DavidWenzler/reAM250/AMCF/Plugins/Resources/login_background.jpg

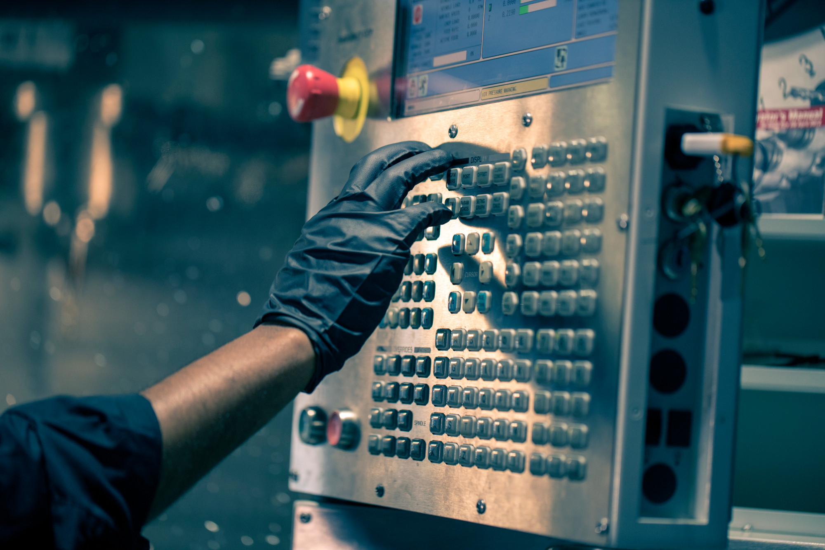
AMCF/Plugins/Resources/login_background.jpg
