DavidWenzler/reAM250/README.md

# reAM250
an open-source research platform for process monitoring and control in powder bed fusion of metals using a laser beam

View and download the CAD files here: [v1.1.0] (https://a360.co/3FBa549).
