DavidWenzler/reAM250/docs/reAm250_IO_overview_de_v1_0_0.pdf

Modul | Klemme | Bez. | Adresse | Funktion | Modul | Klemme | Bez. | Adresse | Funktion | Modul | Klemme | Bez. | Adresse | Funktion
11 | TC1+ | Temperatur 1 | 11 | DI 1 | Z-Achse Endlage (-) unten | 11 | DO 1 | Türzuhaltung Entriegeln
12 | TC1- | " | 21 | DI 2 | Z-Achse Endlage (+) oben | 21 | DO 2 | Ampel ROT
21 | TC2+ | Temperatur 2 | 12 | DI 3 | Beschichter Endlage (-) | 12 | DO 3 | Ampel GELB
22 | TC2- | " | 22 | DI 4 | Beschichter Endlage (+) | 22 | DO 4 | Ampel GRÜN
13 | TC3+ | Temperatur 3 | 13 | DI 5 | Beschichter Ref. (Home) | 13 | DO 5 | Siganl an SP-ICE3 (nicht verwendet)
14 | TC3- | " | 23 | DI 6 | Beschichter Ref. (max.) | 23 | DO 6 | O2 -Messbereich
23 | TC4+ | Temperatur 4 | 14 | +24V DC | | 14 | GND
24 | TC4- | " | 24 | +24V DC | | 24 | GND
15 | TC5+ | Temperatur 5 | 15 | +24V DC | | 15 | GND
16 | TC5- | " | 25 | +24V DC | | 25 | GND
25 | TC6+ | Temperatur 6 | 16 | +24V DC | | 16 | GND
26 | TC6- | " | 26 | +24V DC | | 26 | GND
11 | AO1 I+ | | 11 | DI 1 | Meldung Ventil Schutzgas Kammer AUF | 11 | DO 1 | Ventil Schutzgas Kammer
12 | AO1 U+ | Umwälzpumpe Gasführung SOLL 0-100% (0-10V) | 21 | DI 2 | Meldung Ventil Schutzgas Kammer ZU | 21 | DO 2 | Ventil Schutzgas Wärmetauscher
13 | AO1 I-/U- | " | 12 | DI 3 | Meldung Ventil Schutzgas Wärmetauscher AUF | 12 | DO 3 | Ventil Schutzgas Hauptventil
21 | AO2 I+ | Analogausgang 2 (0(4)-20mA) | 22 | DI 4 | Meldung Ventil Schutzgas Wärmetauscher ZU | 22 | DO 4 | Ventil Vakuum Kammer
22 | AO2 U+ | Analogausgang 2 (0-10V) | 13 | DI 5 | Reserve | 13 | DO 5 | Ventil Vakuumk Z-Achse
23 | AO2 I-/U- | " | 23 | DI 6 | " | 23 | DO 6 | Reserve Gasführung Ventil 6
14 | AO3 I+ | | 14 | +24V DC | | 14 | GND
15 | AO3 U+ | | 24 | +24V DC | | 24 | GND
16 | AO3 I-/U- | | 15 | +24V DC | | 15 | GND
24 | AO4 I+ | | 25 | +24V DC | | 25 | GND
25 | AO4 U+ | | 16 | +24V DC | | 16 | GND
26 | AO4 I-/U- | | 26 | +24V DC | | 26 | GND
11 | AO1 I+ | Analogausgang 1 (0(4)-20mA) | 11 | DI 1 | Signal von SP-ICE3 (nicht verwendet) | 11 | DO 1 | Reserve Gasführung Ventil 7
12 | AO1 U+ | Analogausgang 1 (0-10V) | 21 | DI 2 | Umwälzpumpe Gasführung FU Betrieb | 21 | DO 2 | Reserve Gasführung Ventil 8
13 | AO1 I-/U- | " | 12 | DI 3 | Umwälzpumpe Gasführung FU Fehler | 12 | DO 3 | Reserve Gasführung Ventil 9
21 | AO2 I+ | Analogausgang 2 (0(4)-20mA) | 22 | DI 4 | Vakuumpumpe Betrieb | 22 | DO 4 | Reserve Gasführung Ventil 10
22 | AO2 U+ | Analogausgang 1 (0-10V) | 13 | DI 5 | Vakuumpumpe Störung | 13 | DO 5 | Reserve Gasführung Ventil 11
23 | AO2 I-/U- | " | 23 | DI 6 | Bauplattformheizung Störung | 23 | DO 6 | Reserve Gasführung Ventil 12
14 | AO3 I+ | | 14 | +24V DC | | 14 | GND
15 | AO3 U+ | | 24 | +24V DC | | 24 | GND
16 | AO3 I-/U- | | 15 | +24V DC | | 15 | GND
24 | AO4 I+ | | 25 | +24V DC | | 25 | GND
25 | AO4 U+ | | 16 | +24V DC | | 16 | GND
26 | AO4 I-/U- | | 26 | +24V DC | | 26 | GND
11 | AI1 I+ | O² Messung Filter (4-20mA) | 11 | DI 1 | Vakuummessung Grenzwert | 11 | DO 1 | Reserve Gasführung Ventil 13
12 | AI1 U+ | | 21 | DI 2 | Vakuummessung Störung | 21 | DO 2 | Reserve Gasführung Ventil 14
13 | AI1 I-/U- | " | 12 | DI 3 | Fremdlüfter Umwelzpumpe Störung | 12 | DO 3 | Reserve Gasführung Ventil 15
21 | AI2 I+ | O² Messung Bauraum (4-20mA) | 22 | DI 4 | Reserve | 22 | DO 4 | Reserve Gasführung Ventil 16
22 | AI2 U+ | | 13 | DI 5 | " | 13 | DO 5 | Reserve Gasführung Ventil 17
23 | AI2 I-/U- | " | 23 | DI 6 | " | 23 | DO 6 | Reserve Gasführung Ventil 18
14 | AI3 I+ | Druck Druckluft (4-20mA) | 14 | +24V DC | | 14 | GND
15 | AI3 U+ | | 24 | +24V DC | | 24 | GND
16 | AI3 I-/U- | " | 15 | +24V DC | | 15 | GND
24 | AI4 I+ | Druck Schutzgas (4-20mA) | 25 | +24V DC | | 25 | GND
25 | AI4 U+ | | 16 | +24V DC | | 16 | GND
26 | AI4 I-/U- | " | 26 | +24V DC | | 26 | GND
11 | AI1 I+ | | 11 | DI 1 | Taster Tür Kammer Entriegeln | 11 | DO 1 | Umwälzpumpe Gasführung
12 | AI1 U+ | Vakuum Istwert 0-10V | 21 | DI 2 | Reserve | 21 | DO 2 | Vakuumpumpe
13 | AI1 I-/U- | " | 12 | DI 3 | " | 12 | DO 3 | Bauplattform Heizung
21 | AI2 I+ | | 22 | DI 4 | " | 22 | DO 4 | Laser Extern (nicht verwendet)
22 | AI2 U+ | Temperatur Bauplattform (Heizung) (0-200°C / 0 … 10V) | 13 | DI 5 | " | 13 | DO 5 | Laser System ON (nicht verwendet)
23 | AI2 I-/U- | " | 23 | DI 6 | " | 23 | DO 6 | Reserve
14 | AI3 I+ | | 14 | +24V DC | | 14 | GND
15 | AI3 U+ | | 24 | +24V DC | | 24 | GND
16 | AI3 I-/U- | | 15 | +24V DC | | 15 | GND
24 | AI4 I+ | | 25 | +24V DC | | 25 | GND
25 | AI4 U+ | | 16 | +24V DC | | 16 | GND
26 | AI4 I-/U- | | 26 | +24V DC | | 26 | GND
11 | Pulse 1 | | 11 | DI 1 | Meldung Vakuumventil Kammer AUF | 11 | DO 1 | Reserve
12 | SI 1 | Not-Halt Kanal 1 | 21 | DI 2 | Meldung Vakuumventil Kammer ZU | 21 | DO 2 | "
21 | Pulse 2 | | 12 | DI 3 | Meldung Vakuumventil Z-Achse AUF | 12 | DO 3 | "
22 | SI 2 | Not - Halt Kanal 2 | 22 | DI 4 | Meldung Vakuumventil Z-Achse ZU | 22 | DO 4 | "
13 | Pulse 3 | | 13 | DI 5 | Reserve | 13 | DO 5 | "
14 | SI 3 | Schutztüre Prozesskammer Kanal 1 | 23 | DI 6 | " | 23 | DO 6 | "
23 | Pulse 4 | | 14 | +24V DC | | 14 | GND
24 | SI 4 | Schutztüre Prozesskammer Kanal 2 | 24 | +24V DC | | 24 | GND
15 | SI 5 | Rückführung Not-Halt Schütze | 15 | +24V DC | | 15 | GND
25 | SI 6 | Rückführung Bedienerschutz Schütze | 25 | +24V DC | | 25 | GND
16 | SI 7 | Not-Halt von Laser Ch1 | 16 | +24V DC | | 16 | GND
26 | SI 8 | Not-Halt von Laser Ch2 | 26 | +24V DC | | 26 | GND
11 | SO 1 | Not-Halt Schütze | 11 | DI 1 | Reserve | 11 | DO 1 | Reserve
21 | SO 2 | Bedienerschutz Schütze | 21 | DI 2 | " | 21 | DO 2 | "
12 | SO 3 | Enable Achse 1&2 | 12 | DI 3 | " | 12 | DO 3 | "
22 | SO 4 | Enable Achse 3&4 | 22 | DI 4 | " | 22 | DO 4 | "
13 | SO 5 | Reserve | 13 | DI 5 | " | 13 | DO 5 | "
23 | SO 6 | Reserve | 23 | DI 6 | " | 23 | DO 6 | "
14 | GND | | 14 | +24V DC | | 14 | GND
24 | GND | | 24 | +24V DC | | 24 | GND
15 | GND | | 15 | +24V DC | | 15 | GND
25 | GND | | 25 | +24V DC | | 25 | GND
16 | GND | | 16 | +24V DC | | 16 | GND
26 | GND | | 26 | +24V DC | | 26 | GND
11 | Pulse 1 | | 11 | DI 1 | Reserve | 11 | DO 1 | Reserve
12 | SI 1 | Sauerstoffsensor Bauraum Alarm | 21 | DI 2 | " | 21 | DO 2 | "
21 | Pulse 2 | | 12 | DI 3 | " | 12 | DO 3 | "
22 | SI 2 | Taster Quittieren | 22 | DI 4 | " | 22 | DO 4 | "
13 | Pulse 3 | | 13 | DI 5 | " | 13 | DO 5 | "
14 | SI 3 | Schutztür Abdeckung Kanal 1 | 23 | DI 6 | " | 23 | DO 6 | "
23 | Pulse 4 | | 14 | +24V DC | | 14 | GND
24 | SI 4 | Schutztür Abdeckung Kanal 2 | 24 | +24V DC | | 24 | GND
15 | SI 5 | Not-Halt von Zelle Kanal 1 | 15 | +24V DC | | 15 | GND
25 | SI 6 | Not-Halt von Zelle Kanal 2 | 25 | +24V DC | | 25 | GND
16 | SI 7 | SIK von Zelle Kanal 1 | 16 | +24V DC | | 16 | GND
26 | SI 8 | SIK von Zelle Kanal 2 | 26 | +24V DC | | 26 | GND
11 | SO 1+ | Reserve

### 12 SO 1-

21 | SO 2+ | Reserve

### 22 SO 2-

13 | SO 3+ | Reserve

### 14 SO 3-

23 | SO 4+ | Reserve

### 24 SO 4-

15 | SO 5 | Reserve

### 16 GND

25 | SO 6 | Reserve

### 26 GND

11 | CA-01 | Encoder Spur A
12 | CB-01 | Encoder Spur B
13 | CR-01 | Encoder Richtung
14 | DI-01 | Reserve
15 | +24V | Reserve
16 | GND | Reserve
21 | n.c. | n.c.
22 | n.c. | n.c.
23 | n.c. | n.c.
24 | DI-02 | Reserve
25 | +5V | Encoder +5V Versorgung
26 | GND | Encoder GND Versorgung
- 112KF 11 | - 113KF 16 | - 114KF 24

X20AT6402 (6x Thermoelement) X20DI6371 (6x Digital IN)

X20DO6322 (6x Digital OUT)

- 112KF 12 | - 113KF 17 | - 114KF 25

X20AO4622 (4x Analog OUT)
X20DI6371 (6x Digital IN)

X20DO6322 (6x Digital OUT)

- 112KF 13 | - 113KF 18 | - 114KF 26

X20AO4622 (4x Analog OUT)
X20DI6371 (6x Digital IN)

X20DO6322 (6x Digital OUT)

- 112KF 14 | - 113KF 19 | - 114KF 27

X20AI4622 (4x Analog IN)
X20DI6371 (6x Digital IN)

X20DO6322 (6x Digital OUT)

- 112KF 15 | - 113KF 20 | - 114KF 28

X20AI4622 (4x Analog IN)
X20DI6371 (6x Digital IN)

X20DO6322 (6x Digital OUT)

- 115KF 51 | - 113KF 21 | - 114KF 29

X20SI8110 (8x Safety IN)

X20DI6371 (6x Digital IN)

X20DO6322 (6x Digital OUT)

- 115KF 52 | - 113KF 22 | - 114KF 30

X20SO6300 (6x Safety OUT)
X20DI6371 (6x Digital IN)

X20DO6322 (6x Digital OUT)

- 113KF 23 | - 114KF 31

X20SC0842 (8x Safety IN)
X20DI6371 (6x Digital IN)

X20DO6322 (6x Digital OUT)

- 115KF 53b (Kombimodul)

X20SC0842 (6x Safety OUT)

- 116KF 61

X20DC1976 (Encodermodul)

- 115KF 53a (Kombimodul)
