DavidWenzler/reAM250/docs/circuit_diagram_reAM250_de_v1_0_0.pdf

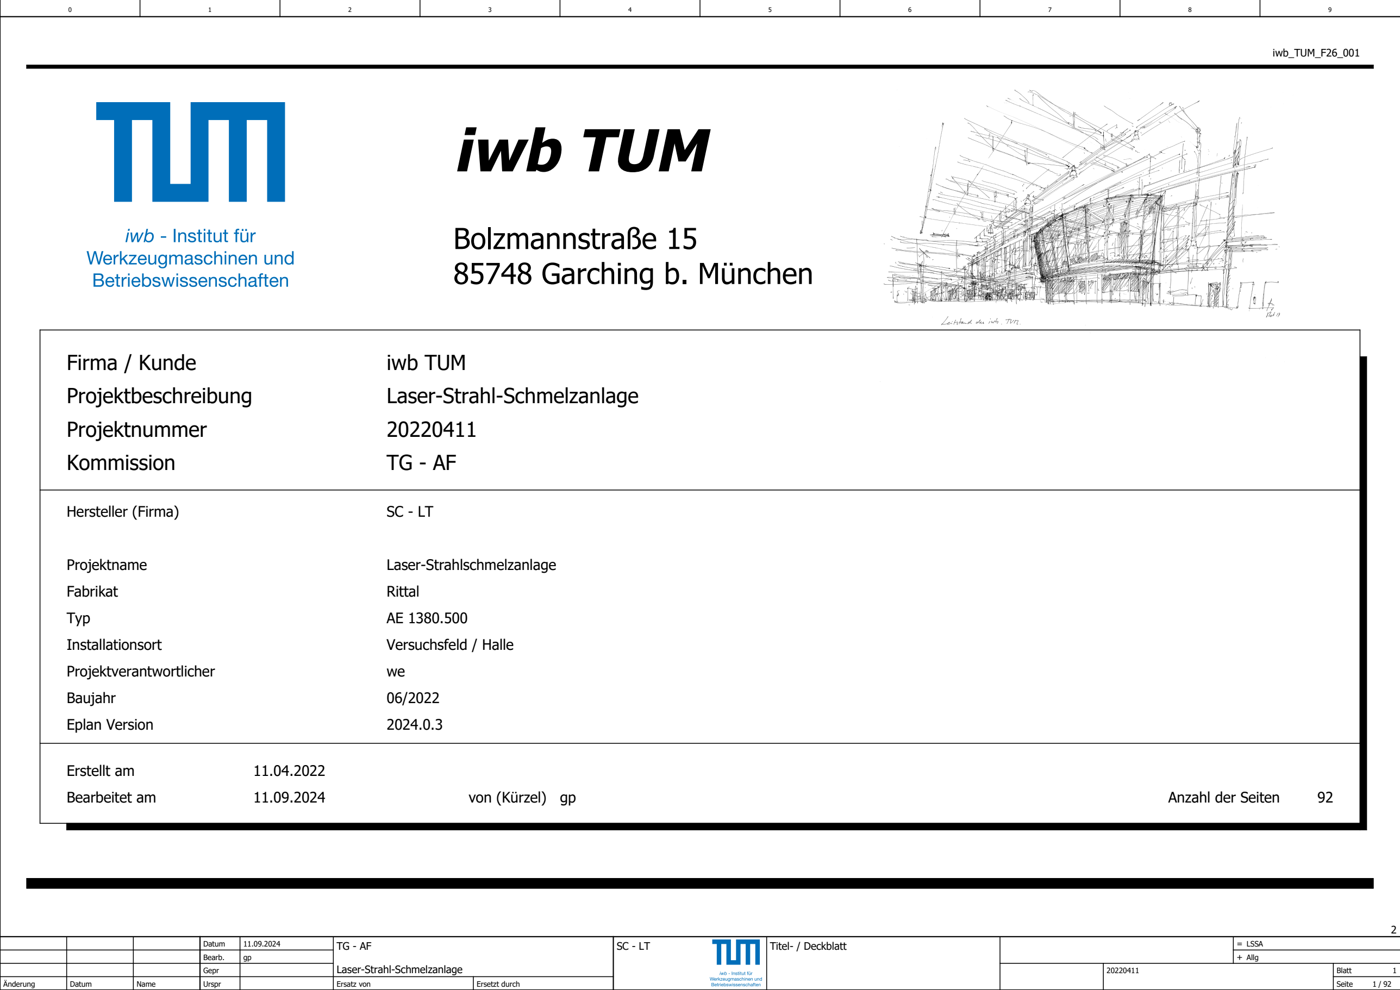
[picture p2: figure]
Blatt; Seite; Laser-Strahl-Schmelzanlage; Bearb.; Urspr; Datum; Ersetzt durch; LSSA; Allg; Titel- / Deckblatt; Änderung; Gepr; Ersatz von; Name; Anzahl der Seiten; Kommission; Bearbeitet am; Erstellt am; iwb TUM; Rittal; Projektnummer; Versuchsfeld / Halle; Fabrikat; iwb_TUM_F26_001; Baujahr; Eplan Version; Hersteller (Firma); Projektname; Laser-Strahlschmelzanlage; Projektverantwortlicher; Typ; Firma / Kunde; Installationsort; von (Kürzel); Bolzmannstraße 15 85748 Garching b. München

Projektbeschreibung | Laser-Strahl-Schmelzanlage

Allg

## Inhaltsverzeichnis : =LSSA+Allg/1 -=LSSA+ANL/301a

2.a

Seite | Seitenbeschreibung | Seitenzusatzfeld | Datum | Bearbeiter | X
=LSSA+Allg/1 | Titel- / Deckblatt | | 11.09.2024 | gp
=LSSA+Allg/2 | Inhaltsverzeichnis : =LSSA+Allg/1 - =LSSA+ANL/301a | | 11.09.2024 | gp
=LSSA+Allg/2.a | Inhaltsverzeichnis : =LSSA+ANL/302 - =LSSA+KL/5107.a | | 11.09.2024 | gp
=LSSA+Allg/2.b | Inhaltsverzeichnis : =LSSA+KL/5108 - =LSSA+STK/5500.e | | 11.09.2024 | gp
=LSSA+Allg/3 | Kennzeichnungsstruktur | | 11.04.2022 | gp
=LSSA+Allg/4 | Betriebsmittelkennzeichnung | | 11.04.2022 | gp
=LSSA+Allg/5 | Verdrahtungsfarben | | 11.04.2022 | gp
=LSSA+Allg/6 | Anlagenübersicht | | 11.04.2022 | gp
=LSSA+Allg/10 | Busübersicht | | 27.04.2022 | gp
=LSSA+Allg/15 | Kabelübersicht | | 11.04.2022 | gp
=LSSA+ST1/100 | Abschnitt Steuerschrank | | 14.04.2022 | gp
=LSSA+ST1/102 | Aufbau Steuerschrank Montageplatte | | 08.05.2023 | gp
=LSSA+ST1/103 | Aufbau Sammelkasten | | 05.06.2024 | gp
=LSSA+ST1/105 | Einspeisung | | 14.12.2023 | gp
=LSSA+ST1/106 | Servicesteckdose Beleuchtung | | 11.09.2024 | gp
=LSSA+ST1/107 | Netzteil 24VDC | | 15.05.2023 | gp
=LSSA+ST1/108 | Steuerspannung 24VDC | | 05.06.2024 | gp
=LSSA+ST1/110 | Steuerspannung 48V DC | | 13.12.2023 | gp
=LSSA+ST1/111 | PC / SPS Versorgung | | 25.09.2023 | gp
=LSSA+ST1/112 | SPS / IO Übersicht Bus-Controller / Analogbaugruppen | | 25.09.2023 | gp
=LSSA+ST1/113 | SPS / IO Übersicht Digitale Eingänge | | 25.09.2023 | gp
=LSSA+ST1/114 | SPS / IO Übersicht Digitale Ausgänge | | 25.09.2023 | gp
=LSSA+ST1/115 | SPS / IO Übersicht Safety Ein- und Ausgänge | | 25.09.2023 | gp
=LSSA+ST1/116 | SPS / IO Übersicht Encoder & Sondermodule | | 25.09.2023 | gp
=LSSA+ST1/119 | SPS / IO Modulversorgung | | 25.04.2023 | gp
=LSSA+ST1/120 | Safety Not-Halt Schütze Bedienerschutz Schütze | | 25.04.2023 | gp
=LSSA+ST1/131 | Not- Halt Taster Taster Quittieren | | 30.05.2023 | gp
=LSSA+ST1/132 | Schutztürschalter | | 05.06.2024 | gp
=LSSA+ST1/133 | Meldeleuchten | | 30.05.2023 | gp
=LSSA+ST1/134 | Not-Halt Option von Extern z.B. Laserzelle | | 05.06.2024 | gp
=LSSA+ANL/300 | Abschnitt Antriebs- und Leistungskomponenten | | 02.05.2022 | gp
=LSSA+ANL/301 | Z - Achse | | 04.10.2023 | gp
=LSSA+ANL/301a | Glasmaßstab Z - Achse | | 11.09.2024 | gp

## Spalte X: eine automatisch erzeugte Seite wurde manuell nachbearbeitet

# Inhaltsverzeichnis

F06_001

Allg

## Inhaltsverzeichnis : =LSSA+ANL/302 -=LSSA+KL/5107.a

2.b

2.a

Seite | Seitenbeschreibung | Seitenzusatzfeld | Datum | Bearbeiter | X
=LSSA+ANL/302 | Achse Pulverzuführung | | 30.05.2023 | gp
=LSSA+ANL/303 | Achse Beschichter | | 04.10.2023 | gp
=LSSA+ANL/304 | Beschichter Förderband | | 05.04.2023 | gp
=LSSA+ANL/310 | Umwälzpumpe Gasführung | | 15.12.2023 | gp
=LSSA+ANL/311 | Vakuumpumpe | | 03.06.2024 | gp
=LSSA+ANL/315 | Bauplattform Heizung | | 05.06.2024 | gp
=LSSA+SENS/400 | Abschnitt Sensoren | | 02.05.2022 | gp
=LSSA+SENS/401 | End- & Referenzschalter Achsen | | 27.04.2023 | gp
=LSSA+SENS/402 | Digitale Sensoren Rückmeldungen Ventile | | 05.06.2024 | gp
=LSSA+SENS/403 | Digitale Sensoren Rückmeldungen Ventile | | 05.06.2024 | gp
=LSSA+SENS/410 | Analoge Sensoren Temperaturmessung Typ J Elemente | | 11.09.2024 | gp
=LSSA+SENS/411 | Analoge Sensoren Temperaturmessung PT100 | | 05.06.2024 | gp
=LSSA+SENS/415 | Analoge Sensoren Sauerstoffmessung | | 11.09.2024 | gp
=LSSA+SENS/420 | Analoge Sensoren Druckmessung | | 19.09.2023 | gp
=LSSA+SENS/425 | Analoge Sensoren Vakuum | | 11.05.2023 | gp
=LSSA+AKT/500 | Abschnitt Aktoren | | 02.05.2022 | gp
=LSSA+AKT/501 | Gasführung Ventile 1-6 | | 05.06.2024 | gp
=LSSA+AKT/502 | Gasführung Ventile 7-12 | | 27.04.2023 | gp
=LSSA+AKT/503 | Gasführung Ventile 13-18 | | 27.04.2023 | gp
=LSSA+LAS/600 | Abschnitt Laser | | 02.05.2022 | gp
=LSSA+LAS/601 | Laser | | 01.08.2024 | gp
=LSSA+LAS/602 | Raylase SP-ICE 3 | | 05.06.2024 | gp
=LSSA+LAS/603 | Datenaustausch Raylase SP-ICE 3 / nLight Laser Adapter | | 05.06.2024 | gp
=LSSA+KL/5100 | Klemmenplan +ST1-XD0 | | 11.09.2024 | gp
=LSSA+KL/5101 | Klemmenplan +ST1-XD1 | | 11.09.2024 | gp
=LSSA+KL/5102 | Klemmenplan +ST1-XD01 | | 11.09.2024 | gp
=LSSA+KL/5103 | Klemmenplan +ST1-XD6 | | 11.09.2024 | gp
=LSSA+KL/5103.a | Klemmenplan +ST1-XD6 | | 11.09.2024 | gp
=LSSA+KL/5104 | Klemmenplan +ST1-XD10 | | 11.09.2024 | gp
=LSSA+KL/5105 | Klemmenplan +ST1-XD11 | | 11.09.2024 | gp
=LSSA+KL/5106 | Klemmenplan +ST1-XD12 | | 11.09.2024 | gp
=LSSA+KL/5107 | Klemmenplan +ST1-XD20 | | 11.09.2024 | gp
=LSSA+KL/5107.a | Klemmenplan +ST1-XD20 | | 11.09.2024 | gp

## Spalte X: eine automatisch erzeugte Seite wurde manuell nachbearbeitet

# Inhaltsverzeichnis

F06_001

2.a

Allg

## Inhaltsverzeichnis : =LSSA+KL/5108 -=LSSA+STK/5500.e

2.b

Seite | Seitenbeschreibung | Seitenzusatzfeld | Datum | Bearbeiter | X
=LSSA+KL/5108 | Klemmenplan +ST1-XD30 | | 11.09.2024 | gp
=LSSA+KL/5109 | Klemmenplan +ST1-XDM24 | | 11.09.2024 | gp
=LSSA+KL/5110 | Klemmenplan +ST1-XDM48 | | 11.09.2024 | gp
=LSSA+KL/5111 | Klemmenplan +ST1-XDN | | 11.09.2024 | gp
=LSSA+KL/5112 | Klemmenplan +ST1-XDP24 | | 11.09.2024 | gp
=LSSA+KL/5113 | Klemmenplan +ST1-XDP48 | | 11.09.2024 | gp
=LSSA+KL/5114 | Klemmenplan +ST1-XPE | | 11.09.2024 | gp
=LSSA+KL/5115 | Klemmenplan +ST1-107XTR24 | | 11.09.2024 | gp
=LSSA+KL/5116 | Klemmenplan +ST1-110XTR48 | | 11.09.2024 | gp
=LSSA+KL/5117 | Klemmenplan +ST2-XD10.1 | | 11.09.2024 | gp
=LSSA+KL/5117.a | Klemmenplan +ST2-XD10.1 | | 11.09.2024 | gp
=LSSA+KL/5118 | Klemmenplan +ST2-XD11.1 | | 11.09.2024 | gp
=LSSA+KL/5119 | Klemmenplan +ST2-XD12.1 | | 11.09.2024 | gp
=LSSA+KL/5119.a | Klemmenplan +ST2-XD12.1 | | 11.09.2024 | gp
=LSSA+STK/5400 | Artikelstückliste : BuR.80SD100XD.C044-01 - BuR.X20AO4622 | | 11.09.2024 | gp
=LSSA+STK/5400.a | Artikelstückliste : BuR.X20BM11 - BuR.X20TB52 | | 11.09.2024 | gp
=LSSA+STK/5400.b | Artikelstückliste : BuR.X20SC0842 - WAGO.2002-1201 | | 11.09.2024 | gp
=LSSA+STK/5400.c | Artikelstückliste : WAGO.2002-1207 - WAGO.2006-1681 | | 11.09.2024 | gp
=LSSA+STK/5400.d | Artikelstückliste : WAGO.2006-1692 - WAGO.2002-3292 | | 11.09.2024 | gp
=LSSA+STK/5400.e | Artikelstückliste : WAGO.249-117 - | | 11.09.2024 | gp
=LSSA+STK/5500 | Artikelsummenstückliste : BuR.80SD100XD.C044-01 - ETN.M22-PV/K01 | | 11.09.2024 | gp
=LSSA+STK/5500.a | Artikelsummenstückliste : ETN.M22-K01 - BuR.X20SO6300 | | 11.09.2024 | gp
=LSSA+STK/5500.b | Artikelsummenstückliste : BuR.X20BM36 - ETN.216374 | | 11.09.2024 | gp
=LSSA+STK/5500.c | Artikelsummenstückliste : ETN.M22-K10 - WAGO.2004-1201 | | 11.09.2024 | gp
=LSSA+STK/5500.d | Artikelsummenstückliste : WAGO.2002-1404 - K+C Glasmaßstab Typ-S5 | | 11.09.2024 | gp
=LSSA+STK/5500.e | Artikelsummenstückliste : BAL.BES01H6 - WAGO.2002-407 | | 11.09.2024 | gp

## Spalte X: eine automatisch erzeugte Seite wurde manuell nachbearbeitet

# Inhaltsverzeichnis

F06_001

2.b

Allg

## Kennzeichnungsstruktur

11.04.2022 | SC - LT

# Projekt

# = Anlage

# + Ort

# Laserzelle 2

# = Zelle2

# + Allg

+ ST1

# Allgemeine Dokumentation (Inhalt, ... )

# Steuerschrank 1

Steuerschrank 3 ...

Roboter 1 | Roboter 2

# Laser 1

+ ST3

+ ROB1 | + ROB2
+ LAS1 | + LAS2
+ SWS1 | Schweißstromquelle 1 | + DVS1 | Drahtvorschub 1
+ ABS1 | Absaugung 1
+ KL | Klemmenpläne
+ KAB | Kabelübersichten
+ ... | ...

# Beispiel:

+ Ort ...

= ...

# - BMK

- ... | - 100FN1

# (Seite & BMK)

+ STK | Stücklisten
+ SPS | I/O Übersichten

## Seite 1-99

## Seite 100-199

## Seite 200-299

## Seite 400 - 499

## Seite 800-899

## Seite 900-999

## Seite 5100-5199

## Seite 5200-5299

## Seite 5300-5399

## Seite 5400-5499

## Seite 5500-xxxx

## Seite 500 - 599

## Seite 600 - 699

# + ST2 Steuerschrank 2 in Zelle

## Seite 300-399

## Seite 1000-xxxx

//

// | Laser 2

# + SCA1 Scanner 1 // + SCA2 Scanner 2

## // Seite 700-799

// + KHL1 | Kuehler 1
+ ... | ...
+ CSJ1 | CrossJet 1 | // + VENT1 Ventile tech. Gase ...

# Kennzeichnung nach EN 81346

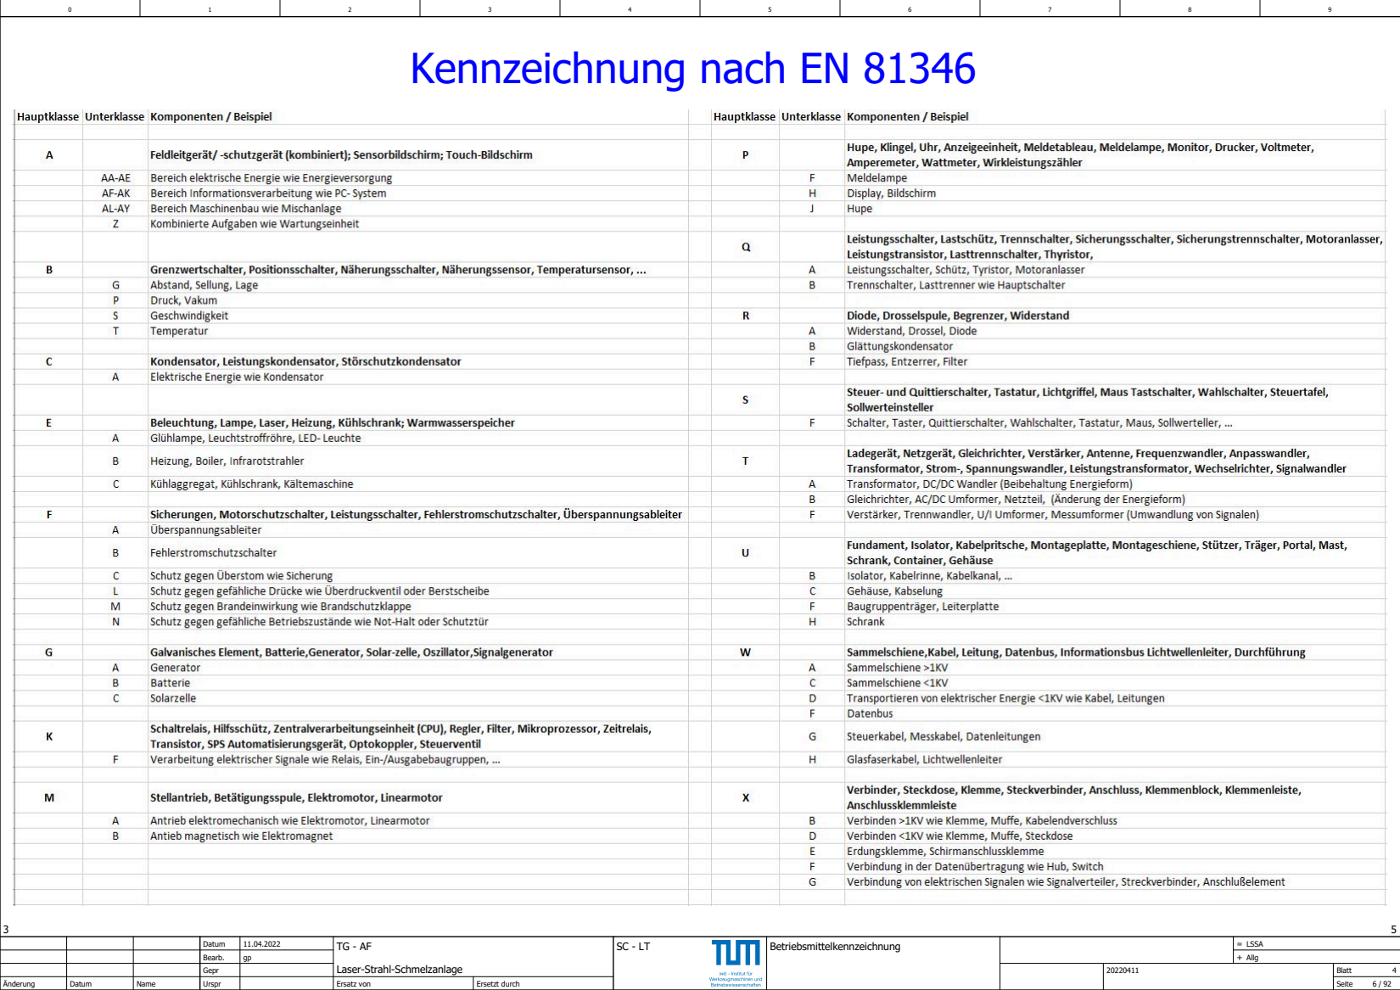
[picture p3: page 6]

Allg

## Betriebsmittelkennzeichnung

11.04.2022 | SC - LT

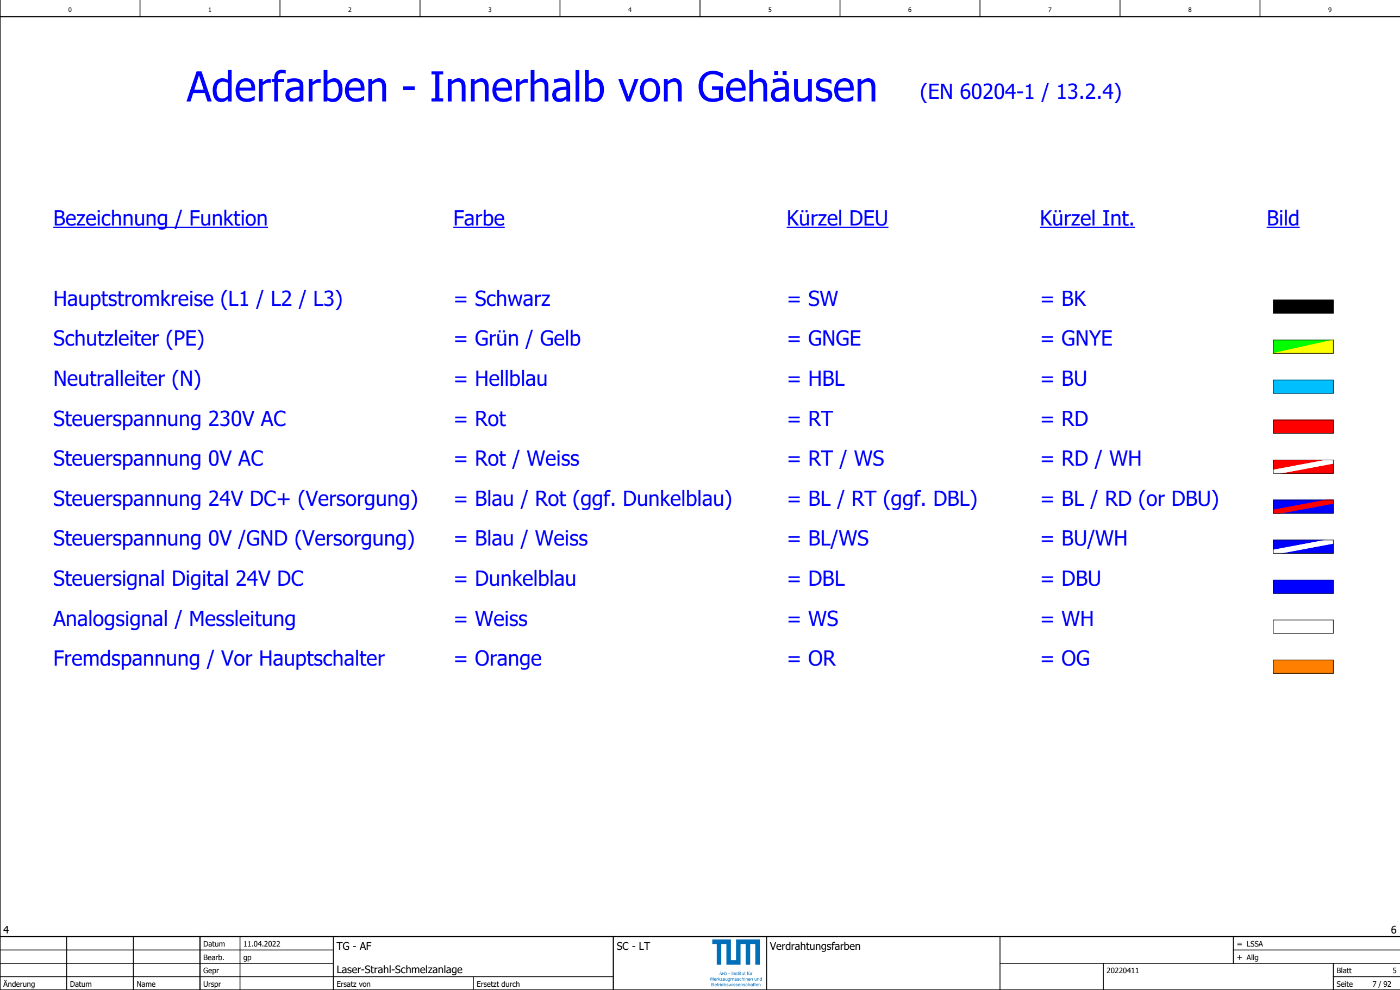
[picture p4: figure]
Allg; Verdrahtungsfarben; Hauptstromkreise (L1 / L2 / L3); Schutzleiter (PE); Neutralleiter (N); Steuerspannung 230V AC; Steuerspannung 0V AC; Steuerspannung 24V DC+ (Versorgung); Steuerspannung 0V /GND (Versorgung); Steuersignal Digital 24V DC; Analogsignal / Messleitung; Fremdspannung / Vor Hauptschalter; = Schwarz; = Grün / Gelb; = Hellblau; = Rot; = Rot / Weiss; = Blau / Rot (ggf. Dunkelblau); = Blau / Weiss; = Dunkelblau; = Weiss; = Orange; = GNGE; = HBL; = BL / RT (ggf. DBL); = DBL; = GNYE; = BL / RD (or DBU); = DBU; Bild

# Aderfarben - Innerhalb von Gehäusen (EN 60204-1 / 13.2.4)

Bezeichnung / Funktion | Farbe | Kürzel DEU | Kürzel Int.

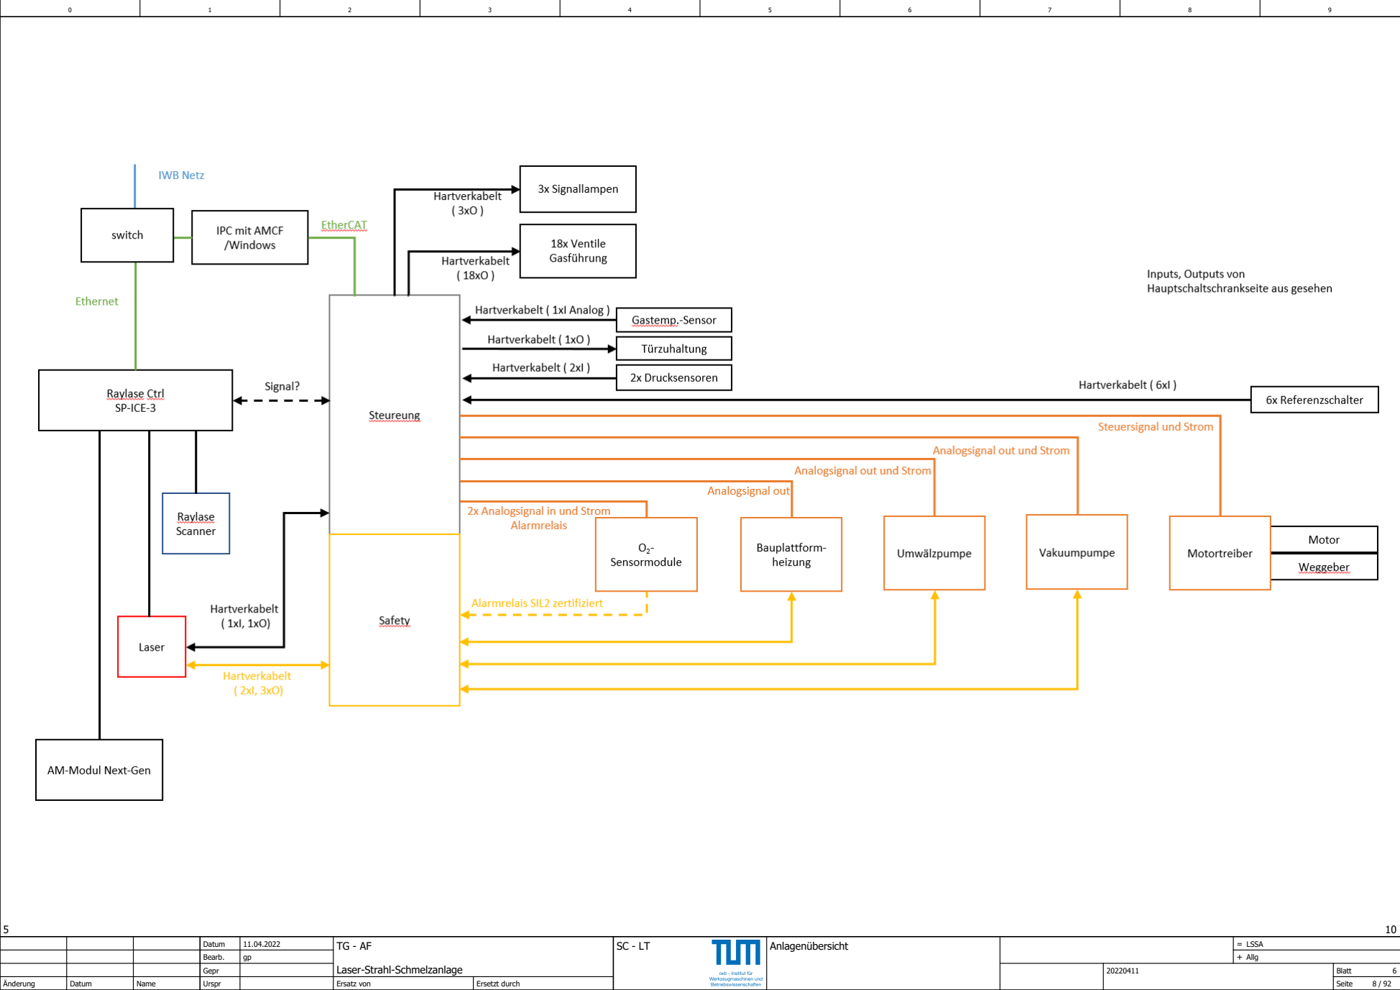
[picture p5: page 8]

Allg

## Anlagenübersicht

11.04.2022 | SC - LT

Allg

## Busübersicht

27.04.2022 | SC - LT

Allg

## Kabelübersicht

+ST1/100

11.04.2022 | SC - LT

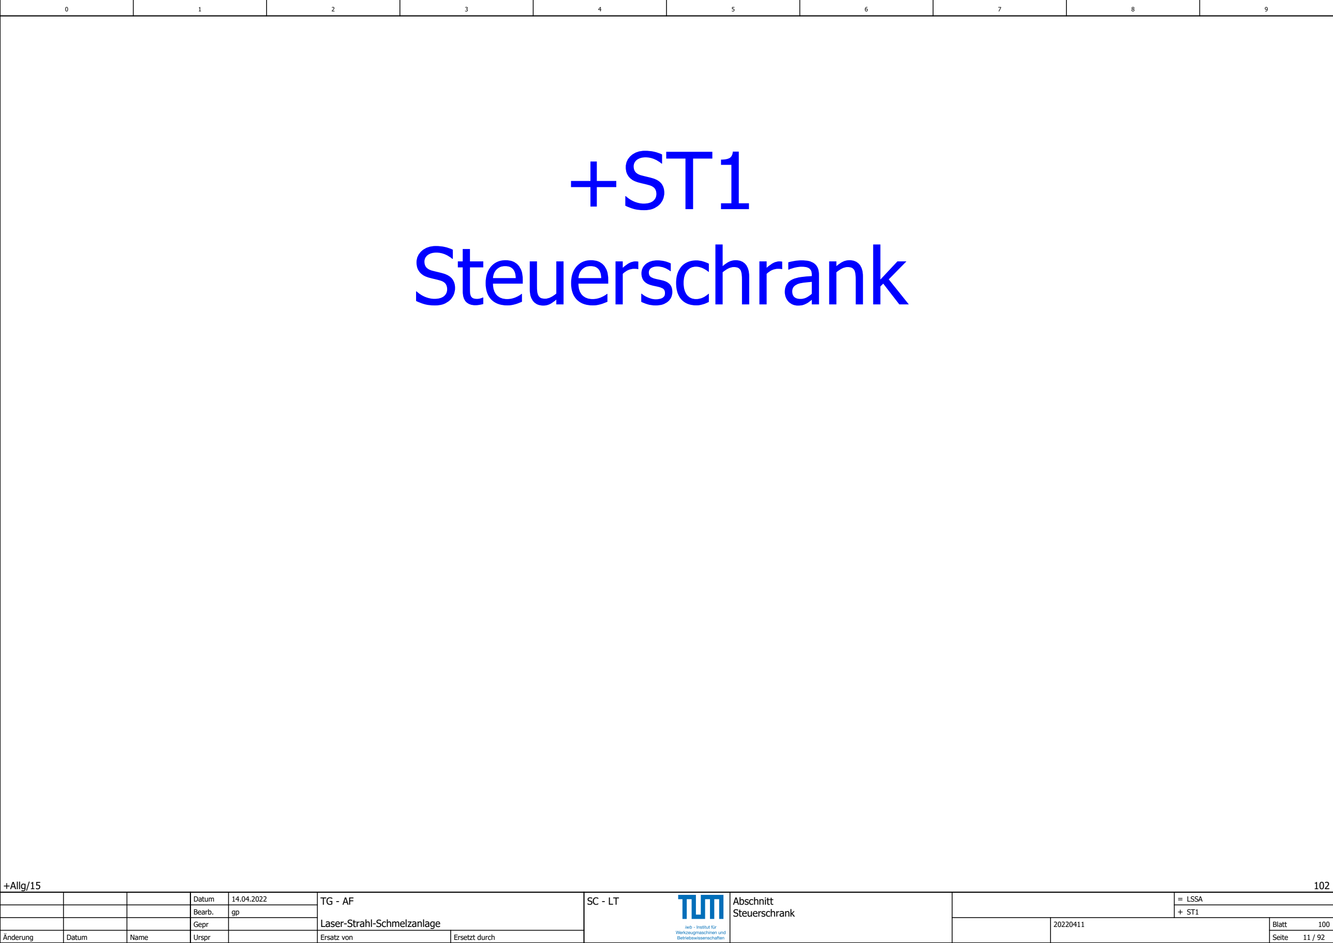
[picture p6: figure]
+Allg/15; Abschnitt Steuerschrank; +ST1 Steuerschrank

500 mm

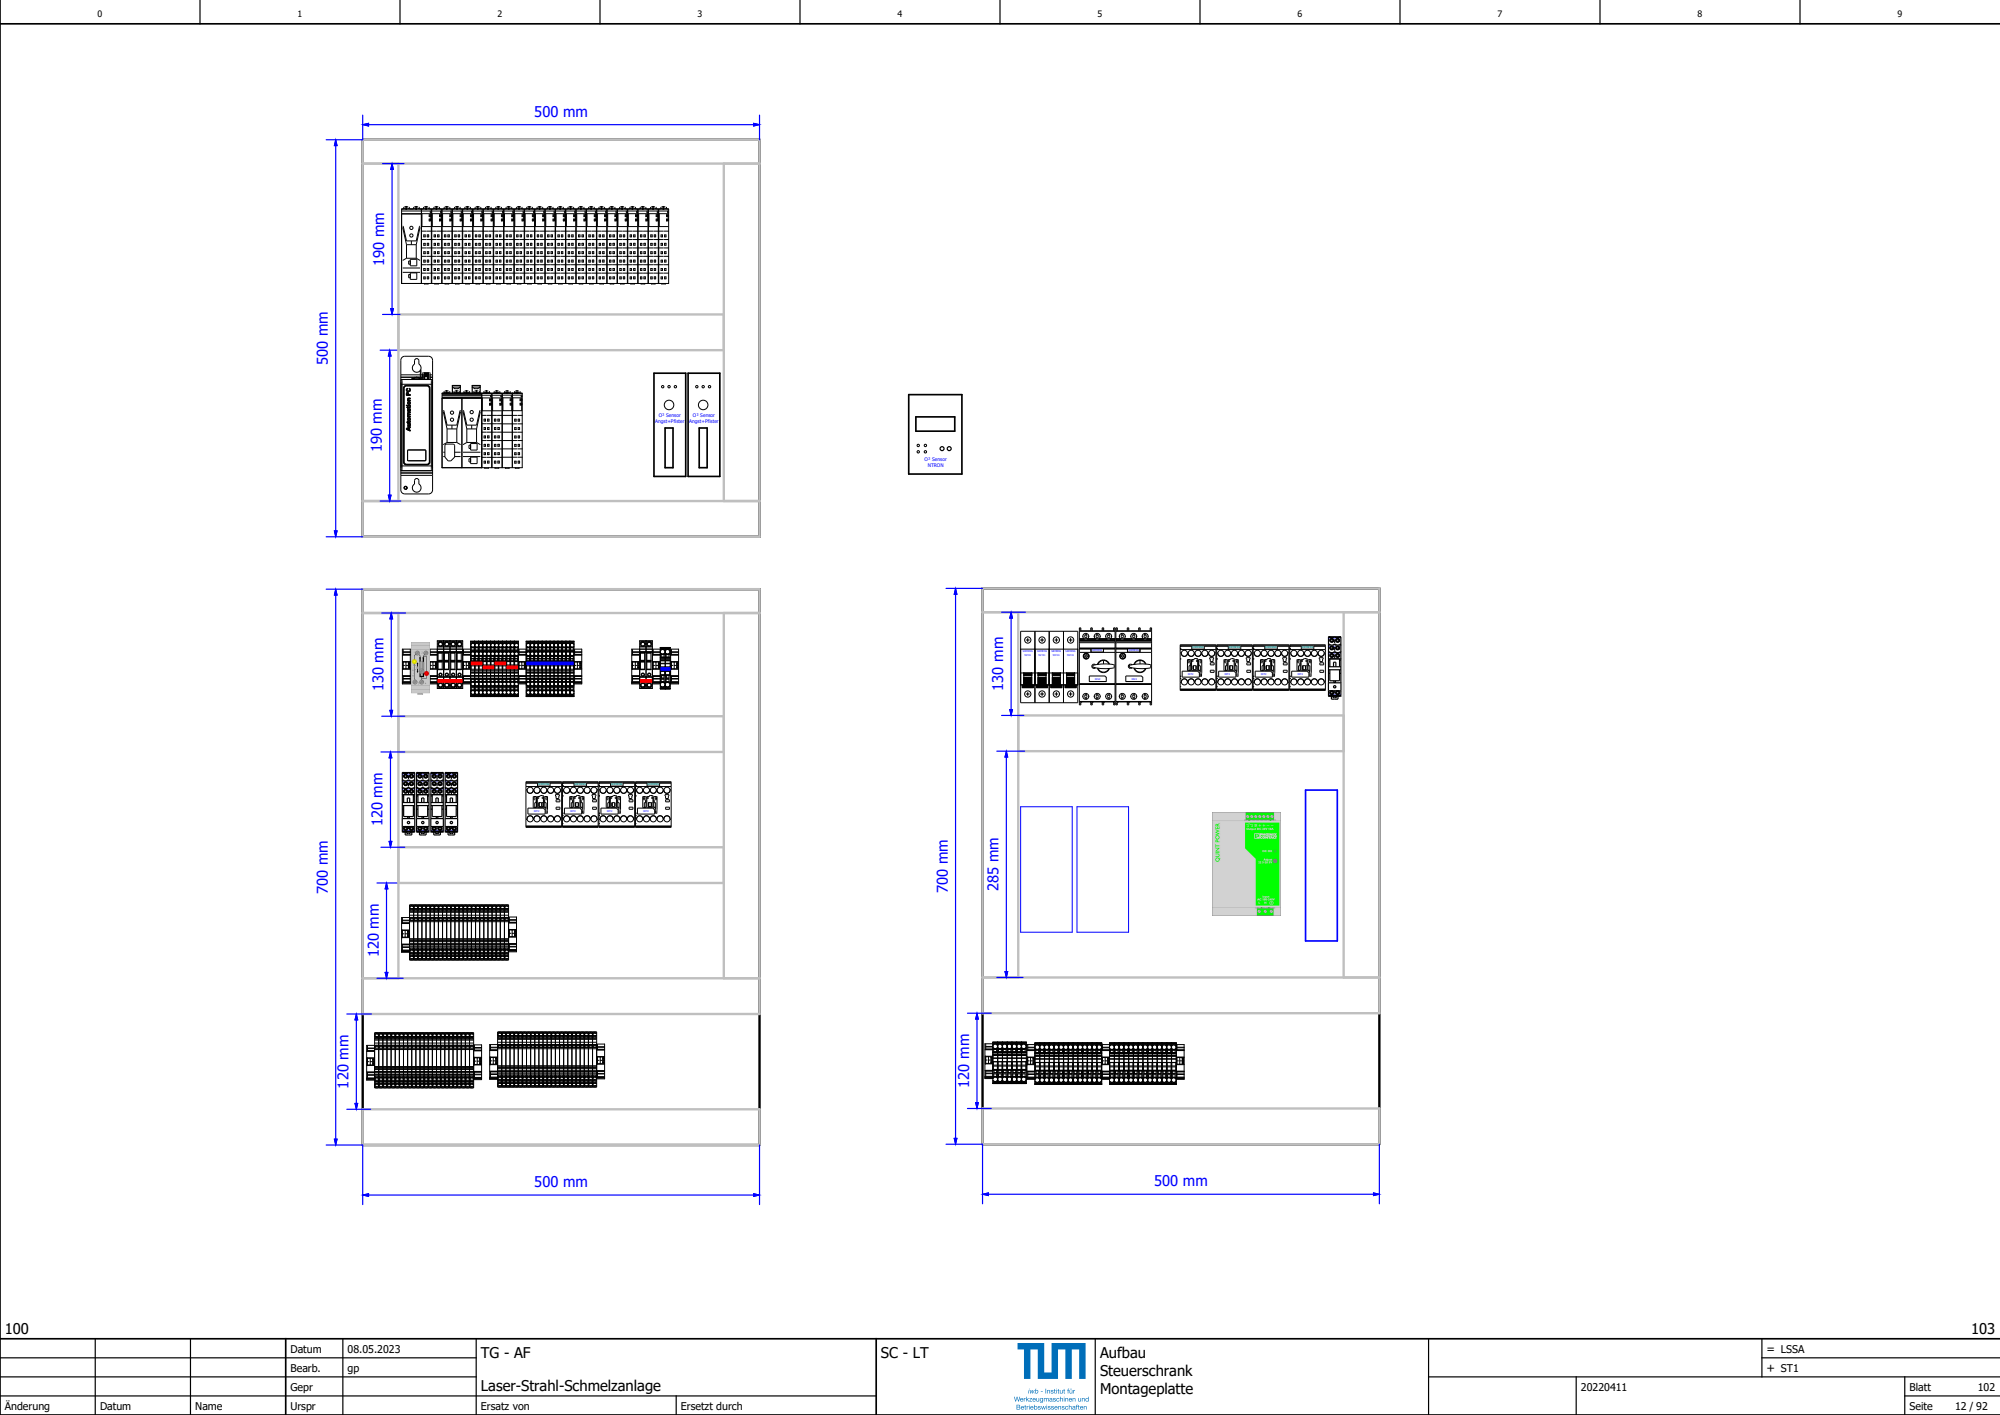
[picture p7: page 12]
Aufbau Steuerschrank Montageplatte; SIEMENS; COIL; COM; O² Sensor NTRON; O² Sensor Angst+Pfister

500 mm

120 mm

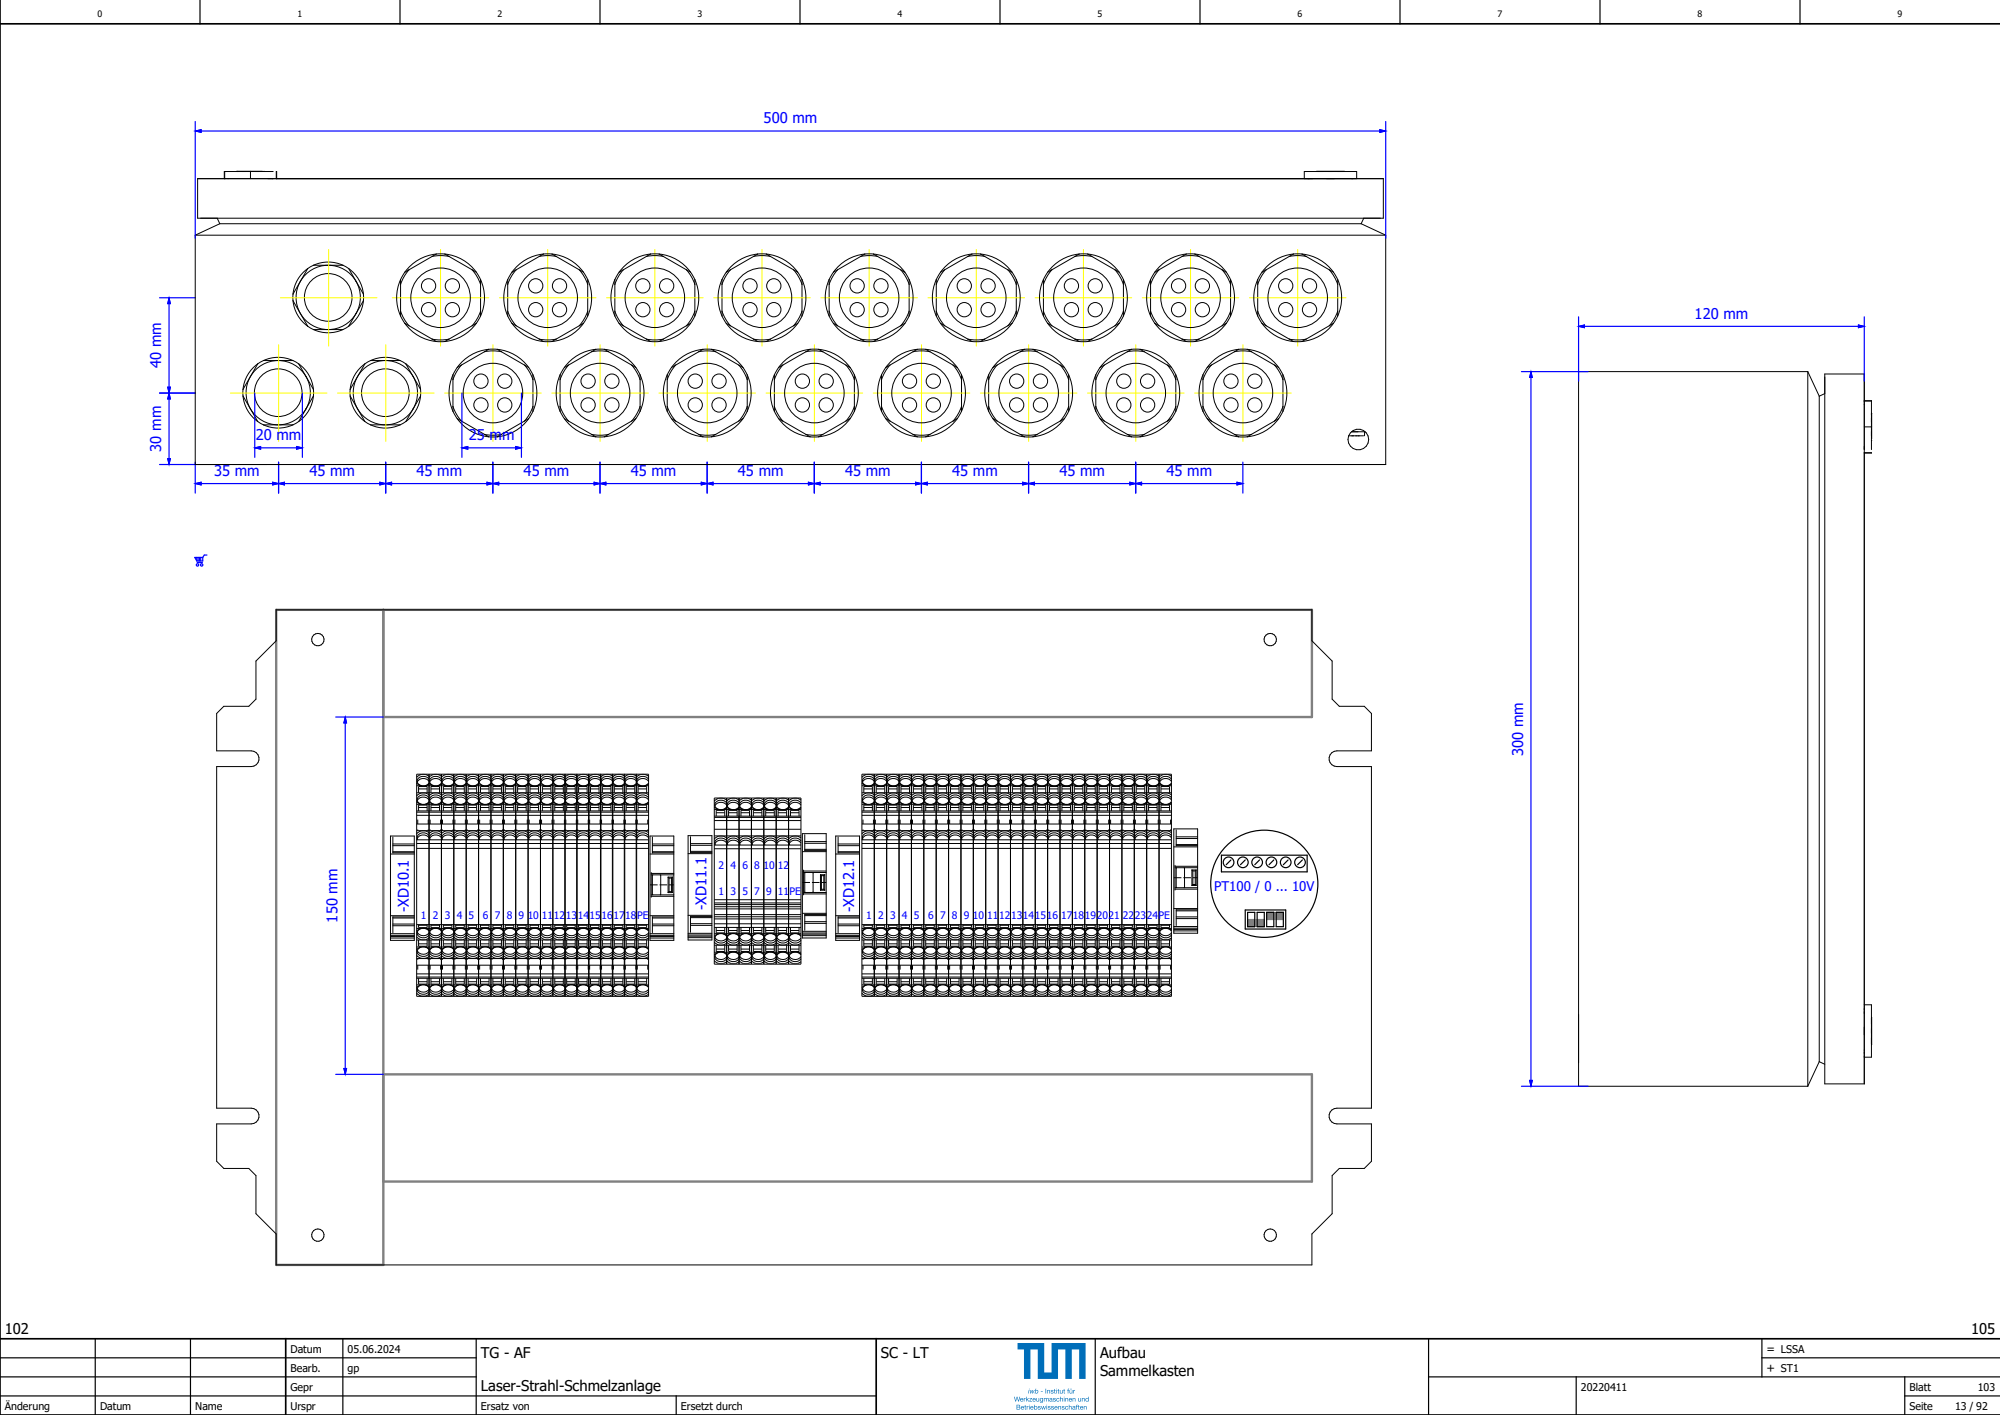
[picture p8: page 13]
Aufbau Sammelkasten

## 0L3 = Orange, vor Hauptschalter!

0L3 /

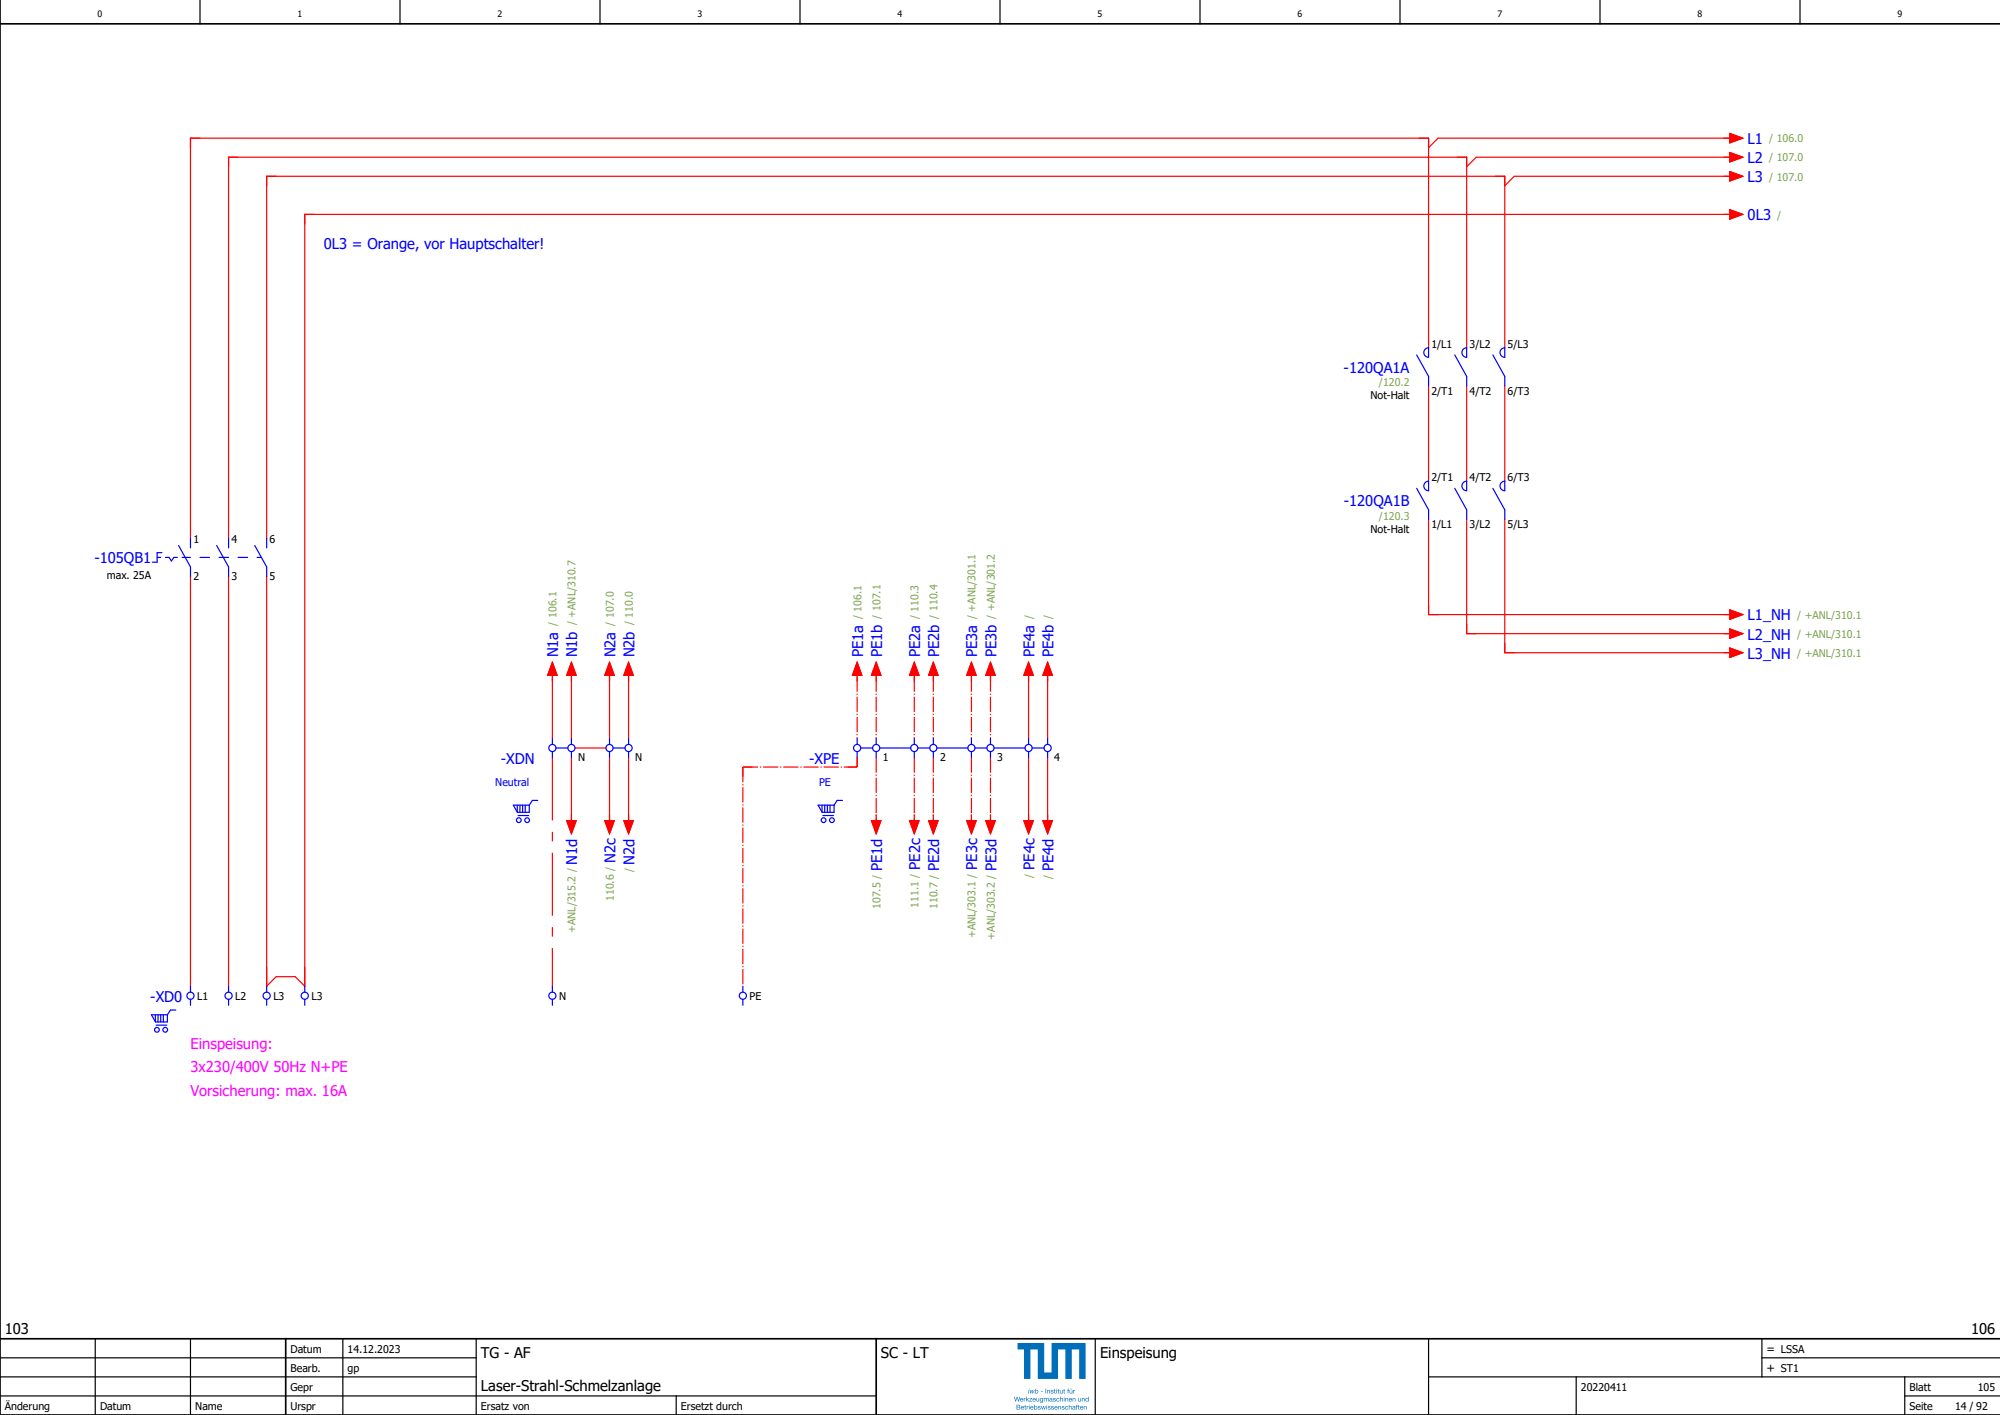
[picture p9: page 14]
Einspeisung; Neutral; Einspeisung:; Vorsicherung: max. 16A; max. 25A; -XDN; -XPE; /120.2 Not-Halt; /120.3 Not-Halt; N1b / +ANL/310.7; N1d / +ANL/315.2; PE3a / +ANL/301.1; PE3b / +ANL/301.2; PE3c / +ANL/303.1; PE3d / +ANL/303.2; L1_NH / +ANL/310.1; L2_NH / +ANL/310.1; L3_NH / +ANL/310.1

-106FC1

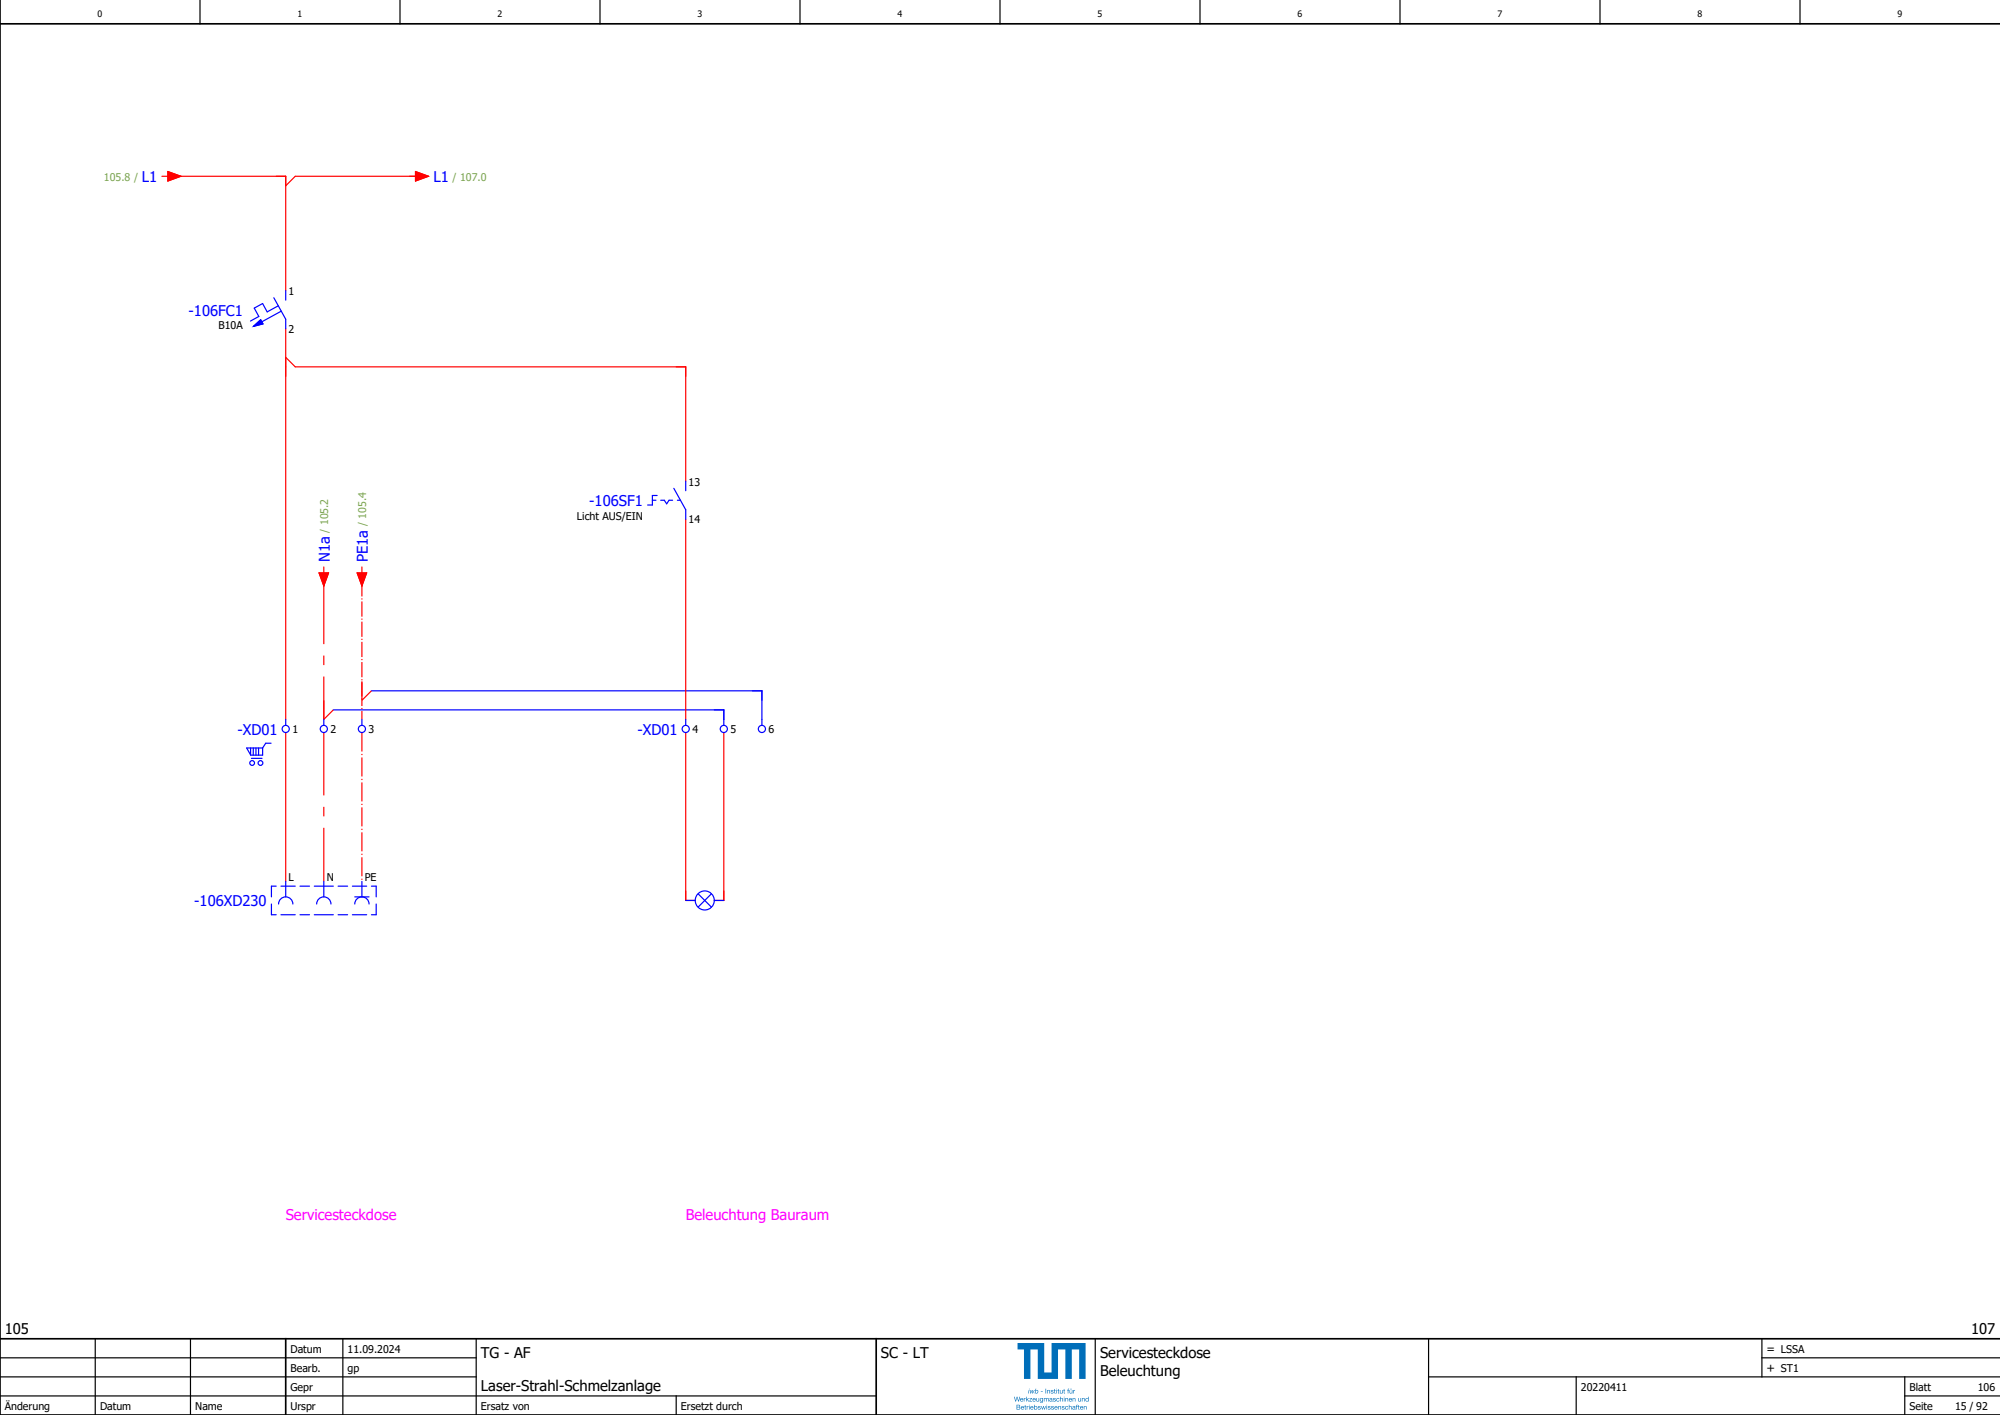
[picture p10: page 15]
Servicesteckdose Beleuchtung; Servicesteckdose; Beleuchtung Bauraum

Licht AUS/EIN

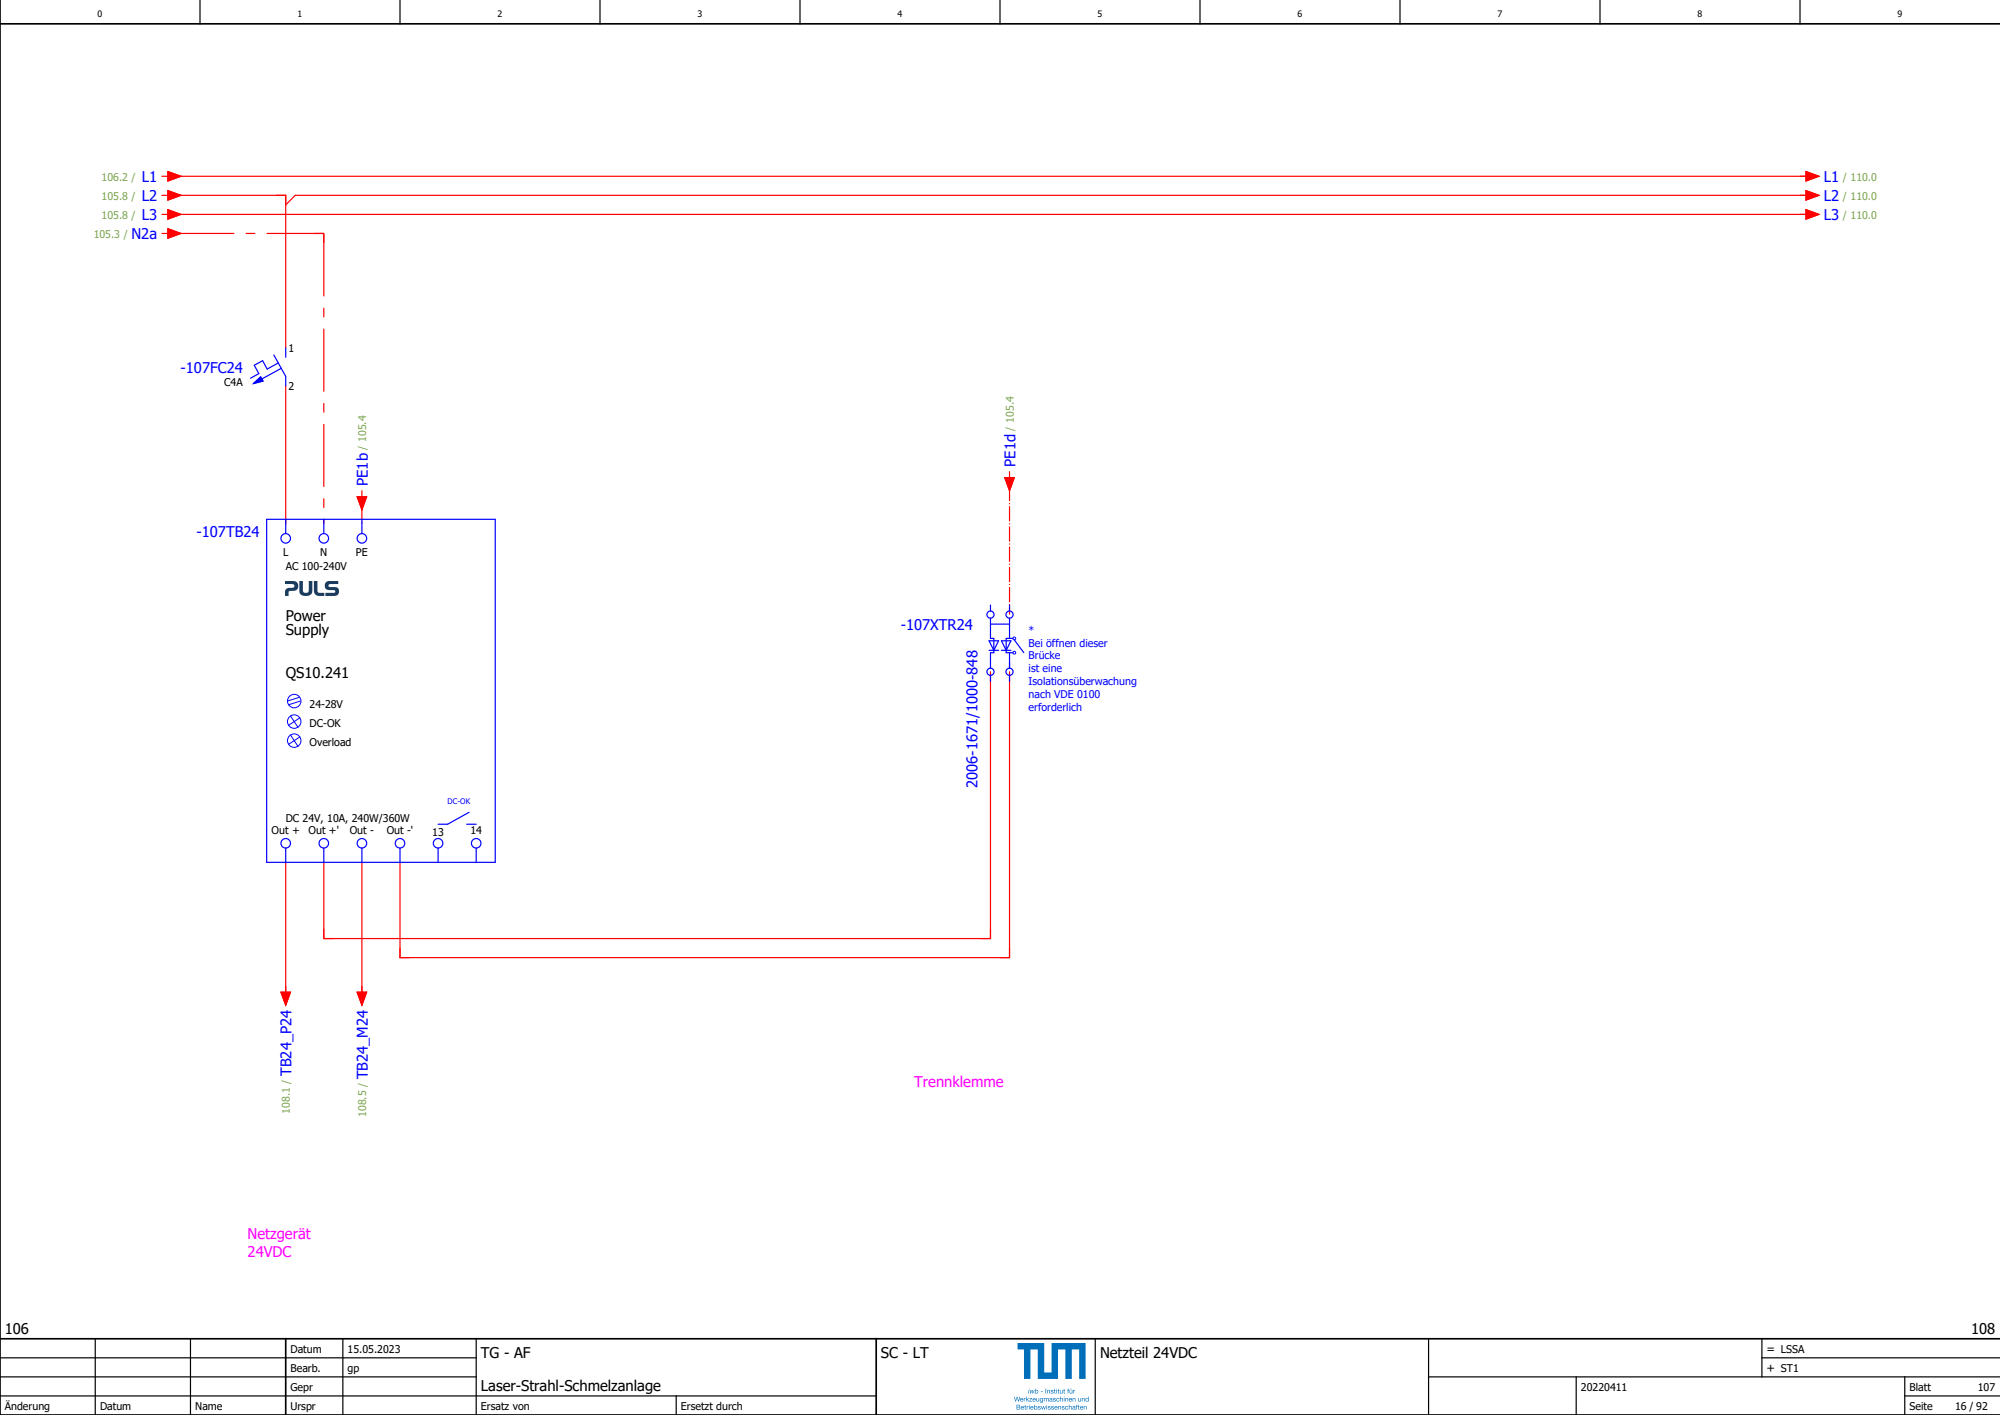
[picture p11: page 16]
Netzteil 24VDC; Netzgerät 24VDC; Trennklemme; * Bei öffnen dieser Brücke ist eine Isolationsüberwachung nach VDE 0100 erforderlich; -107XTR24 2006⁻1671/1000⁻848; Power Supply; Overload; Out + Out +' Out -; Out -'

## 107.1 / TB24_P24

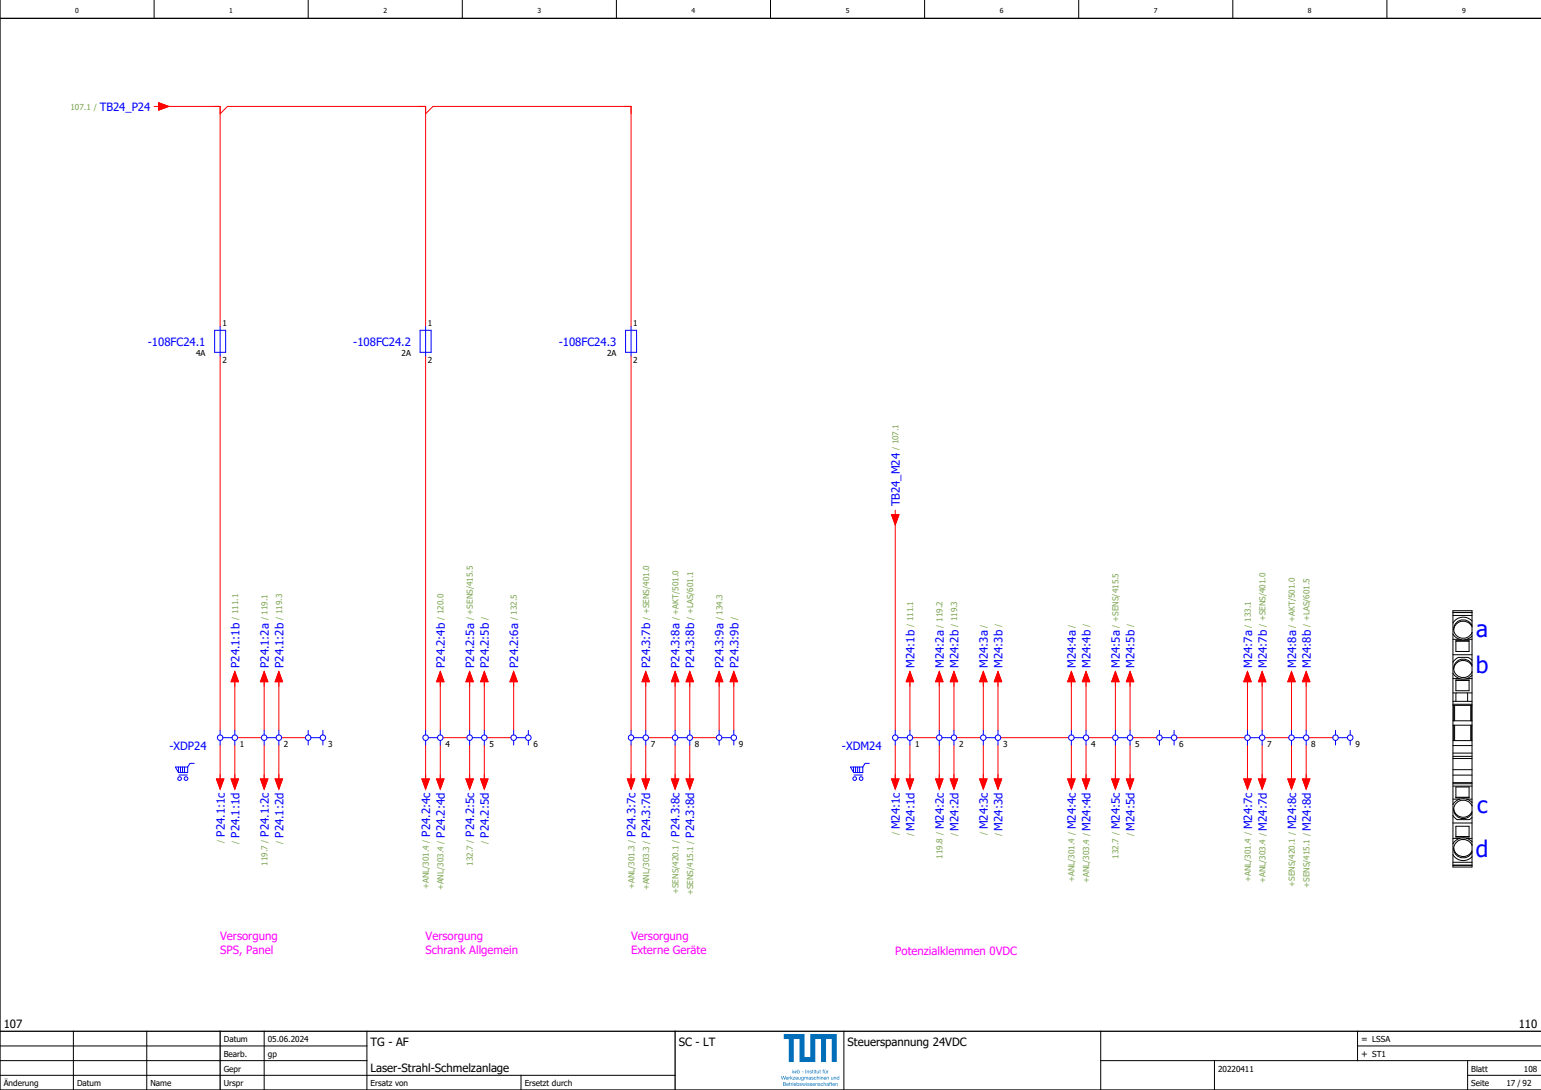
[picture p12: page 17]
Steuerspannung 24VDC; Versorgung SPS, Panel; Versorgung Externe Geräte; Versorgung Schrank Allgemein; Potenzialklemmen 0VDC; -XDP24; -XDM24; P24.2:4d / +ANL/303.4; P24.3:7b / +SENS/401.0; P24.2:4c / +ANL/301.4; P24.2:5a / +SENS/415.5; P24.3:8a / +AKT/501.0; P24.3:8b / +LAS/601.1; P24.3:7d / +ANL/303.3; P24.3:7c / +ANL/301.3; P24.3:8d / +SENS/415.1; P24.3:8c / +SENS/420.1; M24:5a / +SENS/415.5; M24:4d / +ANL/303.4; M24:4c / +ANL/301.4 M24:4a /; M24:8a / +AKT/501.0; M24:8b / +LAS/601.5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

# -110XTR48 2006⁻1671/1000⁻849

-110TB48.1

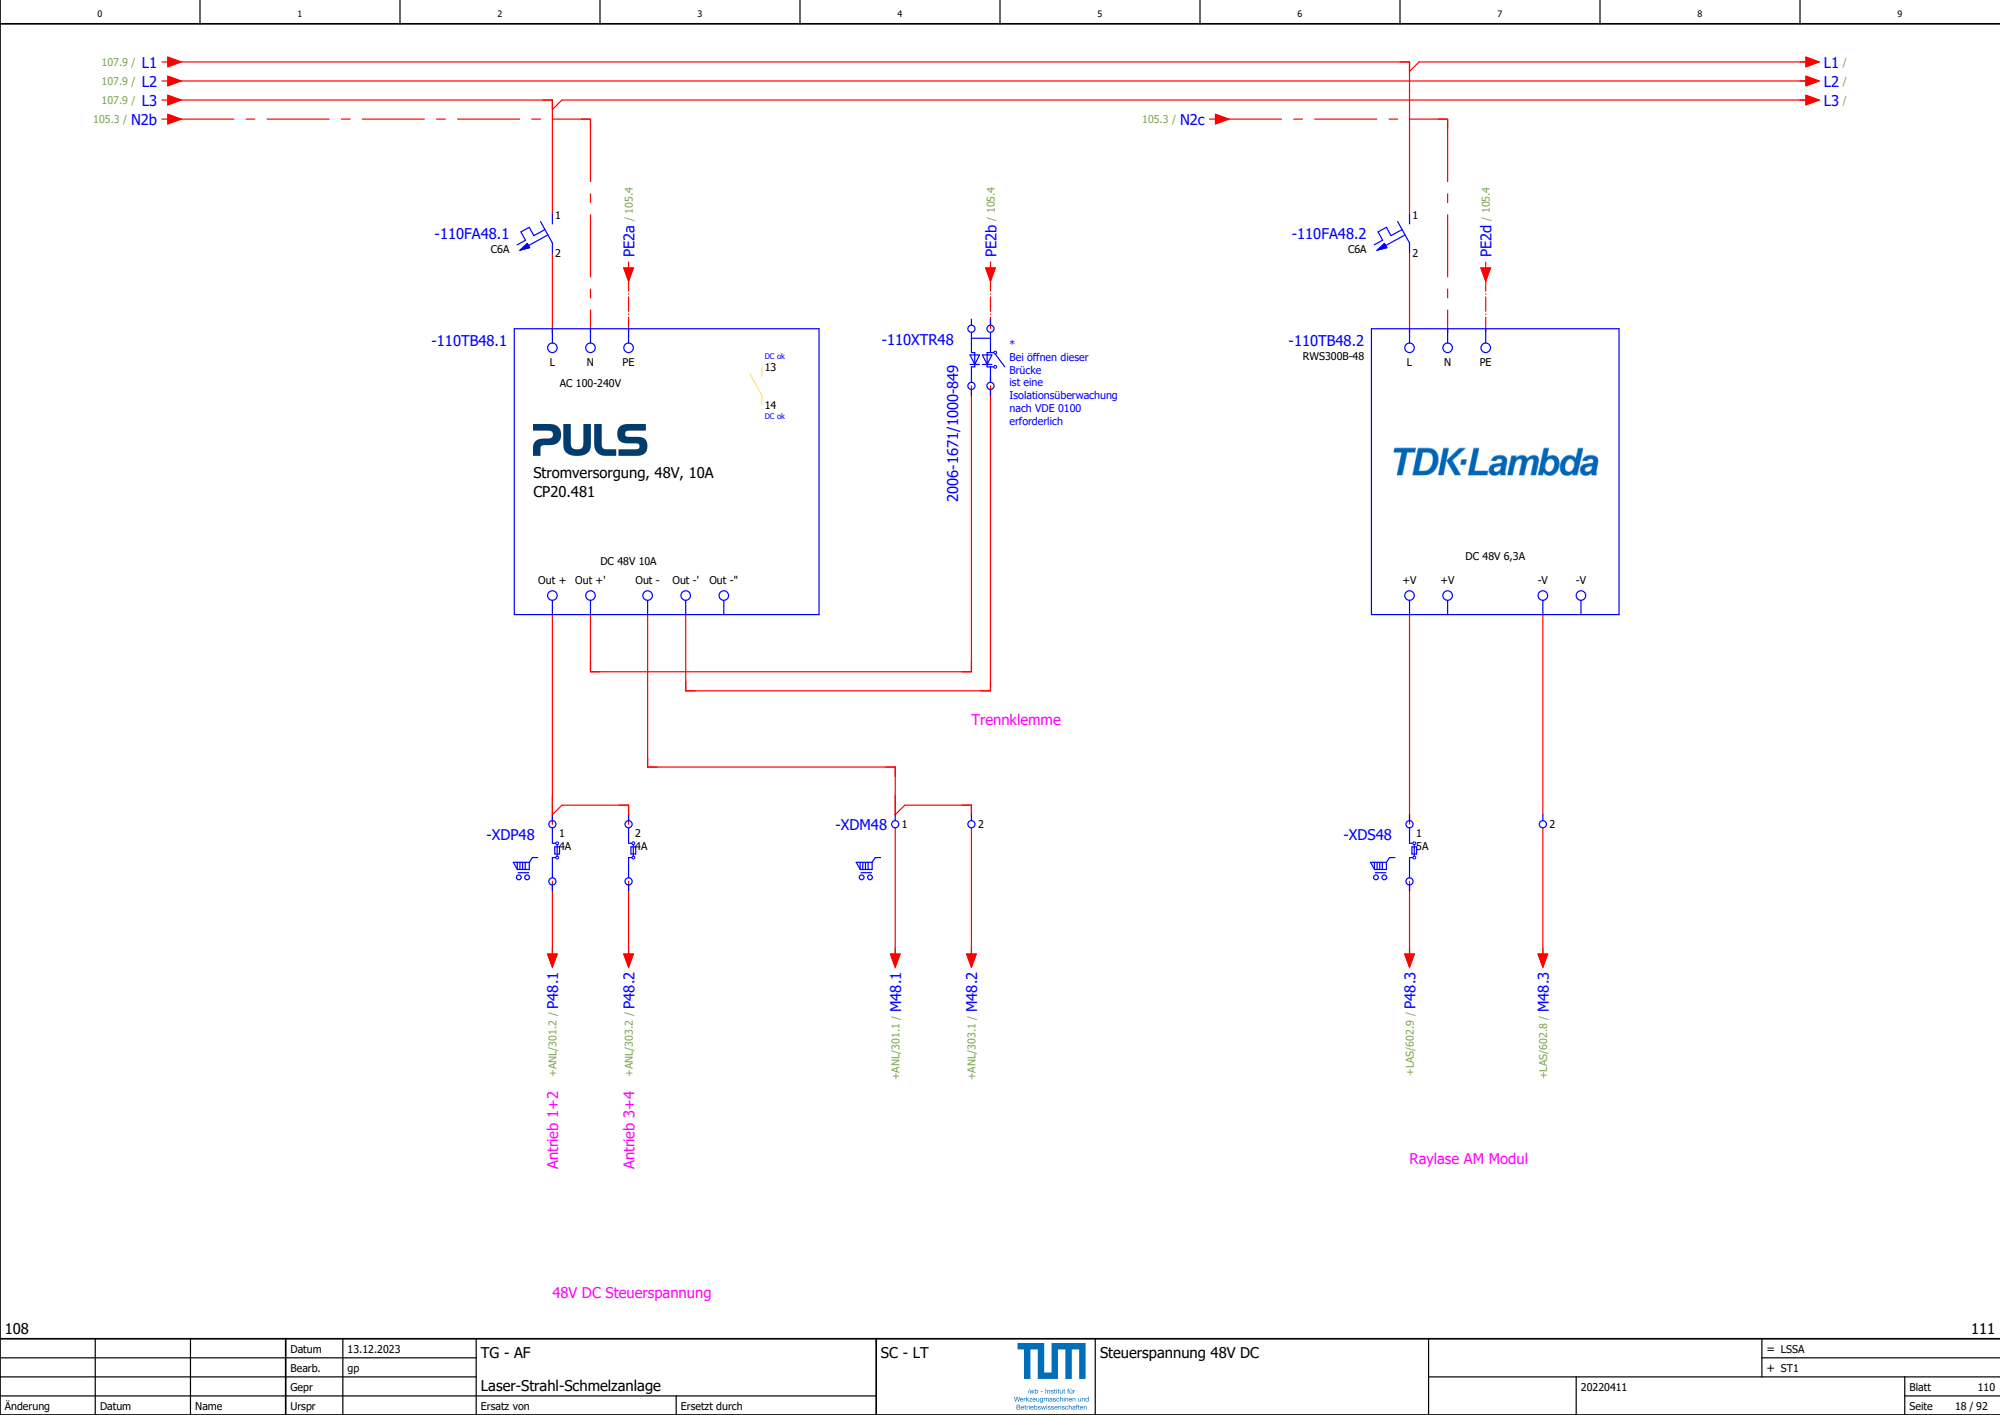
[picture p13: page 18]
Steuerspannung 48V DC; Trennklemme; * Bei öffnen dieser Brücke ist eine Isolationsüberwachung nach VDE 0100 erforderlich; -XDP48; 48V DC Steuerspannung Antrieb 1+²; Antrieb 3+⁴; Stromversorgung, 48V, 10A CP20.481; Out + Out +'; Out -; Out -' Out -''; -XDS48 -XDM48 1; RWS300B-48; P48.1 / +ANL/301.2; P48.2 / +ANL/303.2; P48.3 / +LAS/602.9; M48.1 / +ANL/301.1; M48.2 / +ANL/303.1; M48.3 / +LAS/602.8

Raylase AM Modul

## PEPE2c / 105.4

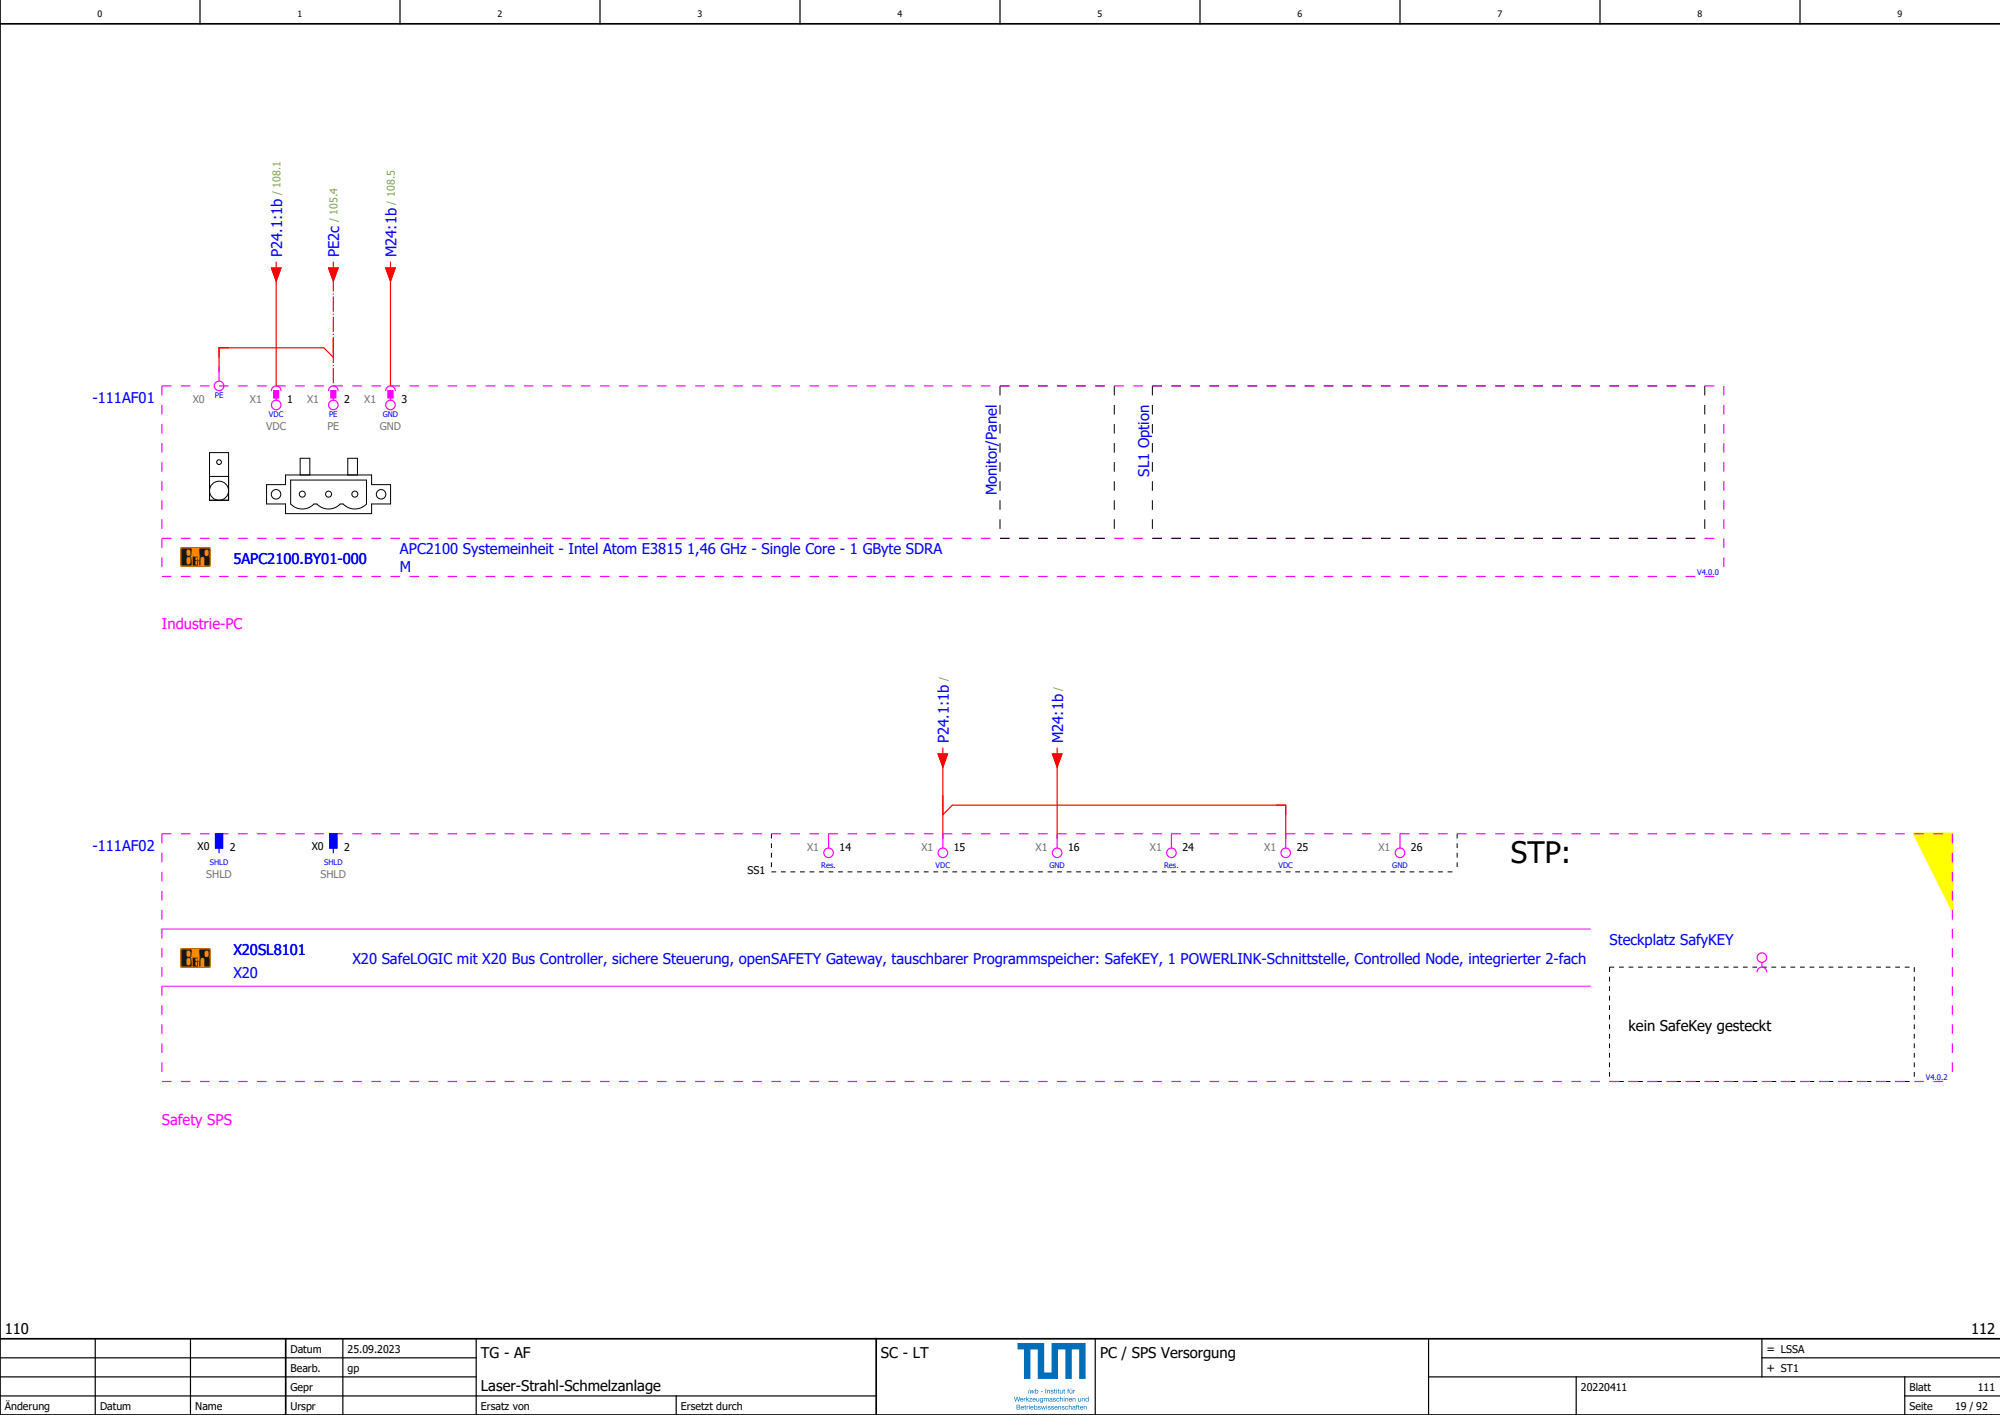
[picture p14: page 19]
Industrie-PC; Safety SPS; Steckplatz SafyKEY; GND; VDC; X20 SafeLOGIC mit X20 Bus Controller, sichere Steuerung, openSAFETY Gateway, tauschbarer Programmspeicher: SafeKEY, 1 POWERLINK-Schnittstelle, Controlled Node, integrierter 2-fach; STP:; SHLD SHLD; Res.; SL1 Option; Monitor/Panel; VDC VDC; GND GND; 5APC2100.BY01-000; APC2100 Systemeinheit - Intel Atom E3815 1,46 GHz - Single Core - 1 GByte SDRA

kein SafeKey gesteckt

PC / SPS Versorgung

-112KF01 | Bus-Controller
-112KF02 | Einspeisemodul

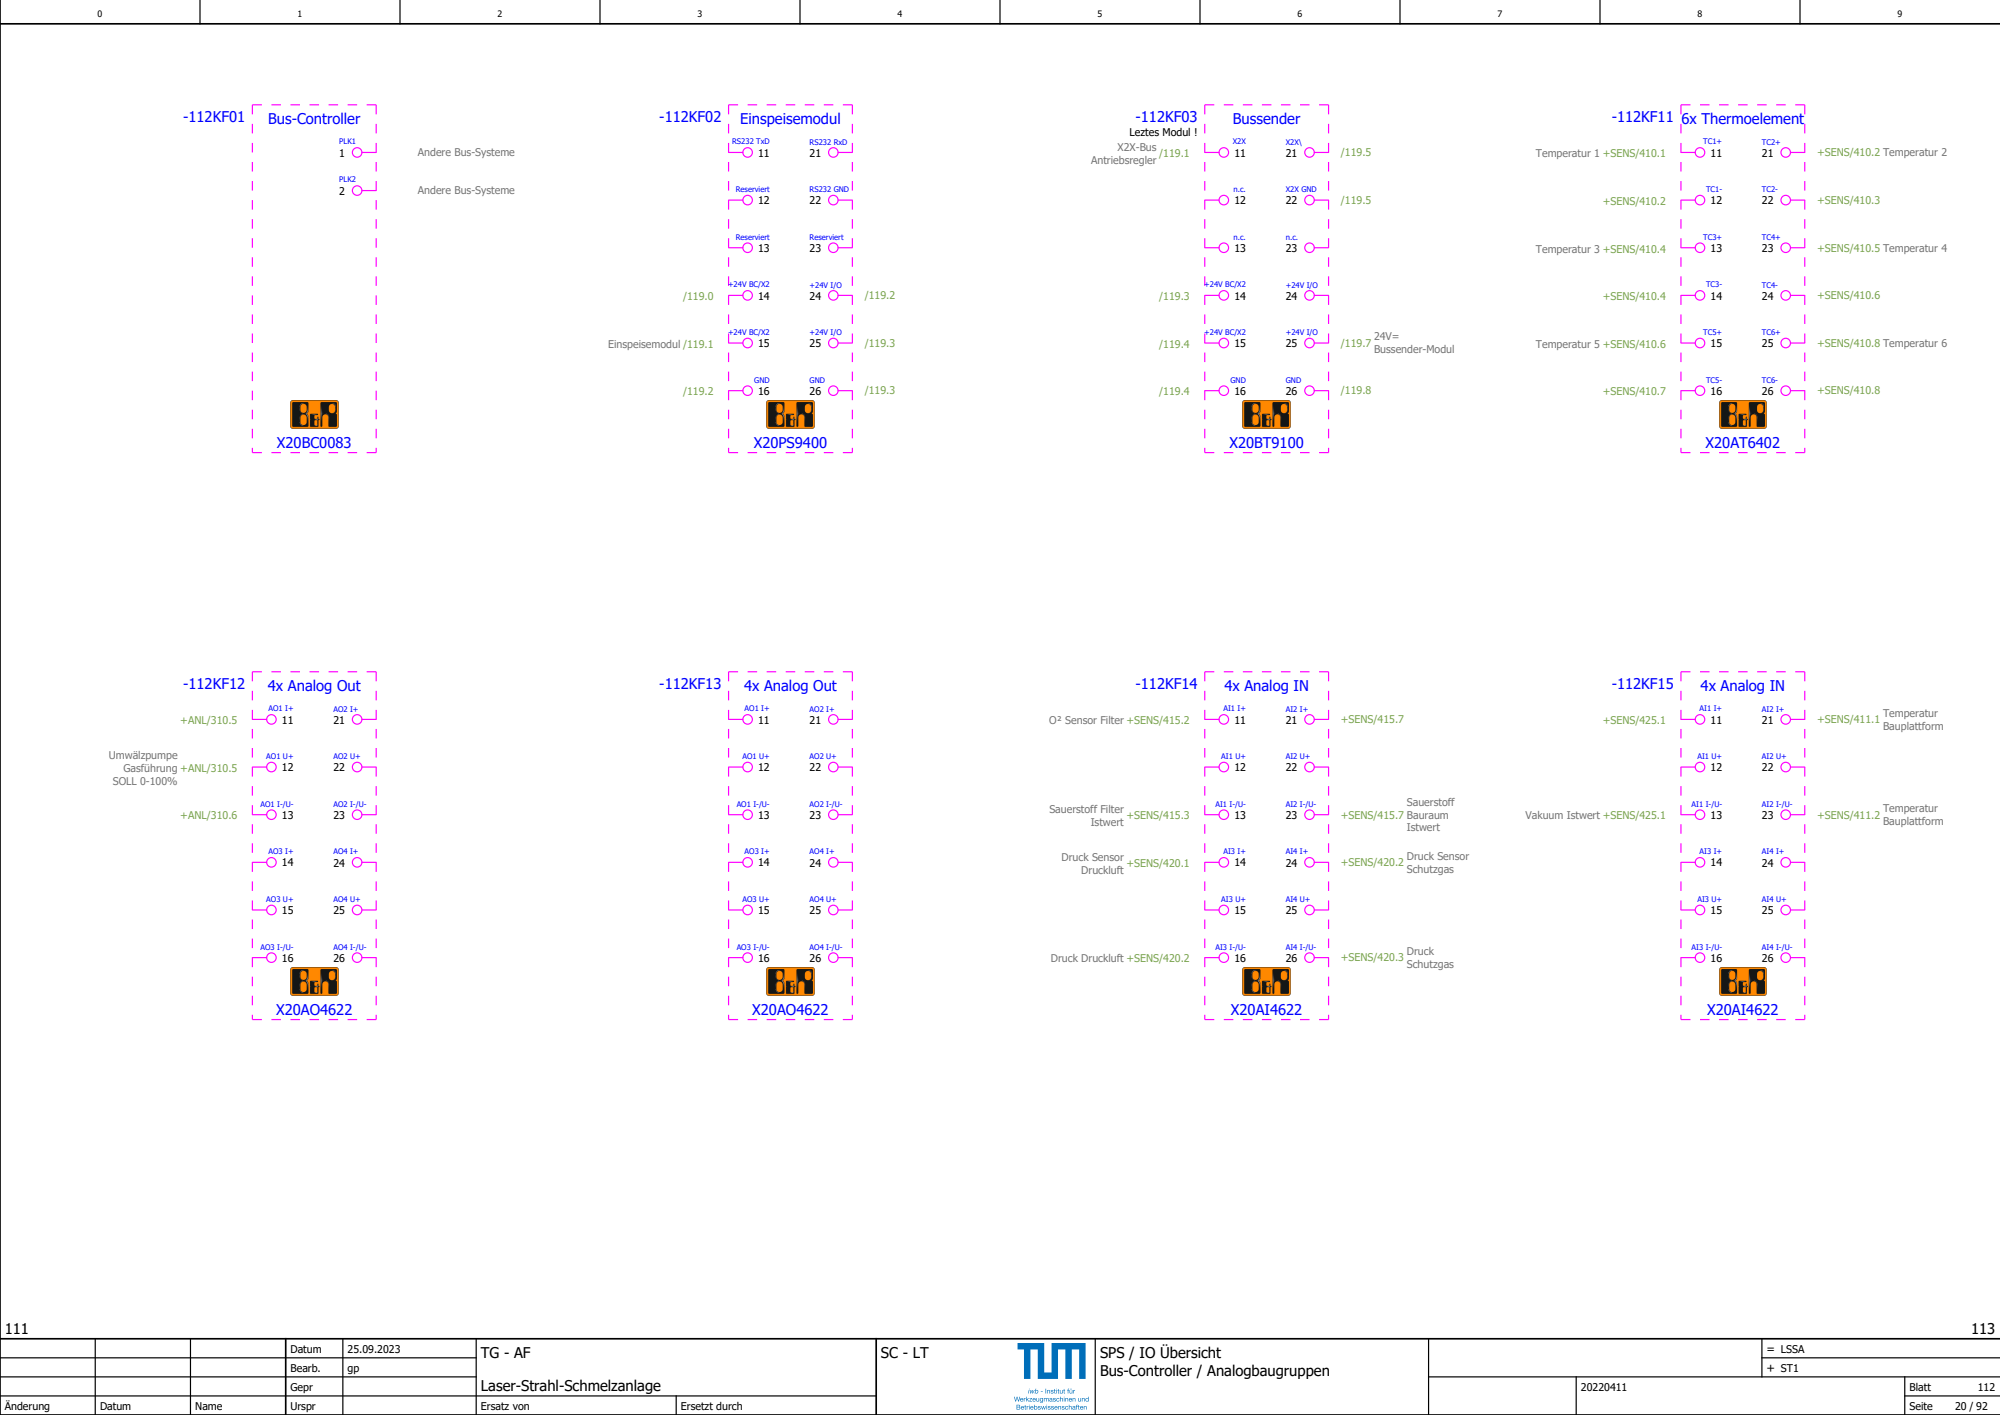
[picture p15: page 20]
PLK1; PLK2; RS232 TxD; Reserviert; RS232 RxD; RS232 GND; Einspeisemodul /119.1; GND; 4x Analog Out; +ANL/310.5; Umwälzpumpe Gasführung SOLL 0-100%; +ANL/310.6; 6x Thermoelement; Temperatur 1 +SENS/410.1; +SENS/410.2; +SENS/410.2 Temperatur 2; +SENS/410.3; Temperatur 3 +SENS/410.4; +SENS/410.4; +SENS/410.5 Temperatur 4; +SENS/410.6; Temperatur 5 +SENS/410.6; +SENS/410.7; +SENS/410.8 Temperatur 6; +SENS/410.8; 4x Analog IN; +SENS/415.7; Istwert; Sauerstoff Bauraum Istwert; Schutzgas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

Andere Bus-Systeme

O² Sensor Filter +SENS/415.2

+SENS/415.3 Sauerstoff Filter

Vakuum Istwert +SENS/425.1

+SENS/420.1 Druck Sensor
Druckluft

+SENS/420.2 Druck Sensor

Druck Druckluft +SENS/420.2

SPS / IO Übersicht
Bus-Controller / Analogbaugruppen

-113KF16 | 6x Digital IN
-113KF17 | 6x Digital IN

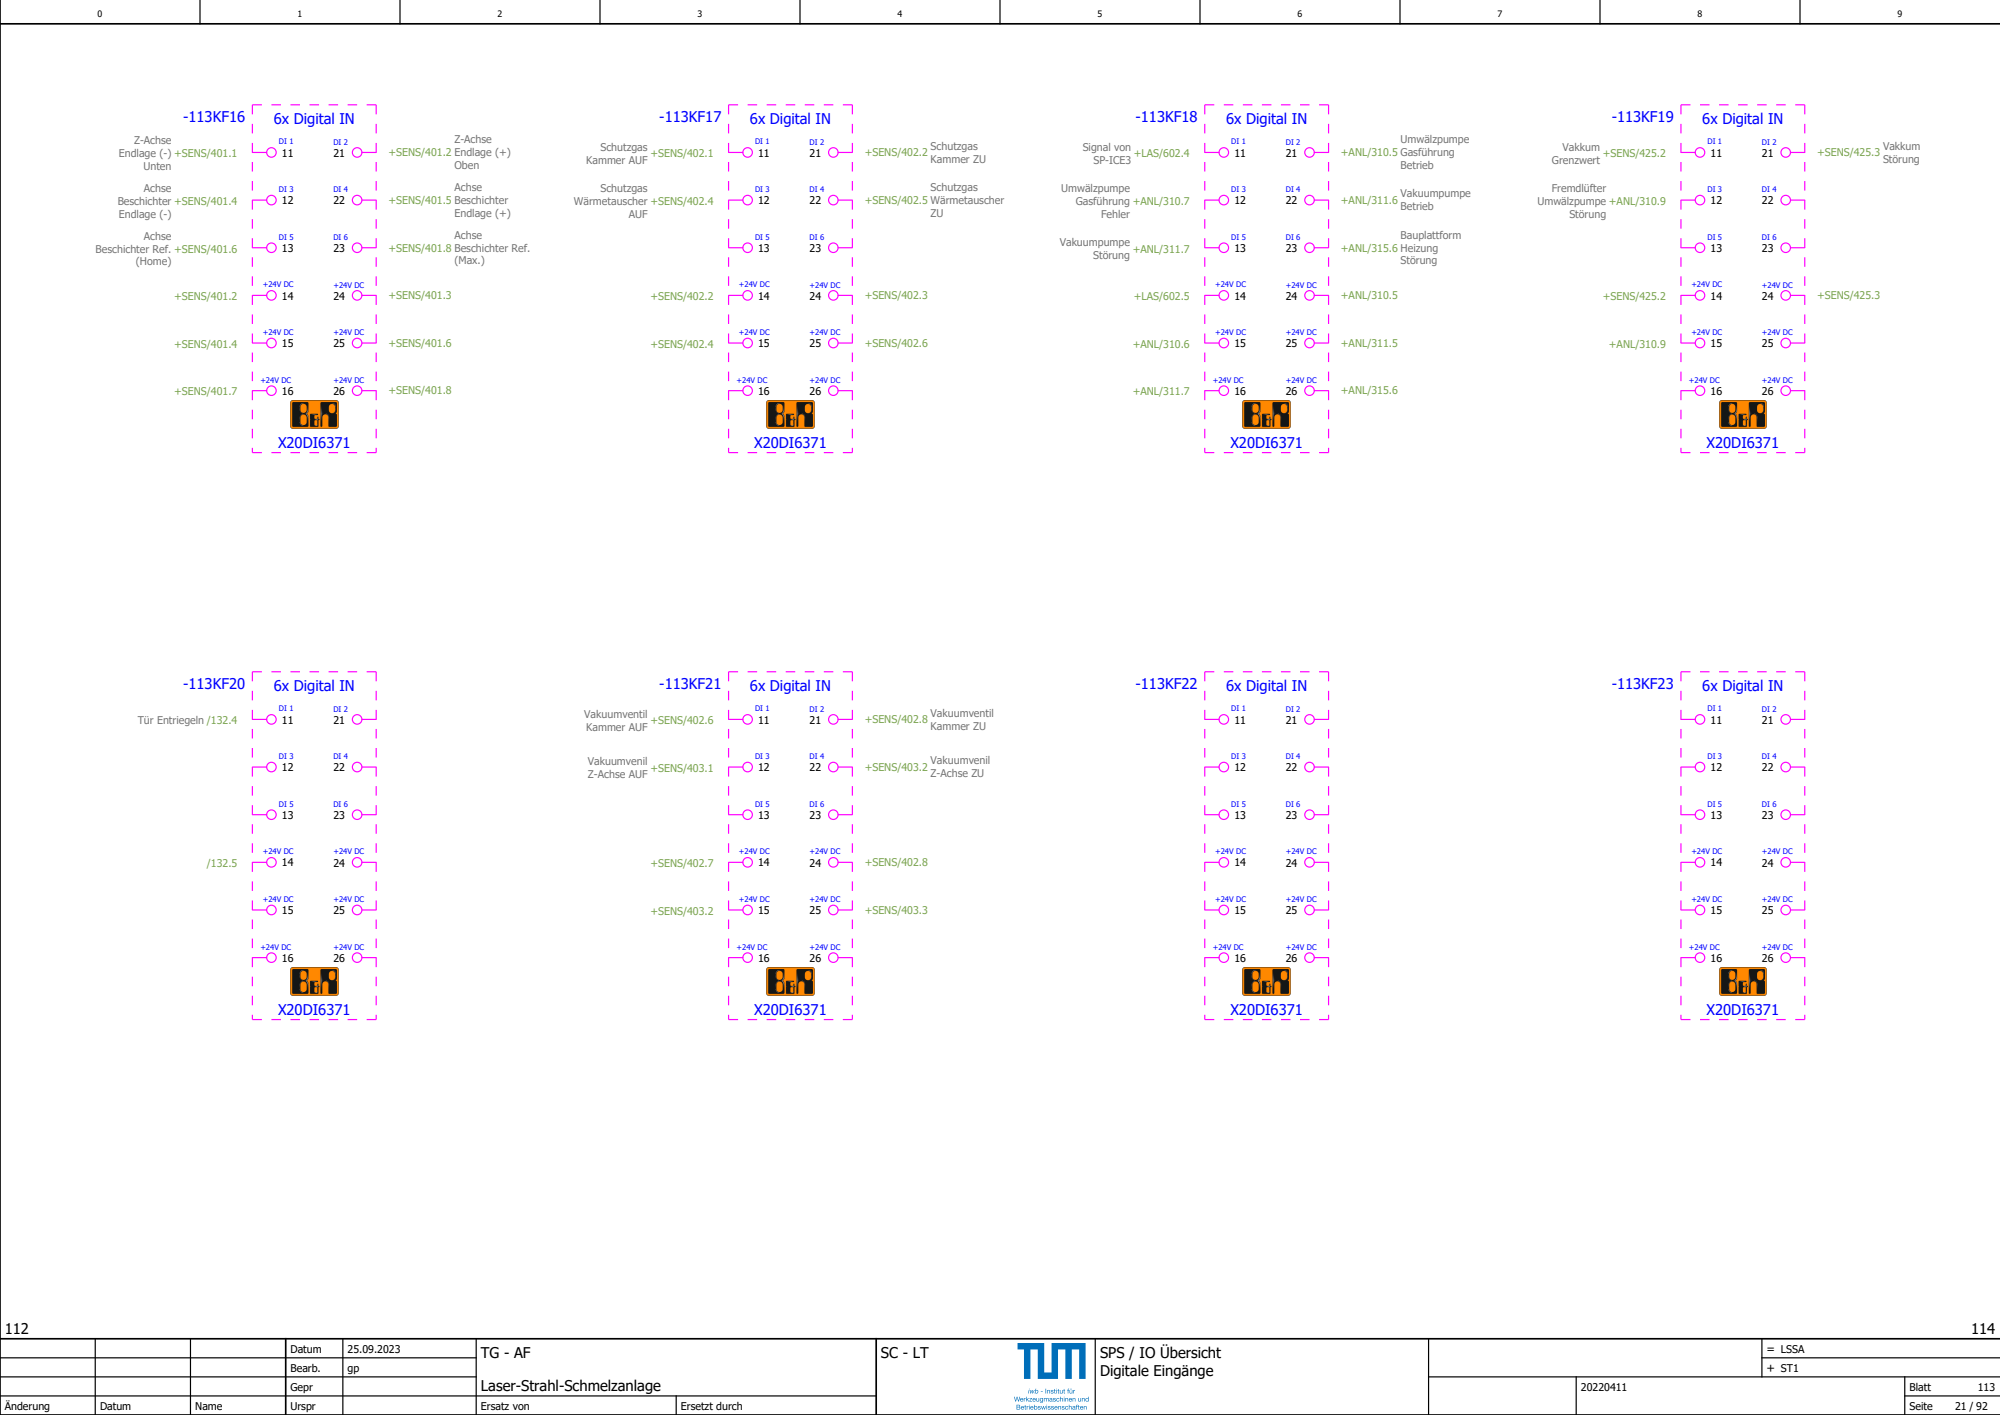
[picture p16: page 21]
+SENS/401.1; Z-Achse Endlage (-) Unten; +SENS/401.4; Achse Beschichter Endlage (-); +SENS/401.2; Z-Achse Endlage (+) Oben; +SENS/401.5; Achse Beschichter Endlage (+); +SENS/401.6; Achse Beschichter Ref. (Home); +SENS/401.8; Achse Beschichter Ref. (Max.); +SENS/401.3; +SENS/401.7; +SENS/402.1 Schutzgas Kammer AUF; +SENS/402.4; Schutzgas Wärmetauscher AUF; +SENS/402.2 Schutzgas Kammer ZU; +SENS/402.5; Schutzgas Wärmetauscher ZU; +SENS/402.2; +SENS/402.3; +SENS/402.6; 6x Digital IN; +ANL/310.7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

+LAS/602.4 Signal von
SP-ICE3

SPS / IO Übersicht
Digitale Eingänge

-114KF24 | 6x Digital OUT
-114KF25 | 6x Digital OUT

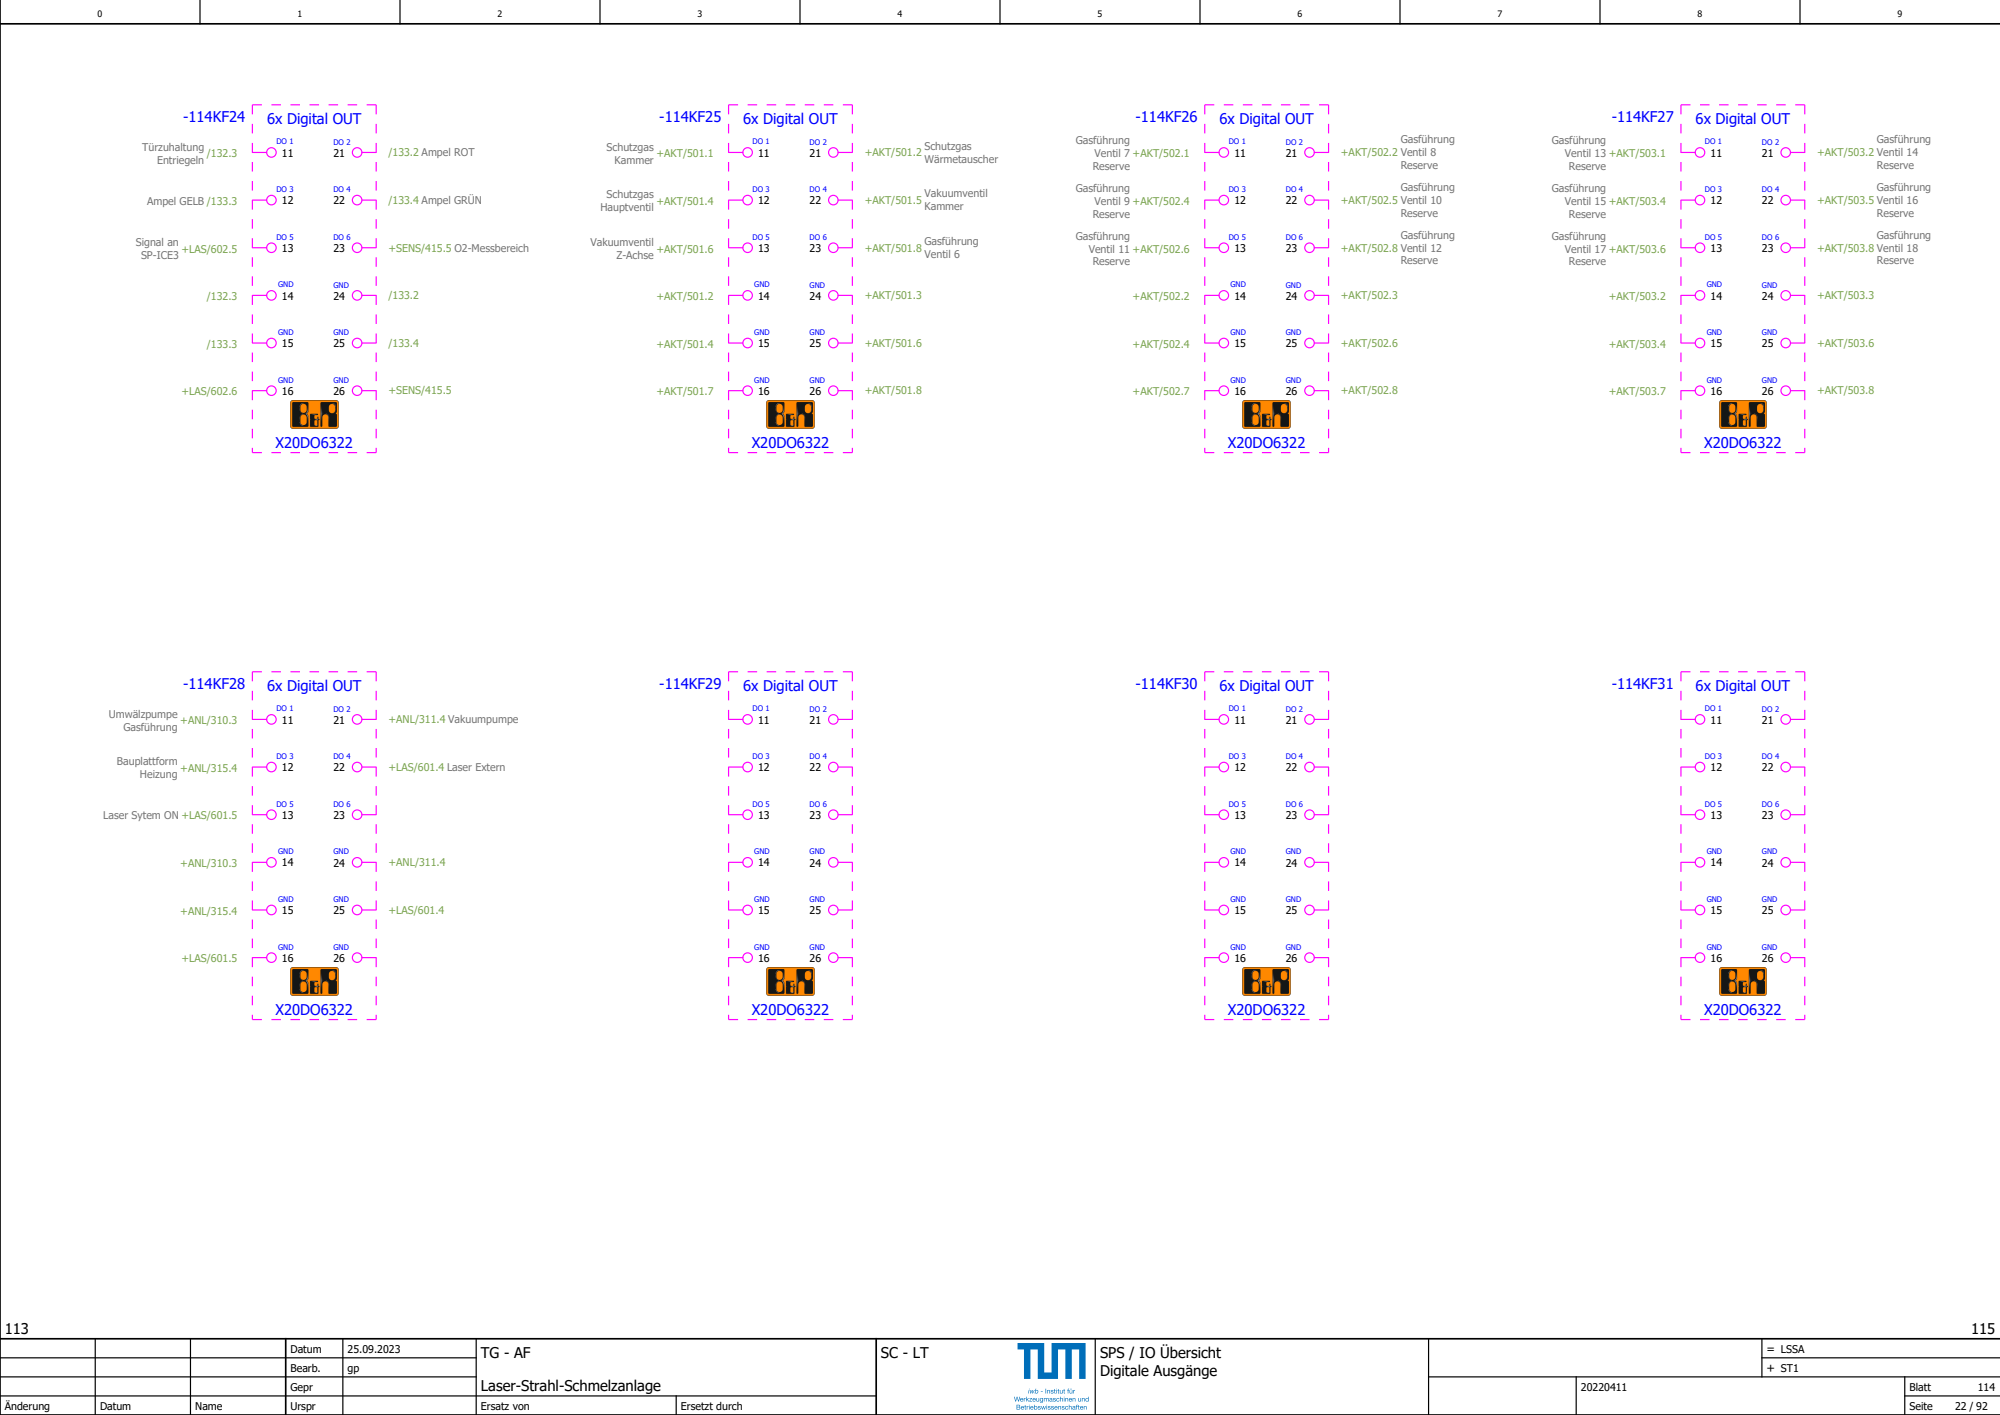
[picture p17: page 22]
/132.3 Türzuhaltung Entriegeln; Ampel GELB /133.3; /133.2 Ampel ROT; /133.4 Ampel GRÜN; GND; +SENS/415.5 O2-Messbereich; +LAS/602.6; +SENS/415.5; 6x Digital OUT; +ANL/310.3 Umwälzpumpe Gasführung; +ANL/315.4 Bauplattform Heizung; +ANL/311.4 Vakuumpumpe; +ANL/310.3; +ANL/311.4; +ANL/315.4; +LAS/601.5; +LAS/601.4; +AKT/501.1 Schutzgas Kammer; +AKT/501.4 Schutzgas Hauptventil; +AKT/501.2 Schutzgas Wärmetauscher; +AKT/501.5 Vakuumventil Kammer; +AKT/501.6 Vakuumventil Z-Achse; +AKT/501.2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

+LAS/602.5 Signal an
SP-ICE3

+LAS/601.4 Laser Extern

Laser Sytem ON +LAS/601.5

SPS / IO Übersicht
Digitale Ausgänge

-115KF51 | 8x Safety IN
-115KF52 | 6x Safety OUT

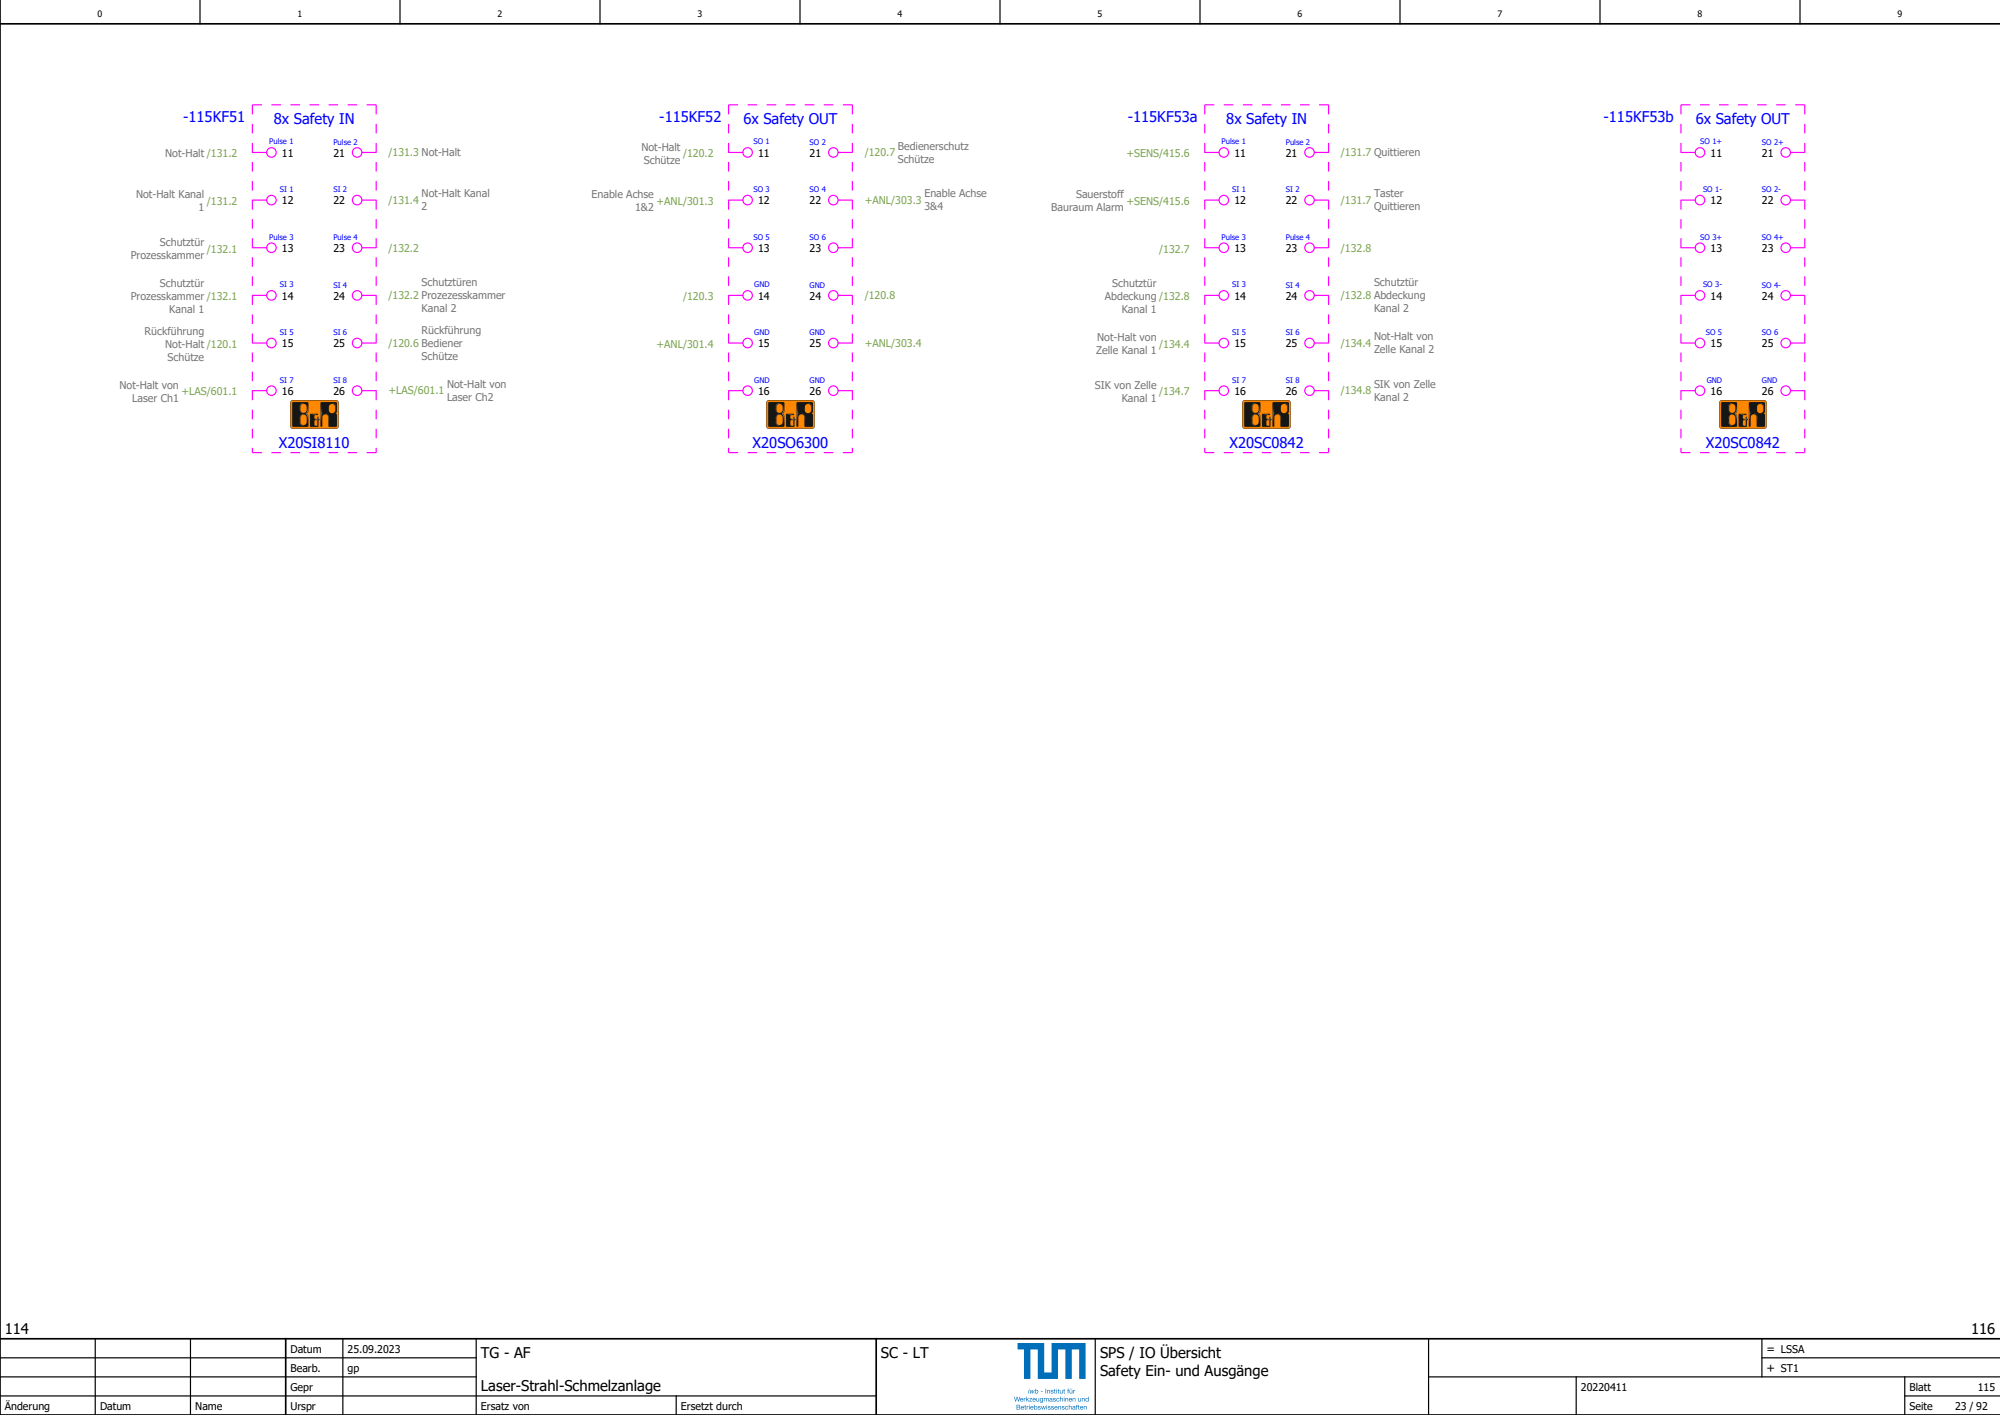
[picture p18: page 23]
Pulse 1; Not-Halt /131.2; Pulse 2; /131.3 Not-Halt; Pulse 3; /132.1 Schutztür Prozesskammer; Schutztür Prozesskammer Kanal 1; Pulse 4; Schutztüren Prozezesskammer Kanal 2; Rückführung Not-Halt Schütze; Rückführung Bediener Schütze; Laser Ch2; /120.2 Not-Halt Schütze; /120.7 Bedienerschutz Schütze; GND; +ANL/301.4; +ANL/303.4; 8x Safety IN; +SENS/415.6; +SENS/415.6 Sauerstoff Bauraum Alarm; /131.7 Quittieren; /131.7 Taster Quittieren; Schutztür Abdeckung Kanal 1; Schutztür Abdeckung Kanal 2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

/131.2 Not-Halt Kanal

/131.4 Not-Halt Kanal

+ANL/301.3 Enable Achse

+ANL/303.3 Enable Achse

/134.4 Not-Halt von
Zelle Kanal 1

+LAS/601.1 Not-Halt von
Laser Ch1

/134.7 SIK von Zelle
Kanal 1

/134.8 SIK von Zelle

SPS / IO Übersicht
Safety Ein- und Ausgänge

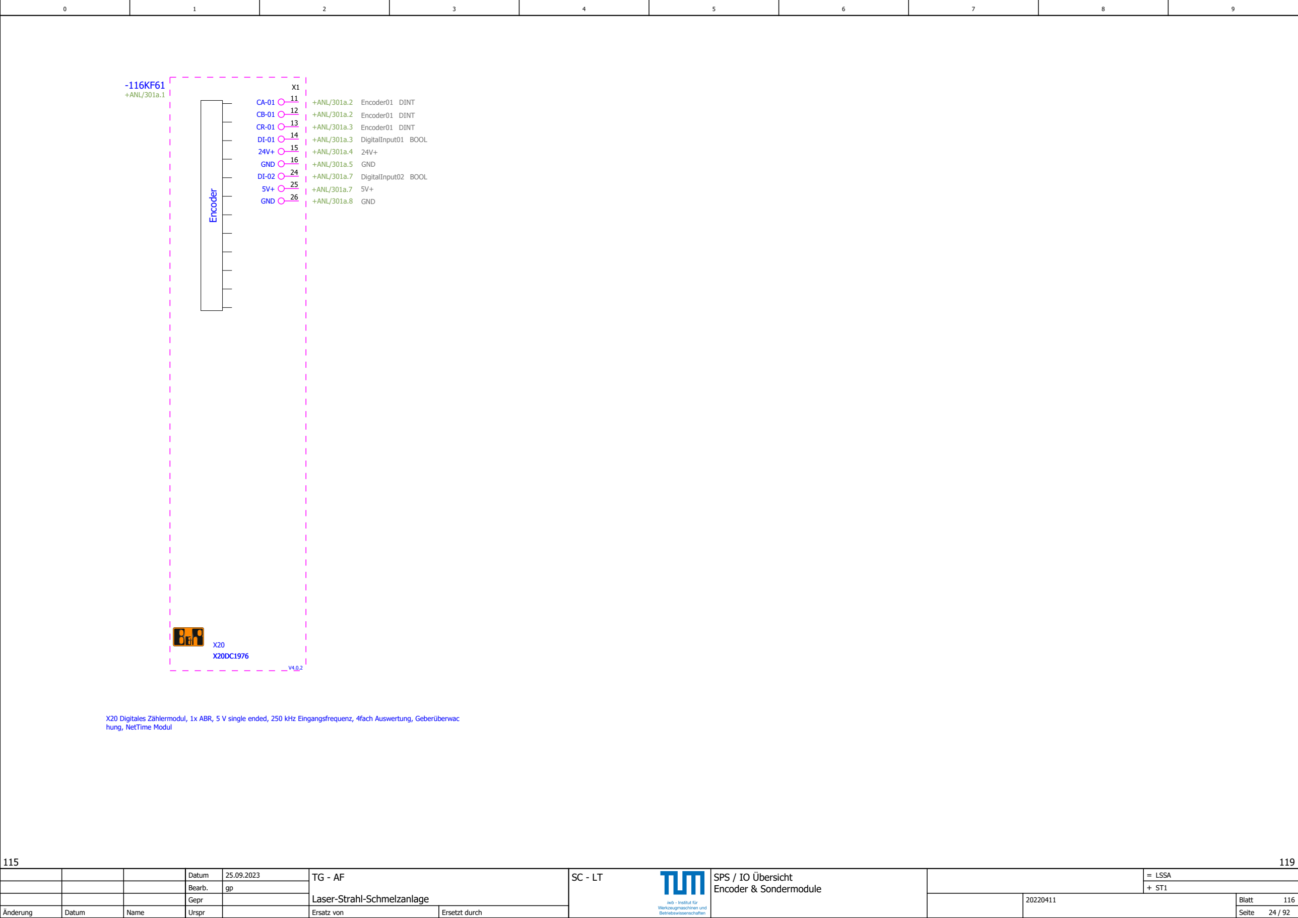
[picture p19: figure]
SPS / IO Übersicht Encoder & Sondermodule; Encoder; +ANL/301a.1; hung, NetTime Modul; +ANL/301a.2; Encoder01 DINT 11 CA-01; Encoder01 DINT 12 CB-01; +ANL/301a.3; DigitalInput01 BOOL 14 DI-01; Encoder01 DINT 13 CR-01; +ANL/301a.4; +ANL/301a.5; GND 16 GND; +ANL/301a.7; DigitalInput02 BOOL 24 DI-02; +ANL/301a.8; GND 26 GND

X20 Digitales Zählermodul, 1x ABR, 5 V single ended, 250 kHz Eingangsfrequenz, 4fach Auswertung, Geberüberwac

-112KF02
/112.3 | X20PS9400

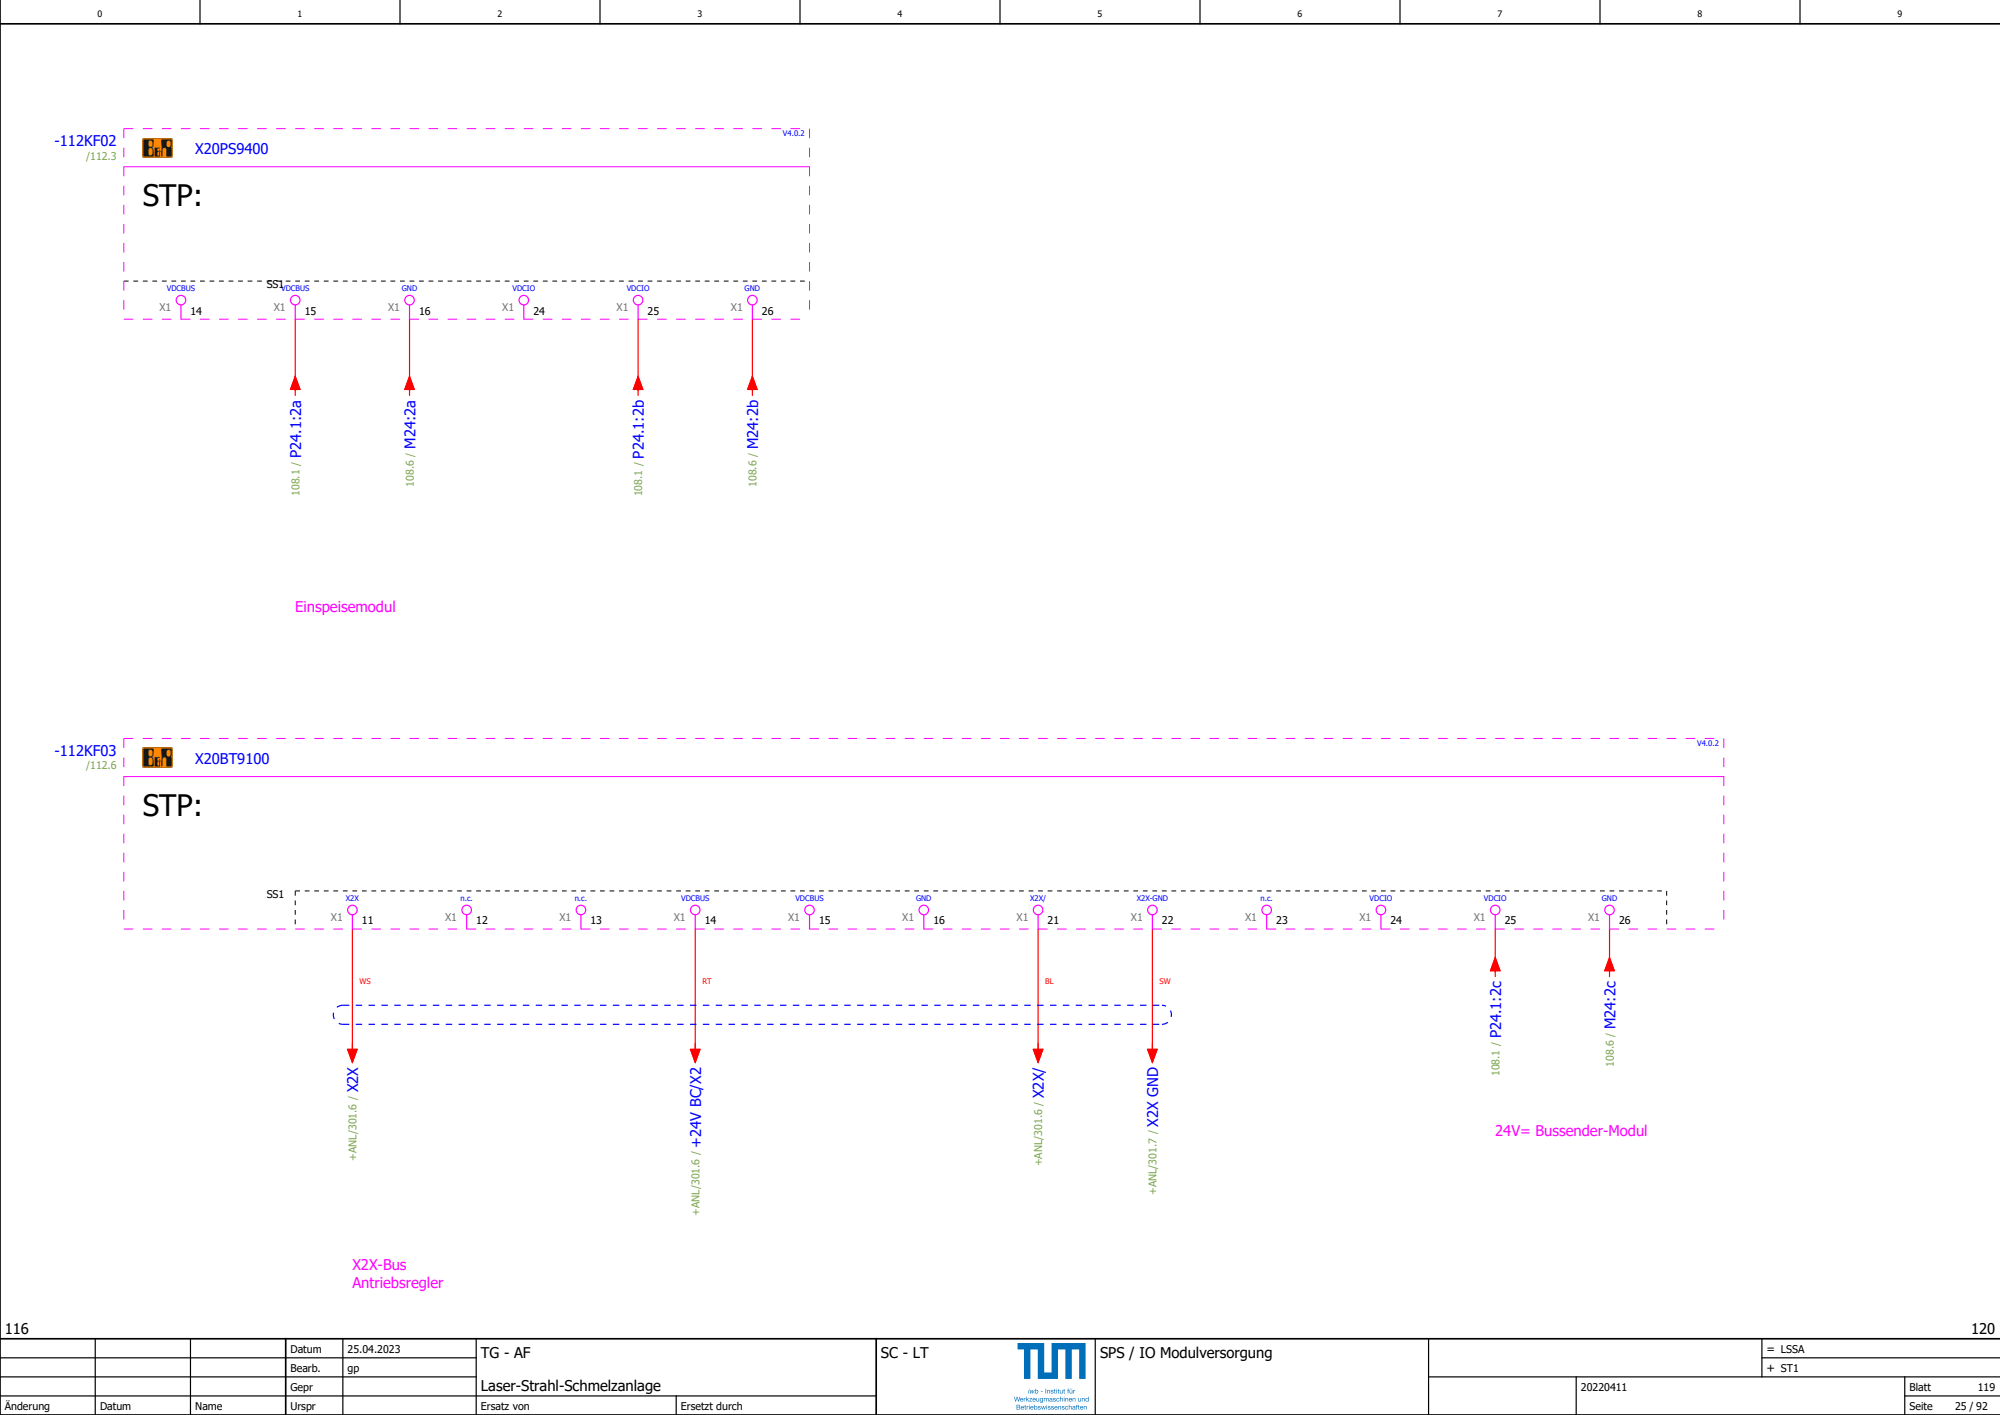
[picture p20: page 25]
VDCBUS; VDCIO; GND; STP:; Einspeisemodul; 24V= Bussender-Modul; X2X-GND; X2X-Bus Antriebsregler; X2X / +ANL/301.6; +24V BC/X2 / +ANL/301.6; X2X/ / +ANL/301.6; X2X GND / +ANL/301.7

SPS / IO Modulversorgung

## Bedienerschutz Schütze

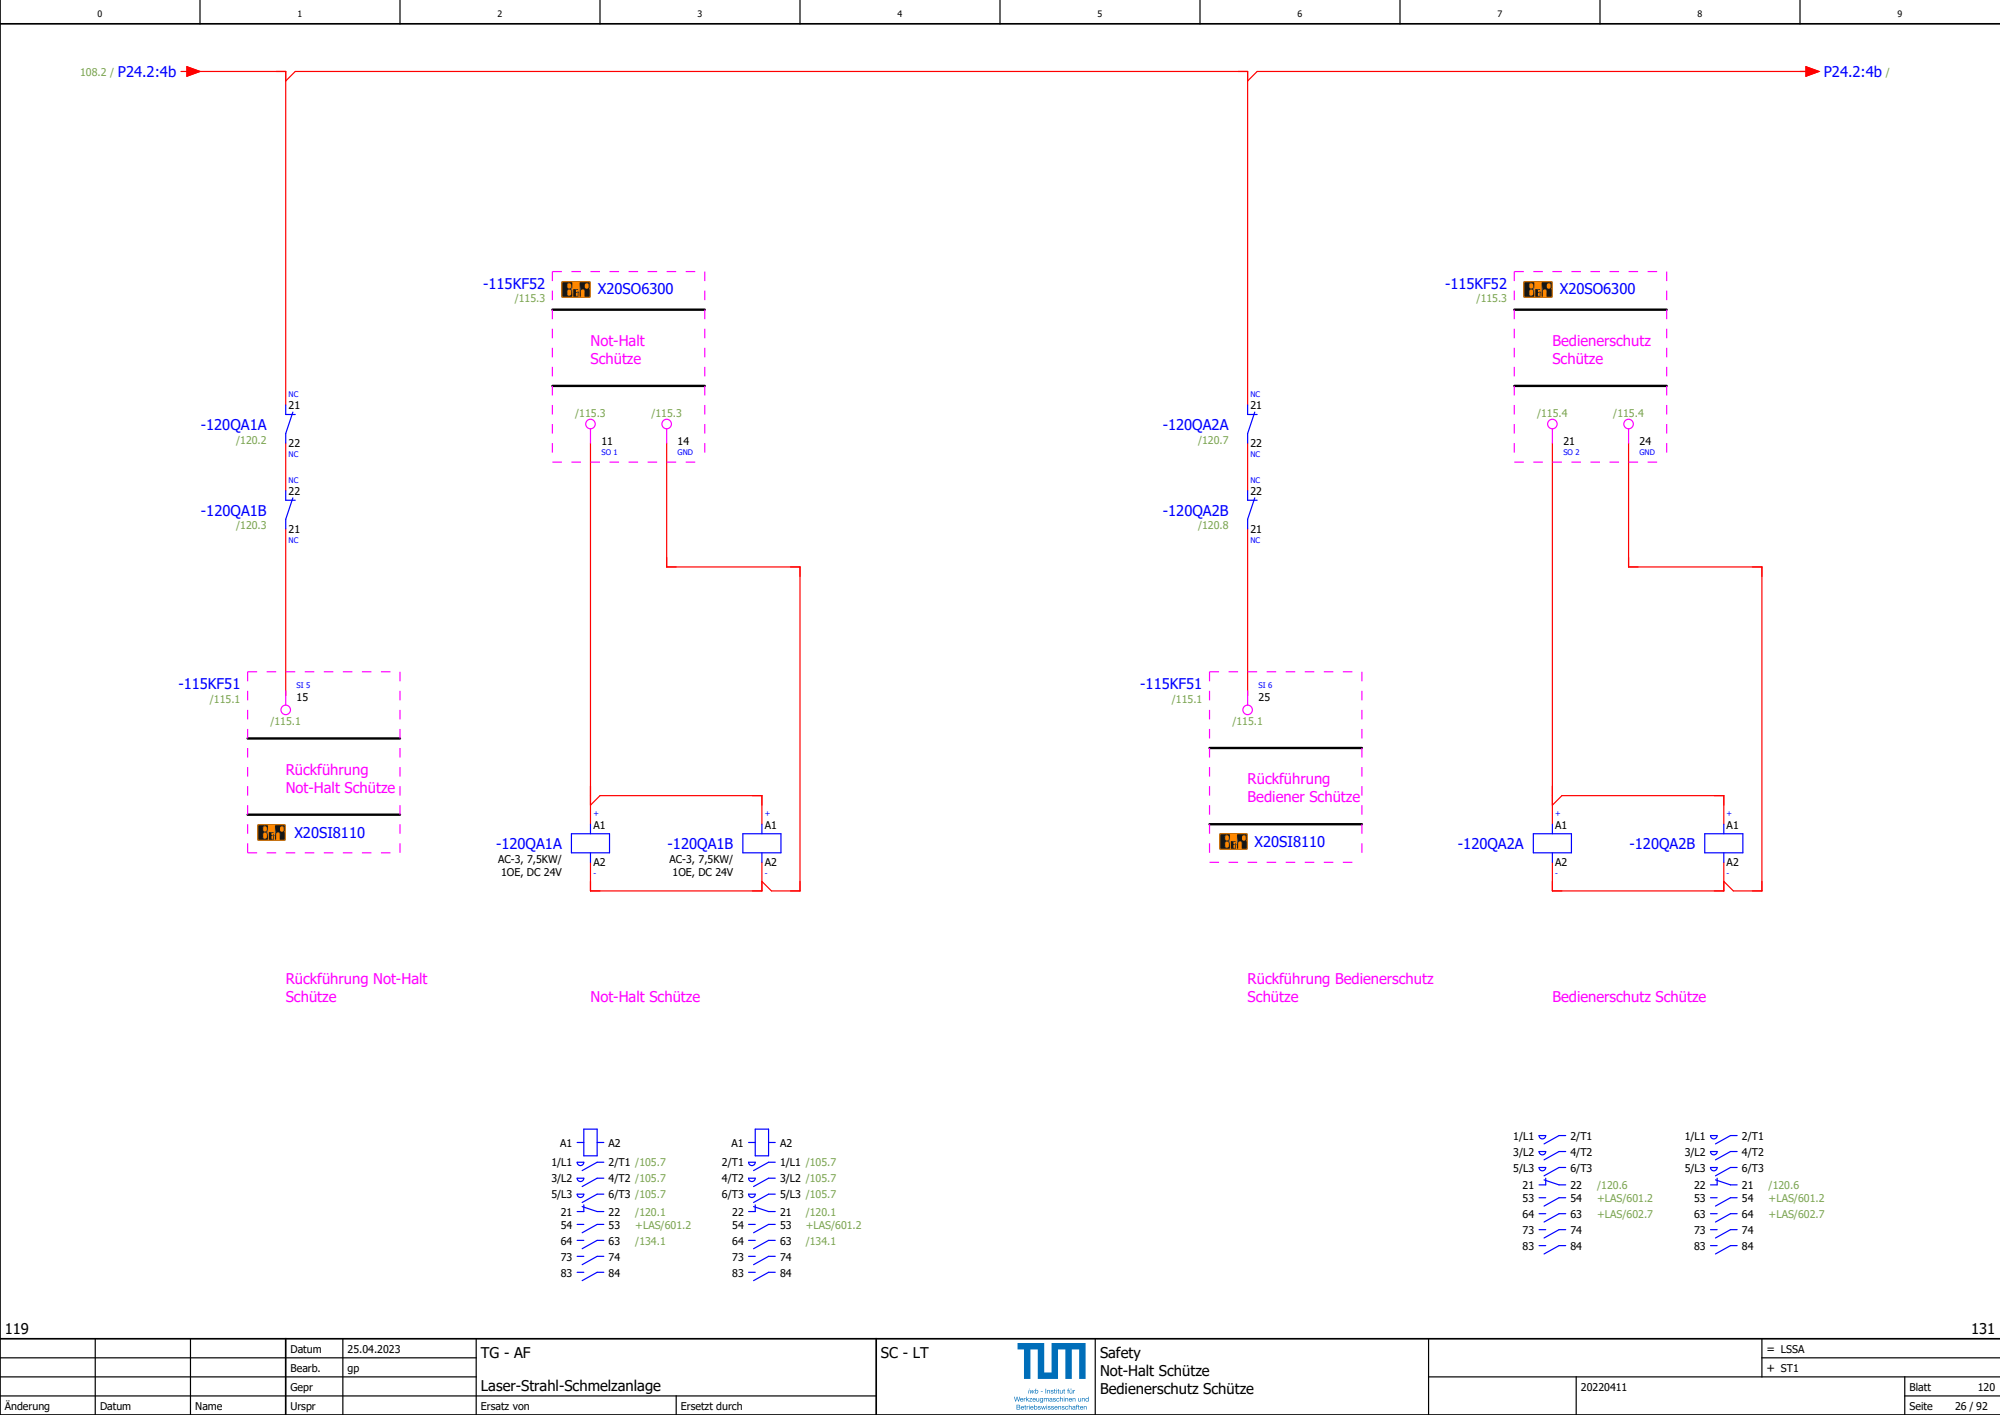
[picture p21: page 26]
Schütze; Not-Halt Schütze; Bedienerschutz Schütze; Rückführung Bedienerschutz Schütze; Rückführung Bediener Schütze; GND; +LAS/601.2; +LAS/602.7

Rückführung
Not-Halt Schütze

Rückführung Not-Halt

Safety
Bedienerschutz Schütze

## Not-Halt Kanal 2

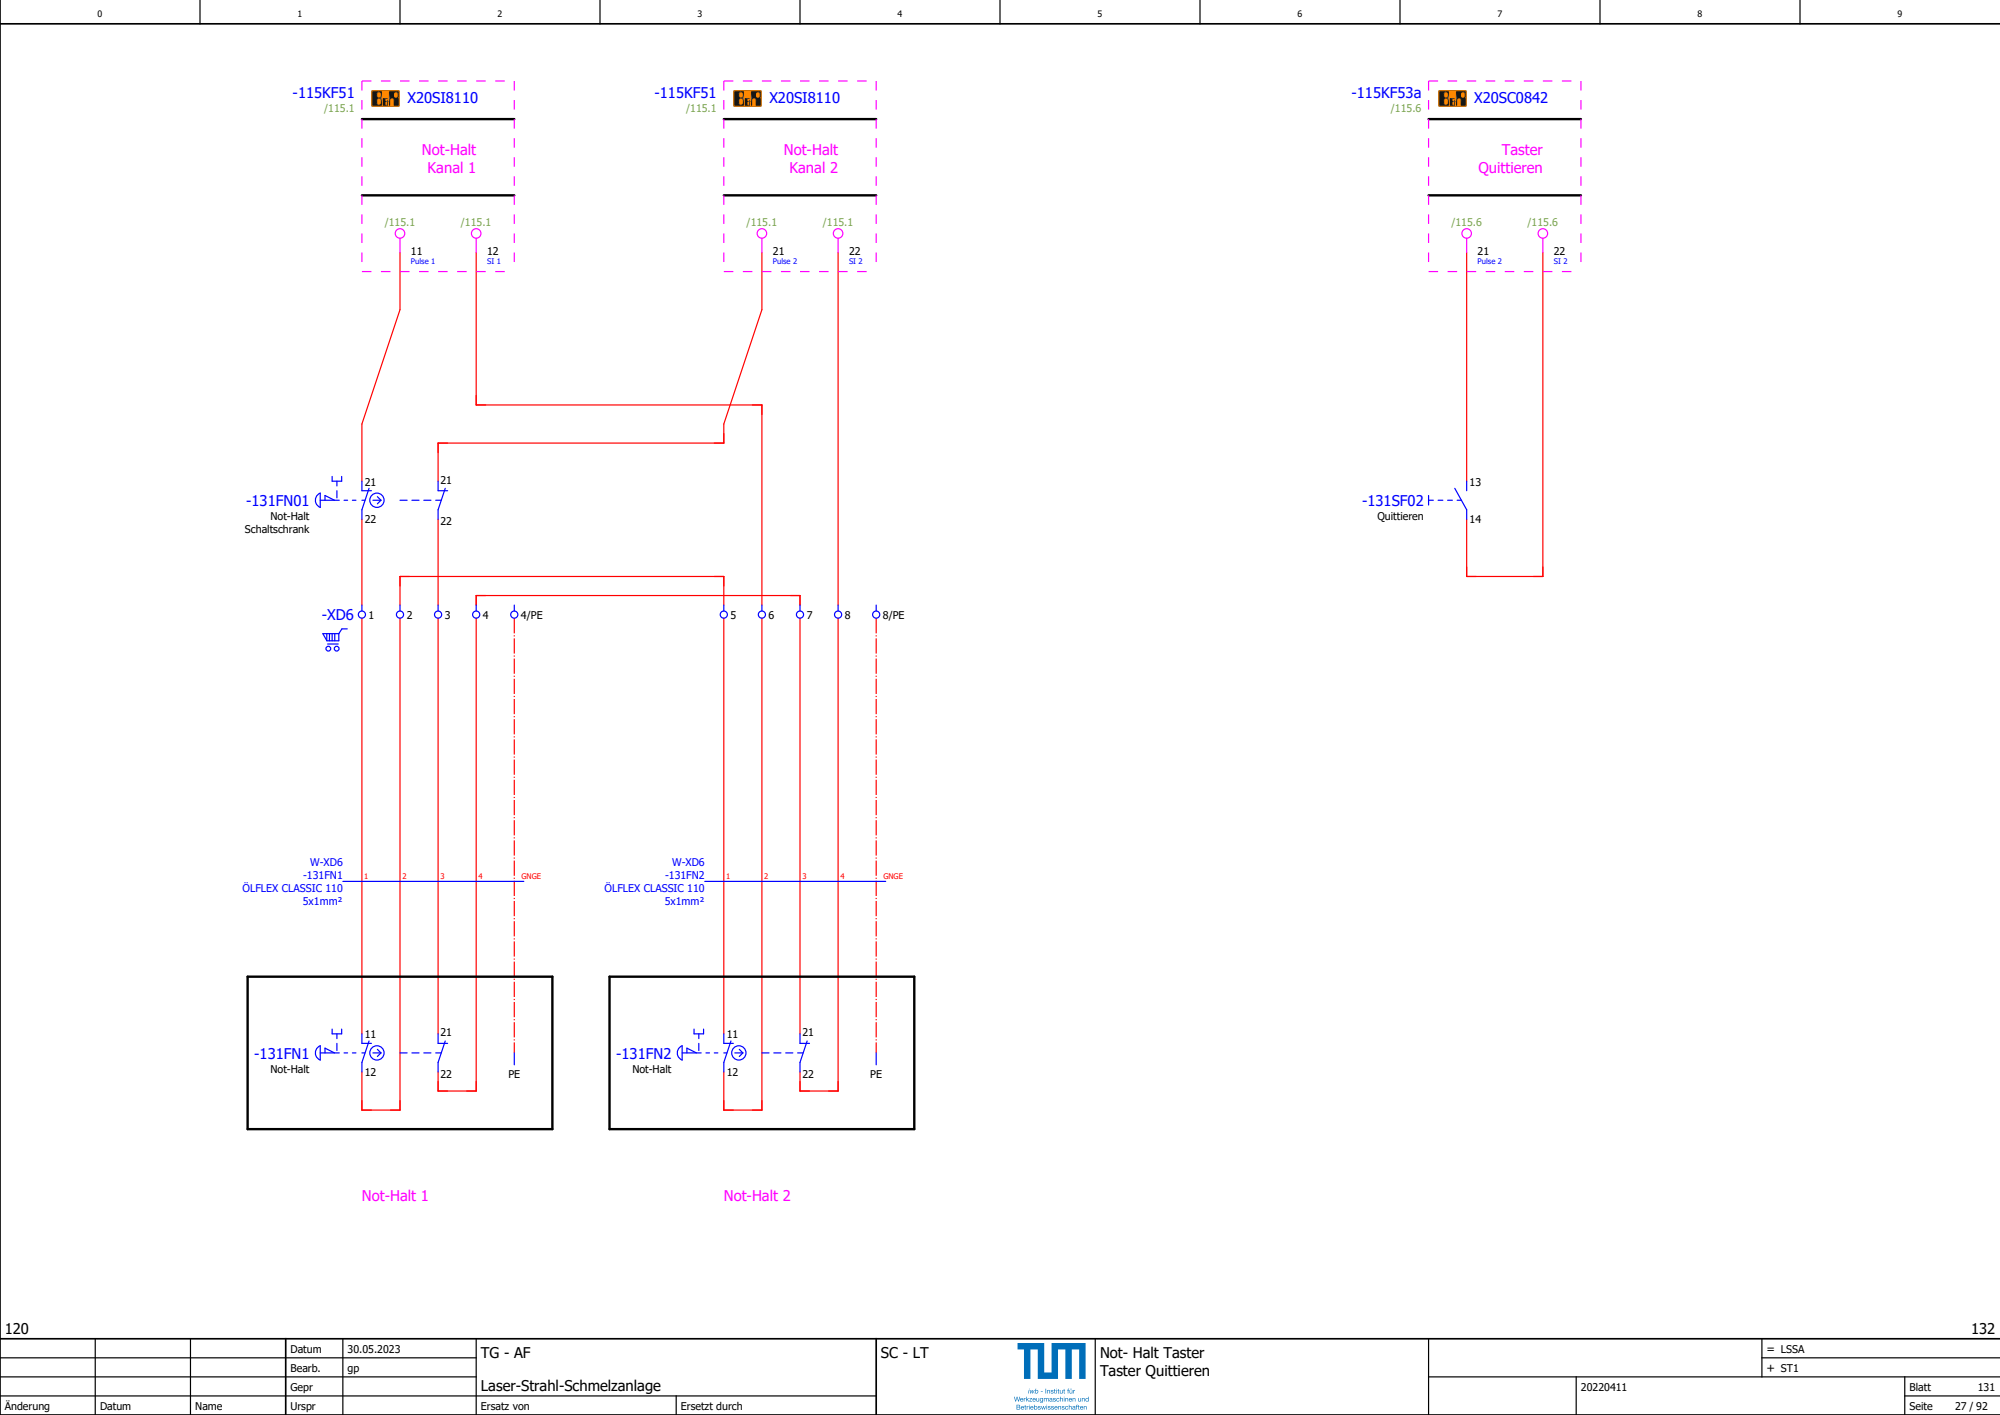
[picture p22: page 27]
Not-Halt 2; Pulse 2; Not-Halt 1; Not-Halt Kanal 1; Pulse 1; Taster Quittieren; Not-Halt; W-XD6 -131FN1 ÖLFLEX CLASSIC 110 5x1mm²; GNGE; Not-Halt Schaltschrank; W-XD6 -131FN2 ÖLFLEX CLASSIC 110 5x1mm²; Quittieren

Not- Halt Taster
Taster Quittieren

## Schutztüren Prozezesskammer

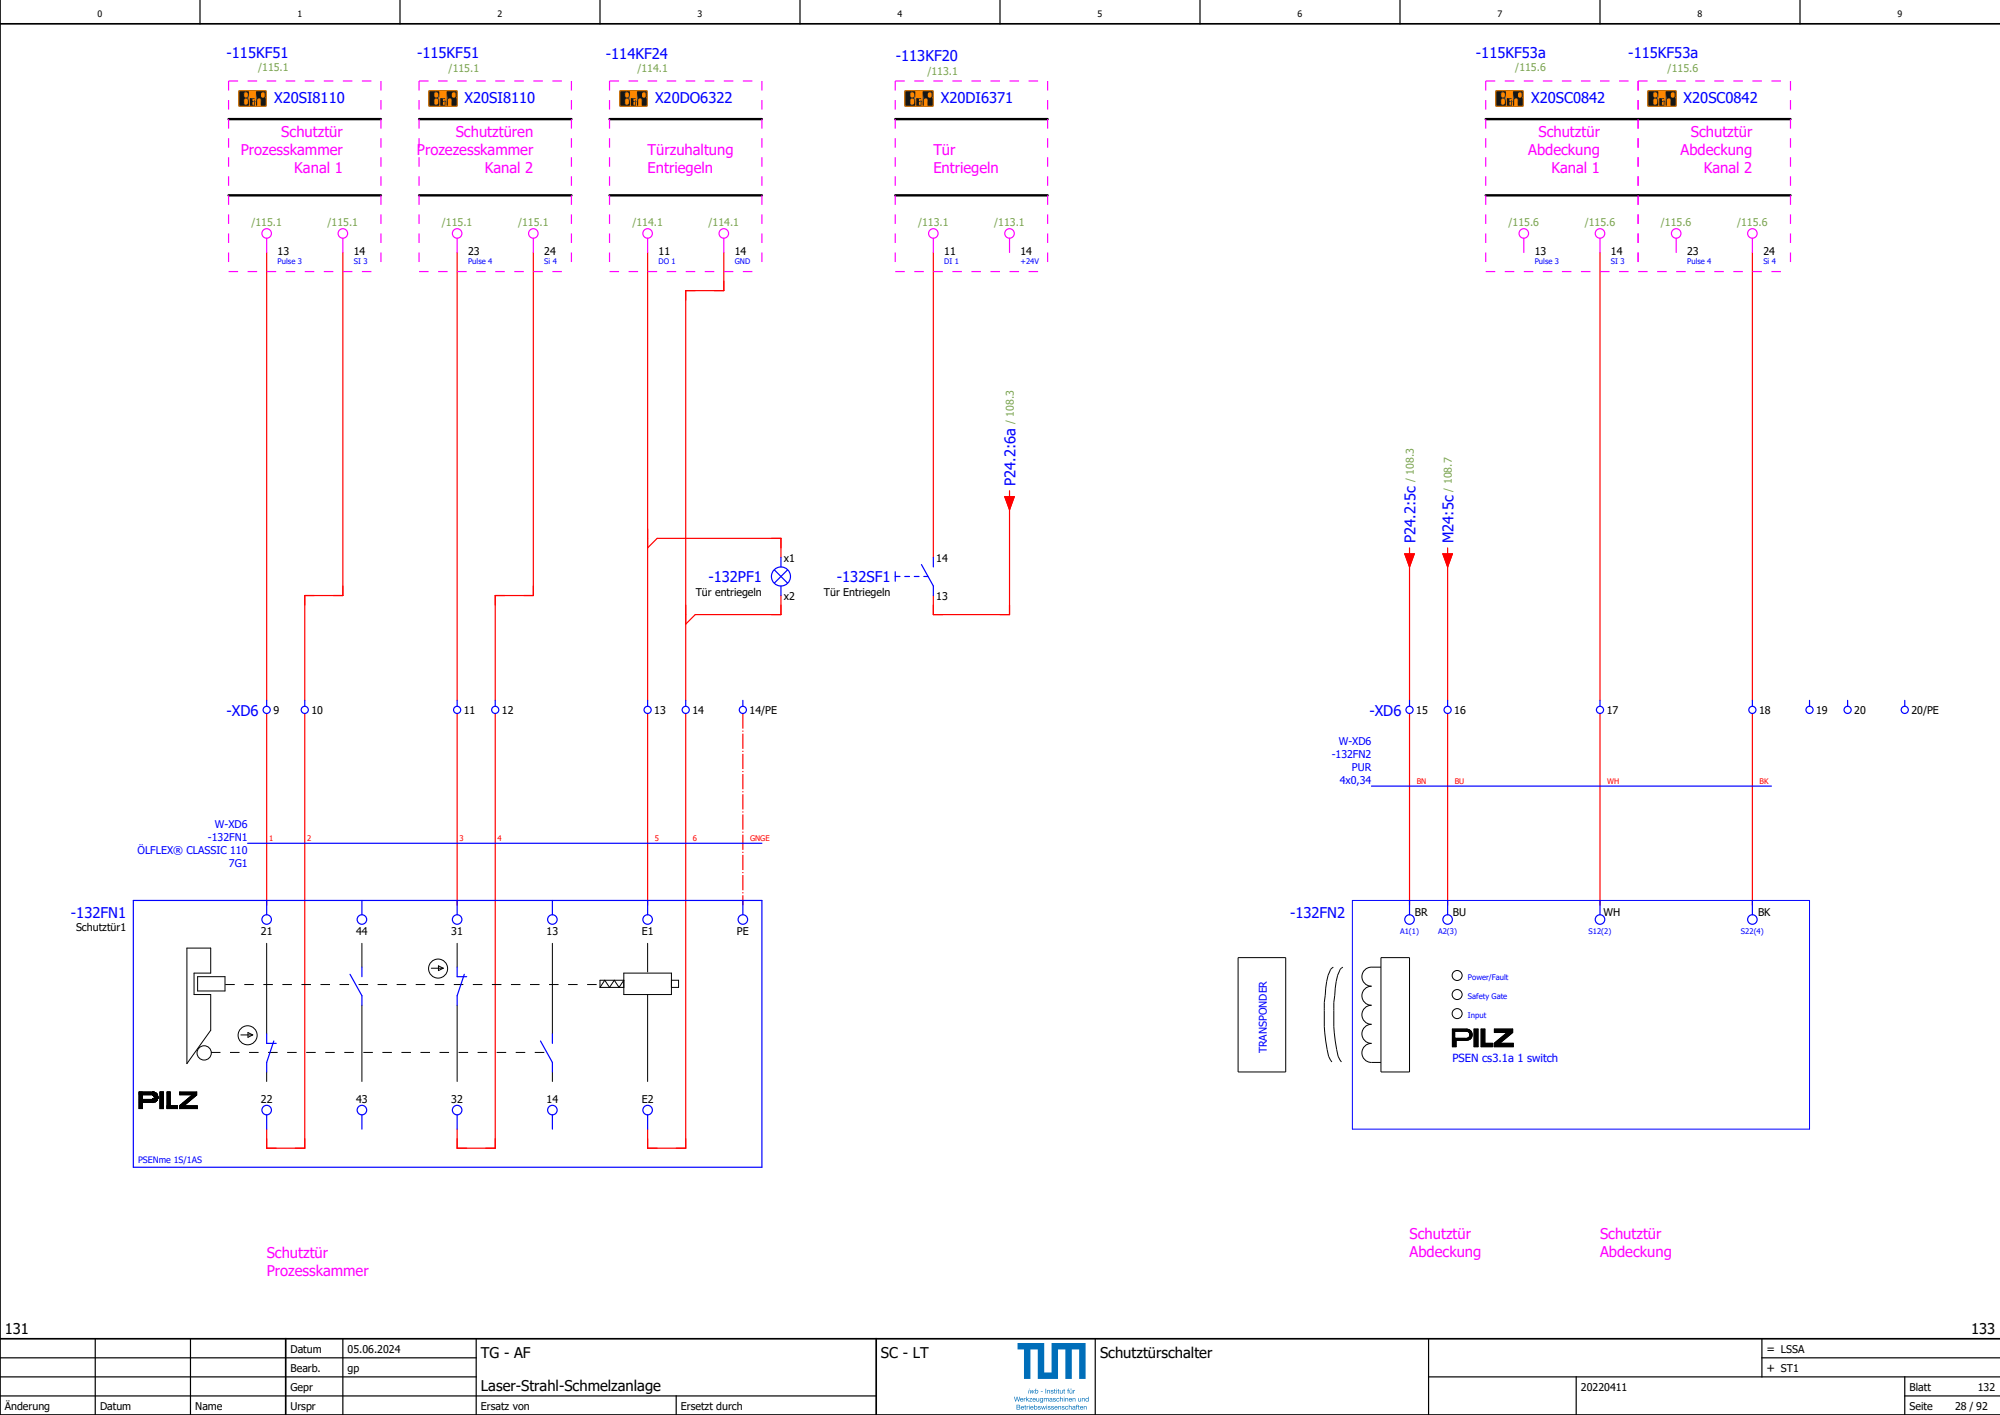
[picture p23: page 28]
Schutztürschalter; Schutztür Prozesskammer; Schutztür1; PSENme 1S/1AS; Schutztür Abdeckung; Kanal 2; Pulse 4; Schutztür Prozesskammer Kanal 1; Pulse 3; Türzuhaltung Entriegeln; GND; Schutztür Abdeckung Kanal 2; Schutztür Abdeckung Kanal 1; TRANSPONDER; Power/Fault; Input; Safety Gate; Tür Entriegeln; W-XD6 -132FN1 ÖLFLEX® CLASSIC 110 7G1; GNGE; PUR; PSEN cs3.1a 1 switch; Tür entriegeln

## Ampel ROT

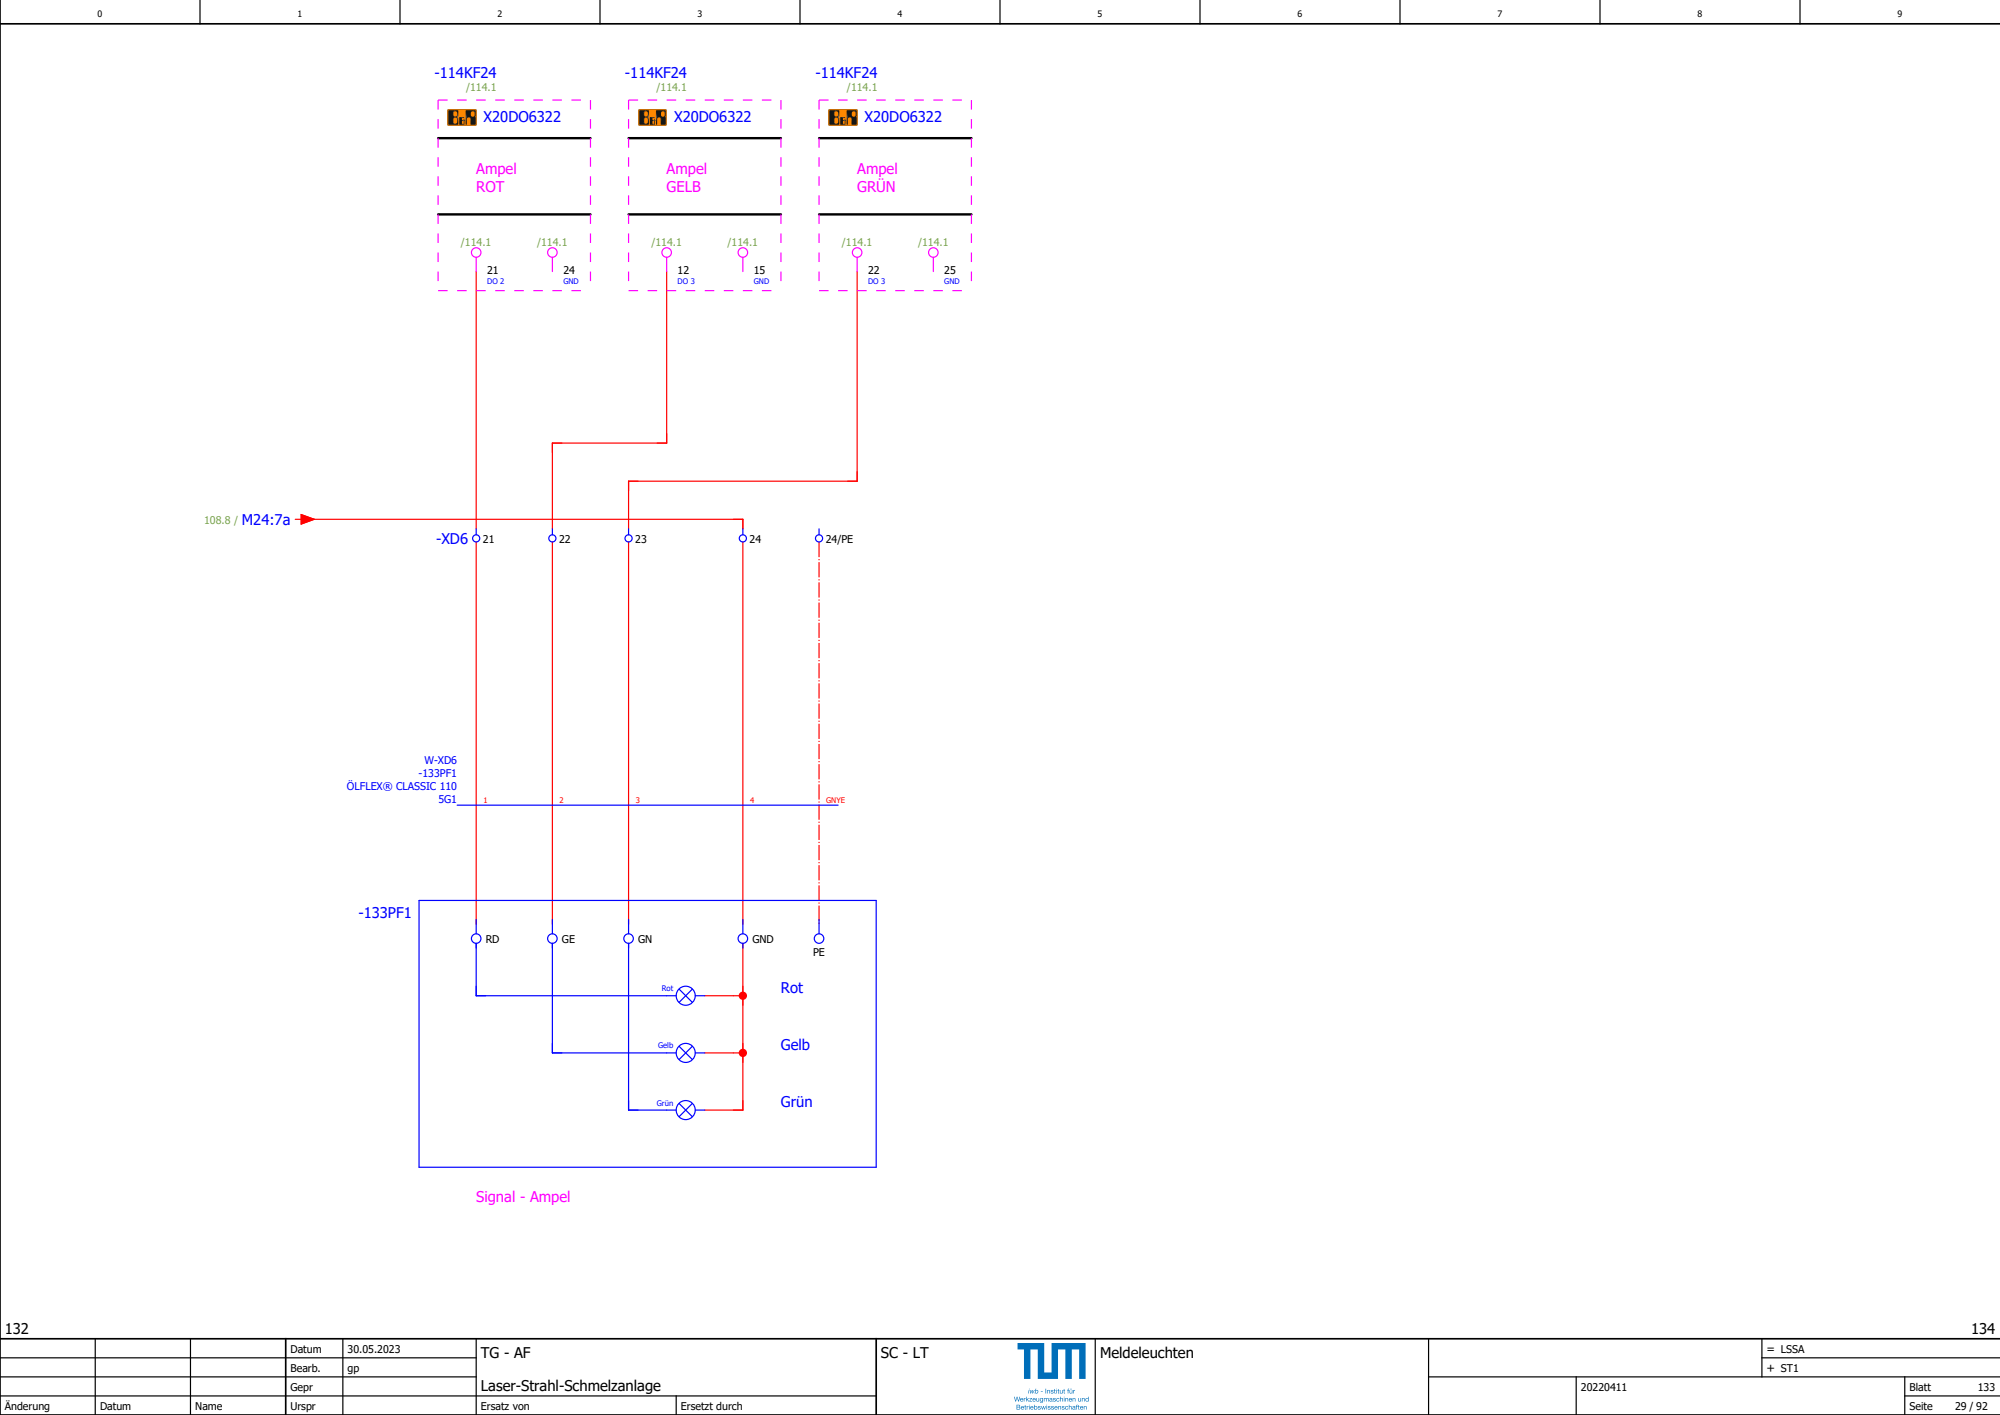
[picture p24: page 29]
Meldeleuchten; Signal - Ampel; Rot; Gelb; Grün; GND; Ampel GELB; Ampel GRÜN; ÖLFLEX® CLASSIC 110; GNYE

## Not-Halt von Zelle

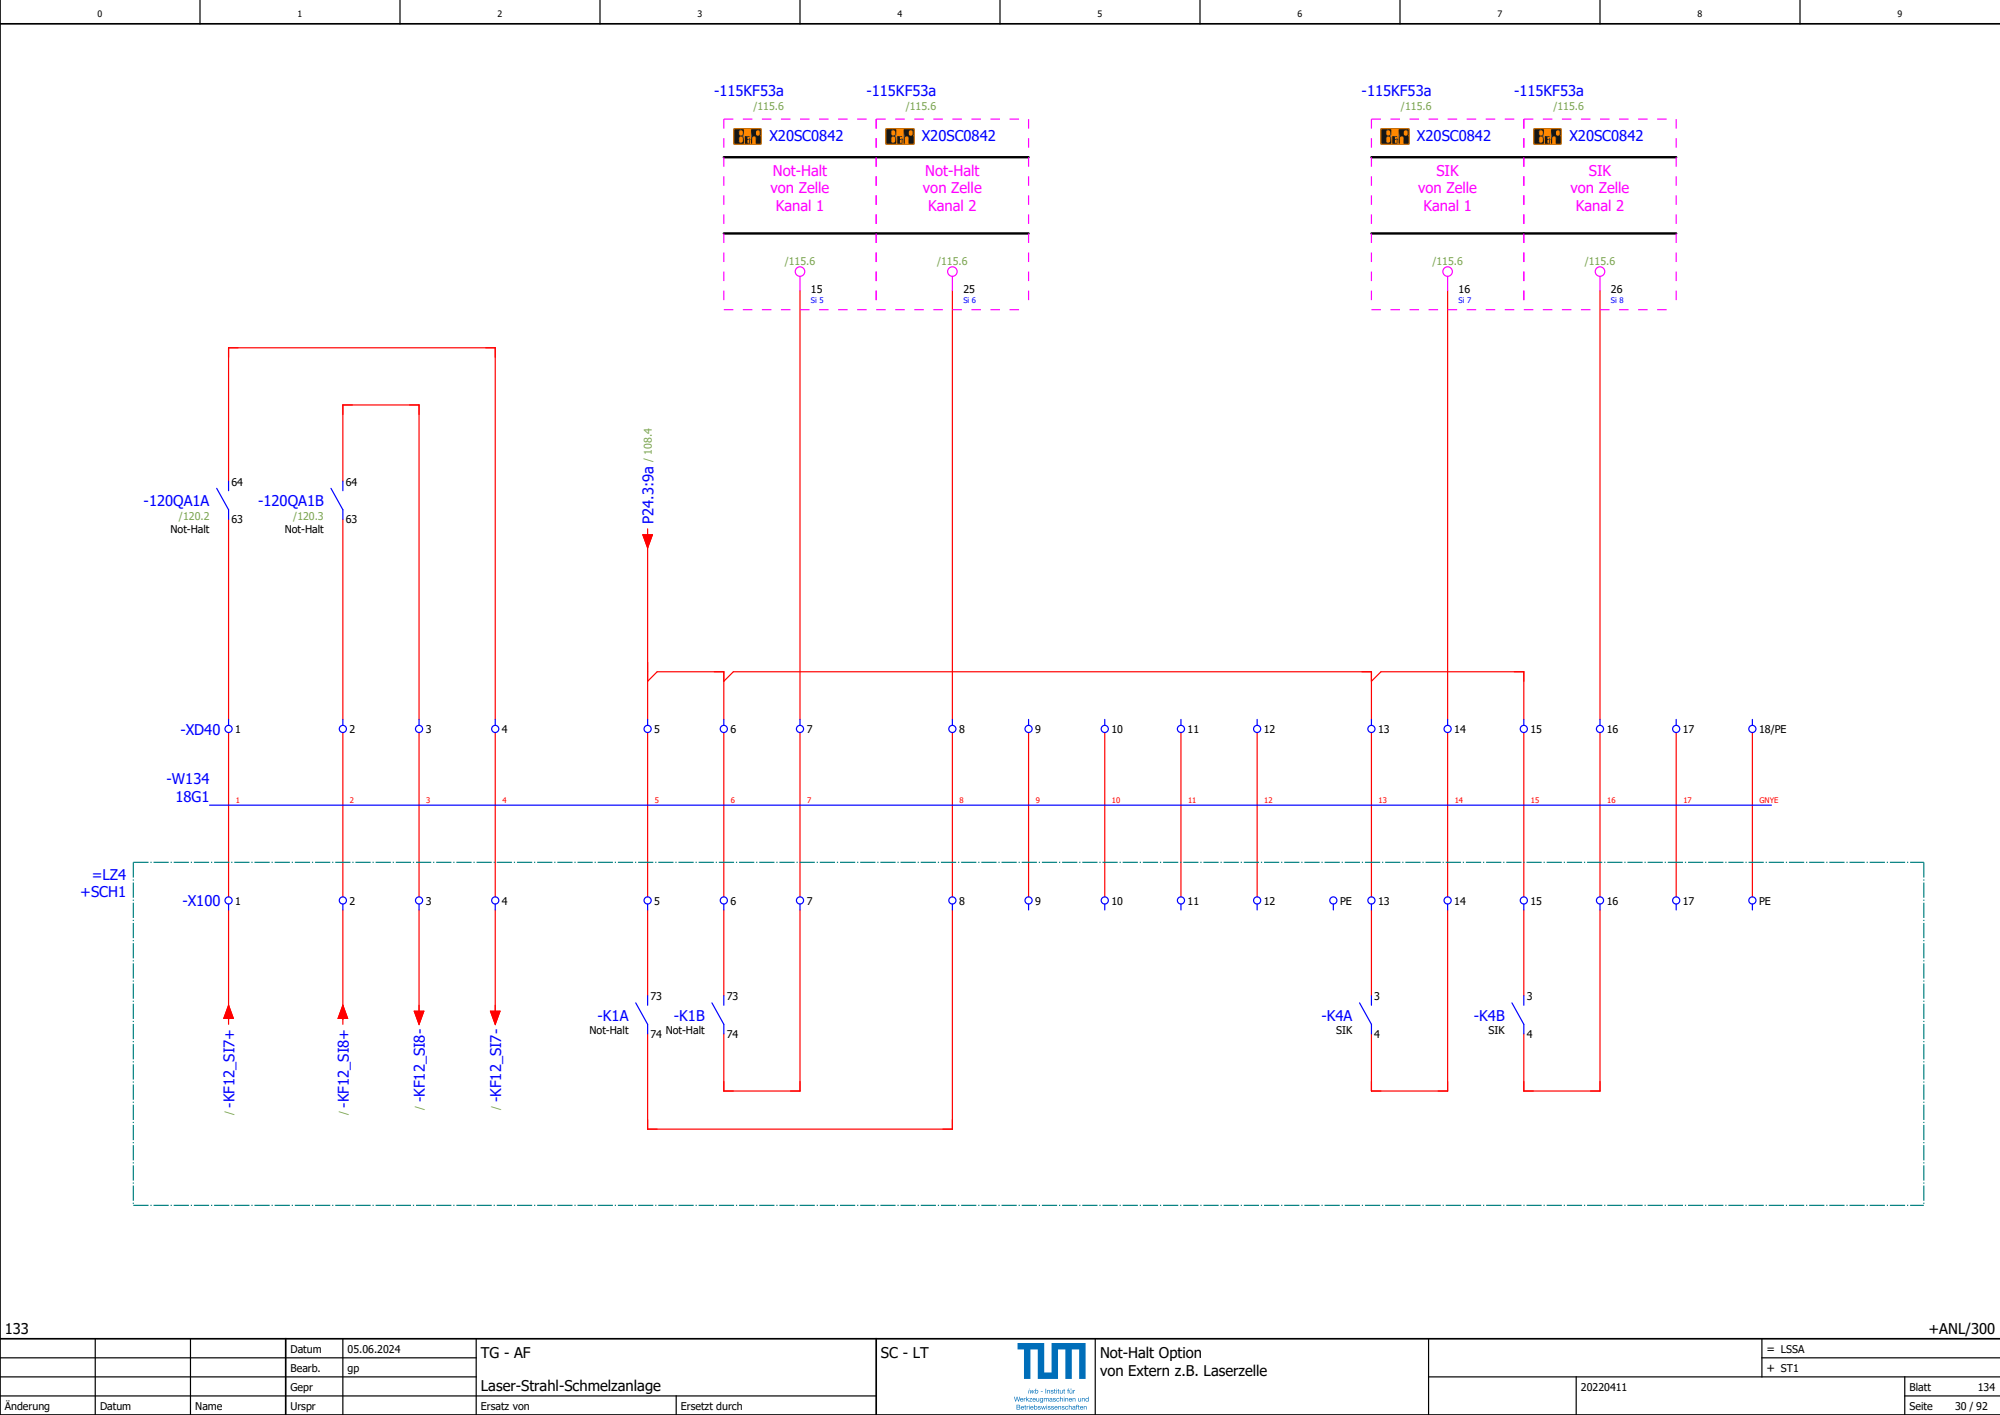
[picture p25: page 30]
+ANL/300; Kanal 1; Not-Halt von Zelle Kanal 2; SIK von Zelle Kanal 1; SIK von Zelle Kanal 2; +SCH1; /120.2 Not-Halt; /120.3 Not-Halt; Not-Halt; SIK; GNYE -KF12_SI7+ /

Not-Halt Option
von Extern z.B. Laserzelle

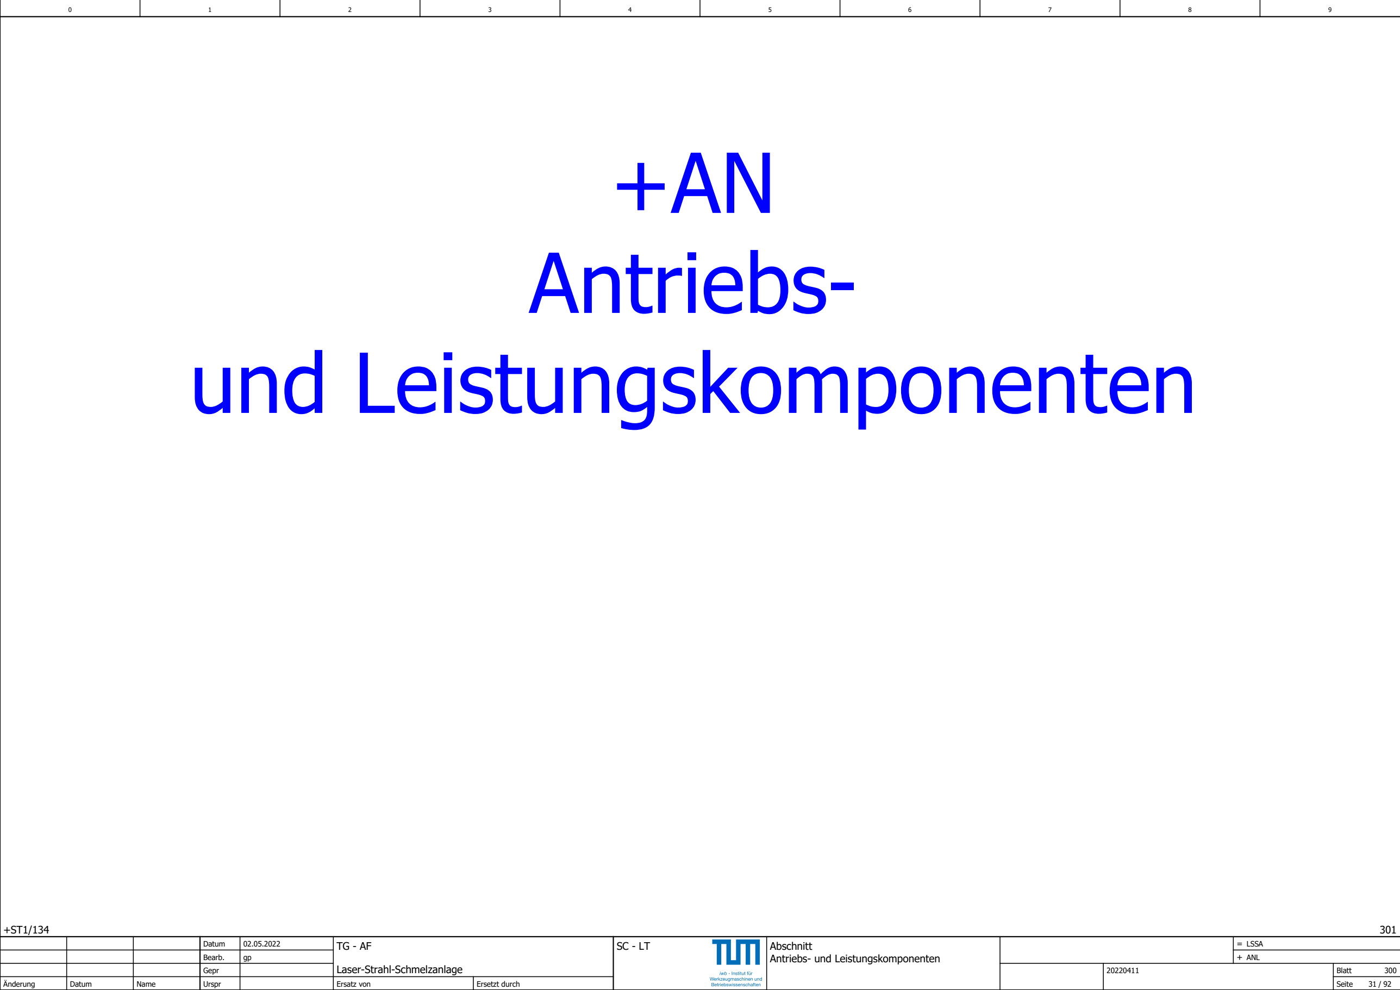
[picture p26: figure]
ANL; Abschnitt Antriebs- und Leistungskomponenten; +AN Antriebs- und Leistungskomponenten

## Enable Achse 1&2

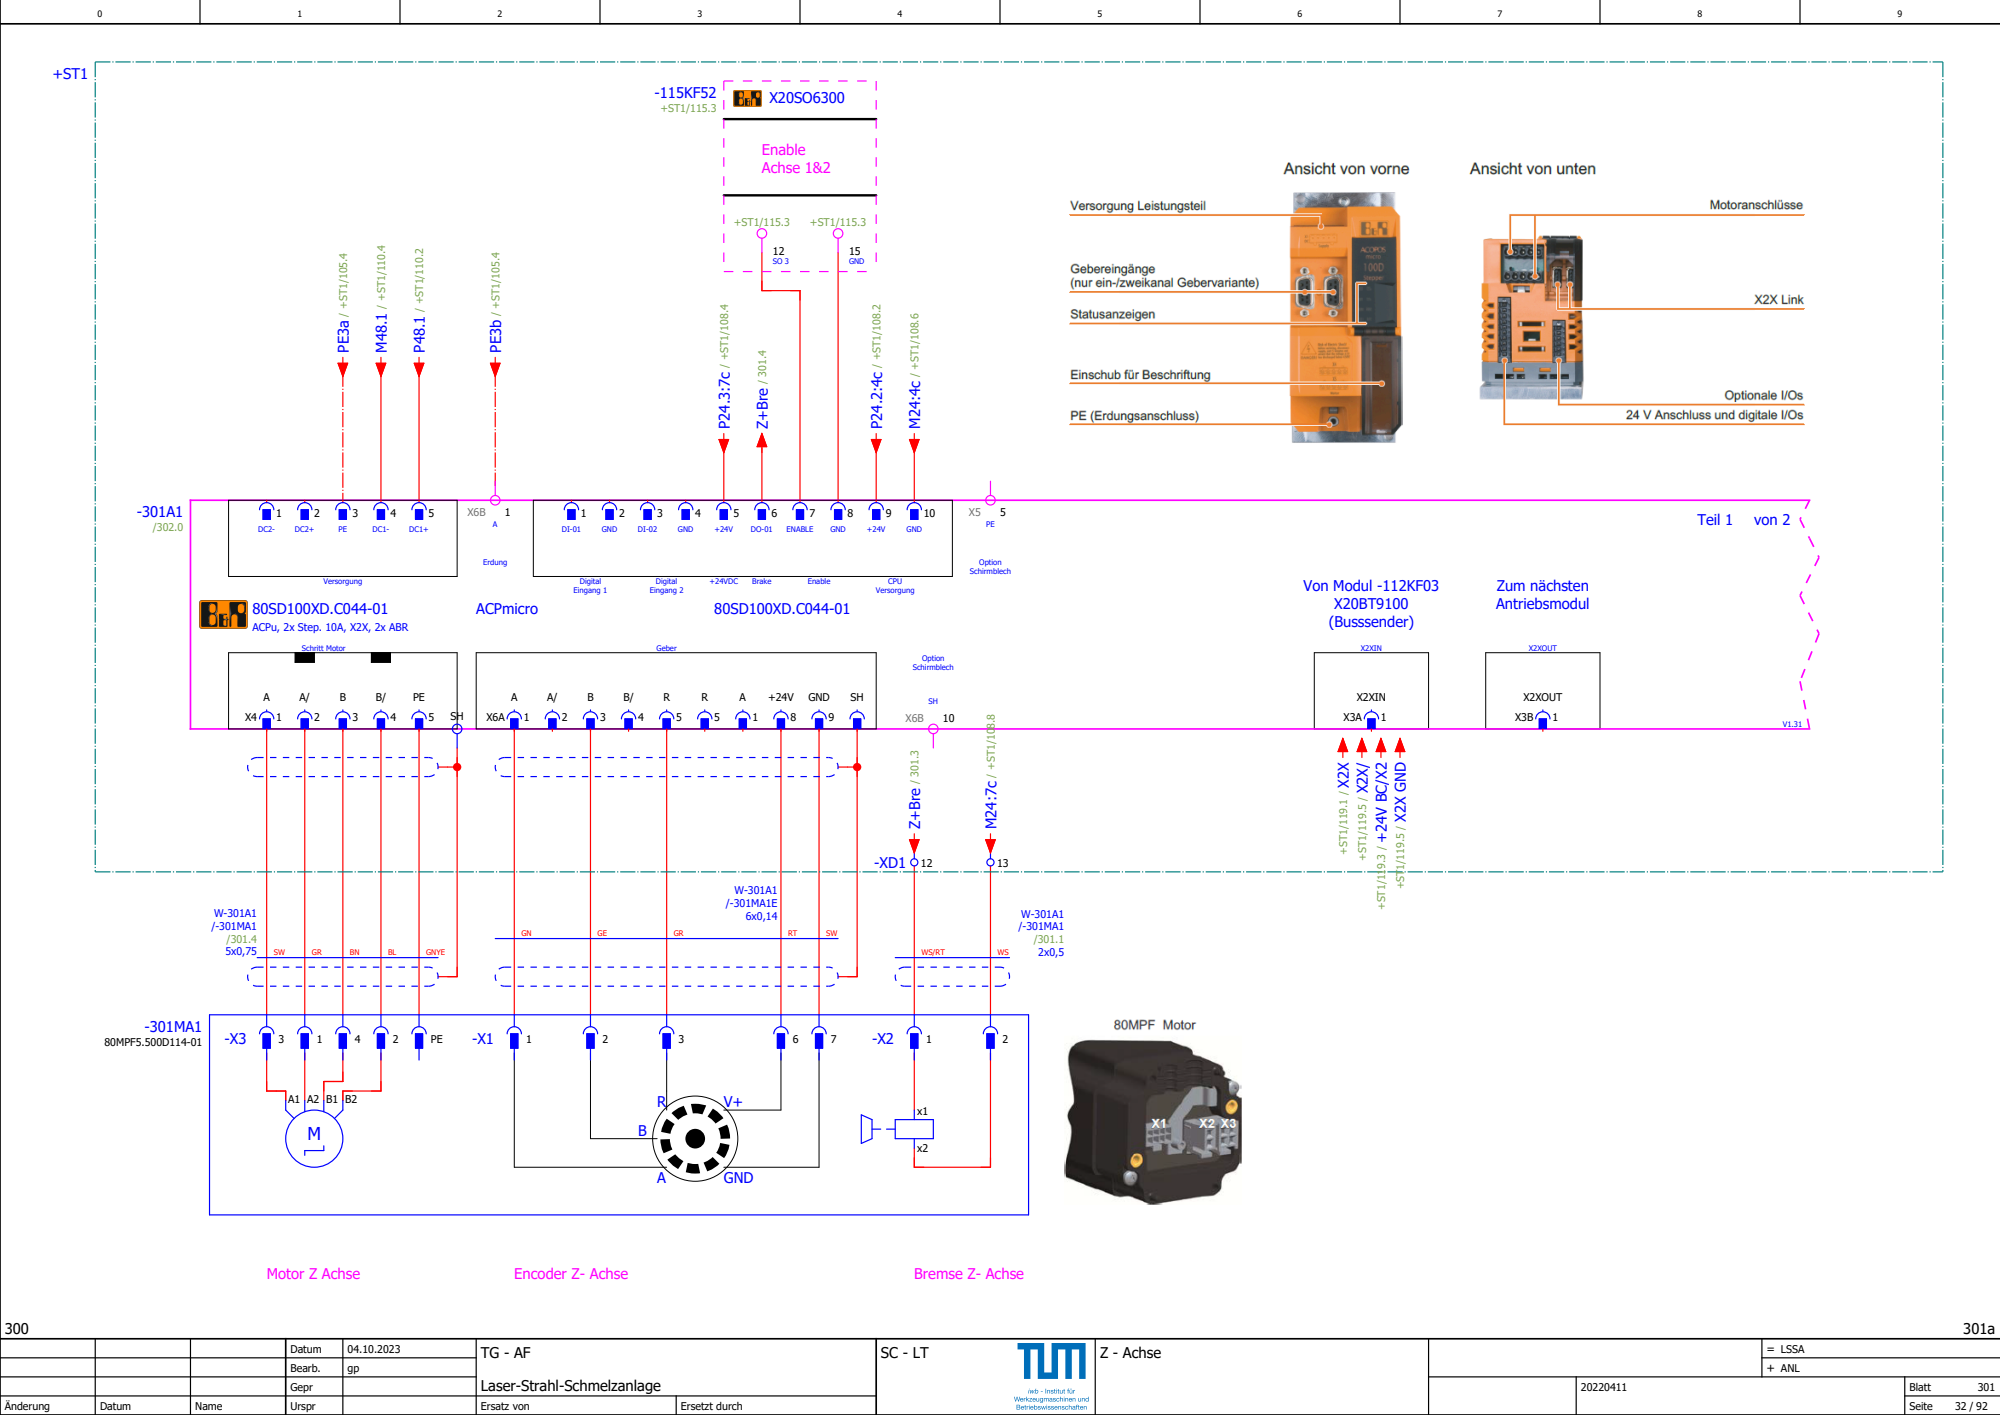
[picture p27: page 32]
ANL; Z - Achse; GND; Von Modul -112KF03 X20BT9100 (Busssender); Zum nächsten Antriebsmodul; Motor Z Achse; Encoder Z- Achse; Bremse Z- Achse; Teil 1; von 2; Versorgung; Digital; Eingang 1; +24VDC; Eingang 2; Brake; Enable; CPU; Option Schirmblech; Erdung; Schritt Motor; Geber; X2XIN; X2XOUT; ACPmicro; ENABLE; 80MPF5.500D114-01; GNYE; Z+Bre / 301.4; Z+Bre / 301.3; X2X GND / +ST1/119.5

ACPu, 2x Step. 10A, X2X, 2x ABR

-116KF61

+ST1

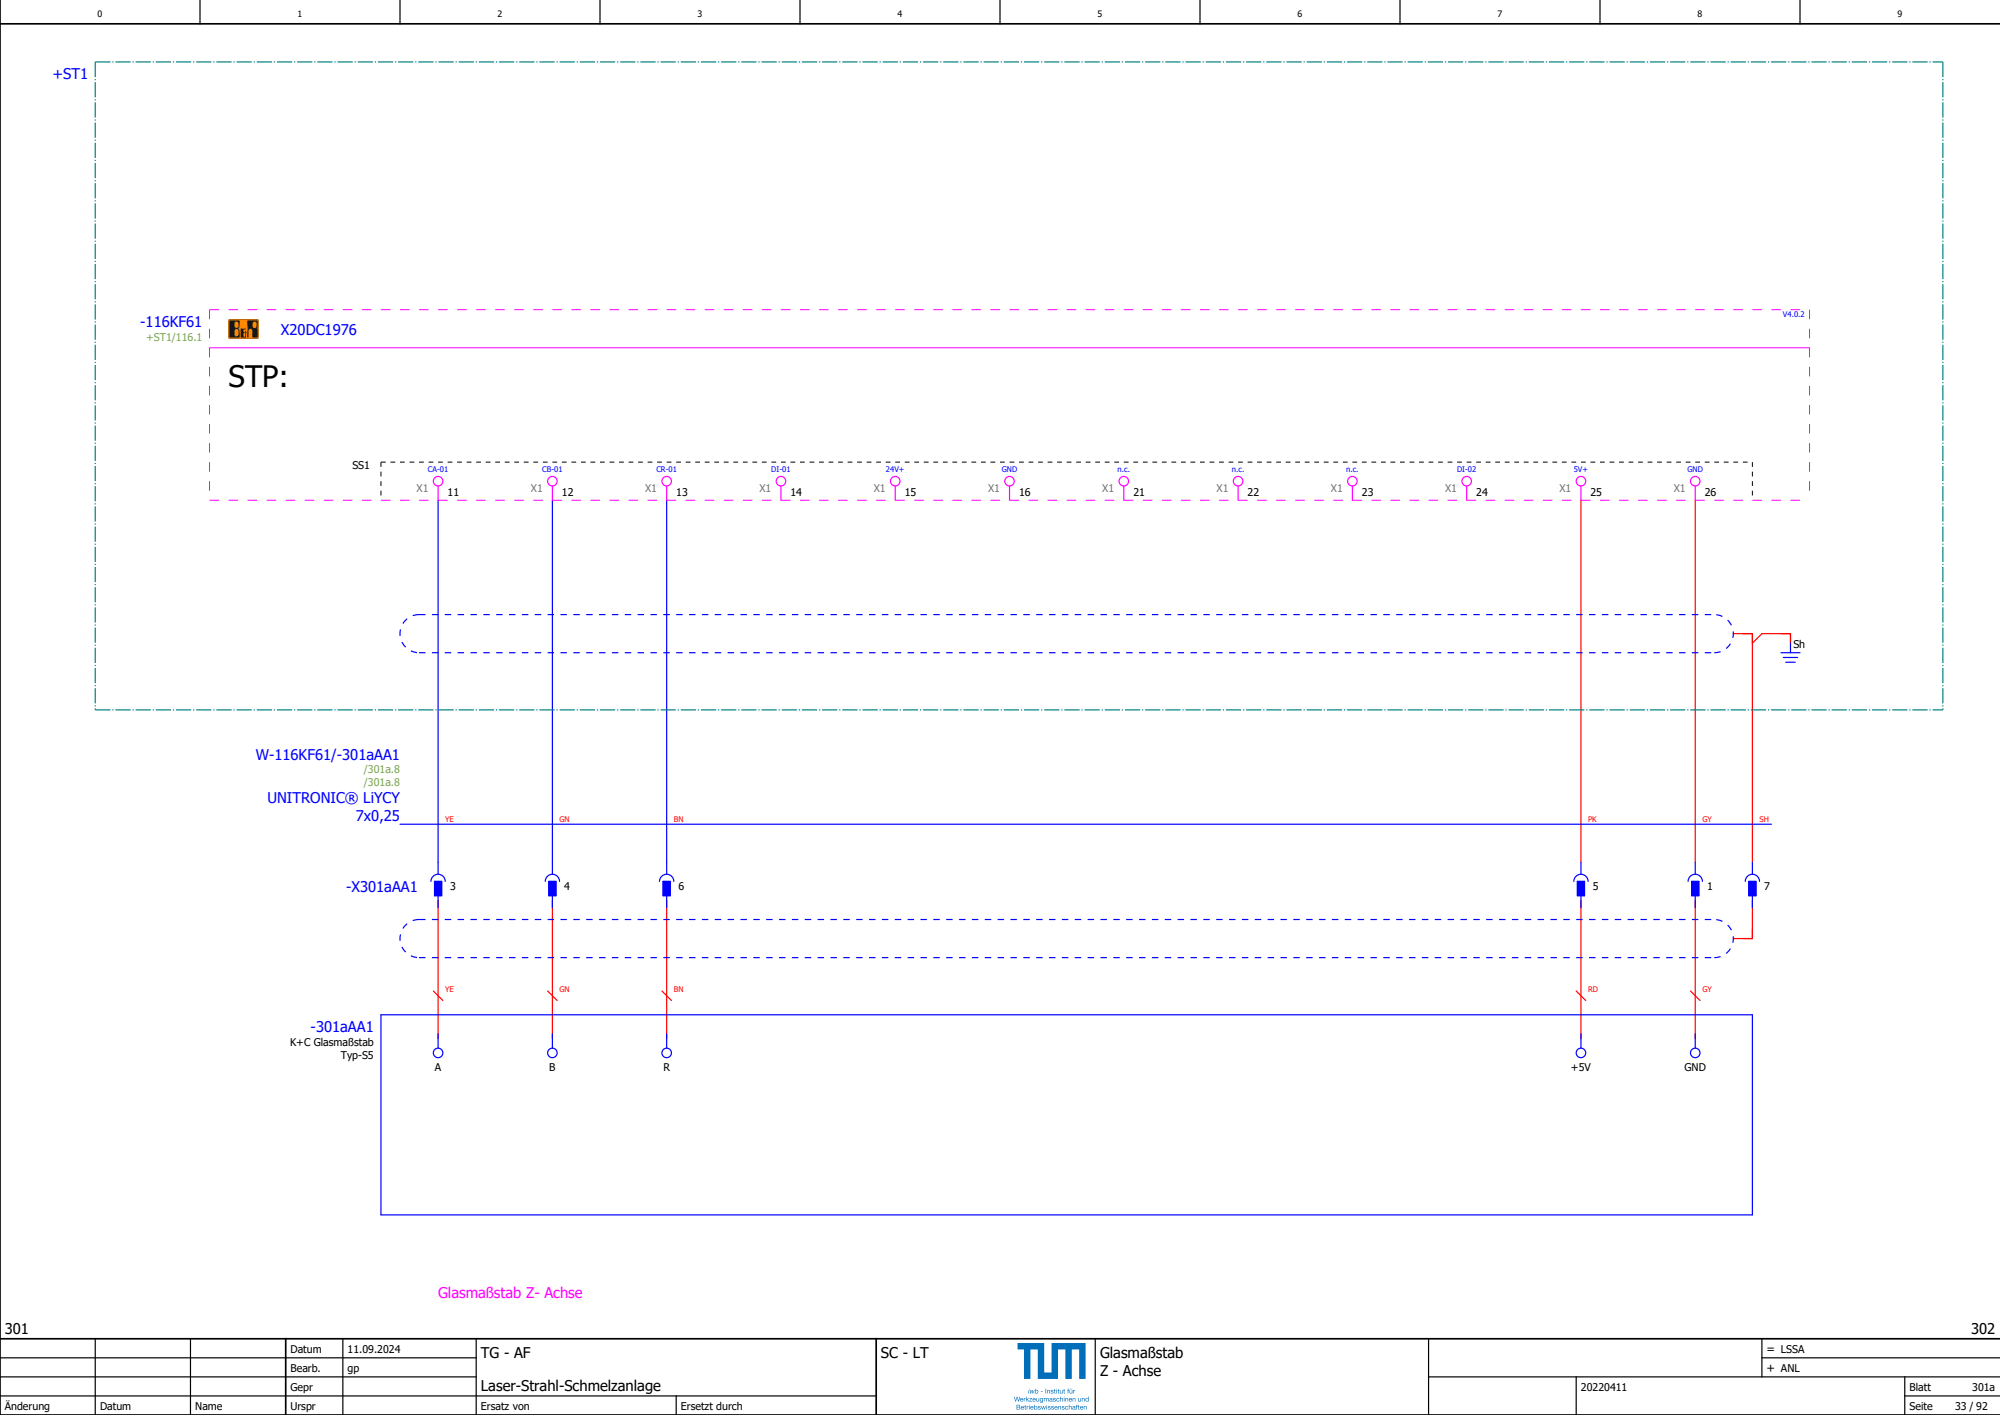
[picture p28: page 33]
ANL; Glasmaßstab Z - Achse; GND; STP:; Glasmaßstab Z- Achse; -301aAA1; K+C Glasmaßstab Typ-S5; UNITRONIC® LiYCY; W-116KF61/-301aAA1; -X301aAA1

+ST1

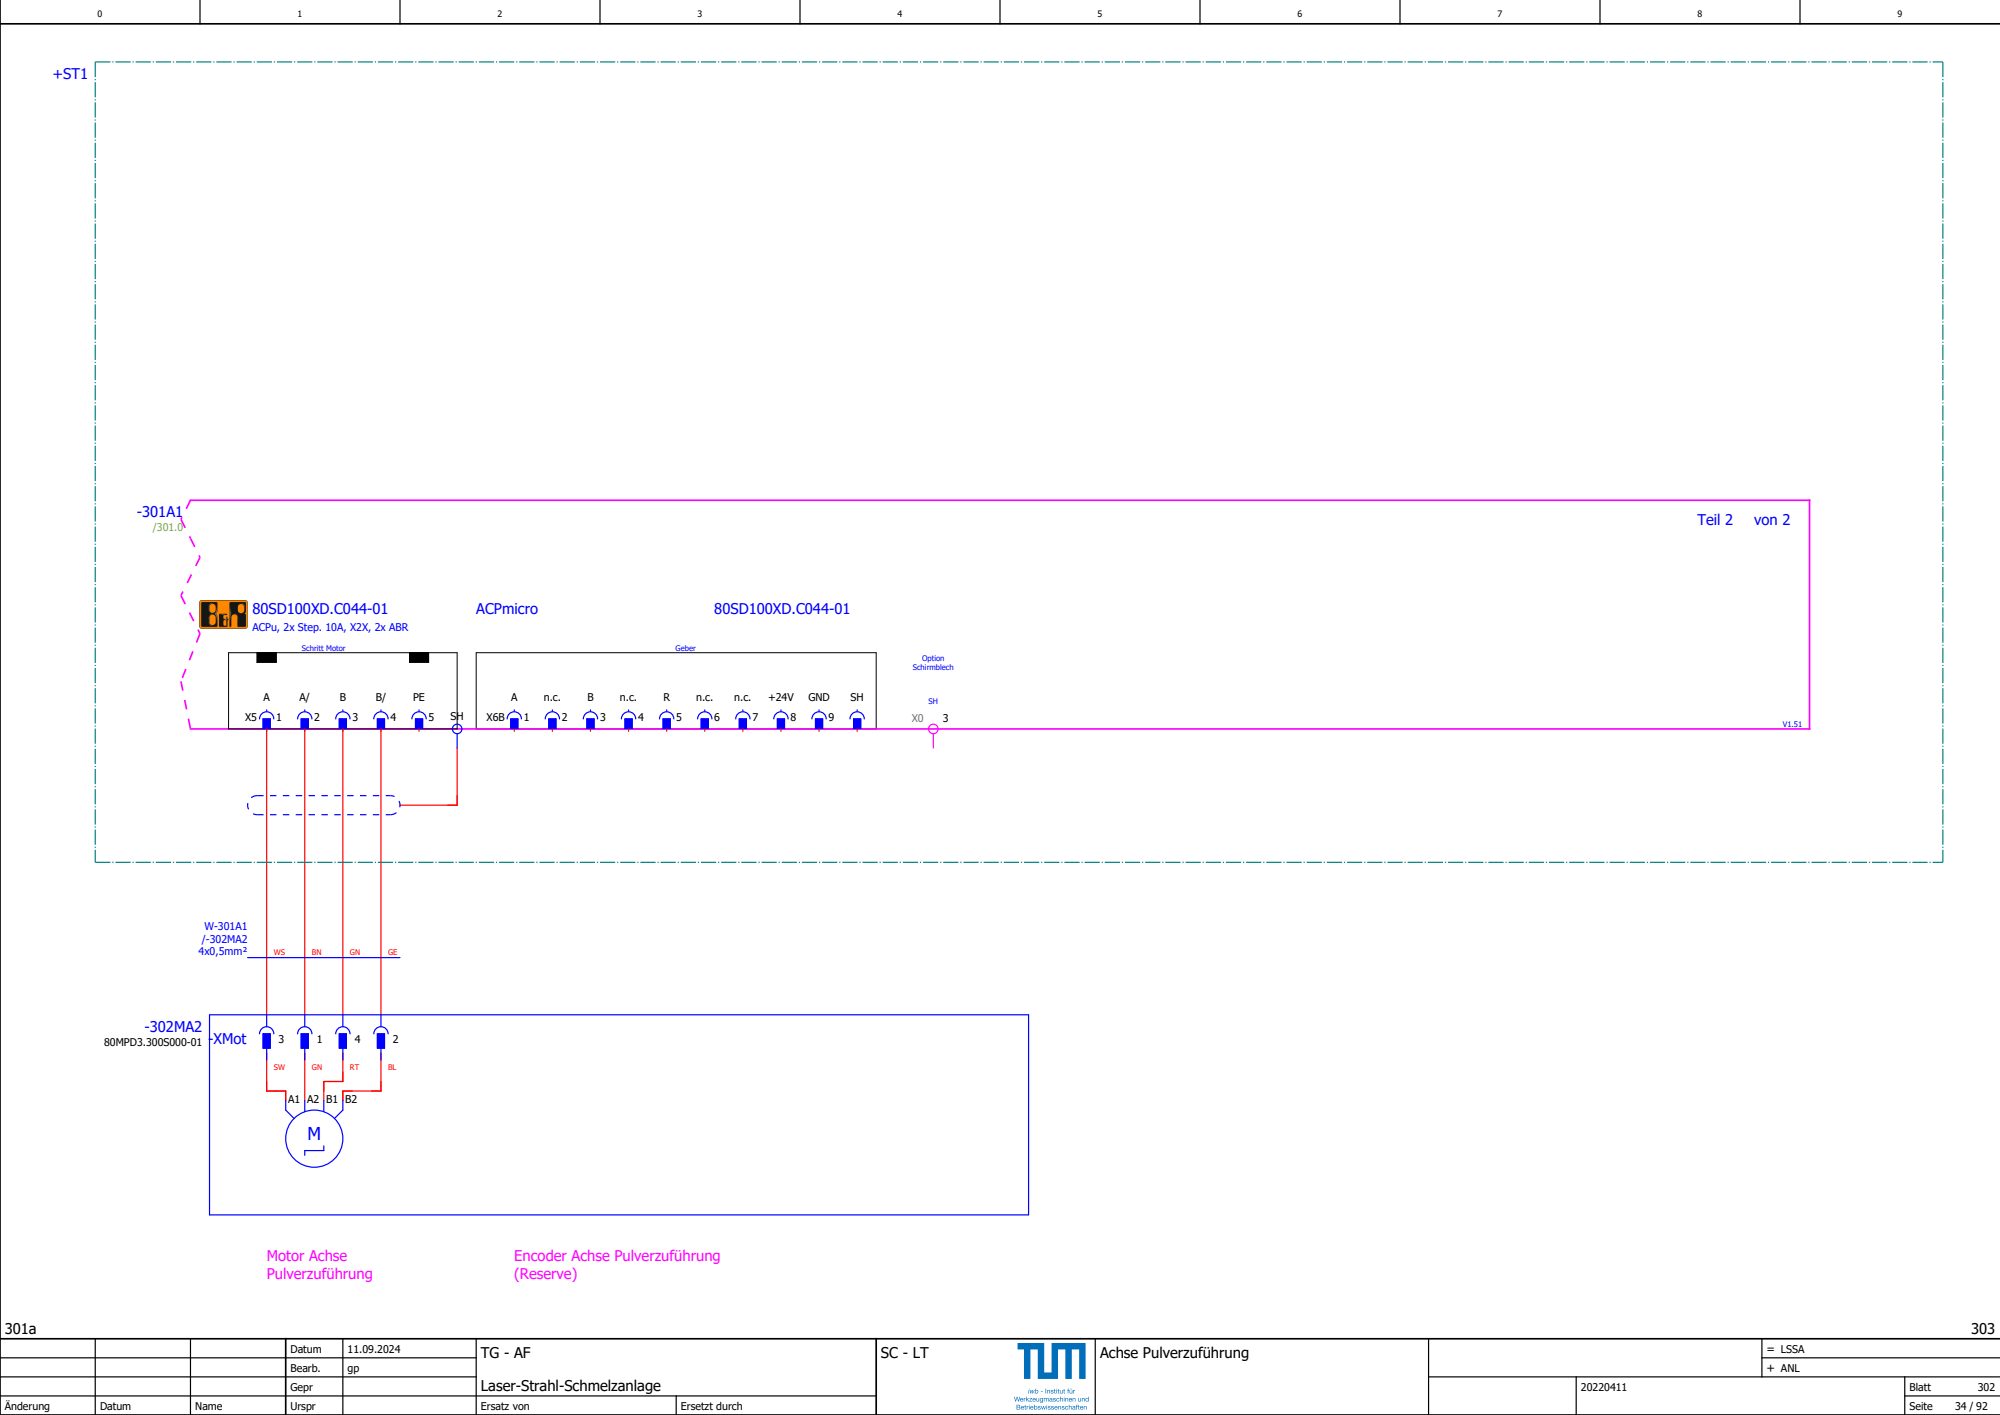
[picture p29: page 34]
ANL; Achse Pulverzuführung; Teil 2; von 2; Schritt Motor; Geber; Option Schirmblech; ACPmicro; GND; Motor Achse Pulverzuführung; 80MPD3.300S000-01 -XMot; 4x0,5mm²

ACPu, 2x Step. 10A, X2X, 2x ABR

Encoder Achse Pulverzuführung
(Reserve)

## Enable Achse 3&4

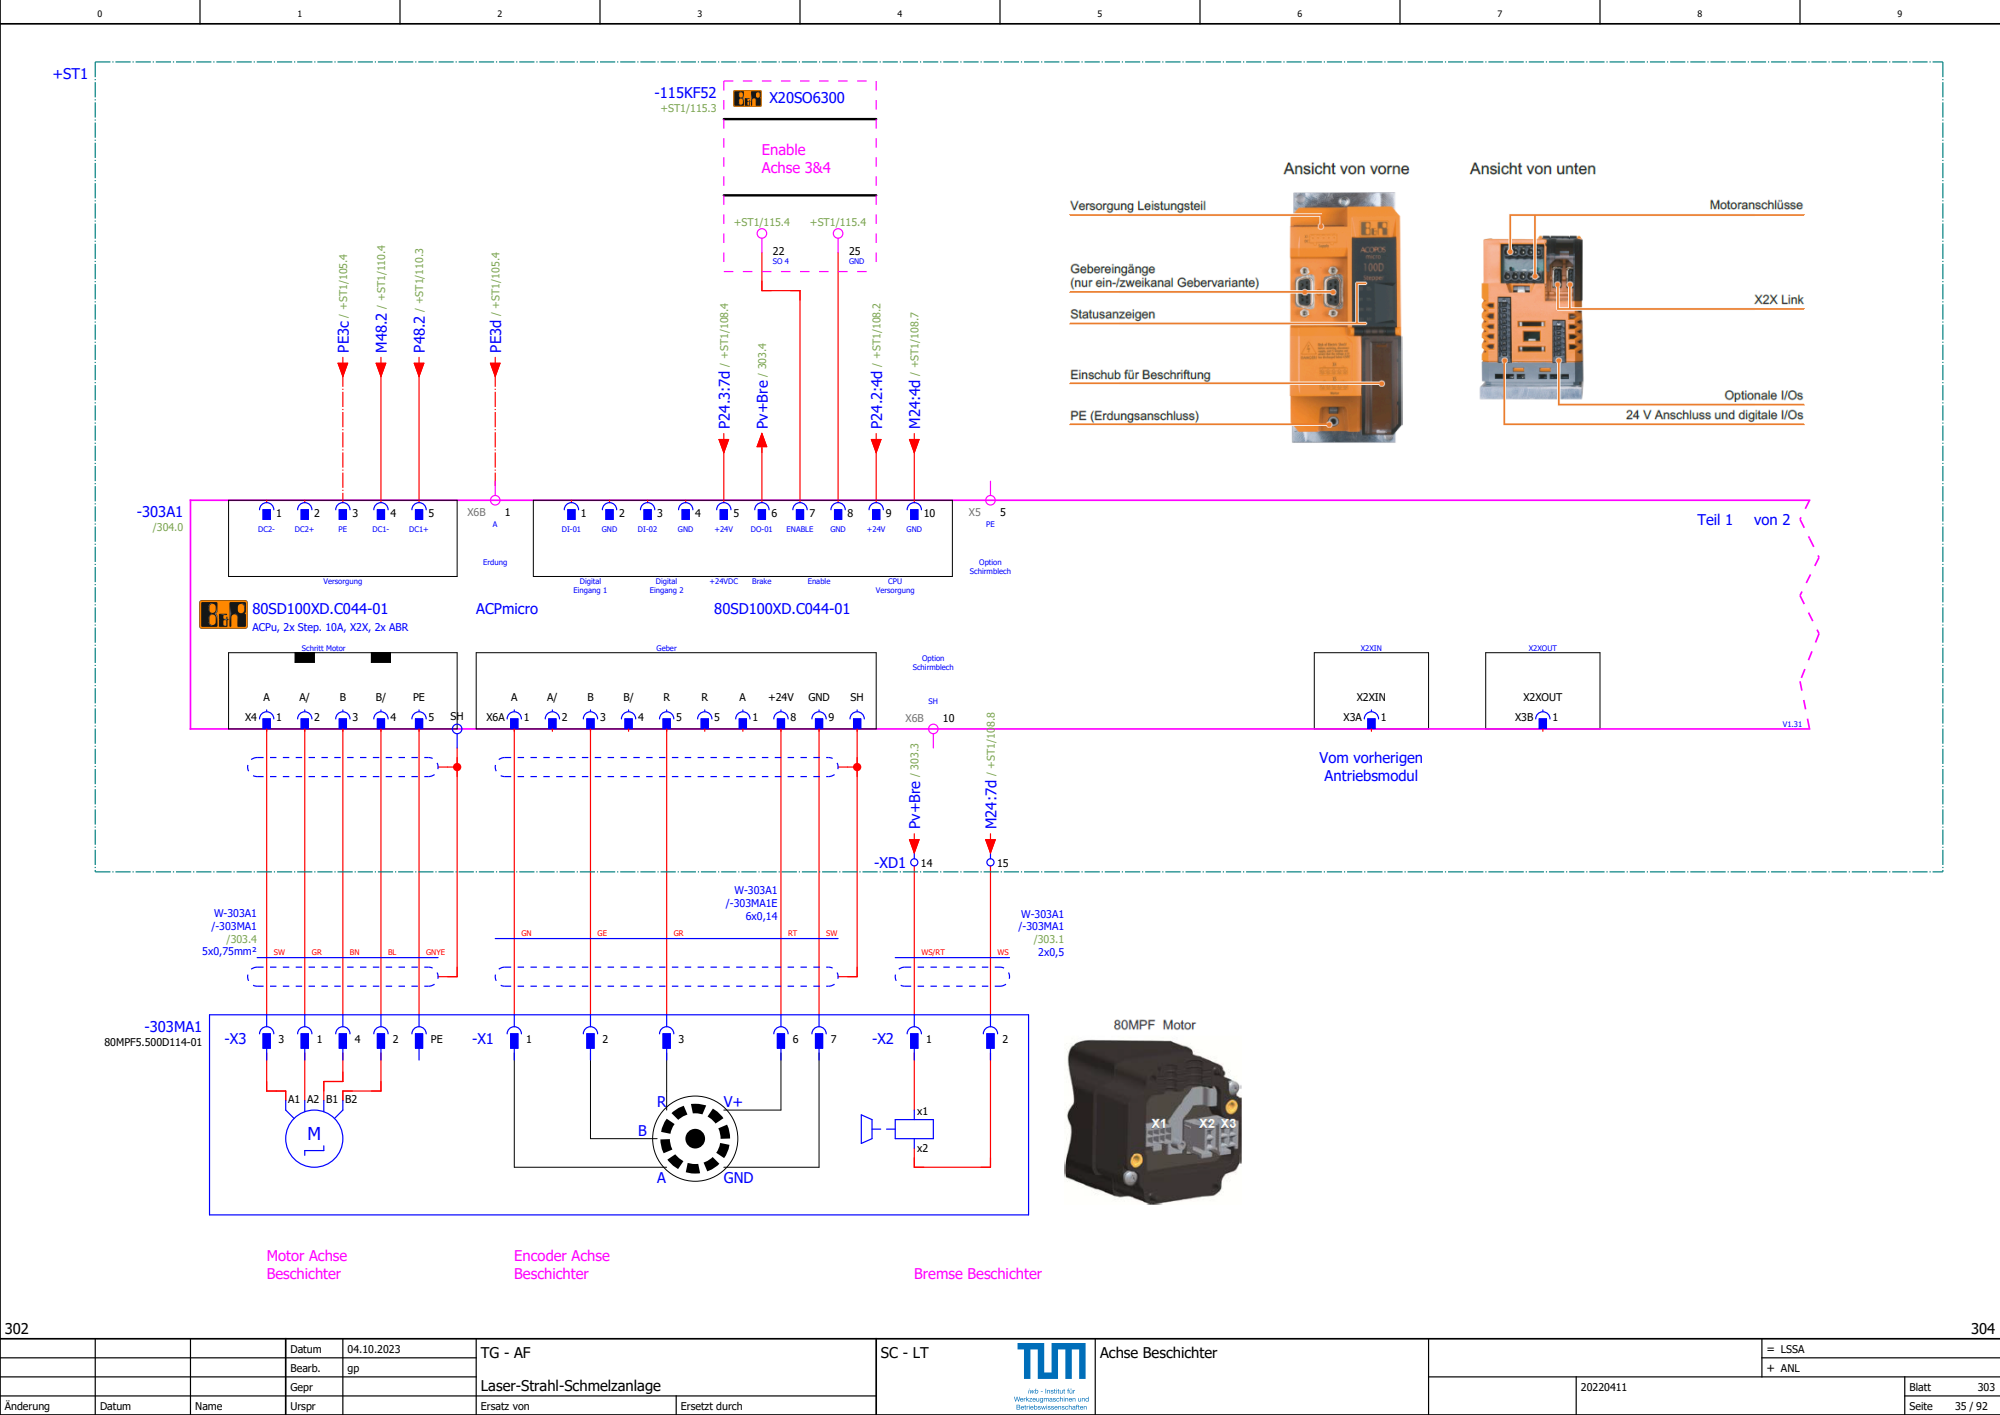
[picture p30: page 35]
ANL; Achse Beschichter; GND; Vom vorherigen Antriebsmodul; Motor Achse Beschichter; Encoder Achse Beschichter; Teil 1; von 2; Versorgung; Digital; Eingang 1; +24VDC; Eingang 2; Brake; Enable; CPU; Option Schirmblech; Erdung; Schritt Motor; Geber; X2XIN; X2XOUT; ACPmicro; ENABLE; Bremse Beschichter; 80MPF5.500D114-01; 5x0,75mm²; GNYE; Pv+Bre / 303.3; Pv+Bre / 303.4

ACPu, 2x Step. 10A, X2X, 2x ABR

+ST1

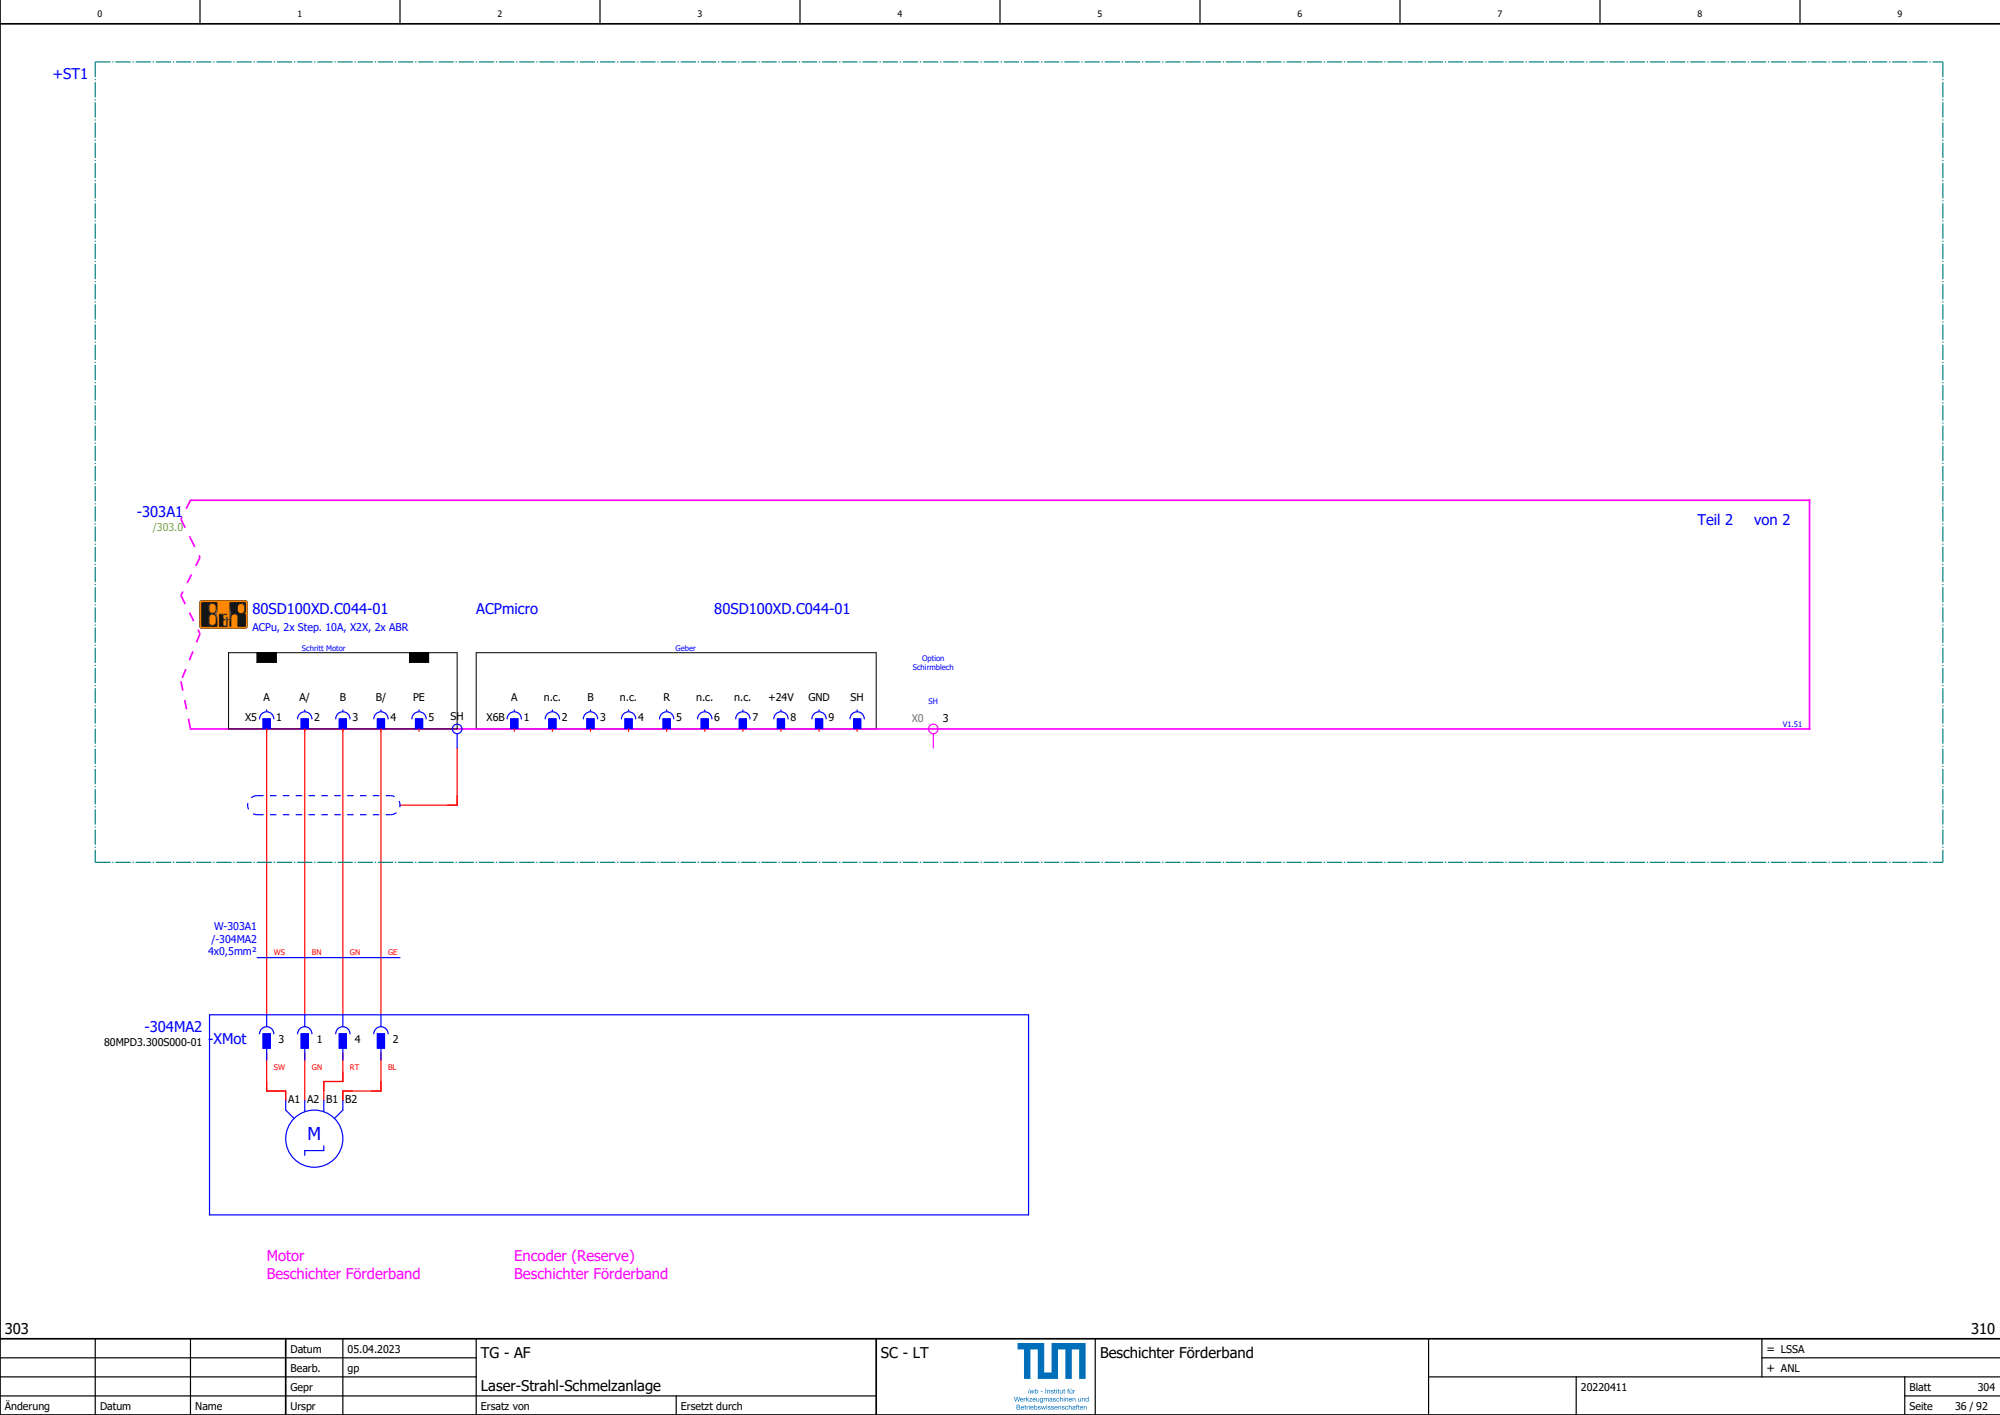
[picture p31: page 36]
ANL; Beschichter Förderband; Teil 2; von 2; Schritt Motor; Geber; Option Schirmblech; ACPmicro; GND; Motor Beschichter Förderband; Encoder (Reserve) Beschichter Förderband; 80MPD3.300S000-01 -XMot; 4x0,5mm²

ACPu, 2x Step. 10A, X2X, 2x ABR

## Umwälzpumpe Gasführung

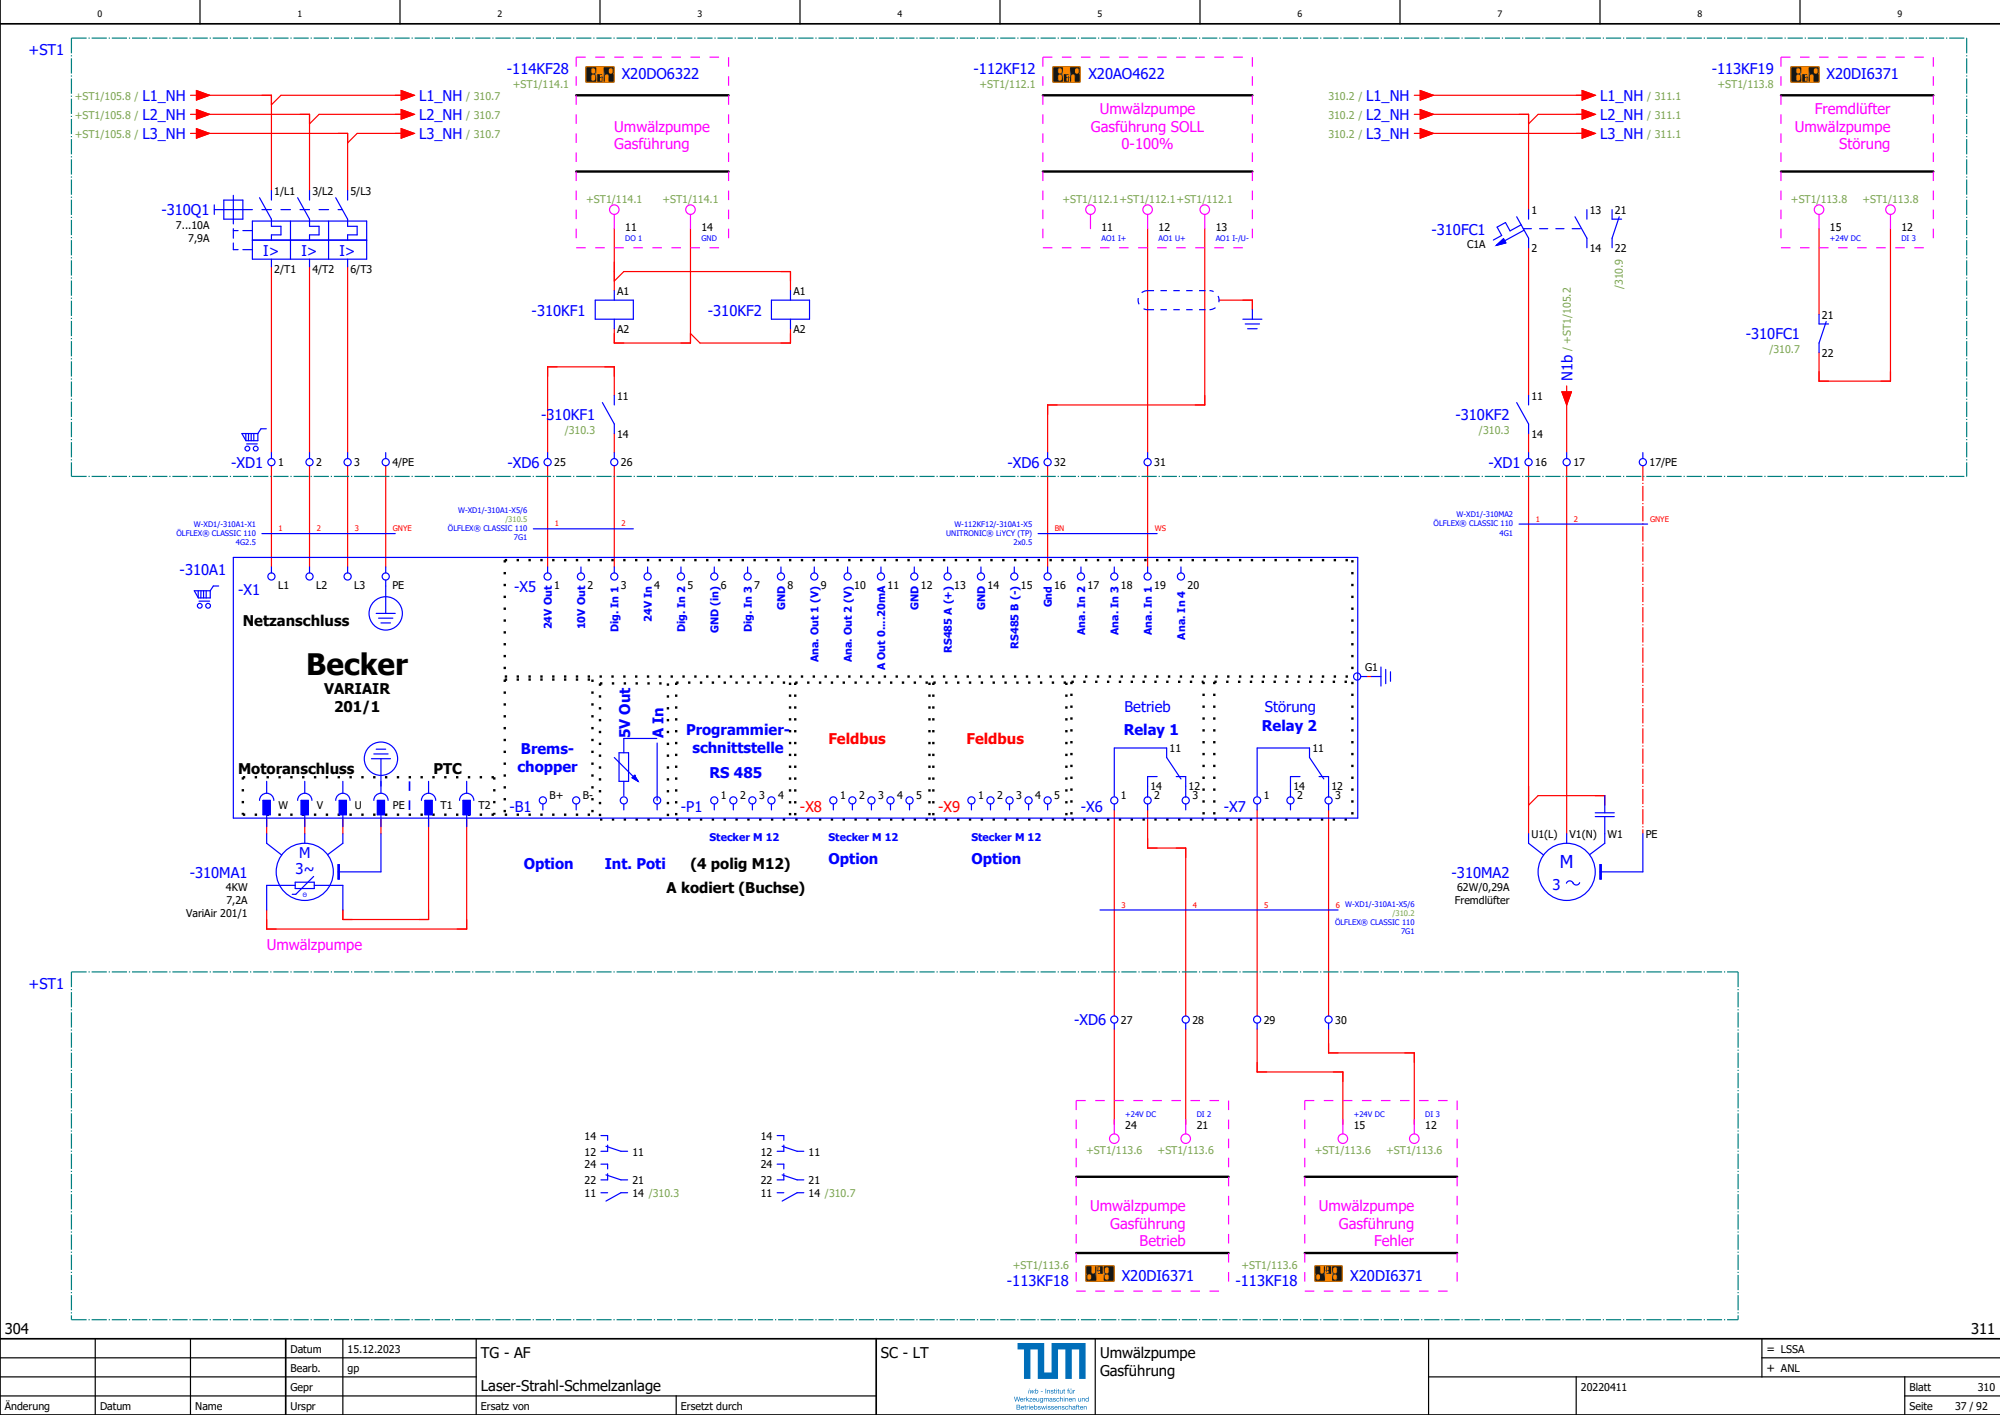
[picture p32: page 37]
ANL; Umwälzpumpe Gasführung; Motoranschluss; PTC; 5V Out; 10V Out; 24V Out; Dig. In 1; GND (in); Dig. In 3; GND; Ana. Out 1 (V); Dig. In 2; A Out 0....20mA; Gnd; Ana. In 2; Option; Int. Poti; Stecker M 12; Option (4 polig M12); A kodiert (Buchse); Ana. Out 2 (V); Ana. In 3; Ana. In 1; Ana. In 4; Umwälzpumpe; Umwälzpumpe Gasführung SOLL 0-100%; Umwälzpumpe Gasführung Betrieb; Umwälzpumpe Gasführung Fehler; Fremdlüfter Umwälzpumpe Störung; 4KW 7,2A VariAir 201/1; ÖLFLEX® CLASSIC 110; GNYE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

UNITRONIC® LiYCY (TP)

Netzanschluss Becker VARIAIR 201/1 | -X5 1 2 3 4 5 6 7 8 9 10 11 12 13 14 15 16 17 18 19 20

Brems-chopper B+ B- | | Programmier-schnittstelle RS 485 1 2 3 4 -P1 | Feldbus 1 2 3 4 5 -X8 | Feldbus 1 2 3 4 5 -X9 | Betrieb Relay 1 -X6 | Störung Relay 2 -X7

## Vakuumpumpe

-114KF28

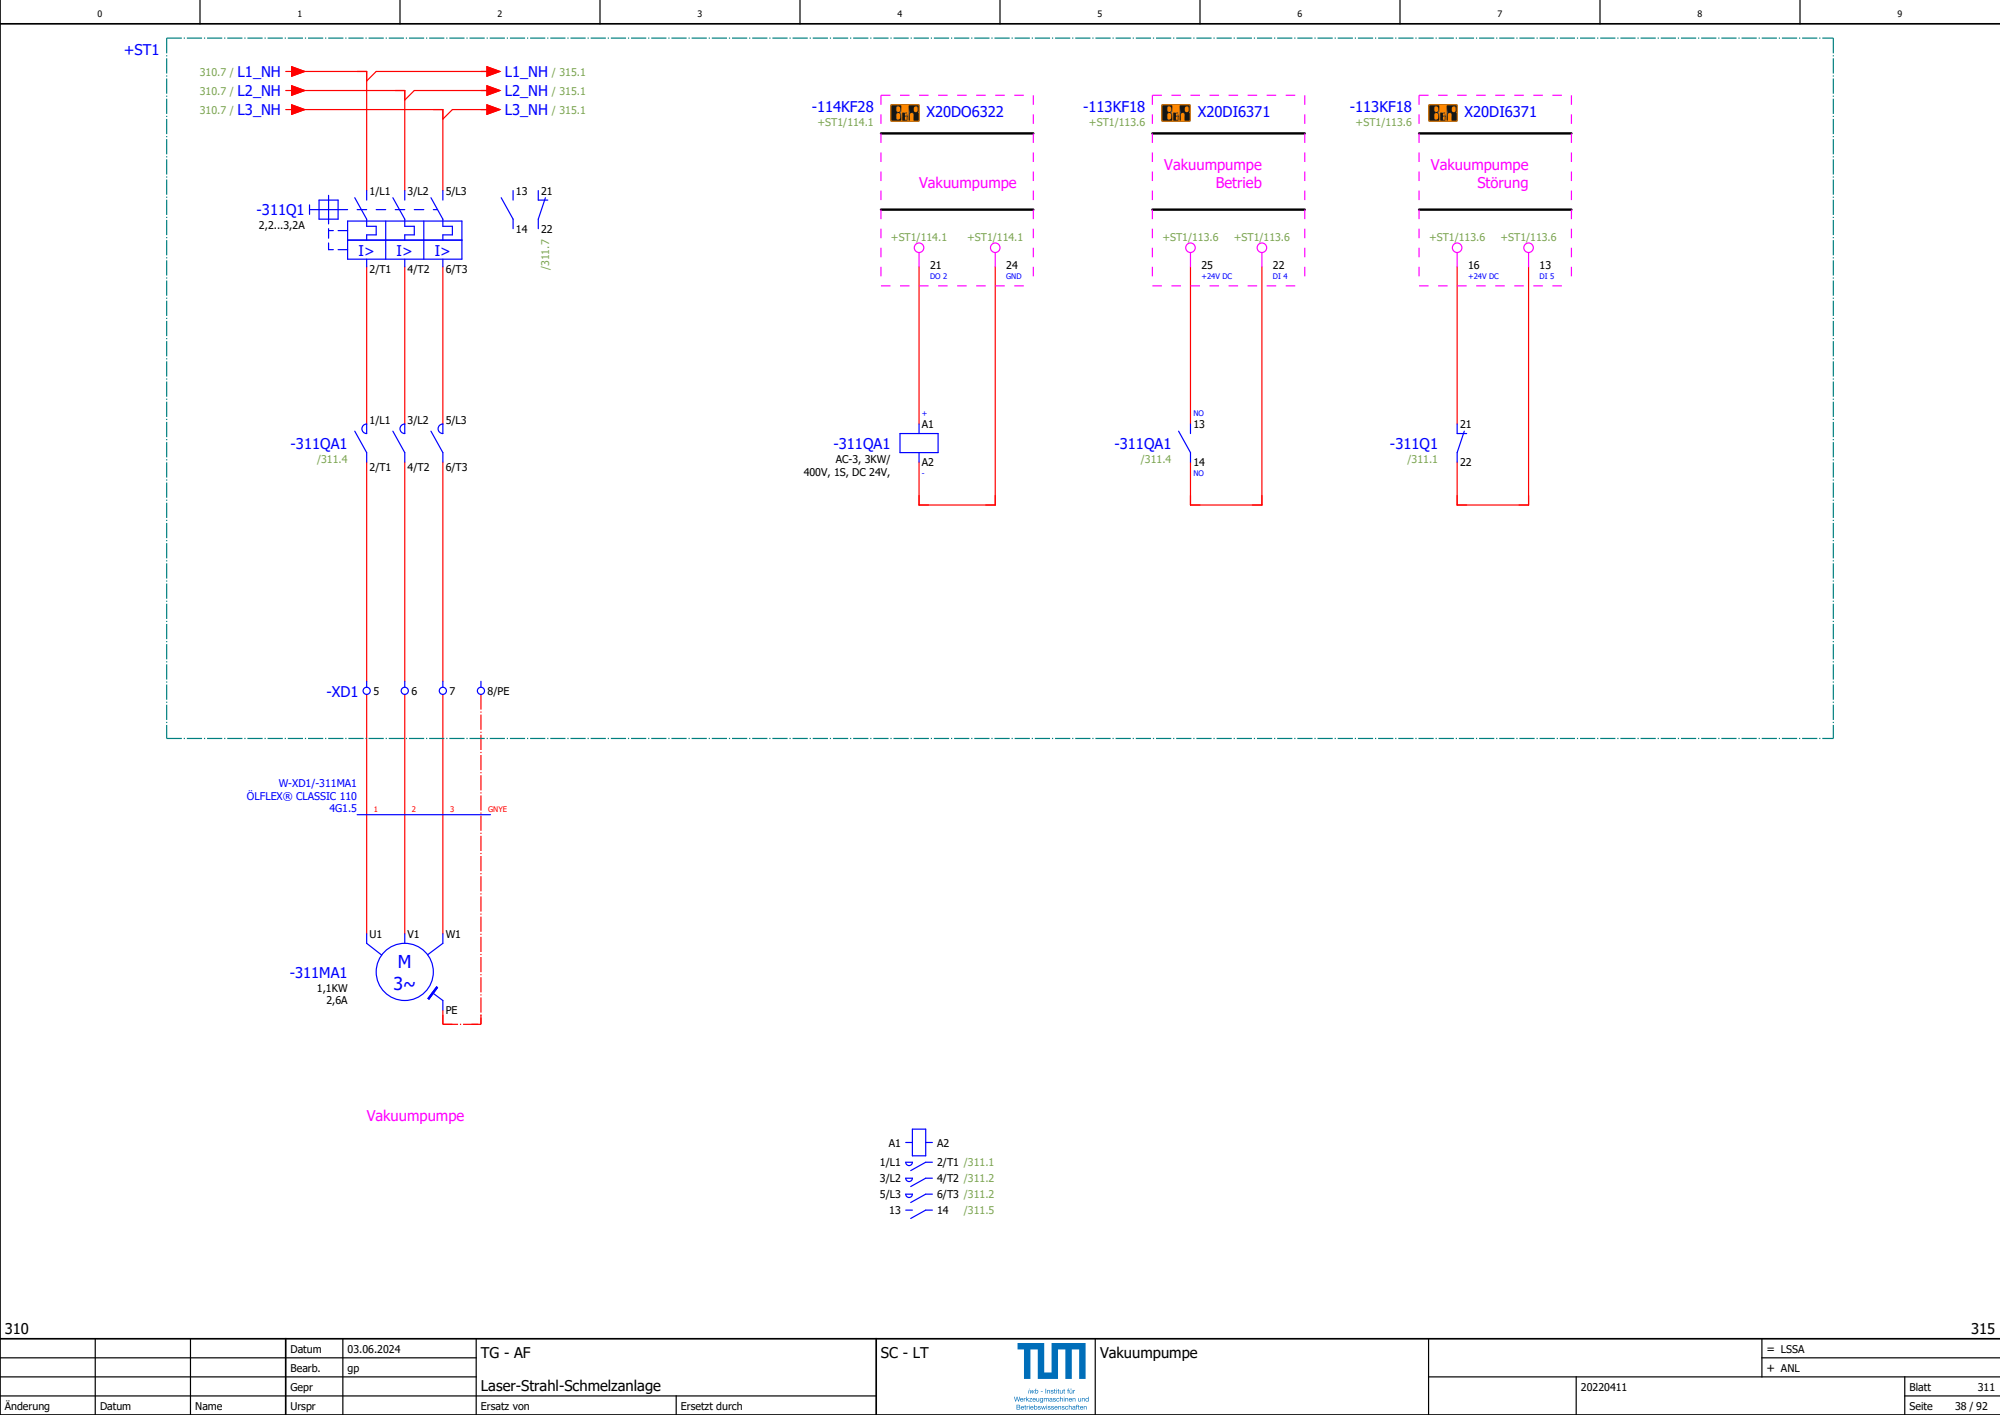
[picture p33: page 38]
ANL; Vakuumpumpe; GND; Vakuumpumpe Betrieb; Vakuumpumpe Störung; ÖLFLEX® CLASSIC 110; GNYE

## Bauplattform Heizung

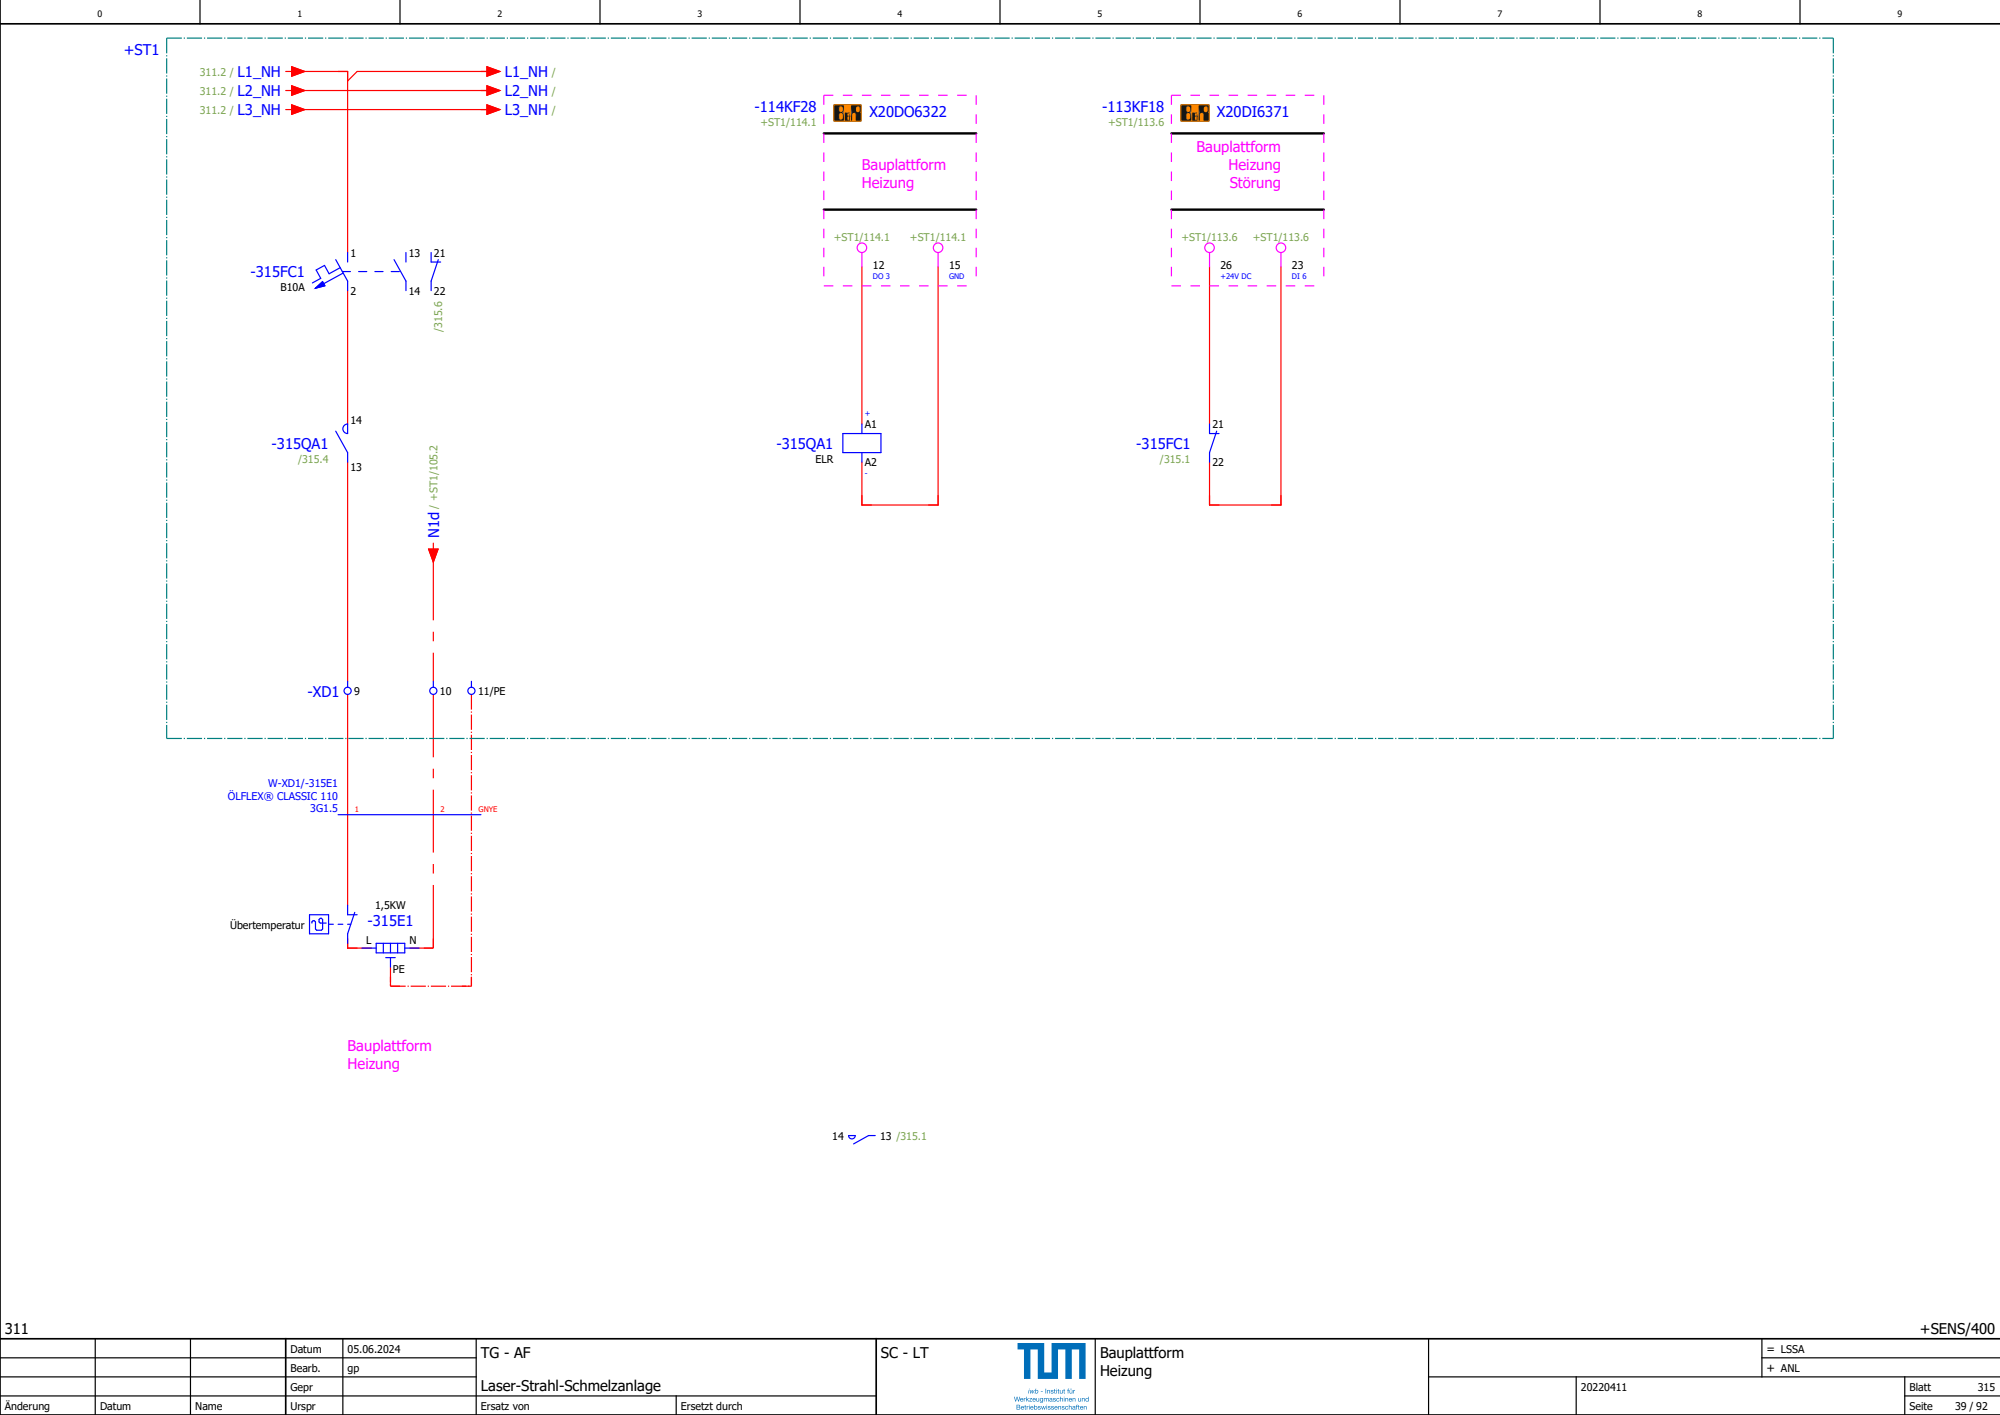
[picture p34: page 39]
ANL; Bauplattform Heizung; +SENS/400; Störung; GND; ELR; ÖLFLEX® CLASSIC 110; GNYE; Übertemperatur

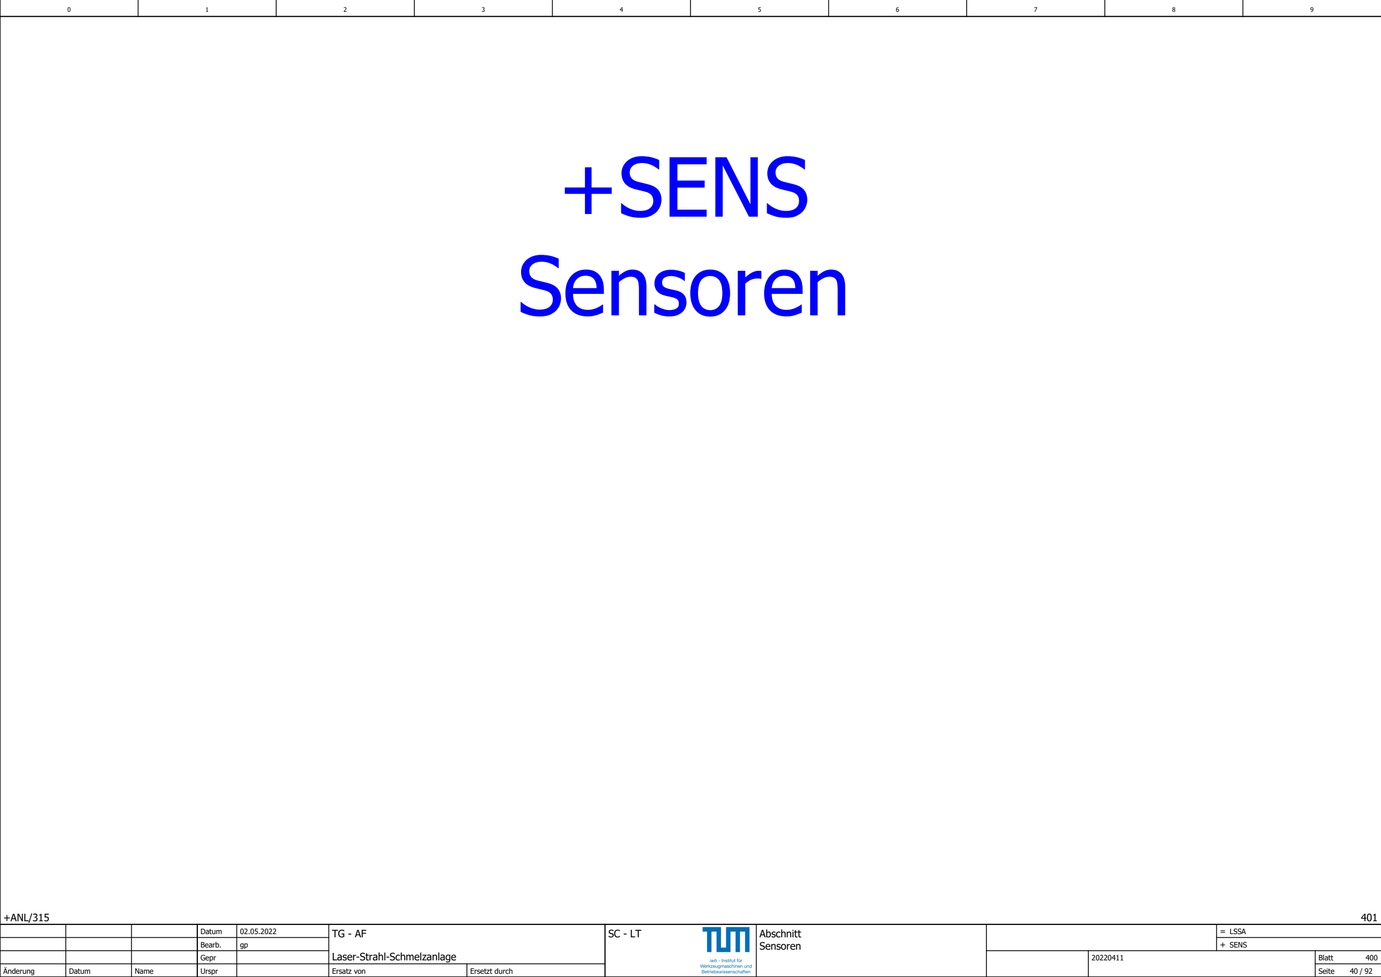
[picture p35: figure]
+ANL/315; SENS; Abschnitt Sensoren; +SENS Sensoren

## Z-Achse Endlage (-)

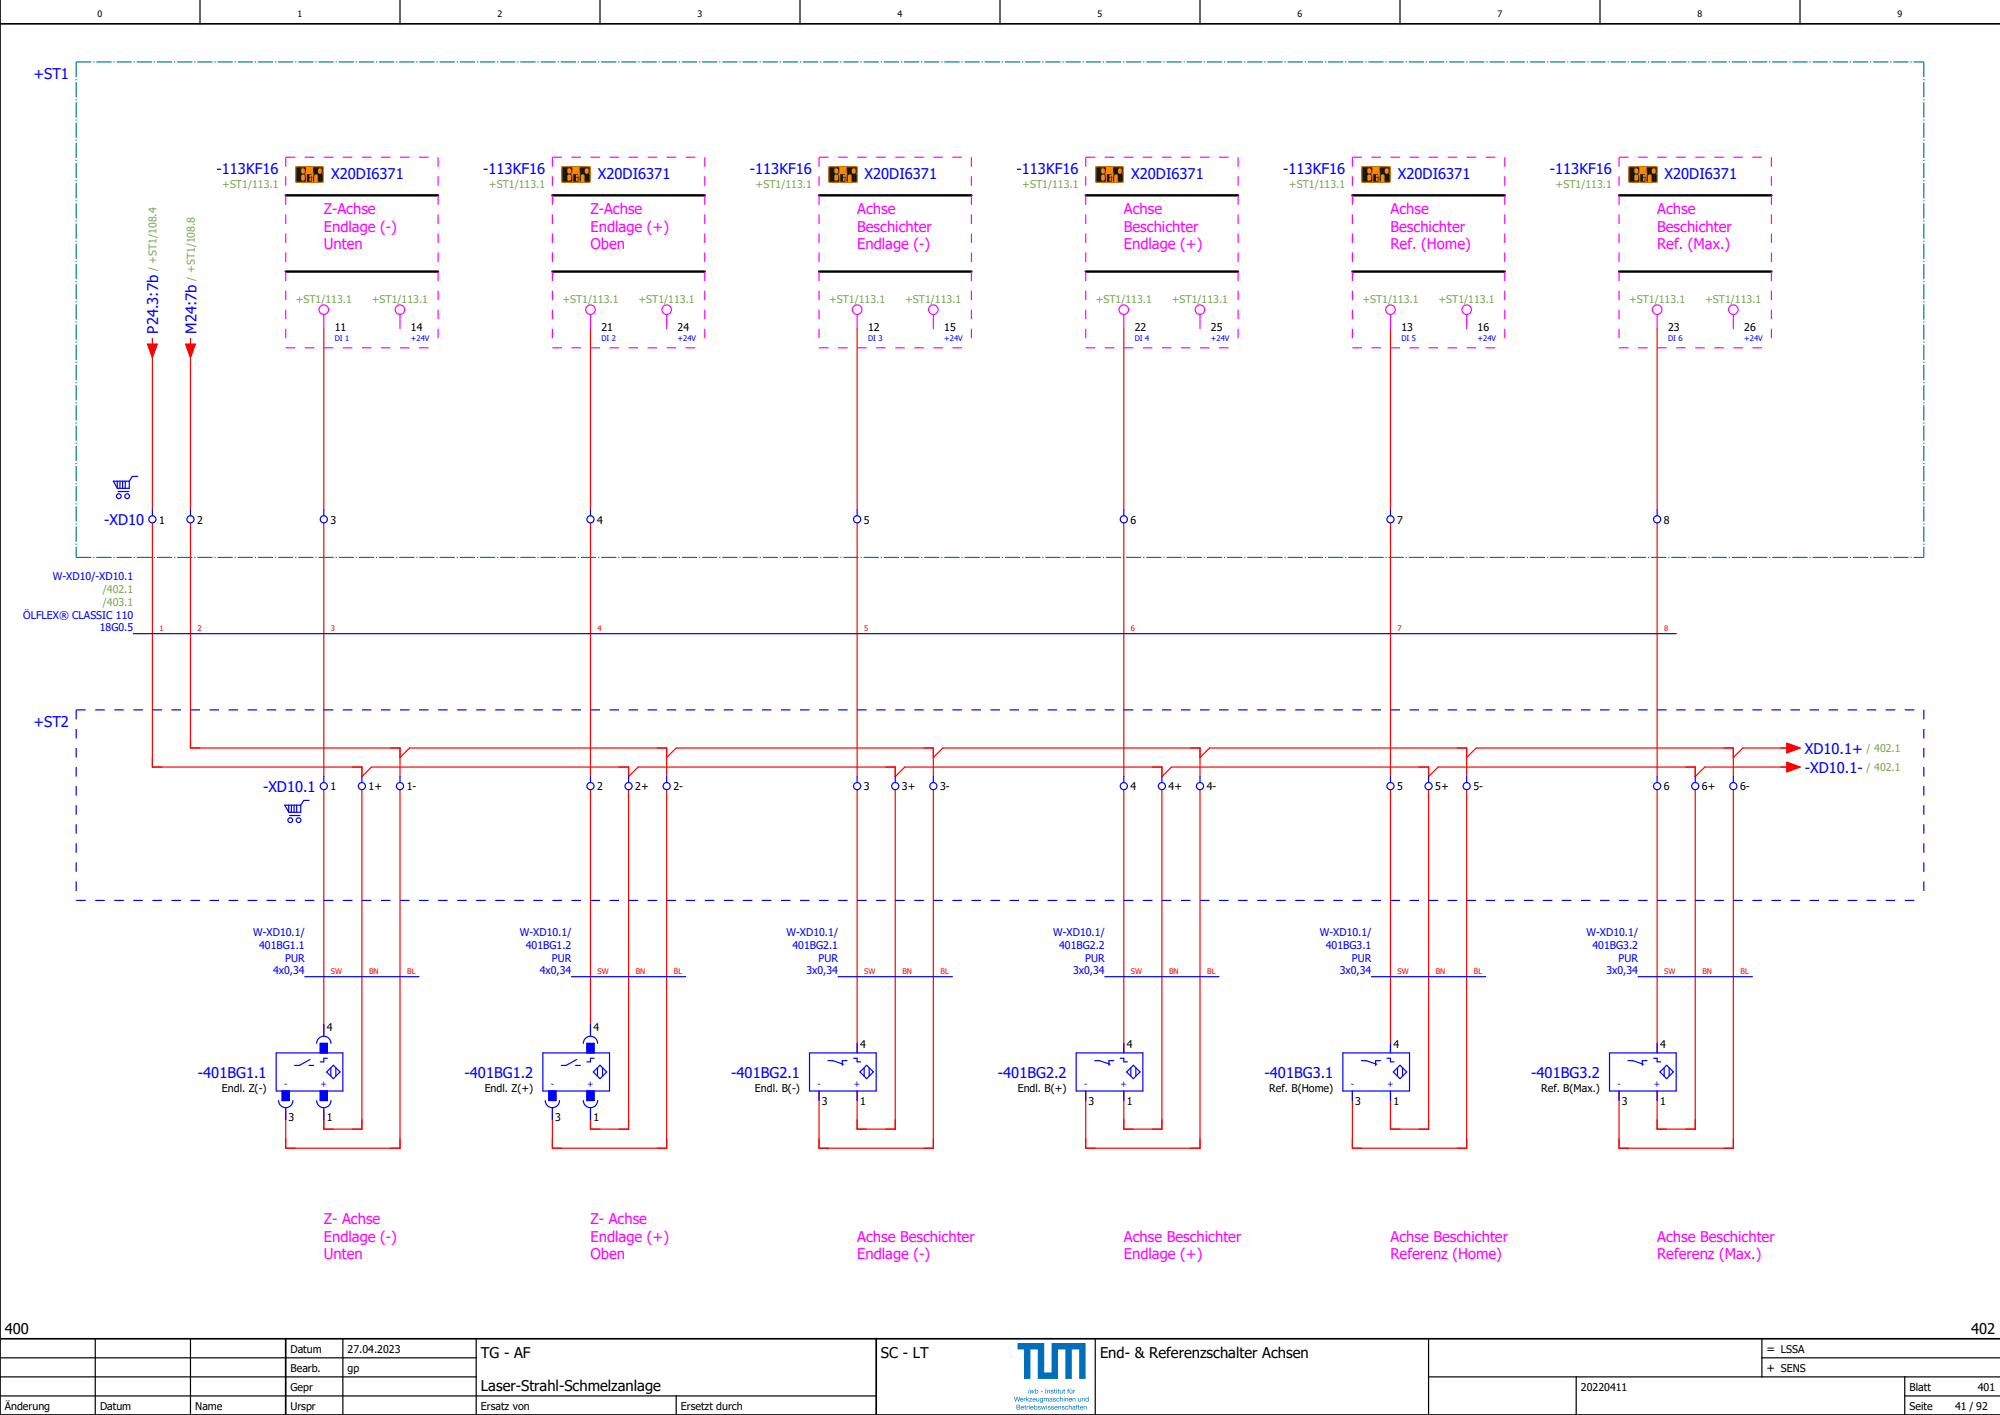
[picture p36: page 41]
SENS; Unten; Z-Achse Endlage (+) Oben; Achse Beschichter Endlage (-); Achse Beschichter Endlage (+); Achse Beschichter Ref. (Home); Achse Beschichter Ref. (Max.); Z- Achse Endlage (-) Unten; Achse Beschichter Referenz (Home); Achse Beschichter Referenz (Max.); Z- Achse Endlage (+) Oben; Endl. Z(-); Endl. Z(+); Endl. B(-); Endl. B(+); Ref. B(Home); Ref. B(Max.); PUR; ÖLFLEX® CLASSIC 110

End- & Referenzschalter Achsen

## Schutzgas Kammer

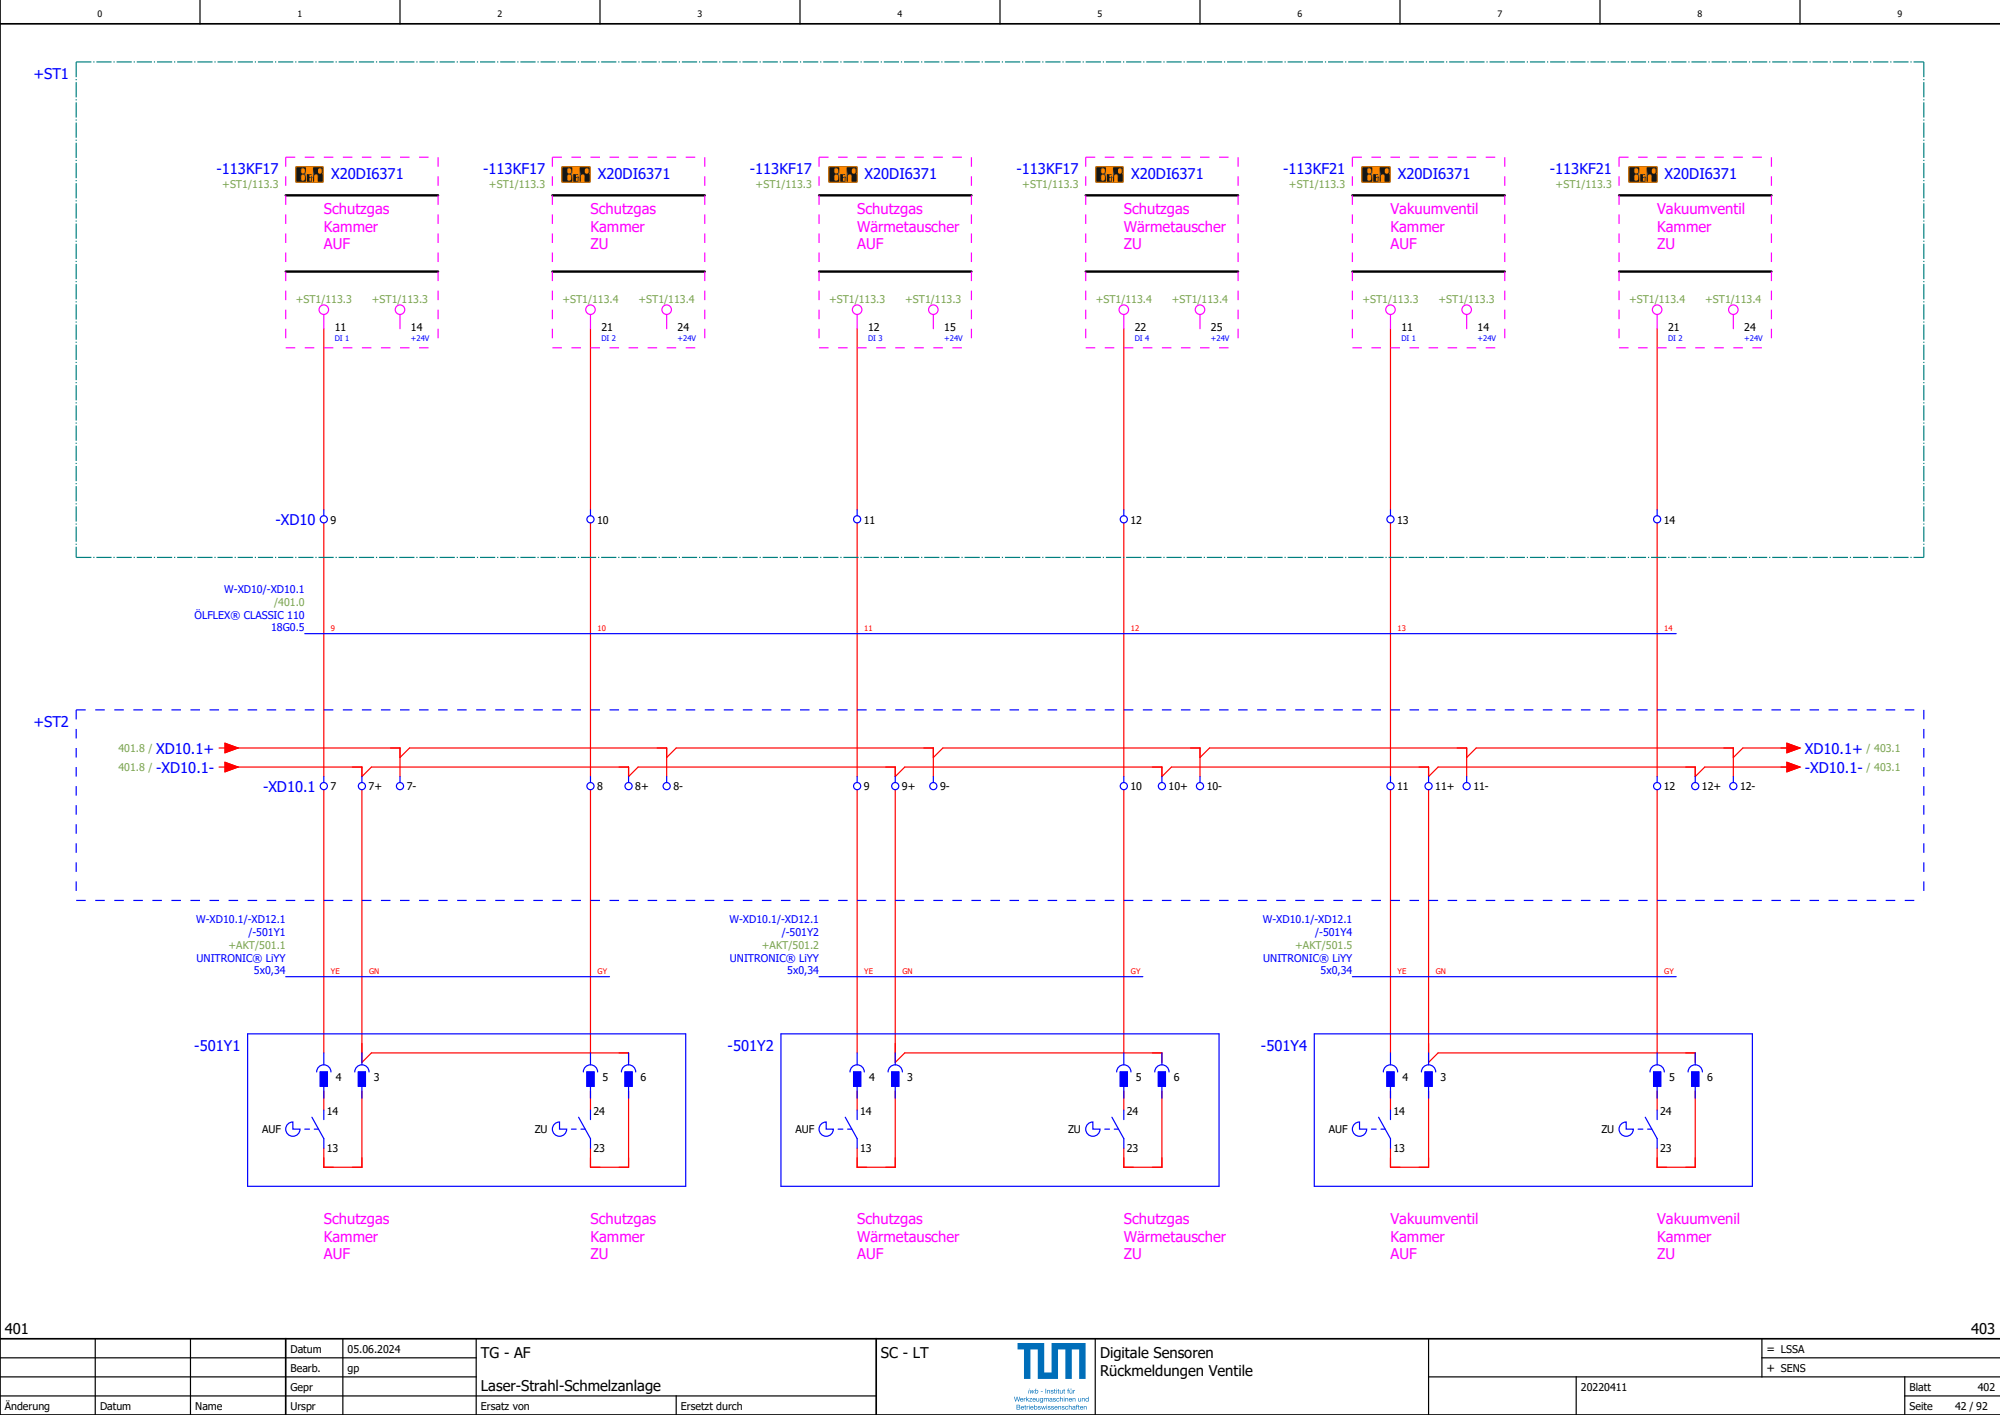
[picture p37: page 42]
SENS; Digitale Sensoren Rückmeldungen Ventile; AUF; Schutzgas Kammer ZU; Schutzgas Wärmetauscher AUF; Schutzgas Wärmetauscher ZU; Schutzgas Kammer AUF; Vakuumvenil Kammer ZU; Vakuumventil Kammer AUF; Vakuumventil Kammer ZU; ÖLFLEX® CLASSIC 110; UNITRONIC® LiYY; +AKT/501.1; +AKT/501.2; +AKT/501.5

## Vakuumvenil Z-Achse

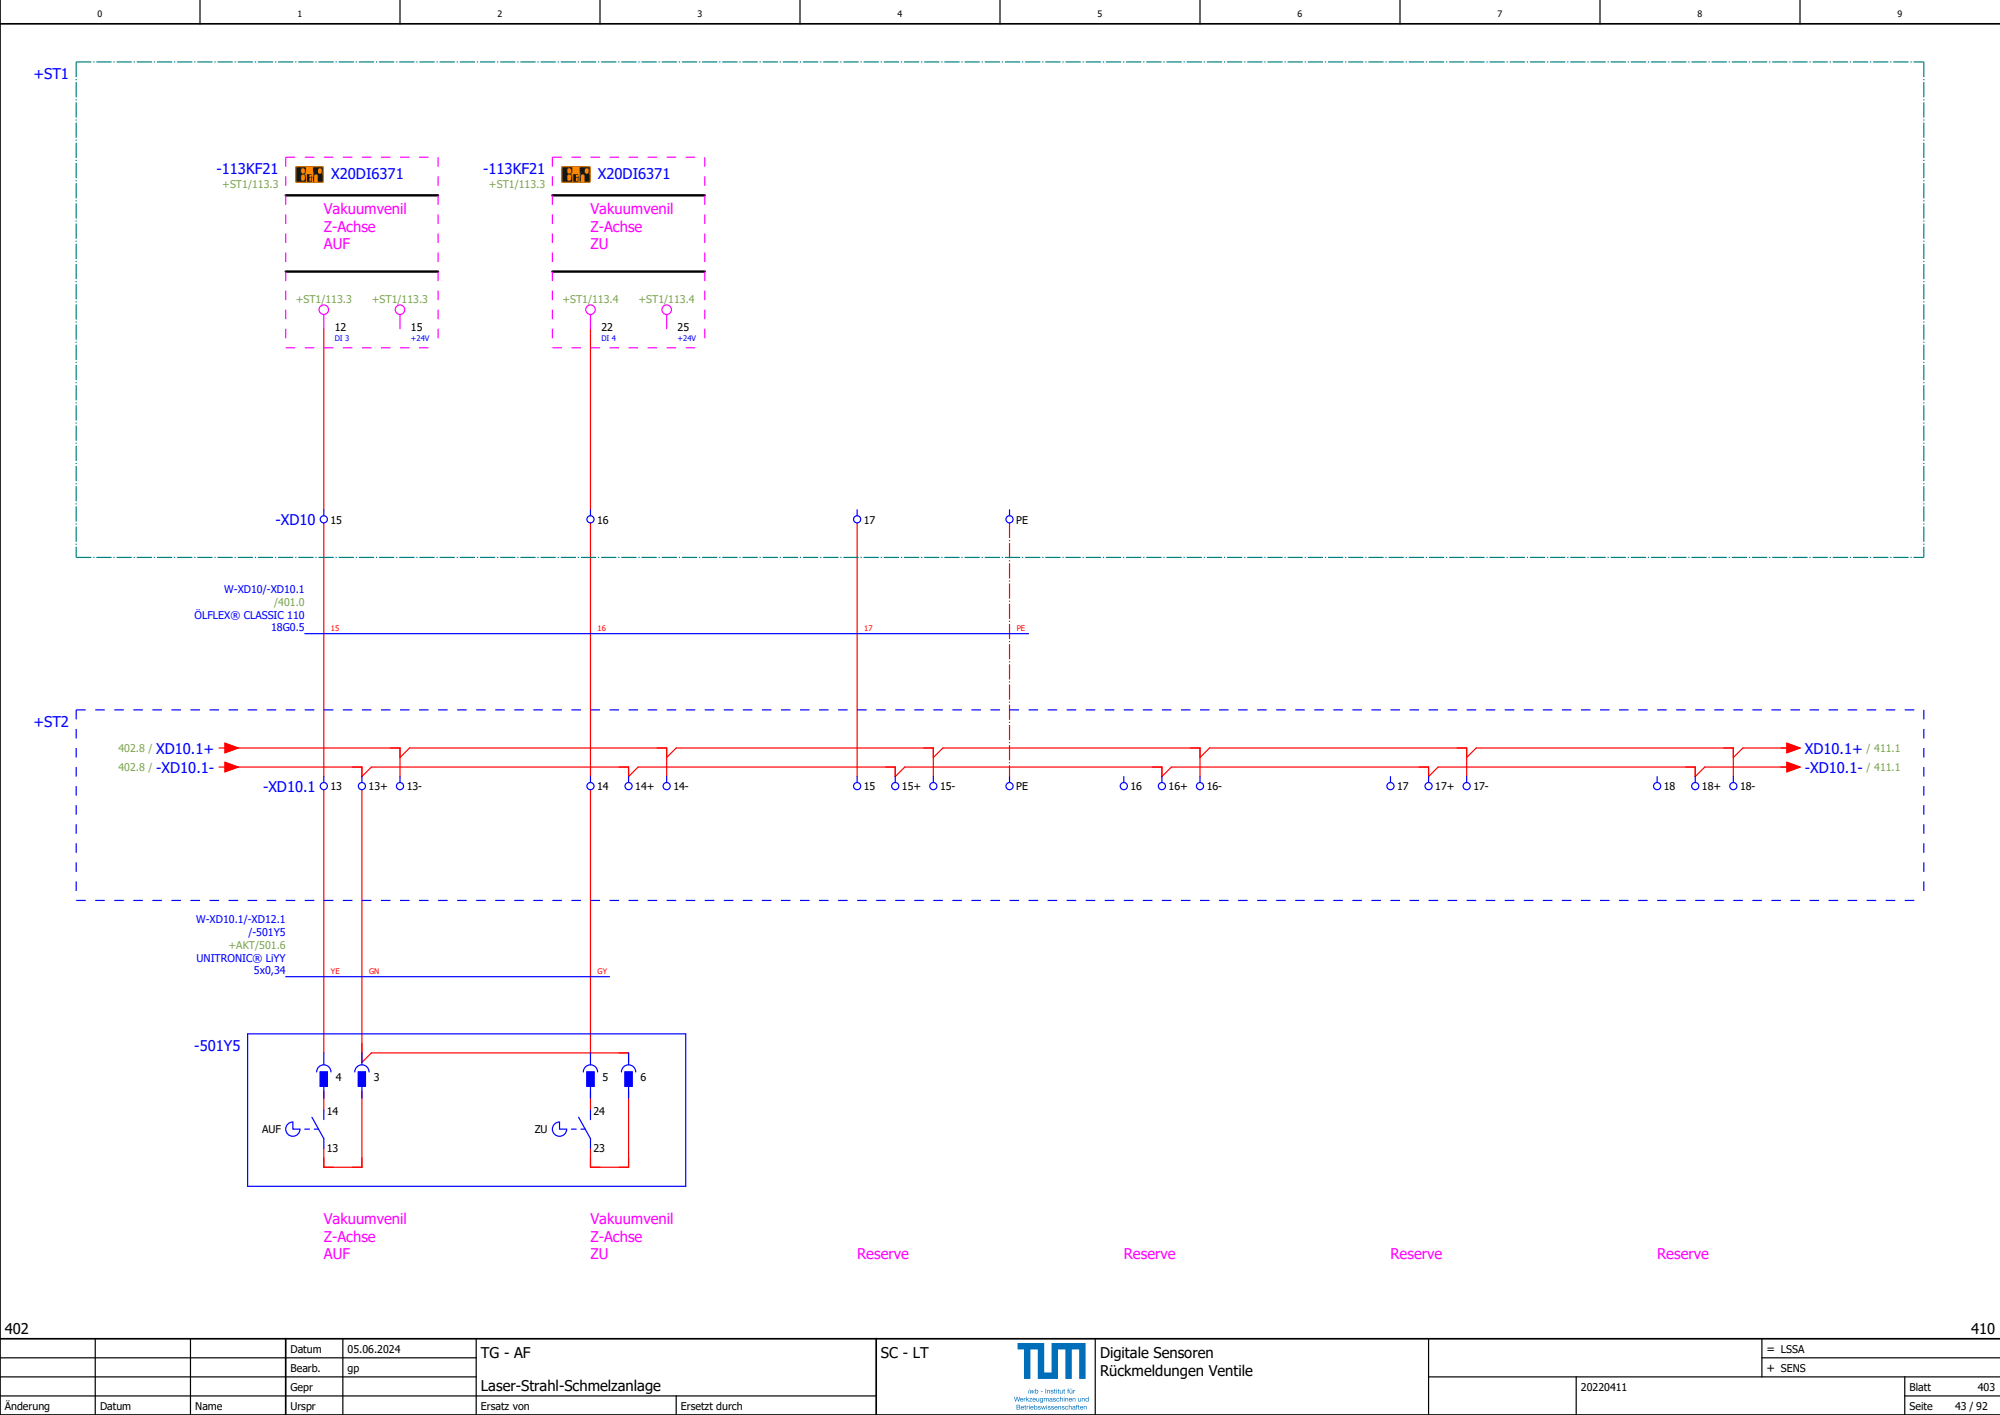
[picture p38: page 43]
SENS; Digitale Sensoren Rückmeldungen Ventile; AUF; Vakuumvenil Z-Achse ZU; Reserve; Vakuumvenil Z-Achse; ÖLFLEX® CLASSIC 110; UNITRONIC® LiYY; +AKT/501.6

## Temperatur 1

-112KF11

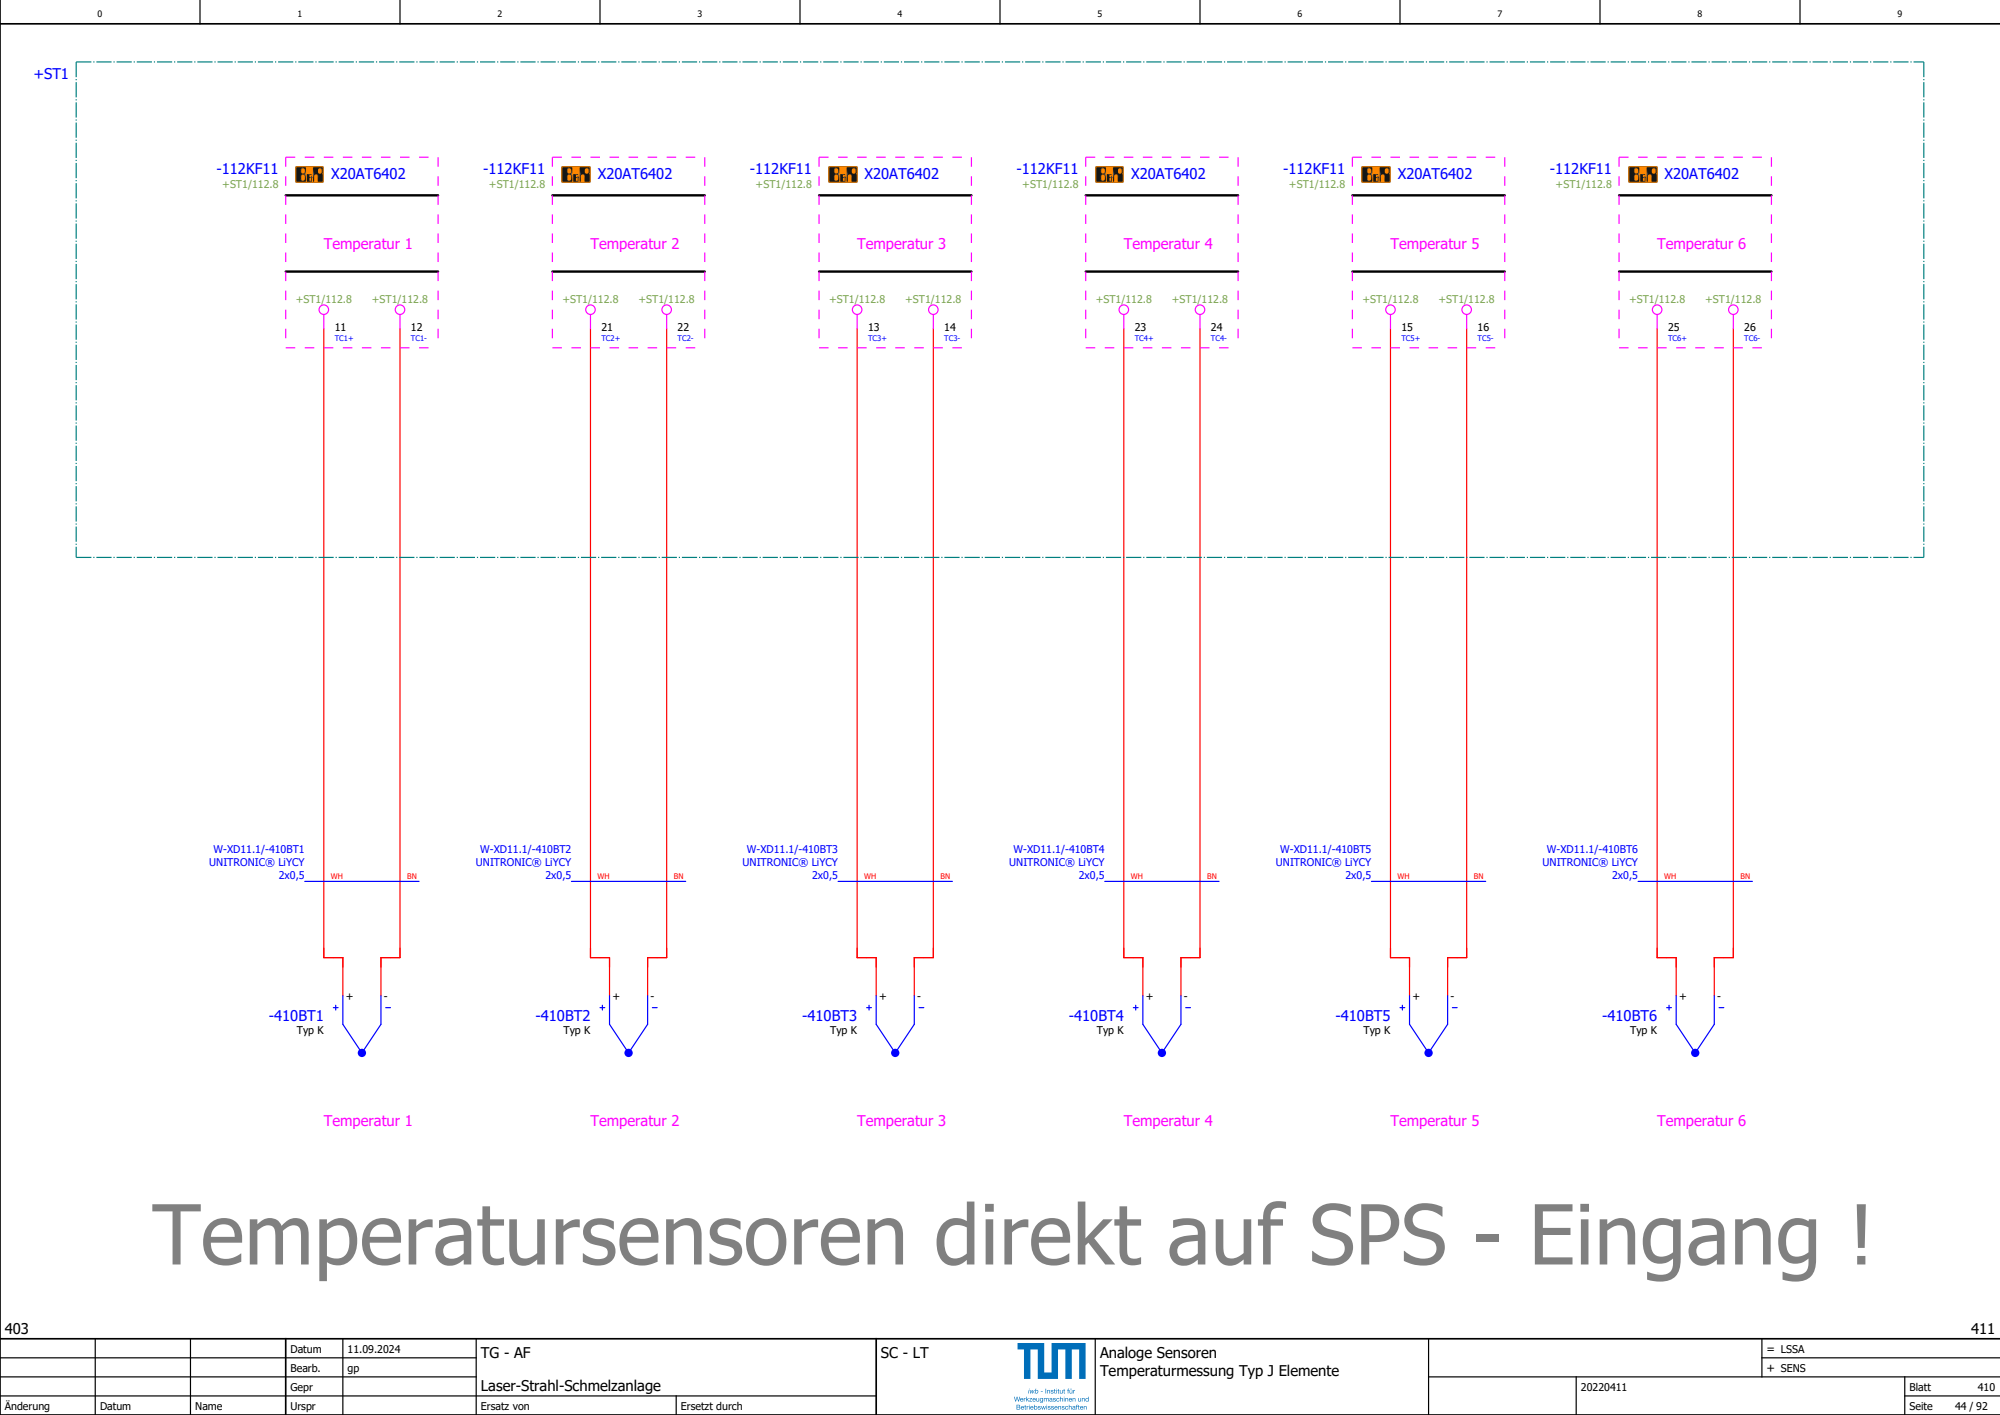
[picture p39: page 44]
SENS; Temperatur 2; Temperatur 1; Temperatur 3; Temperatur 4; Temperatur 5; Temperatur 6; Typ K; UNITRONIC® LiYCY

Temperatursensoren direkt auf SPS - Eingang !

Analoge Sensoren
Temperaturmessung Typ J Elemente

## Temperatur Bauplattform

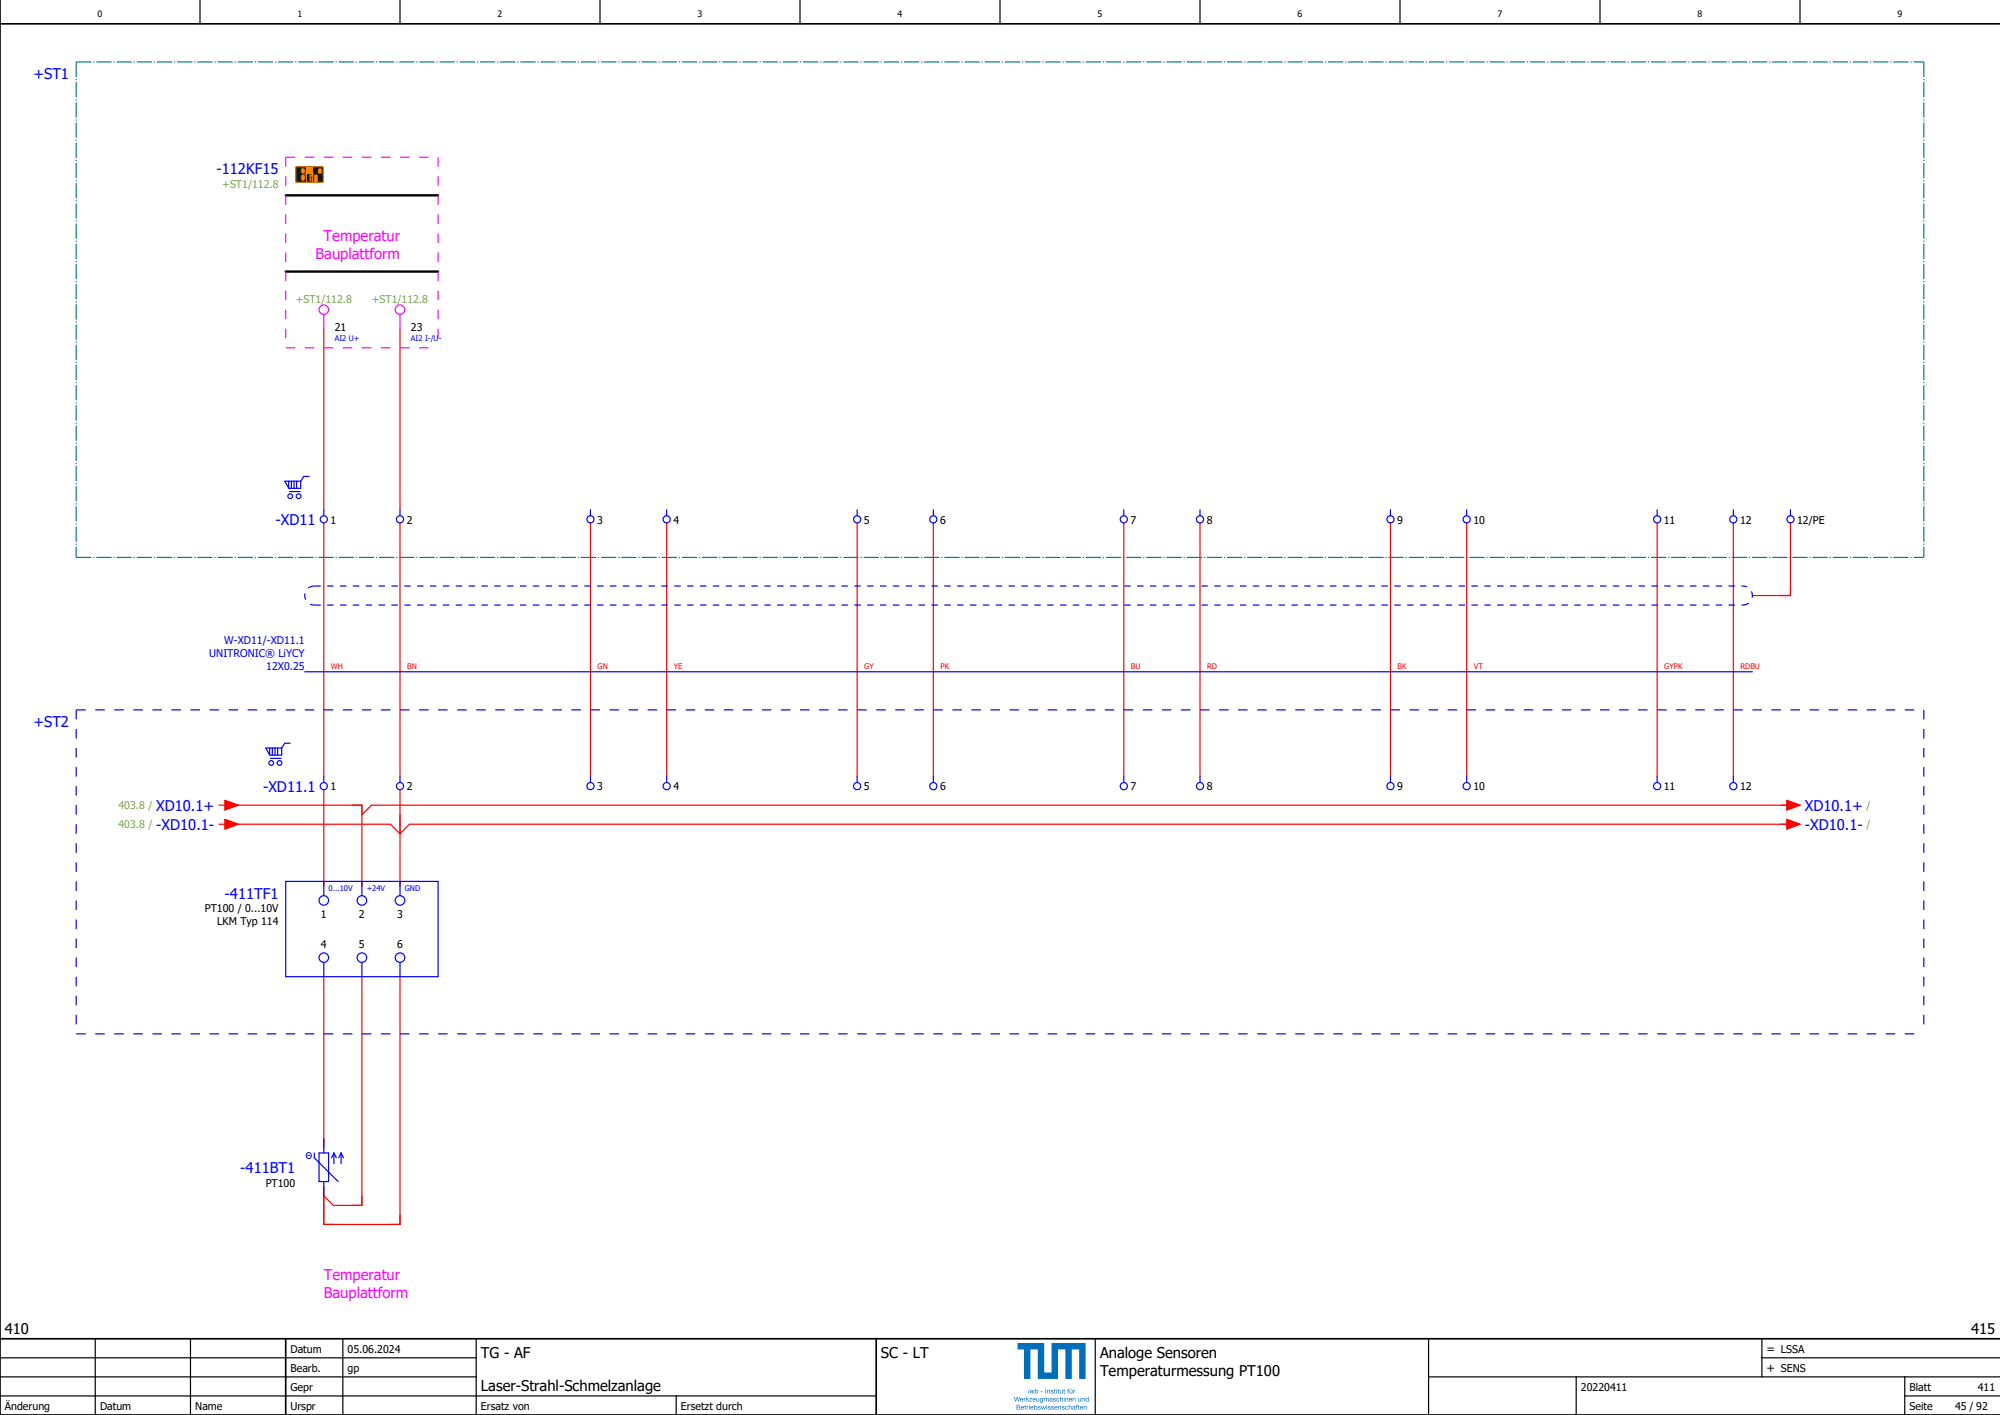
[picture p40: page 45]
SENS; Analoge Sensoren Temperaturmessung PT100; Temperatur Bauplattform; UNITRONIC® LiYCY; GYPK; RDBU; PT100 / 0...10V LKM Typ 114; GND

## Sauerstoff Filter Istwert

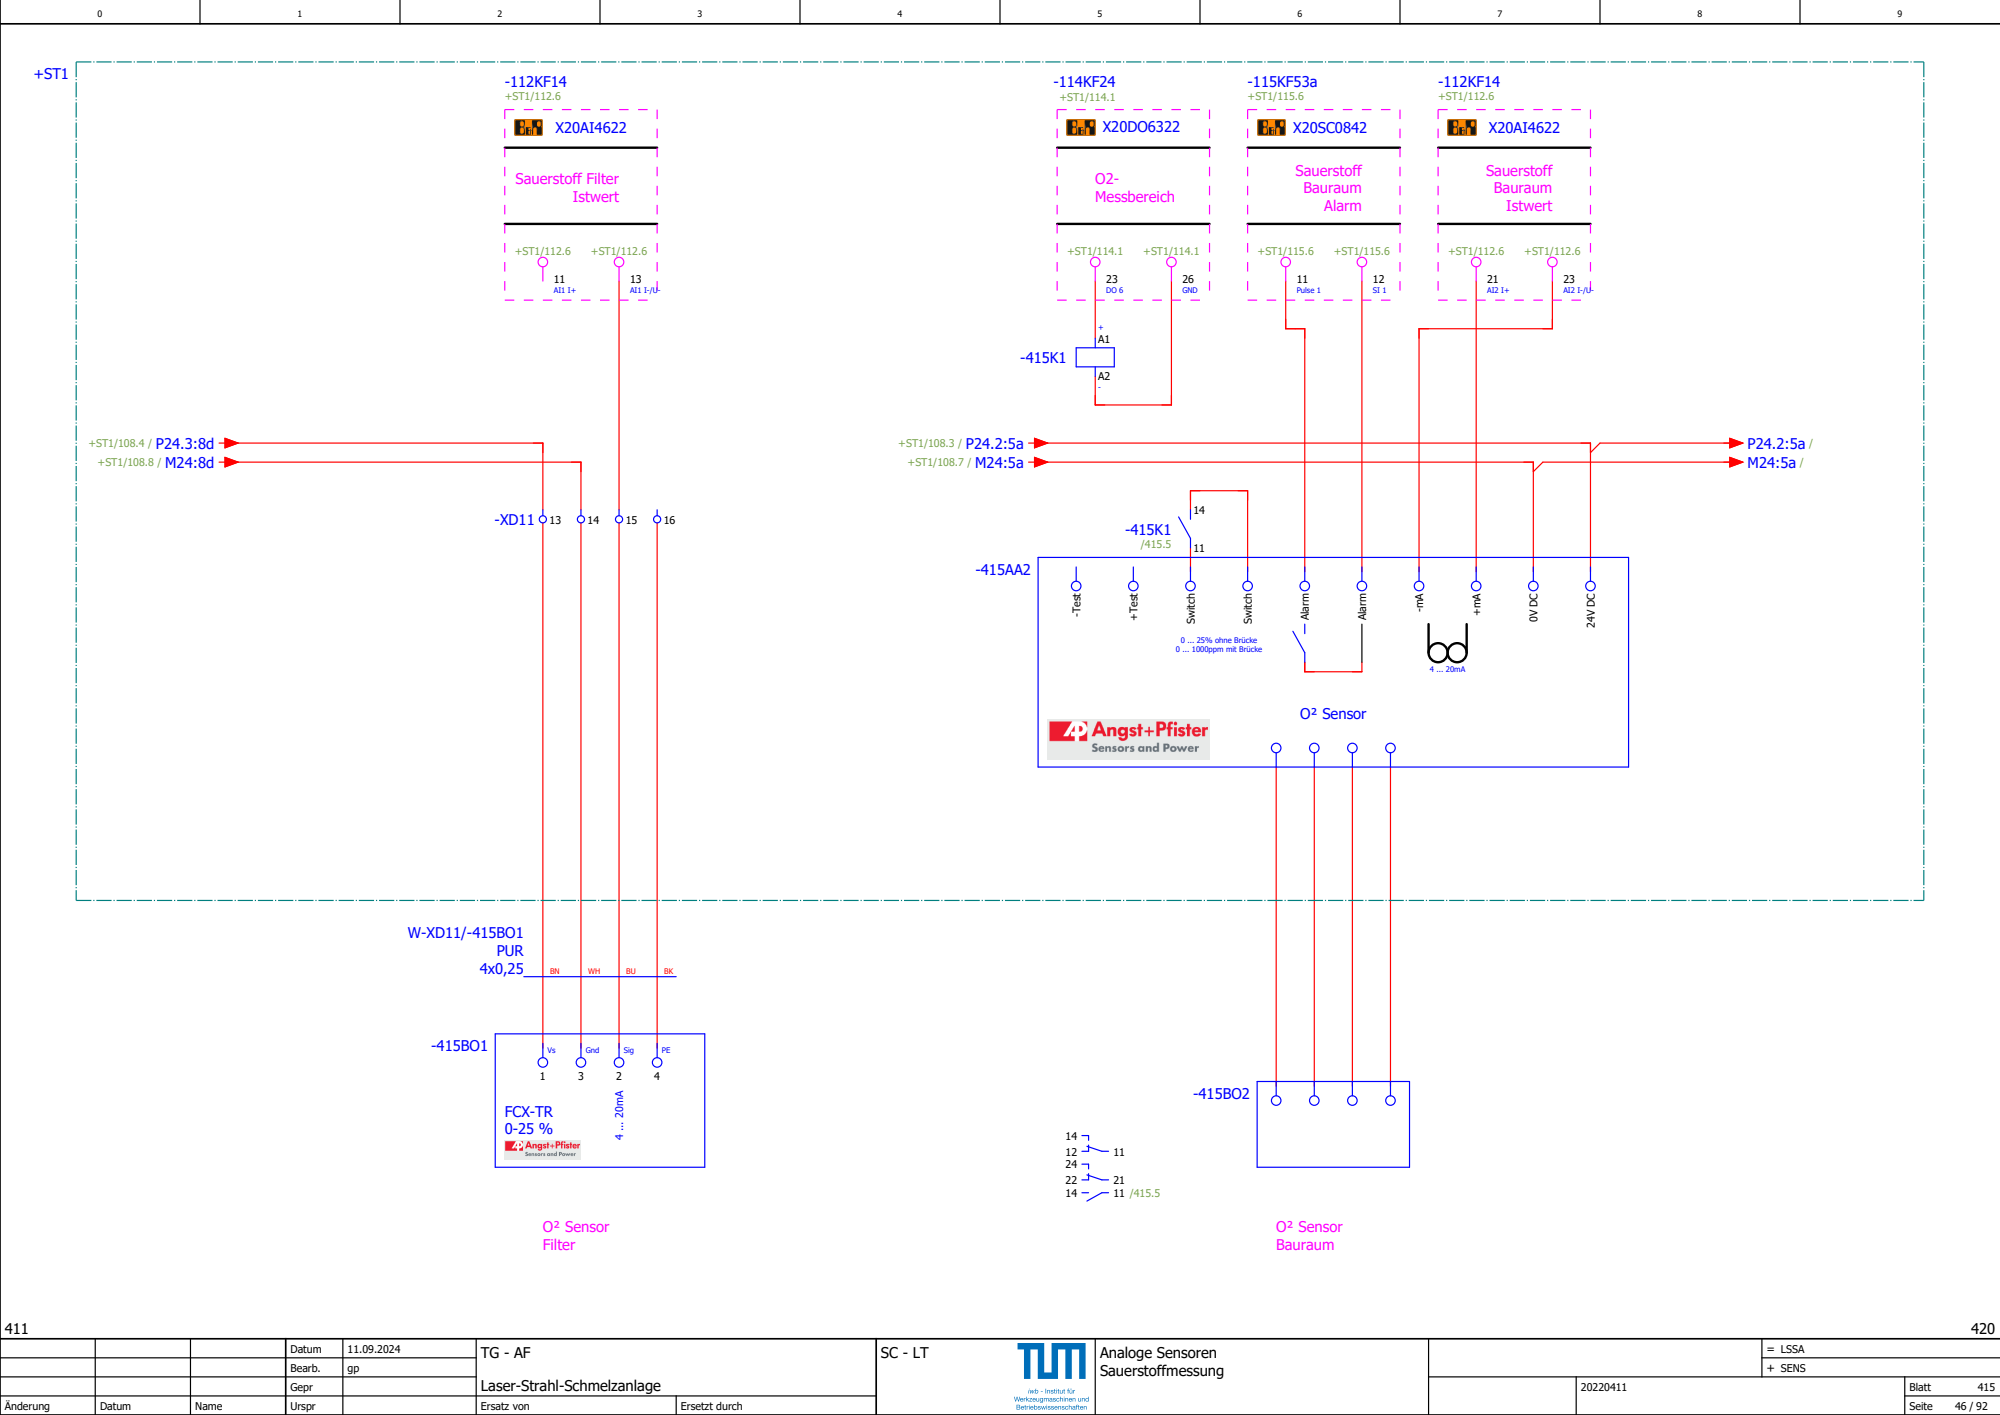
[picture p41: page 46]
SENS; Analoge Sensoren Sauerstoffmessung; Sauerstoff Bauraum Alarm; Pulse 1; 0 ... 25% ohne Brücke 0 ... 1000ppm mit Brücke; O² Sensor Bauraum; O² Sensor; Sauerstoff Bauraum Istwert; O² Sensor Filter; FCX-TR 0-25 %; O2- Messbereich; GND; -Test; Switch; Alarm; +Test; Gnd; Sig; PUR

## Druck Druckluft

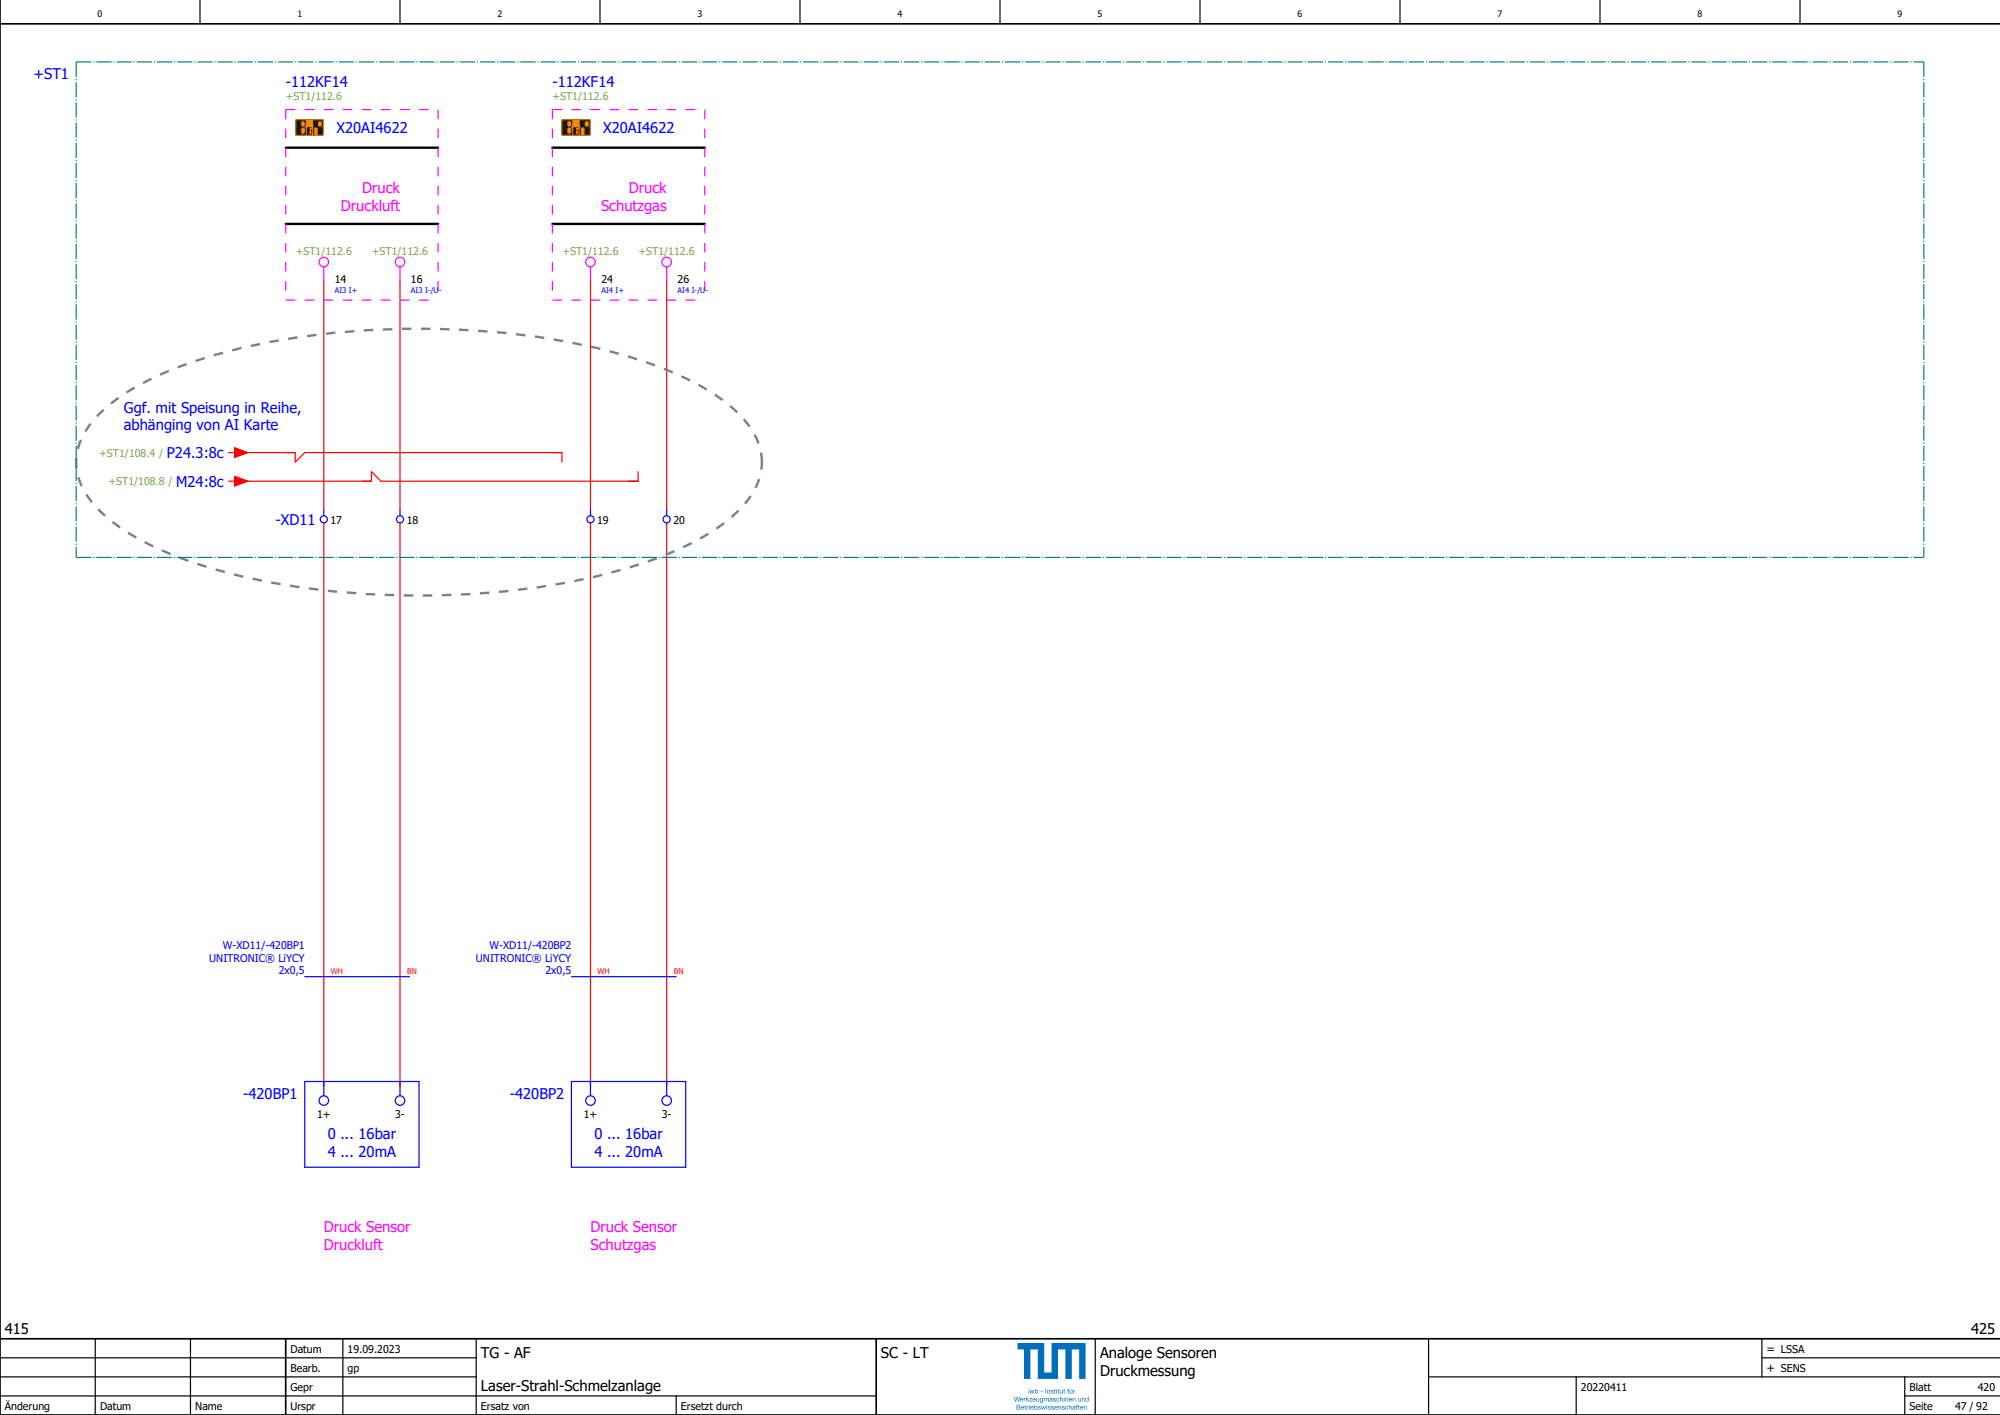
[picture p42: page 47]
SENS; Analoge Sensoren Druckmessung; Druck Schutzgas; Druck Sensor Druckluft; 0 ... 16bar 4 ... 20mA; Druck Sensor Schutzgas; UNITRONIC® LiYCY

Ggf. mit Speisung in Reihe,
abhänging von AI Karte

## Vakuum Istwert

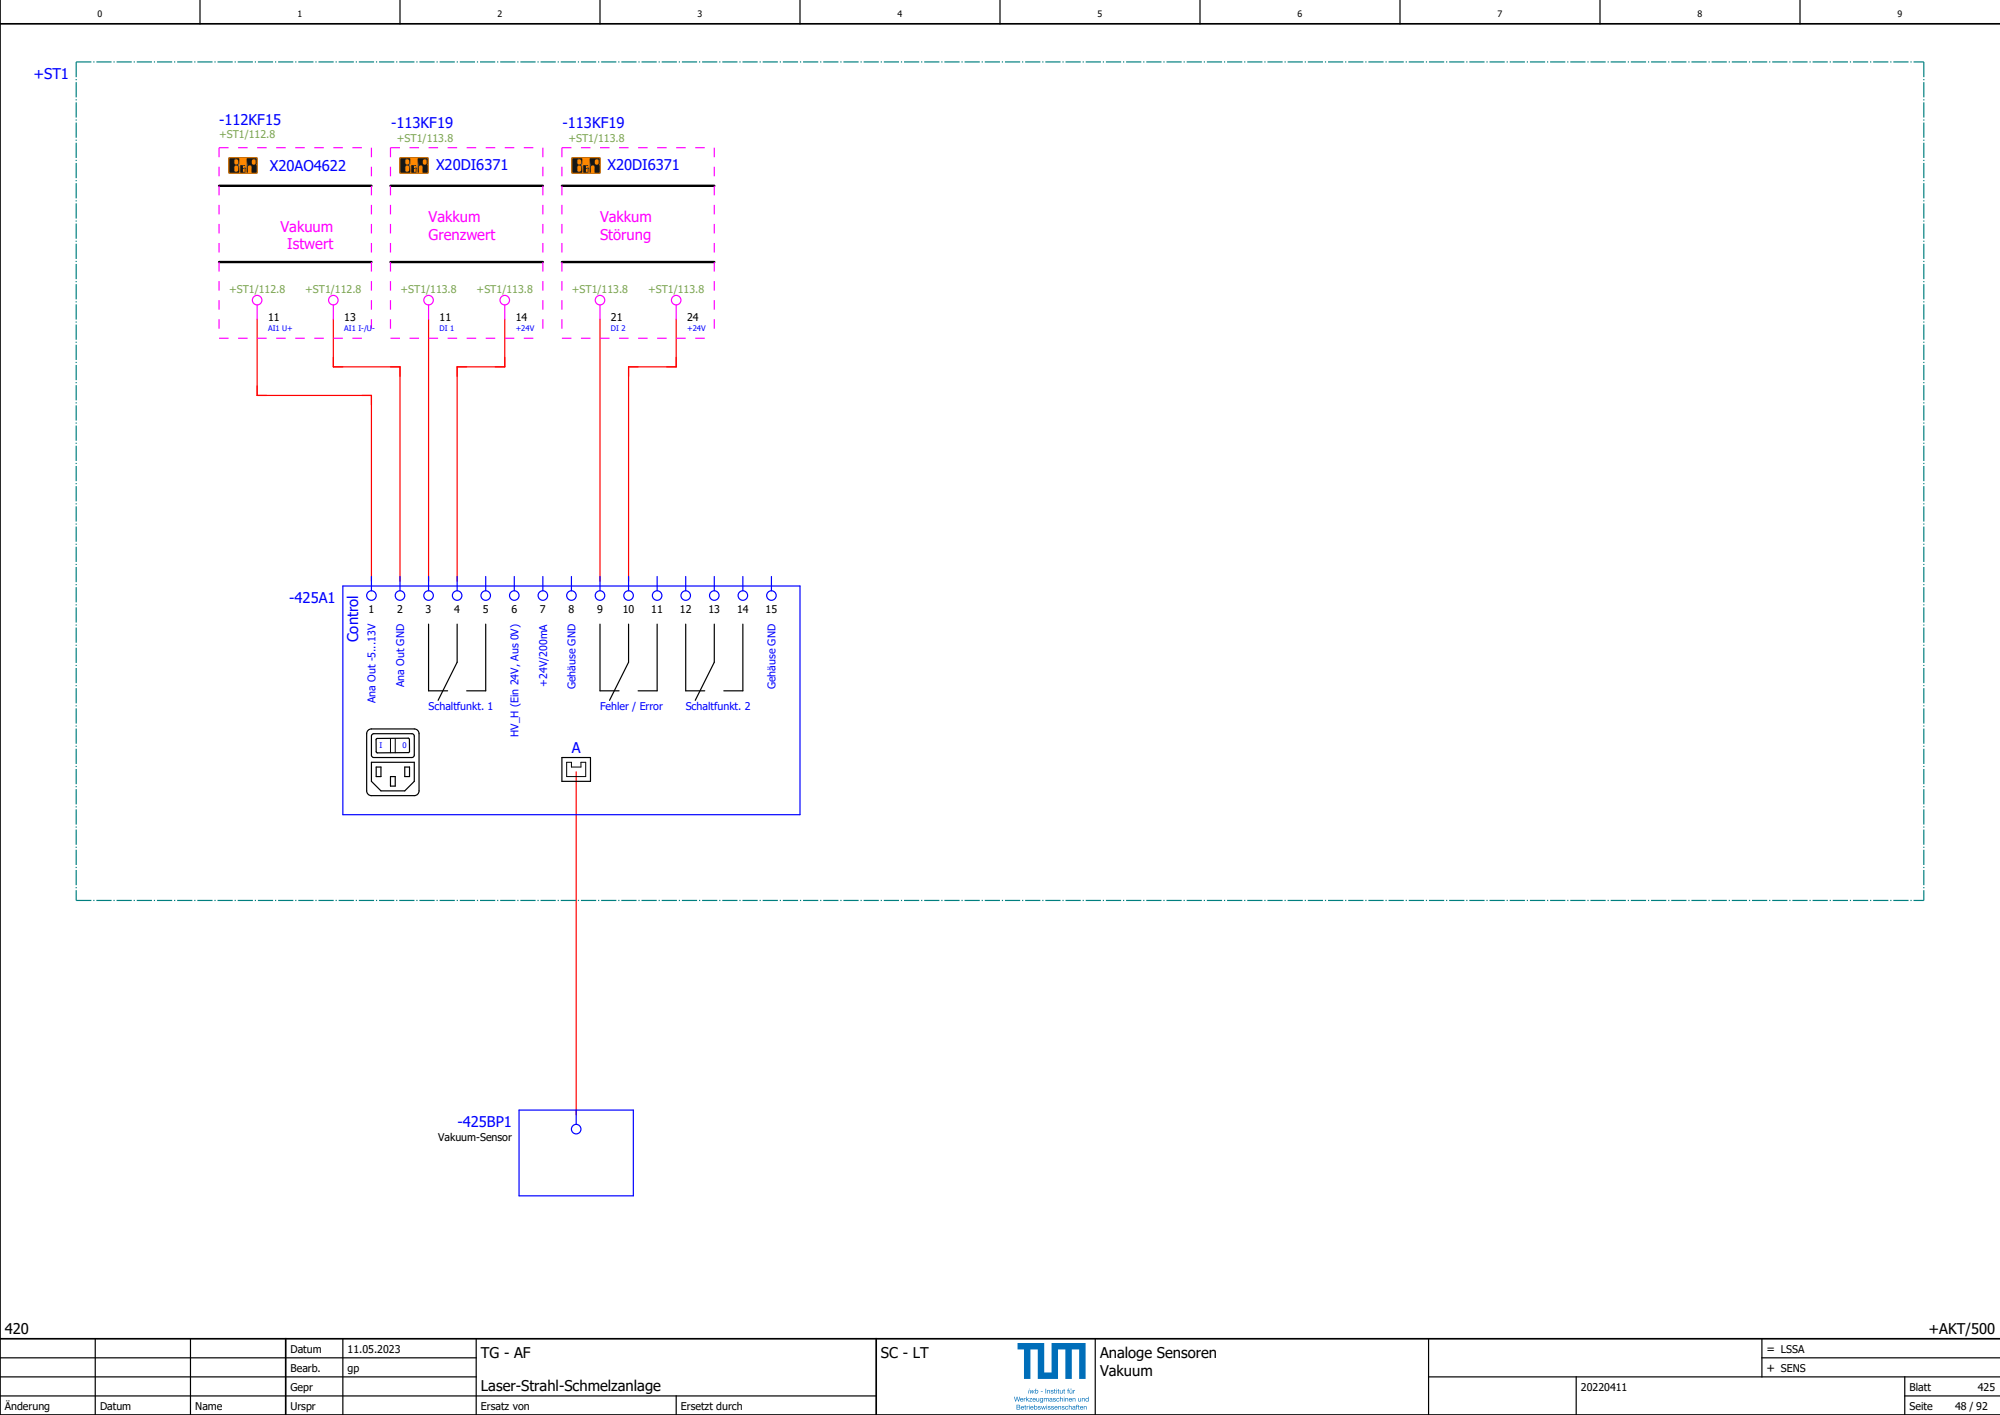
[picture p43: page 48]
SENS; Analoge Sensoren Vakuum; +AKT/500; Vakuum-Sensor; Ana Out -5...13V; Gehäuse GND; HV_H (Ein 24V, Aus 0V); Schaltfunkt. 1; Fehler / Error; Schaltfunkt. 2 ⁺²⁴V/200mA; Vakkum Grenzwert; Vakkum Störung; Control

Ana Out GND

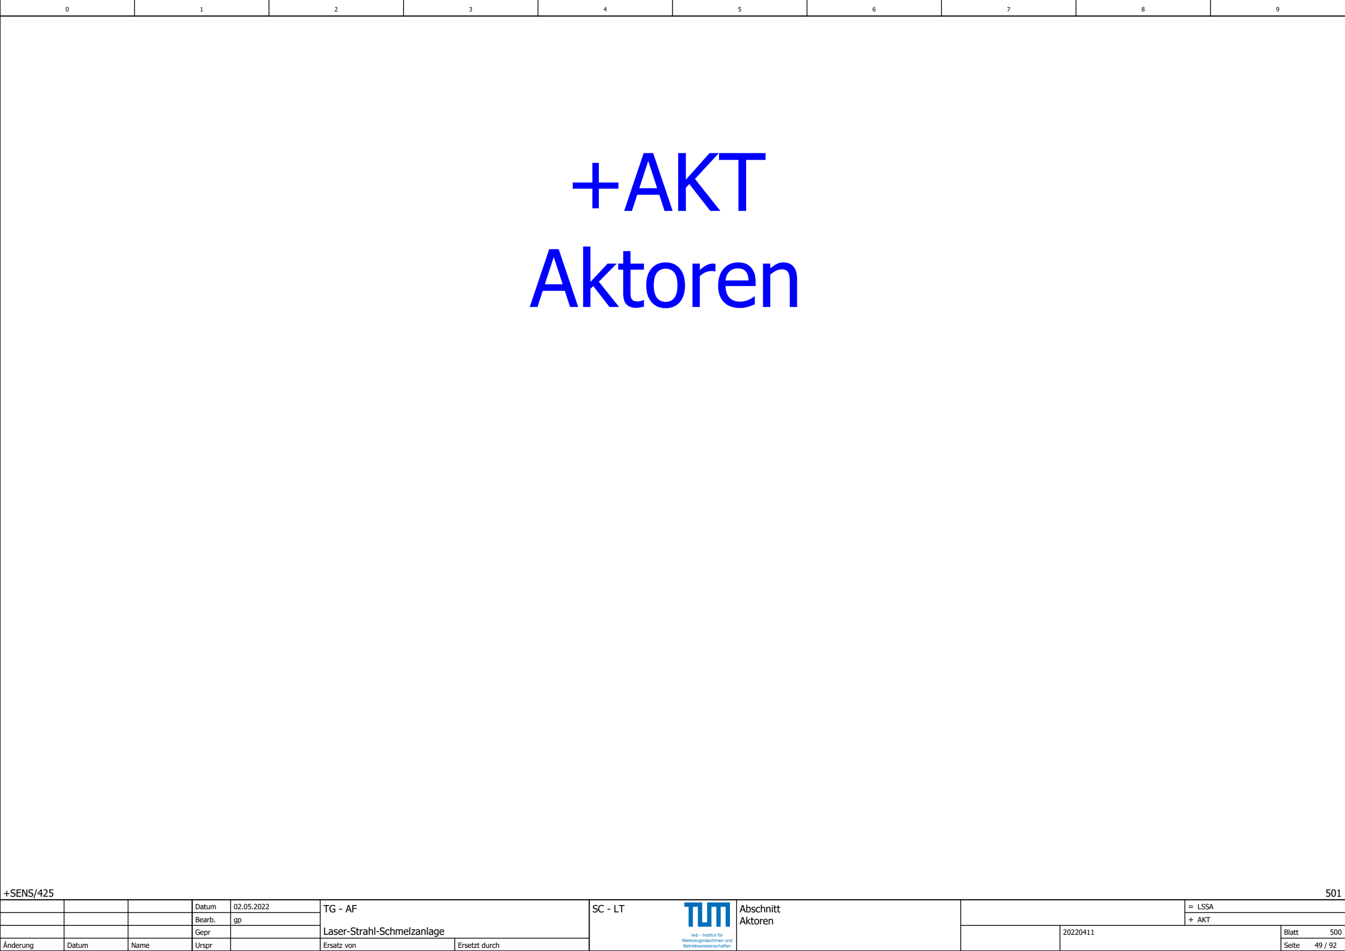
[picture p44: figure]
+SENS/425; AKT; Abschnitt Aktoren; +AKT Aktoren

## Schutzgas Kammer

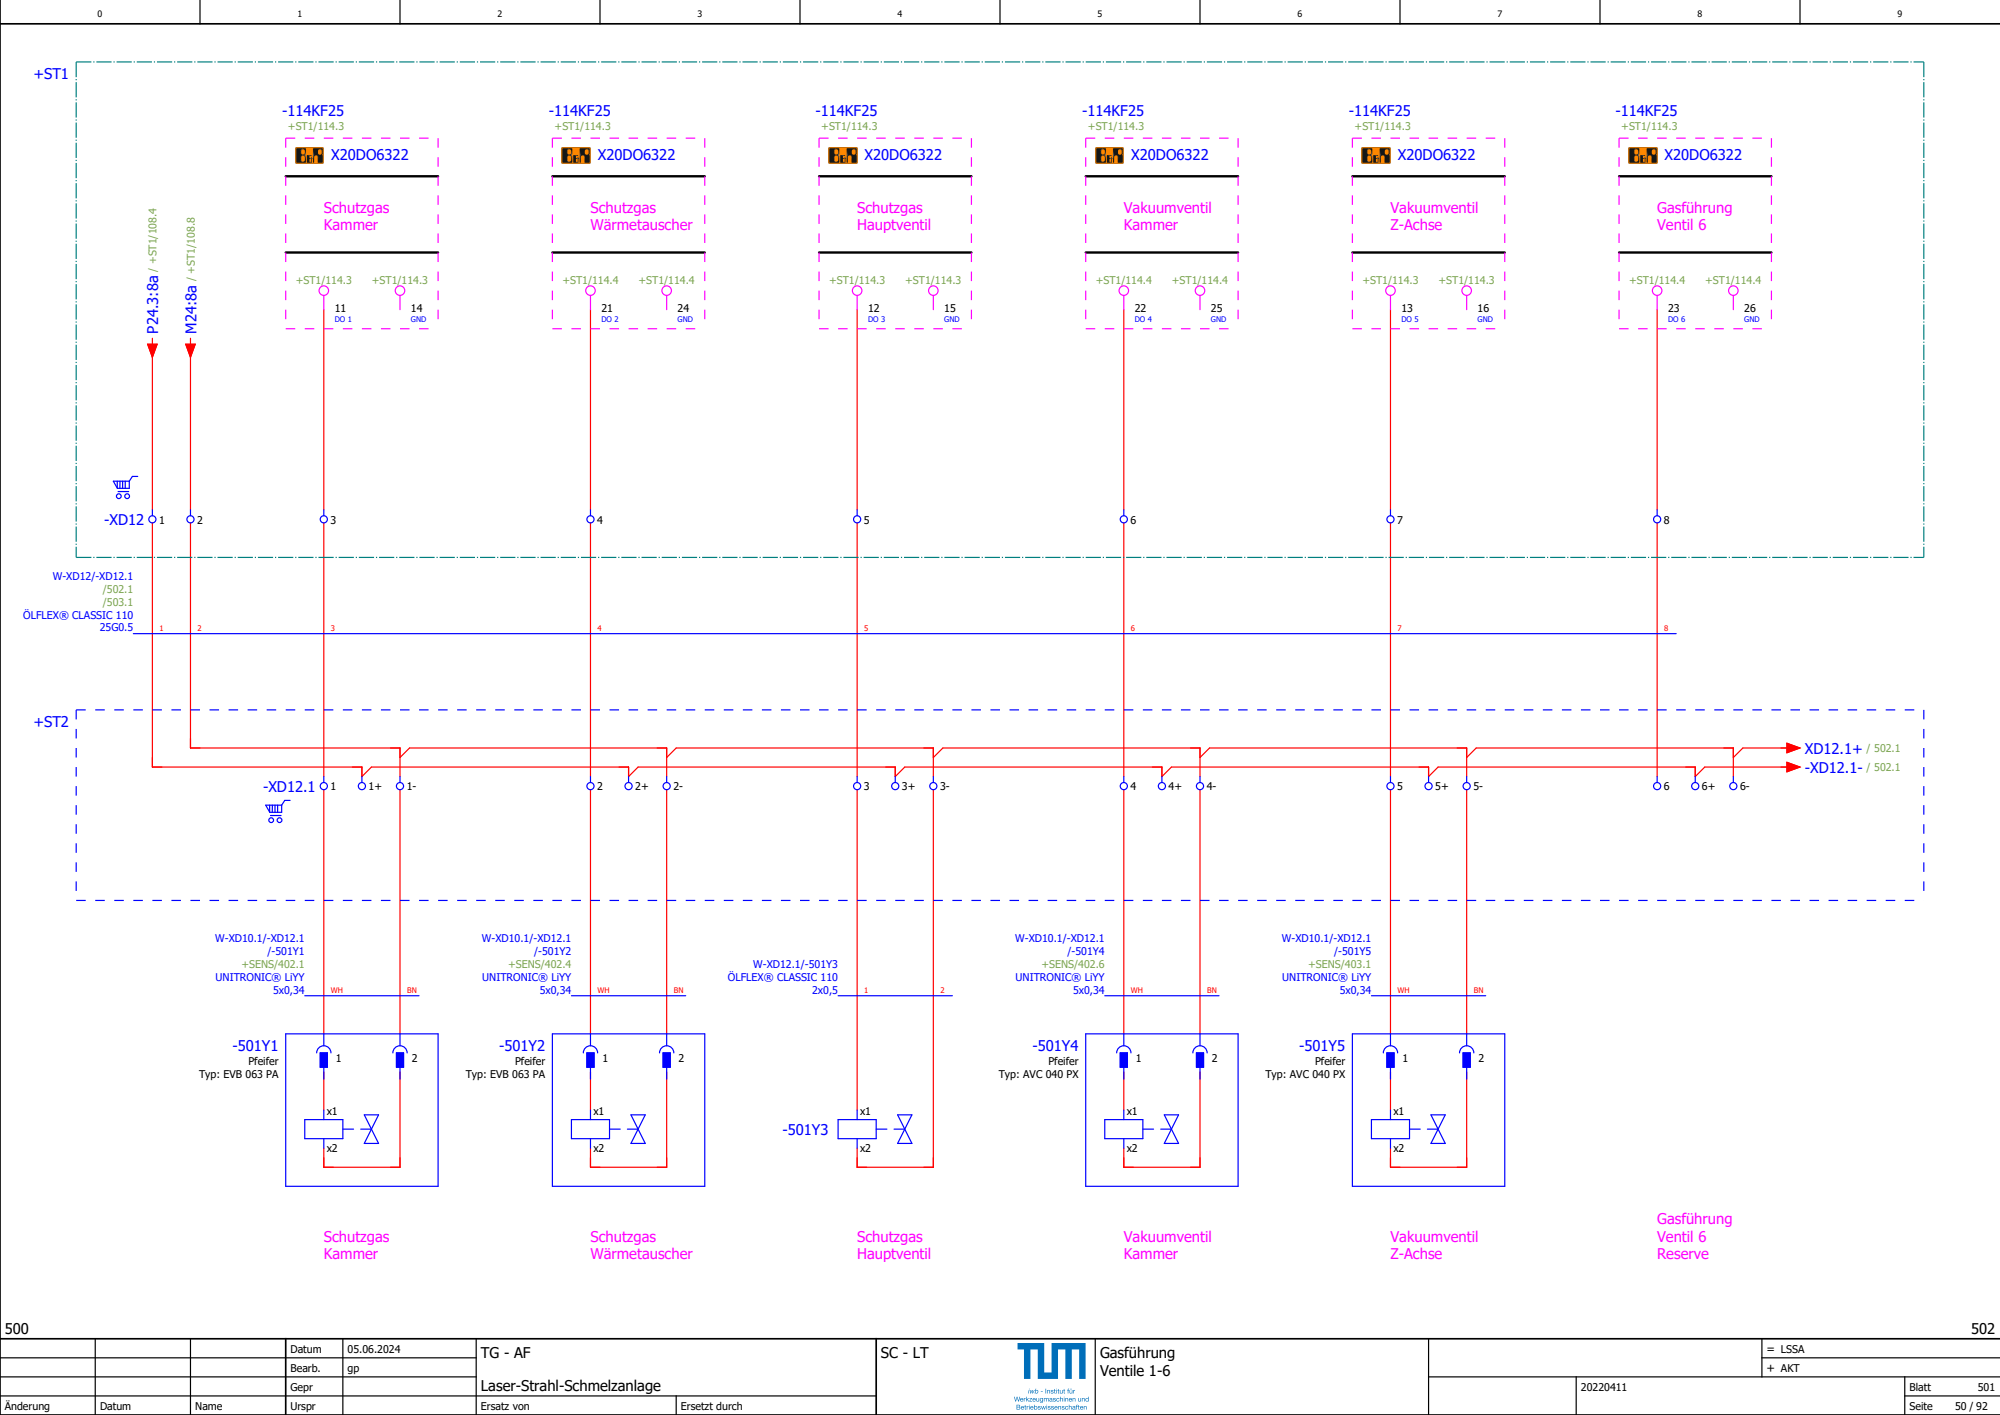
[picture p45: page 50]
AKT; Gasführung Ventile 1-6; GND; Schutzgas Wärmetauscher; Schutzgas Hauptventil; Vakuumventil Kammer; Vakuumventil Z-Achse; Gasführung Ventil 6; Schutzgas Kammer; Gasführung Ventil 6 Reserve; ÖLFLEX® CLASSIC 110; UNITRONIC® LiYY; +SENS/402.1; Pfeifer; +SENS/402.4; +SENS/402.6; +SENS/403.1

Typ: EVB 063 PA

Typ: AVC 040 PX

## Gasführung Ventil 7

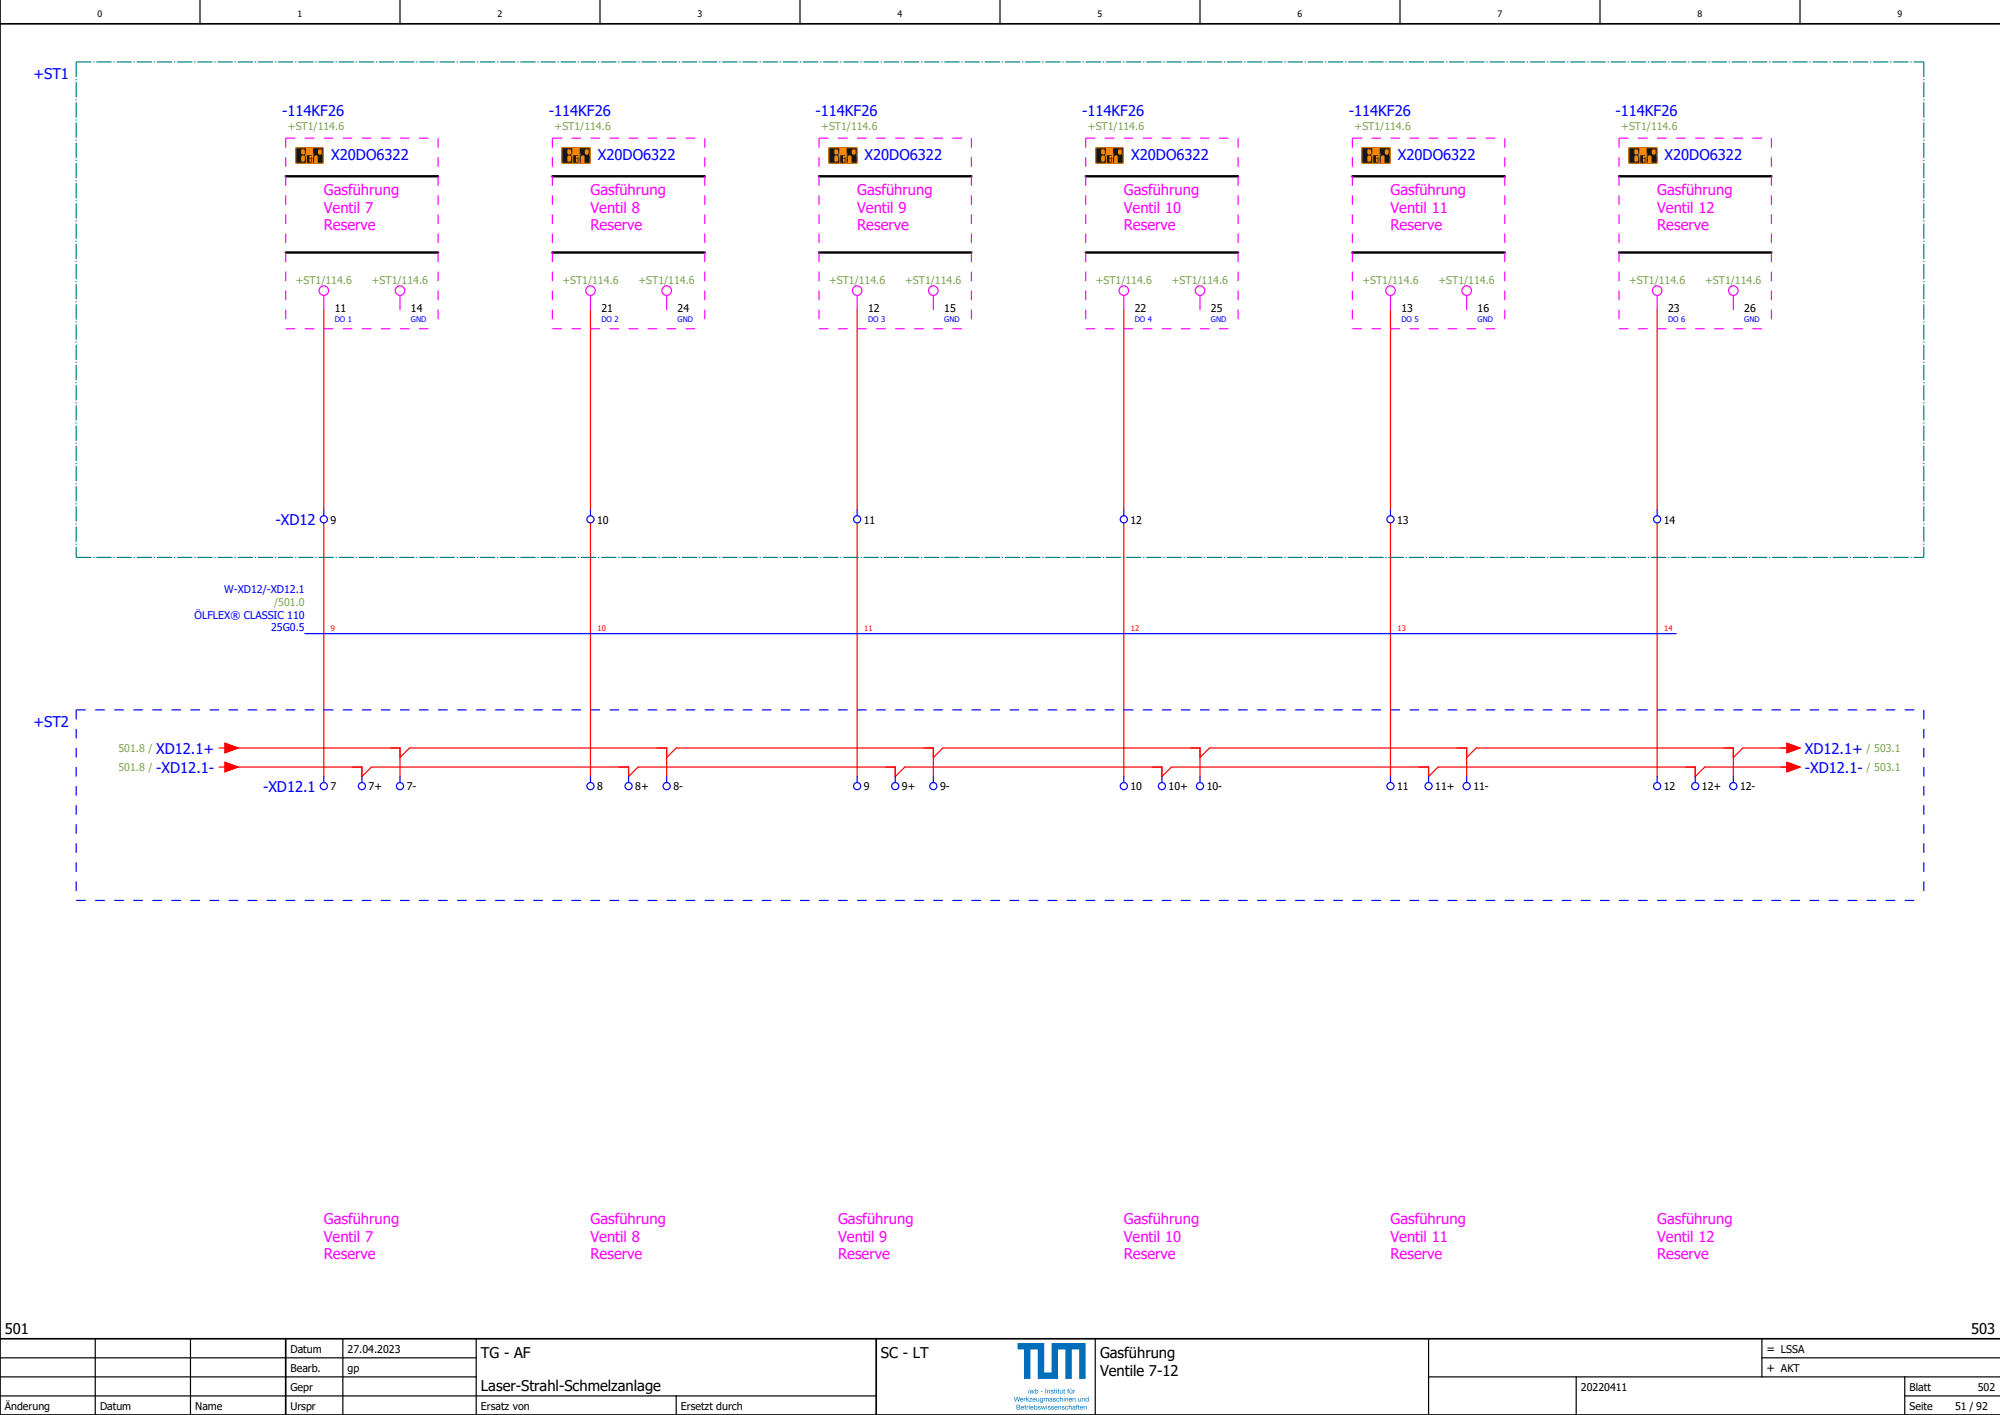
[picture p46: page 51]
AKT; Gasführung Ventile 7-12; Reserve; GND; Gasführung Ventil 8 Reserve; Gasführung Ventil 9 Reserve; Gasführung Ventil 10 Reserve; Gasführung Ventil 11 Reserve; Gasführung Ventil 12 Reserve; Gasführung Ventil 7 Reserve; ÖLFLEX® CLASSIC 110

## Gasführung Ventil 13

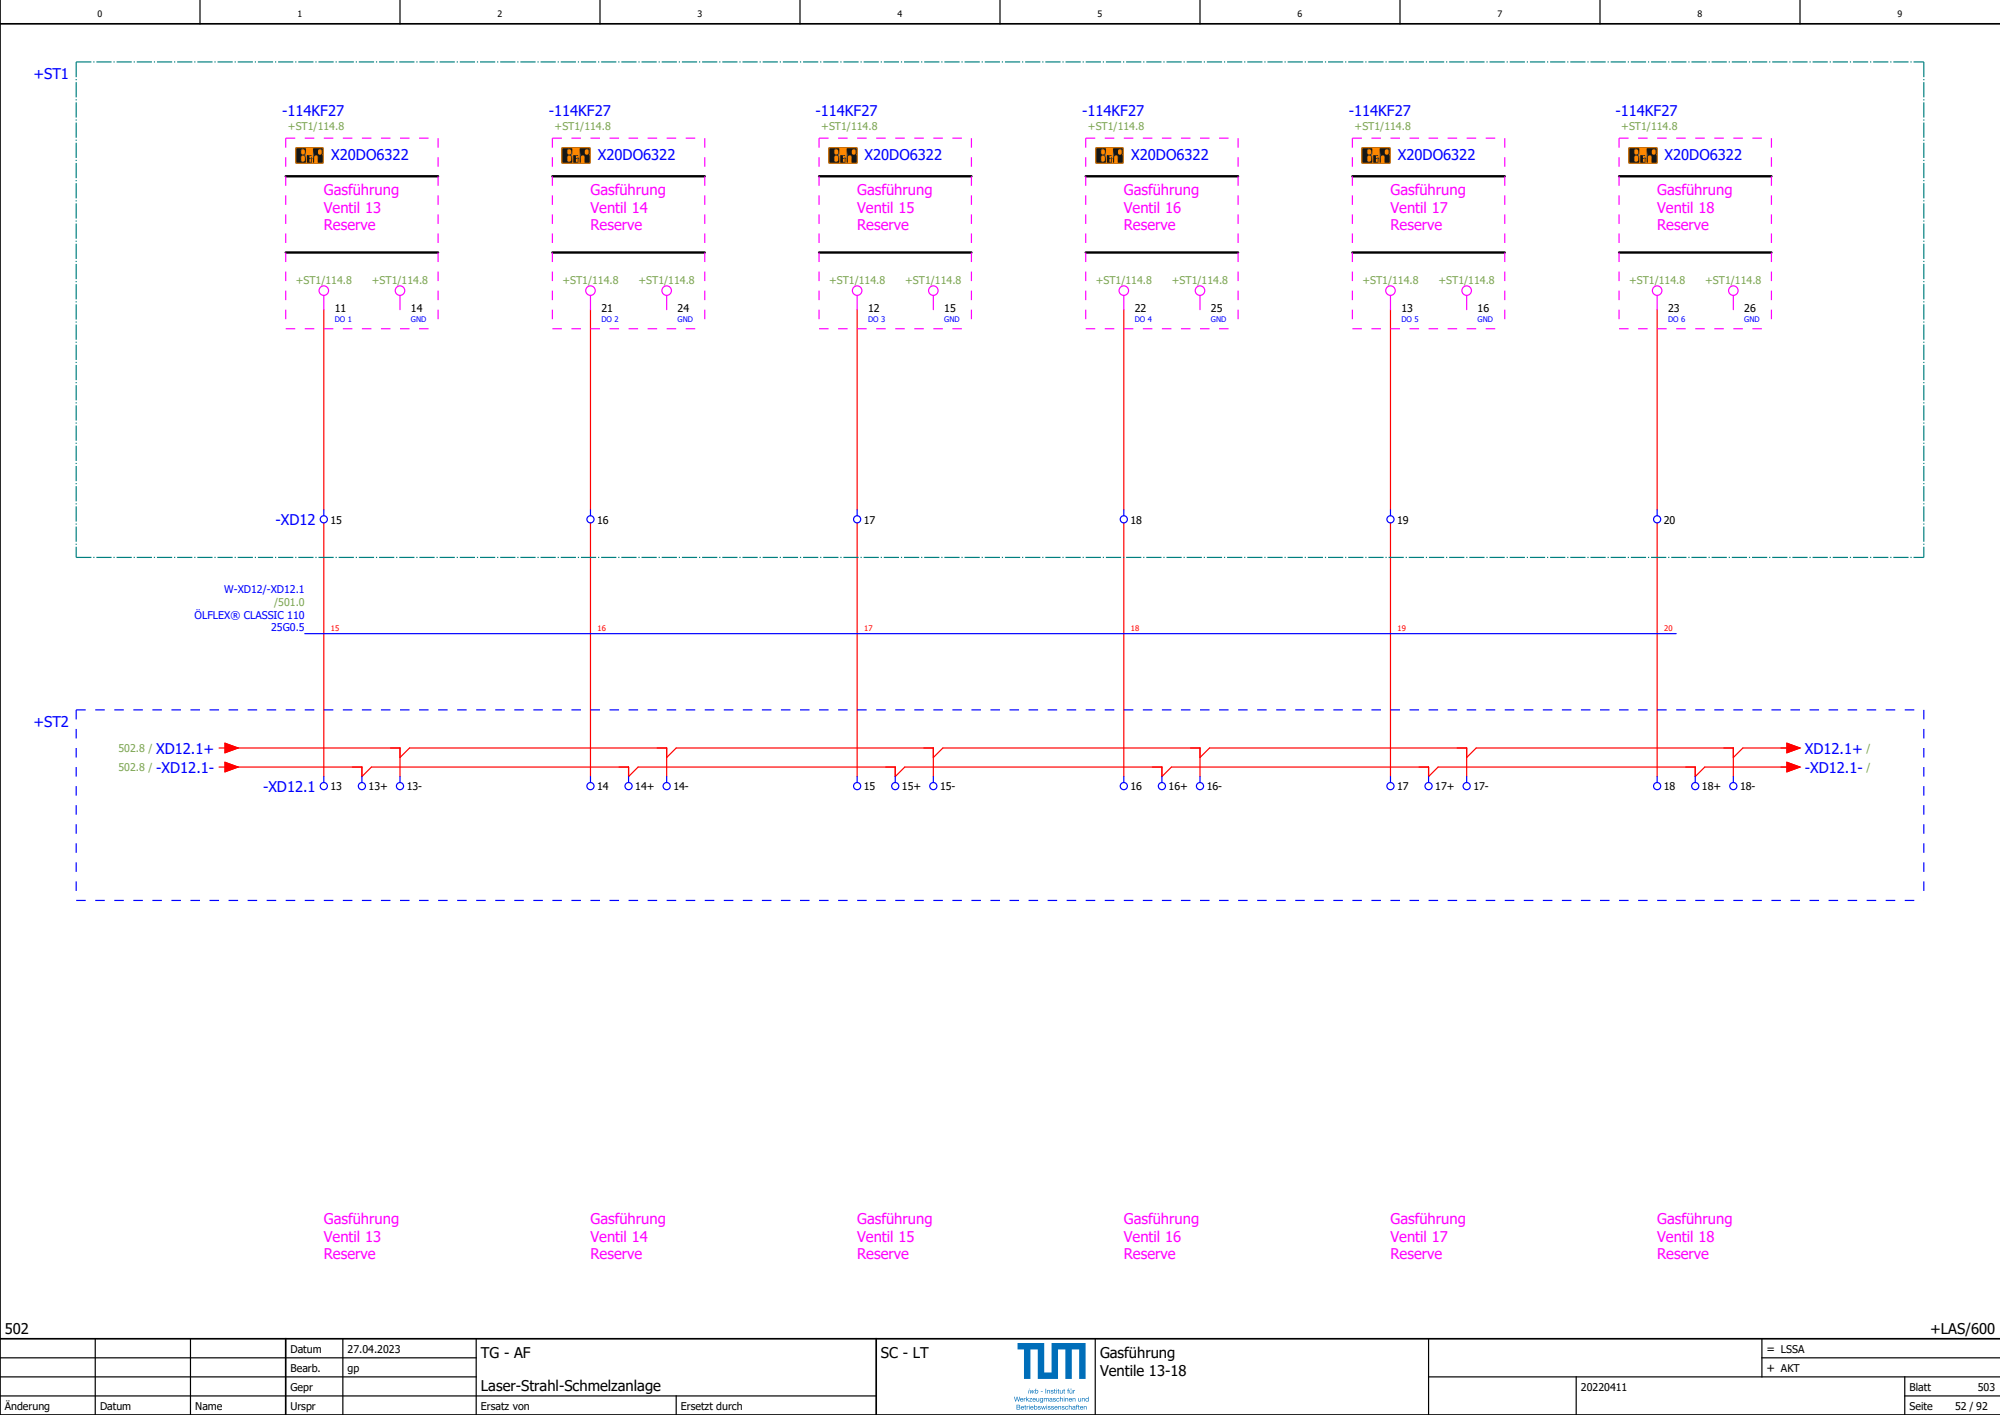
[picture p47: page 52]
AKT; Gasführung Ventile 13-18; +LAS/600; Reserve; GND; Gasführung Ventil 14 Reserve; Gasführung Ventil 15 Reserve; Gasführung Ventil 16 Reserve; Gasführung Ventil 17 Reserve; Gasführung Ventil 18 Reserve; Gasführung Ventil 13 Reserve; ÖLFLEX® CLASSIC 110

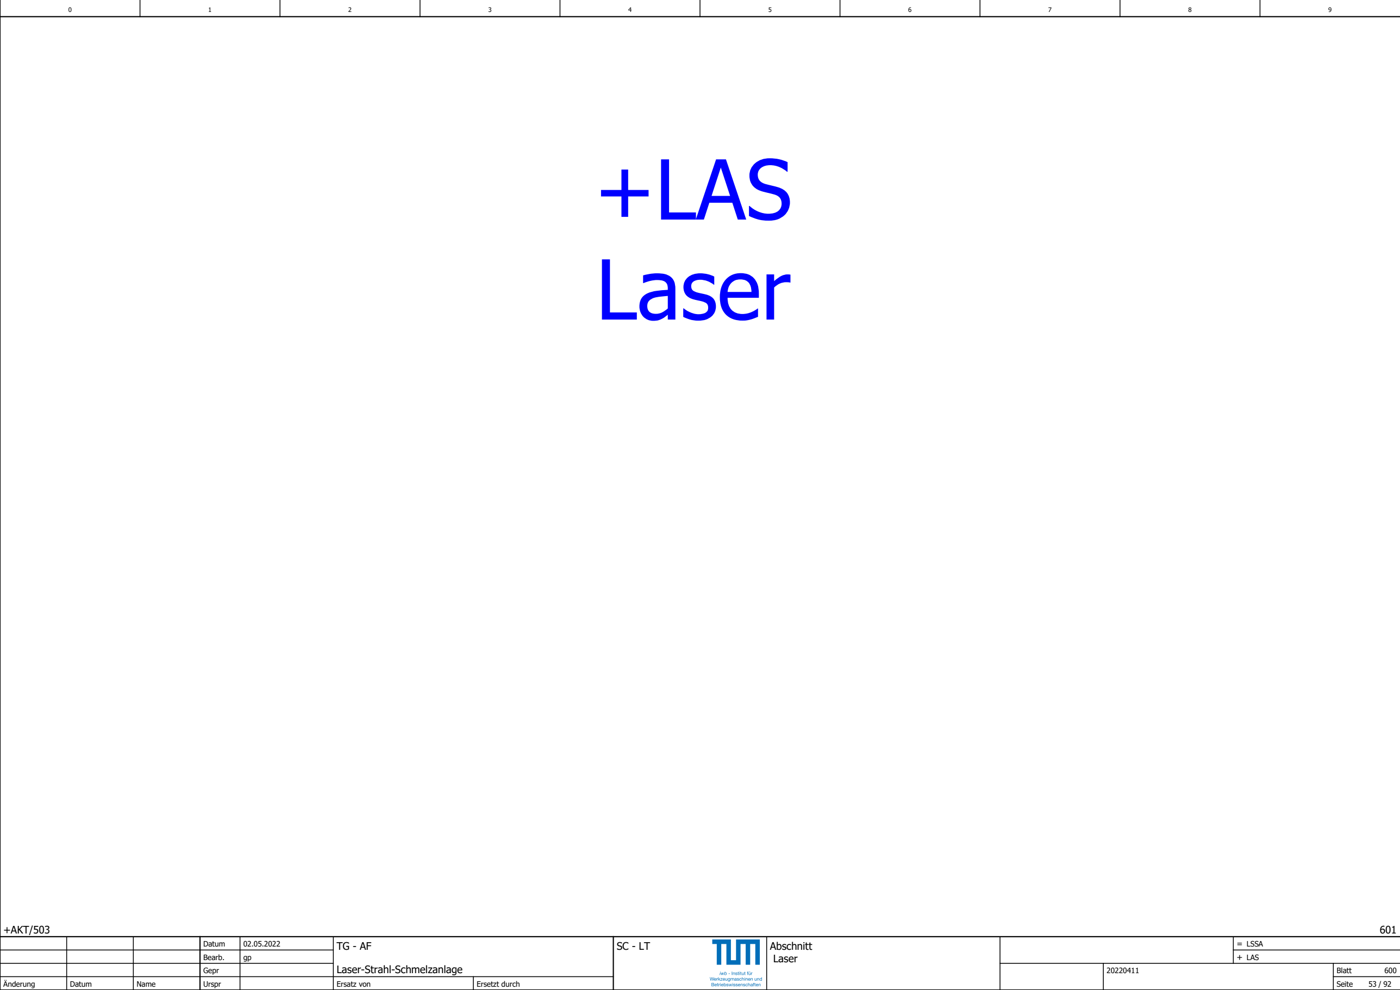
[picture p48: figure]
+AKT/503; LAS; Abschnitt Laser; +LAS Laser

## Laser Extern

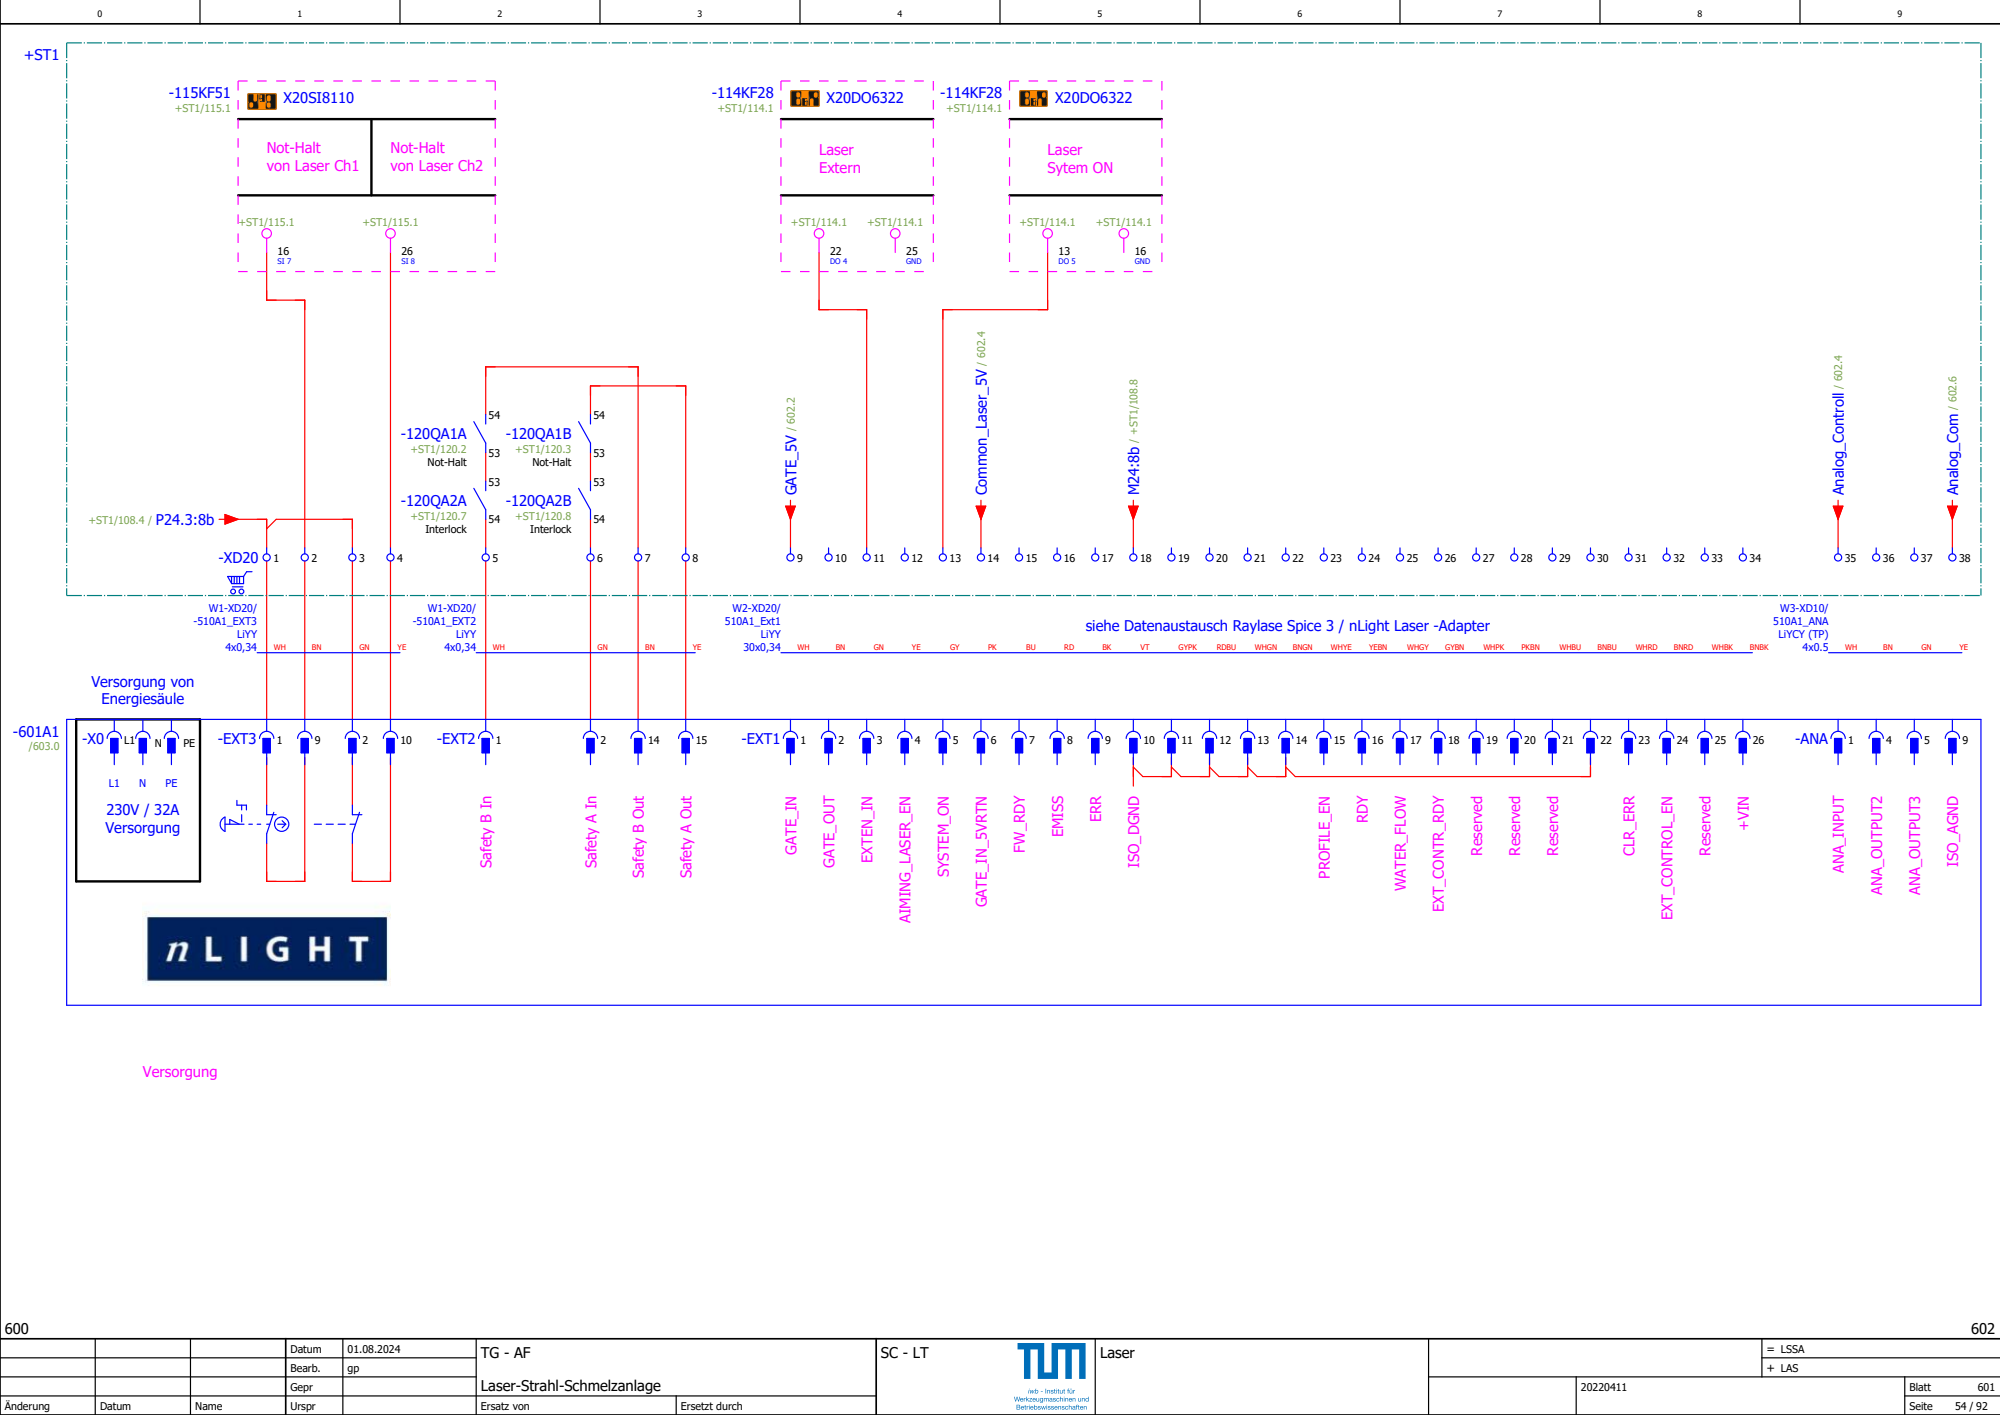
[picture p49: page 54]
LAS; Laser; 230V / 32A Versorgung; Versorgung von Energiesäule; Versorgung; Safety B In; Safety A In; Safety B Out; Safety A Out; GATE_IN; EXTEN_IN; SYSTEM_ON; ISO_DGND; +VIN; EMISS; ERR; RDY; GATE_OUT; AIMING_LASER_EN; GATE_IN_5VRTN; FW_RDY; PROFILE_EN; WATER_FLOW; EXT_CONTR_RDY; Reserved; CLR_ERR; EXT_CONTROL_EN; ISO_AGND; ANA_INPUT; ANA_OUTPUT2; ANA_OUTPUT3; GND; Laser Sytem ON; Not-Halt von Laser Ch1; Not-Halt von Laser Ch2; -EXT2; -EXT1; LiYY; W1-XD20/ -510A1_EXT2; -ANA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

siehe Datenaustausch Raylase Spice 3 / nLight Laser -Adapter

-602KF1

## A1 A2 -602KF2

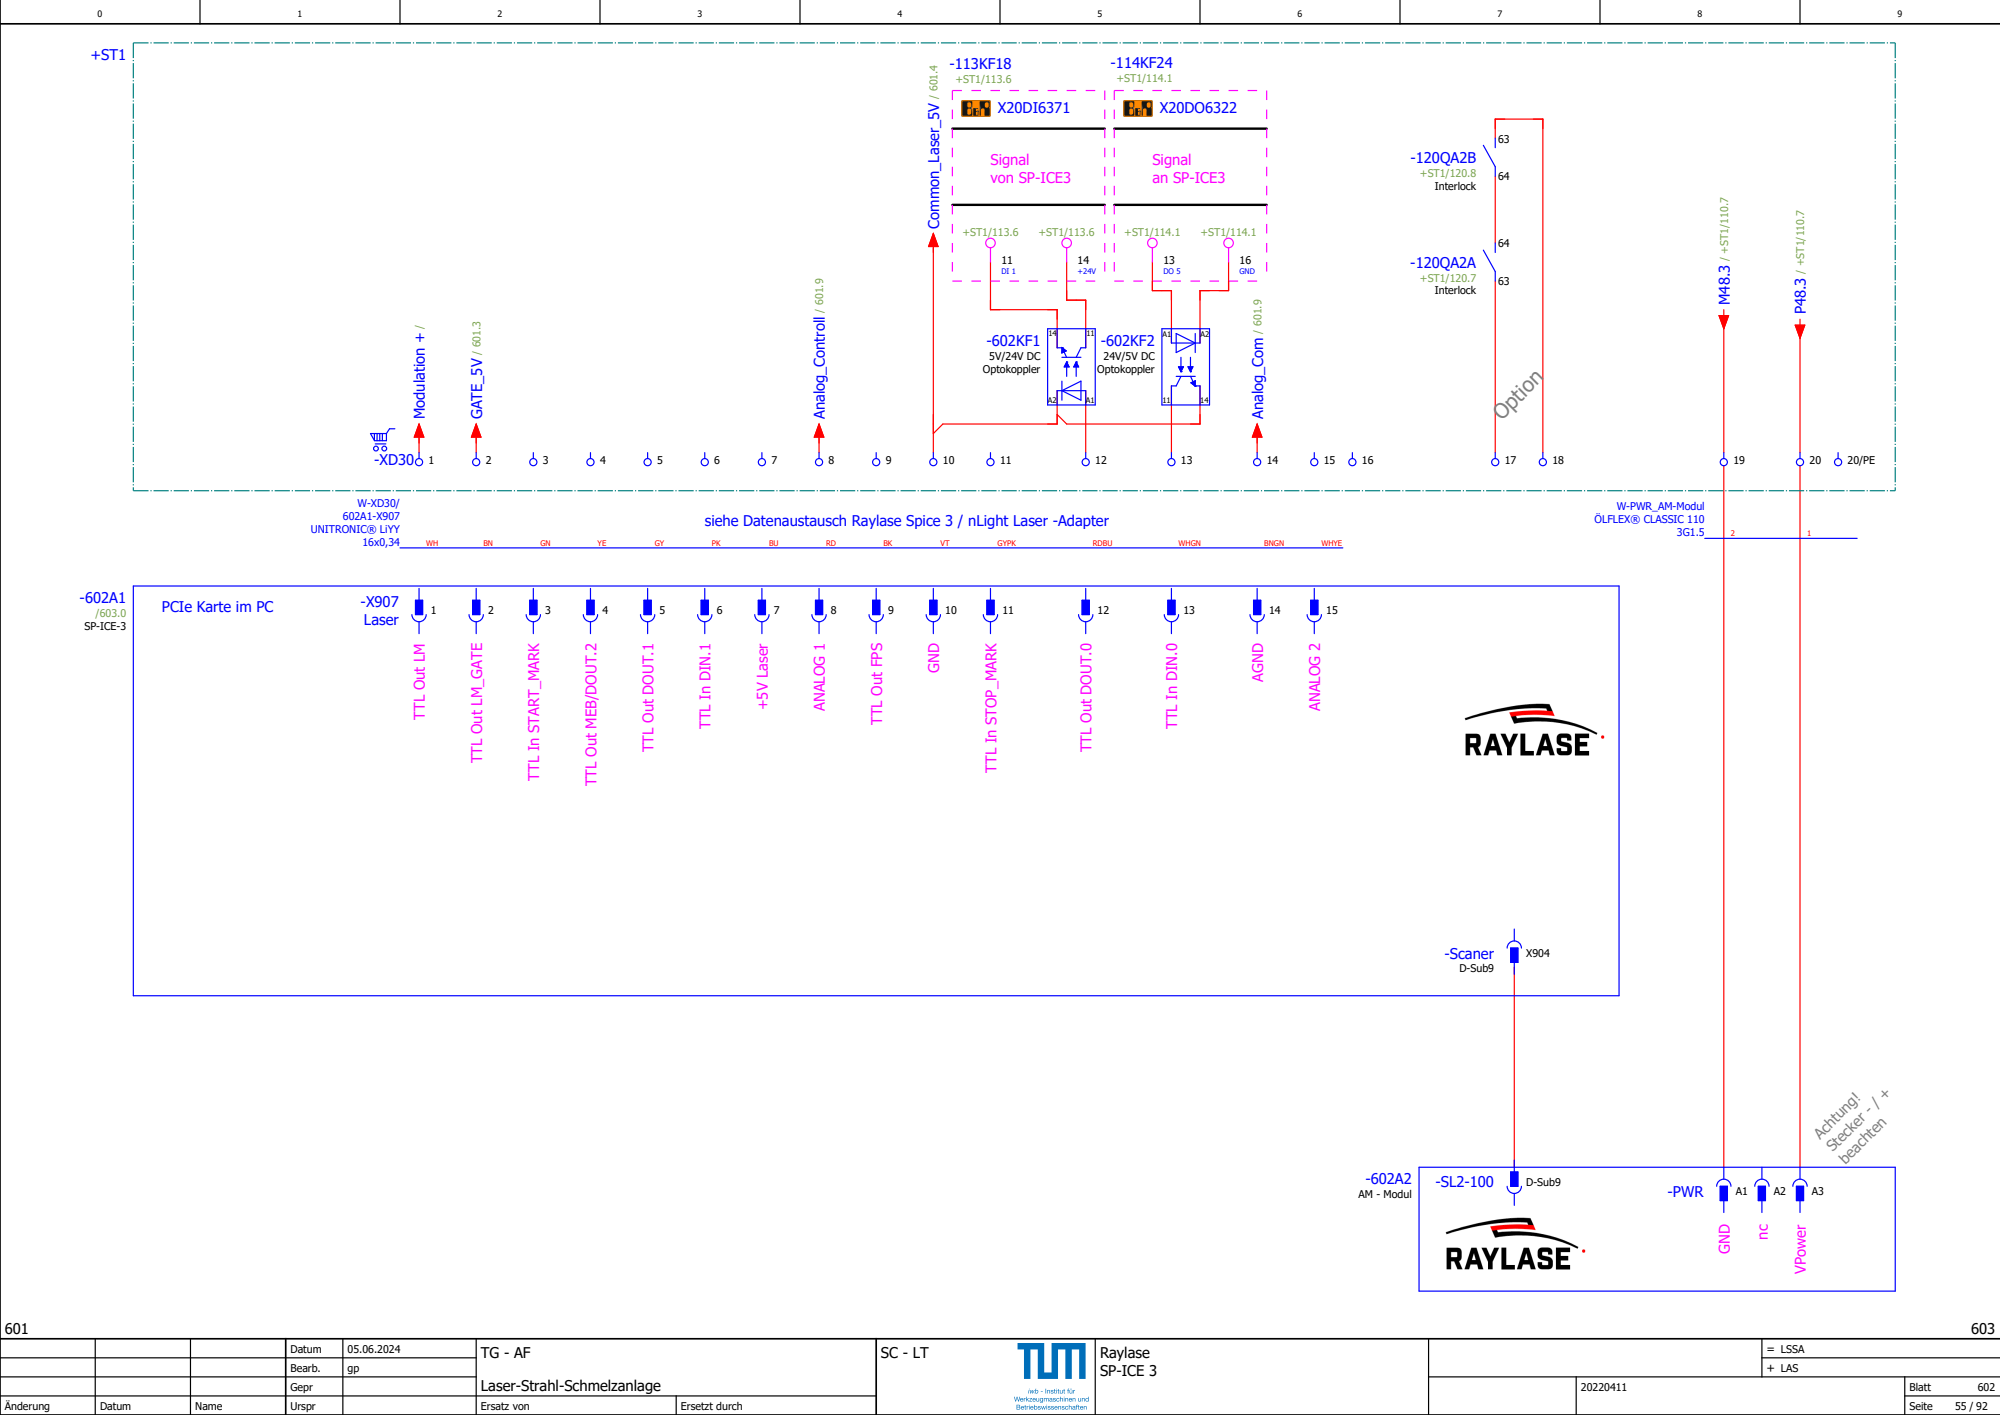
[picture p50: page 55]
LAS; Raylase SP-ICE 3; GND; VPower; TTL Out LM_GATE; TTL In START_MARK; +5V Laser; ANALOG 1; TTL In STOP_MARK; AGND; ANALOG 2; Achtung!; Stecker - / +; beachten; Option; 5V/24V DC Optokoppler; 24V/5V DC Optokoppler; Signal an SP-ICE3; Signal von SP-ICE3; /603.0 SP-ICE-3; AM - Modul; -Scaner; D-Sub9; -PWR; +ST1/120.8 Interlock; ÖLFLEX® CLASSIC 110; W-PWR_AM-Modul; +ST1/120.7 Interlock; Laser; UNITRONIC® LiYY; GYPK; RDBU; WHGN; BNGN; WHYE; Analog_Controll / 601.9; Analog_Com / 601.9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

siehe Datenaustausch Raylase Spice 3 / nLight Laser -Adapter

PCIe Karte im PC

TTL Out LM

TTL Out MEB/DOUT.2

TTL Out DOUT.1

TTL In DIN.1

TTL Out FPS

TTL Out DOUT.0

TTL In DIN.0

-602A1

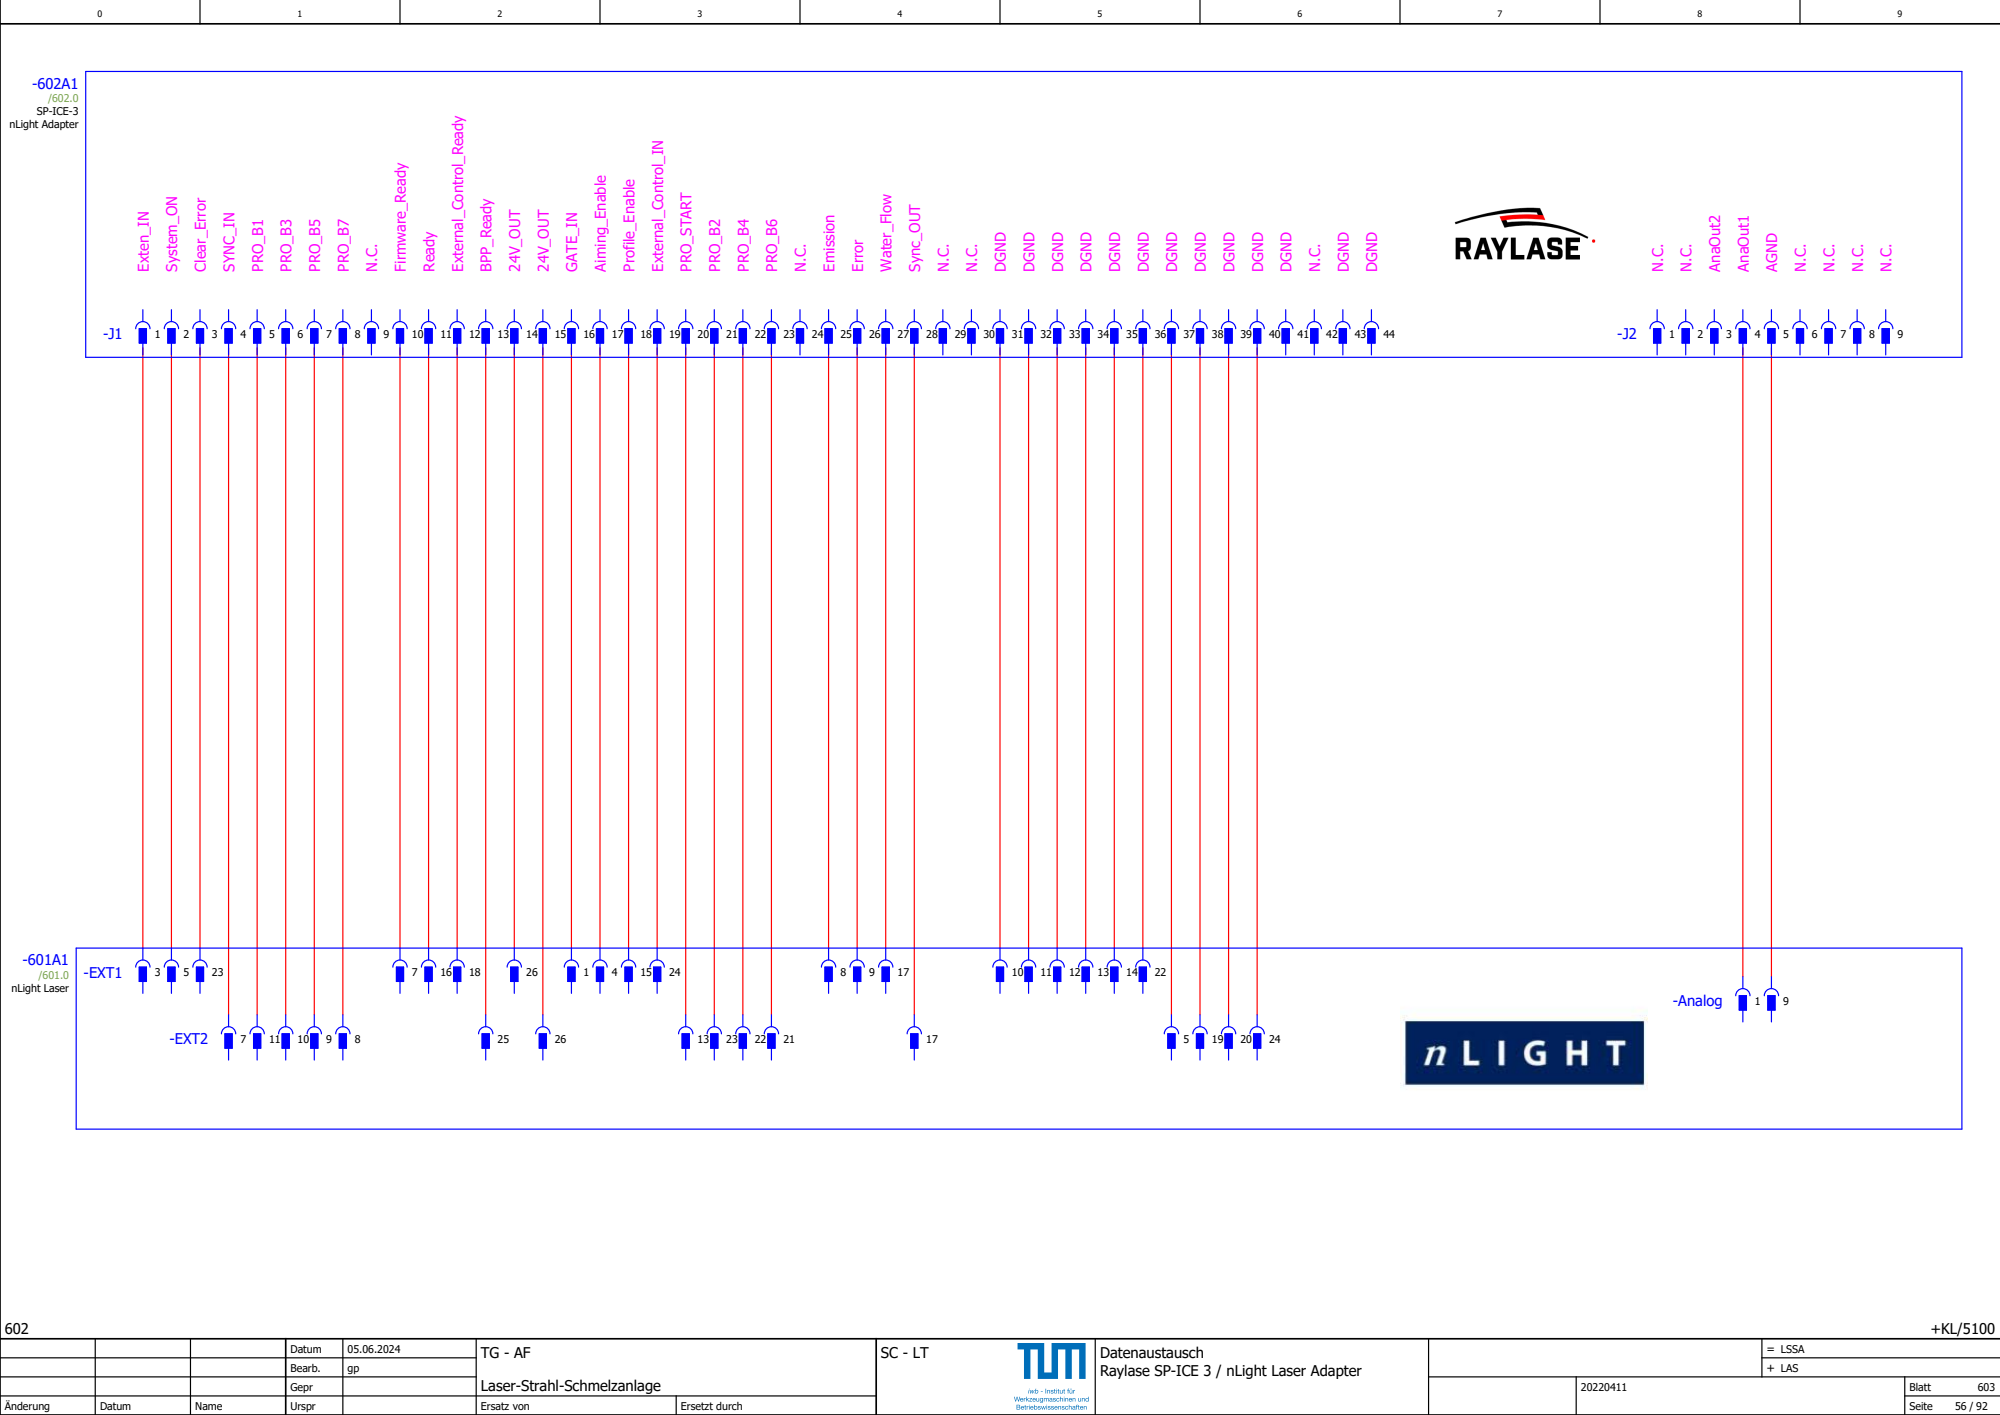
[picture p51: page 56]
LAS; Exten_IN; System_ON; Clear_Error; SYNC_IN; PRO_B1; PRO_B3; PRO_B5; PRO_B7; Firmware_Ready; Ready; External_Control_Ready; BPP_Ready; 24V_OUT; GATE_IN; Aiming_Enable; Profile_Enable; External_Control_IN; PRO_START; PRO_B2; PRO_B4; PRO_B6; Emission; Error; Water_Flow; Sync_OUT; DGND; AnaOut2; AnaOut1; AGND; /601.0 nLight Laser; /602.0 SP-ICE-3 nLight Adapter; -EXT1; -EXT2; -Analog

Datenaustausch
Raylase SP-ICE 3 / nLight Laser Adapter

## +LAS/603

KL

## Klemmenplan +ST1-XD0

## Kabeltyp

## Anschluss Klemme Brücke

Funktionstext | | Leiste +ST1-XD0 | | | | | Seite / Spalte
| Zielbezeichnung | | | Zielbezeichnung Kabeltyp
Einspeisung: 3x230/400V 50Hz N+PE Vorsicherung: max. 16A | | | L1 | | -105QB1 | 2 | | =LSSA/105.0
= | | | L2 | | -105QB1 | 3 | | =LSSA/105.1
= | | | L3 | | -105QB1 | 5 | | =LSSA/105.1
= | | | L3 | | | | | | =LSSA/105.1
= | | | N | | | -XDN | N | | =LSSA/105.2
= | | | PE | | | -XPE | 1 | | =LSSA/105.3

## Kabelname

F13_001

## Kabelname

# Klemmenplan

## Anschluss

KL

## Klemmenplan +ST1-XD1

## Kabeltyp

## Anschluss Klemme Brücke

Funktionstext | | | | | | | | Leiste +ST1-XD1 | | | | | | Seite / Spalte
| | | | | | | Zielbezeichnung | | | | Zielbezeichnung Kabeltyp
Umwälzpumpe | | | | | | 1 | | +ANL-310A1-X1 | L1 | 1 | | -310Q1 | 2/T1 | | =LSSA+ANL/310.1
= | | | | | | 2 | | +ANL-310A1-X1 | L2 | 2 | | -310Q1 | 4/T2 | | =LSSA+ANL/310.1
= | | | | | | 3 | | +ANL-310A1-X1 | L3 | 3 | | -310Q1 | 6/T3 | | =LSSA+ANL/310.1
= | | | | | | GNYE | | +ANL-310A1-X1 | PE | 4/PE | | | | | =LSSA+ANL/310.1
Vakuumpumpe | | | | | 1 | | | +ANL-311MA1 | U1 | 5 | | -311QA1 | 2/T1 | | =LSSA+ANL/311.1
= | | | | | 2 | | | +ANL-311MA1 | V1 | 6 | | -311QA1 | 4/T2 | | =LSSA+ANL/311.2
= | | | | | 3 | | | +ANL-311MA1 | W1 | 7 | | -311QA1 | 6/T3 | | =LSSA+ANL/311.2
= | | | | | GNYE | | | +ANL-311MA1 | PE | 8/PE | | | | | =LSSA+ANL/311.2
Bauplattform Heizung | | | | 1 | | | | | | 9 | | -315QA1 | 13 | | =LSSA+ANL/315.1
= | | | | 2 | | | | +ANL-315E1 | N | 10 | | -XDN | N | | =LSSA+ANL/315.2
= | | | | GNYE | | | | +ANL-315E1 | PE | 11/PE | | | | | =LSSA+ANL/315.2
Bremse Z- Achse | | | WS/RT | | | | | +ANL-301MA1-X2 | 1 | 12 | | -301A1 | X2:6 | | =LSSA+ANL/301.4
= | | | WS | | | | | +ANL-301MA1-X2 | 2 | 13 | | -XDM24 | 7 | | =LSSA+ANL/301.4
Bremse Beschichter | | WS/RT | | | | | | +ANL-303MA1-X2 | 1 | 14 | | -303A1 | X2:6 | | =LSSA+ANL/303.4
| | WS | | | | | | +ANL-303MA1-X2 | 2
Umwälzpumpe Gasführung Fehler | 1 | | | | | | | +ANL-310MA2 | U1(L) | 16 | | -310KF2 | 14 | | =LSSA+ANL/310.7
= | 2 | | | | | | | +ANL-310MA2 | V1(N) | 17 | | -XDN | N | | =LSSA+ANL/310.7
= | GNYE | | | | | | | +ANL-310MA2 | PE | 17/PE | | | | | =LSSA+ANL/310.8

## Kabelname

F13_001

## Kabelname

# Klemmenplan

## Anschluss

### W-XD1/-310A1-X1 ÖLFLEX® CLASSIC 110

### W-XD1/-311MA1 ÖLFLEX® CLASSIC 110

### W-XD1/-315E1 ÖLFLEX® CLASSIC 110

W-301A1/-301MA1

= | 15 | -XDM24 | 7 | =LSSA+ANL/303.4 W-303A1/-303MA1

### W-XD1/-310MA2 ÖLFLEX® CLASSIC 110

KL

## Klemmenplan +ST1-XD01

## Kabeltyp

## Anschluss Klemme Brücke

Funktionstext | | Leiste +ST1-XD01 | | | | | | Seite / Spalte
| Zielbezeichnung | | | | Zielbezeichnung Kabeltyp
Servicesteckdose | | -106XD230 | L | 1 | | -106FC1 | 2 | | =LSSA/106.1
= | | -106XD230 | N | 2 | | -XDN | N | | =LSSA/106.1
= | | -106XD230 | PE | 3 | | -XPE | 1 | | =LSSA/106.1
Beleuchtung Bauraum | | | | 4 | | -106SF1 | 14 | | =LSSA/106.3
= | | | | 5 | | | | | =LSSA/106.3
= | | | | 6 | | | | | =LSSA/106.3

## Kabelname

F13_001

## Kabelname

# Klemmenplan

## Anschluss

KL

## Klemmenplan +ST1-XD6

5103.a

## Kabeltyp

## Anschluss Klemme Brücke

Funktionstext | | | Leiste +ST1-XD6 | | | | | | Seite / Spalte
| | Zielbezeichnung | | | | Zielbezeichnung Kabeltyp
Not-Halt 1 | 1 | | -131FN1 | 11 | 1 | | -131FN01 | 22 | | =LSSA/131.1
= | 2 | | -131FN1 | 12 | 2 | | | | | =LSSA/131.2
= | 3 | | -131FN1 | 21 | 3 | | | -131FN01 | 22 | | =LSSA/131.2
Not-Halt Kanal 1 | 4 | | -131FN1 | 22 | 4 | | | | | | =LSSA/131.2
= | GNGE | | -131FN1 | PE | 4/PE | | | | | | | =LSSA/131.2

## Kabelname

F13_001

## Kabelname

# Klemmenplan

## Anschluss

### W-XD6-131FN1 ÖLFLEX CLASSIC 110

### W-XD6-131FN2 ÖLFLEX CLASSIC 110

### W-XD6-132FN1 ÖLFLEX® CLASSIC 110

W-XD6-132FN2 PUR

### W-XD6-133PF1 ÖLFLEX® CLASSIC 110

Not-Halt 2 | 1 | -131FN2 | 11 | 5 | | | =LSSA/131.3
= | 2 | -131FN2 | 12 | 6 | -115KF51 | 12 | =LSSA/131.3
= | 3 | -131FN2 | 21 | 7 | | | =LSSA/131.4
Not-Halt Kanal 2 | 4 | -131FN2 | 22 | 8 | -115KF51 | 22 | =LSSA/131.4
= | GNGE | -131FN2 | PE | 8/PE | | | =LSSA/131.4
Schutztür Prozesskammer | 1 | -132FN1 | 21 | 9 | -115KF51 | 13 | =LSSA/132.1
= | 2 | -132FN1 | 22 | 10 | -115KF51 | 14 | =LSSA/132.1
Schutztür Prozesskammer Kanal 1 | 3 | -132FN1 | 31 | 11 | -115KF51 | 23 | =LSSA/132.2
= | 4 | -132FN1 | 32 | 12 | -115KF51 | 24 | =LSSA/132.2
Türzuhaltung Entriegeln | 5 | -132FN1 | E1 | 13 | -114KF24 | 11 | =LSSA/132.3
| | | | | -132PF1 | x1
Türzuhaltung Entriegeln | 6 | -132FN1 | E2 | 14 | -114KF24 | 14 | =LSSA/132.3
| | | | | -132PF1 | x2
Türzuhaltung Entriegeln | GNGE | -132FN1 | PE | 14/PE | | | =LSSA/132.3
Schutztür Abdeckung | BN | -132FN2 | BR | 15 | -XDP24 | 5 | =LSSA/132.7
= | BU | -132FN2 | BU | 16 | -XDM24 | 5 | =LSSA/132.7
Schutztür Abdeckung Kanal 1 | WH | -132FN2 | WH | 17 | -115KF53a | 14 | =LSSA/132.8
Schutztür Abdeckung Kanal 2 | BK | -132FN2 | BK | 18 | -115KF53a | 24 | =LSSA/132.8
= | | | | 19 | | | =LSSA/132.9
= | | | | 20 | | | =LSSA/132.9
= | | | | 20/PE | | | =LSSA/132.9
Ampel ROT | 1 | -133PF1 | RD | 21 | -114KF24 | 21 | =LSSA/133.2
Signal - Ampel | 2 | -133PF1 | GE | 22 | -114KF24 | 12 | =LSSA/133.2
= | 3 | -133PF1 | GN | 23 | -114KF24 | 22 | =LSSA/133.3
Ampel GELB | 4 | -133PF1 | GND | 24 | -XDM24 | 7 | =LSSA/133.3
= | GNYE | -133PF1 | PE | 24/PE | | | =LSSA/133.4

KL

## Klemmenplan +ST1-XD6

5103.a

## Kabeltyp

## Anschluss Klemme Brücke

Funktionstext | | Leiste +ST1-XD6 | | Seite / Spalte
| Zielbezeichnung | | Zielbezeichnung Kabeltyp

## Kabelname

F13_001

## Kabelname

# Klemmenplan

## Anschluss

### W-XD1/-310A1-X5/6 ÖLFLEX® CLASSIC 110

Umwälzpumpe | | 1 | +ASP-X5 | 1 | 25 | -310KF1 | 11 | =LSSA+ANL/310.2
Umwälzpumpe Gasführung | BN | | +ASP-X5 | 16 | 32 | -112KF12 | 13 | =LSSA+ANL/310.5
= | | 2 | +ASP-X5 | 3 | 26 | -310KF1 | 14 | =LSSA+ANL/310.3
| WS
Umwälzpumpe Gasführung | | 3 | +ANL-310A1-X6 | 1 | 27 | -113KF18 | 24 | =LSSA+ANL/310.5
Umwälzpumpe Gasführung Betrieb | | 4 | +ANL-310A1-X6 | 2 | 28 | -113KF18 | 21 | =LSSA+ANL/310.5
= | | 5 | +ANL-310A1-X7 | 1 | 29 | -113KF18 | 15 | =LSSA+ANL/310.6
= | | 6 | +ANL-310A1-X7 | 3 | 30 | -113KF18 | 12 | =LSSA+ANL/310.6
Umwälzpumpe Gasführung SOLL 0-100% | +ASP-X5 | 19 | 31 | -112KF12 | 12 | =LSSA+ANL/310.5 W-112KF12/-310A1-X5 UNITRONIC® LiYCY (TP)

5103.a

KL

## Klemmenplan +ST1-XD10

## Kabeltyp

## Anschluss Klemme Brücke

Funktionstext | | | Leiste +ST1-XD10 | | | | | | Seite / Spalte
| | Zielbezeichnung | | | | Zielbezeichnung Kabeltyp
| 1 | | +ST2-XD10.1 | 1+ | 1 | | -XDP24 | 7 | | =LSSA+SENS/401.0
| 2 | | +ST2-XD10.1 | 1- | 2 | | -XDM24 | 7 | | =LSSA+SENS/401.0
Z-Achse Endlage (-) Unten | 3 | | +ST2-XD10.1 | 1 | 3 | | -113KF16 | 11 | | =LSSA+SENS/401.1
Z-Achse Endlage (+) Oben | 4 | | +ST2-XD10.1 | 2 | 4 | | -113KF16 | 21 | | =LSSA+SENS/401.2
Achse Beschichter Endlage (-) | 5 | | +ST2-XD10.1 | 3 | 5 | | -113KF16 | 12 | | =LSSA+SENS/401.4
Achse Beschichter Endlage (+) | 6 | | +ST2-XD10.1 | 4 | 6 | | -113KF16 | 22 | | =LSSA+SENS/401.5
Achse Beschichter Ref. (Home) | 7 | | +ST2-XD10.1 | 5 | 7 | | -113KF16 | 13 | | =LSSA+SENS/401.6
Achse Beschichter Ref. (Max.) | 8 | | +ST2-XD10.1 | 6 | 8 | | -113KF16 | 23 | | =LSSA+SENS/401.8
Schutzgas Kammer AUF | 9 | | +ST2-XD10.1 | 7 | 9 | | -113KF17 | 11 | | =LSSA+SENS/402.1
Schutzgas Kammer ZU | 10 | | +ST2-XD10.1 | 8 | 10 | | -113KF17 | 21 | | =LSSA+SENS/402.2
Vakuumvenil Z-Achse AUF | 15 | | +ST2-XD10.1 | 13 | 15 | | -113KF21 | 12 | | =LSSA+SENS/403.1
Vakuumvenil Z-Achse ZU | 16 | | +ST2-XD10.1 | 14 | 16 | | -113KF21 | 22 | | =LSSA+SENS/403.2
Schutzgas Wärmetauscher AUF | 11 | | +ST2-XD10.1 | 9 | 11 | | -113KF17 | 12 | | =LSSA+SENS/402.4
Schutzgas Wärmetauscher ZU | 12 | | +ST2-XD10.1 | 10 | 12 | | -113KF17 | 22 | | =LSSA+SENS/402.5
Reserve | 17 | | +ST2-XD10.1 | 15 | 17 | | | | | =LSSA+SENS/403.4

## Kabelname

F13_001

## Kabelname

# Klemmenplan

## Anschluss

### W-XD10/-XD10.1 ÖLFLEX® CLASSIC 110

Reserve | PE | +ST2-XD10.1 | PE | PE | =LSSA+SENS/403.5
Vakuumventil Kammer AUF | 13 | +ST2-XD10.1 | 11 | 13 | -113KF21 | 11 | =LSSA+SENS/402.6
Vakuumventil Kammer ZU | 14 | +ST2-XD10.1 | 12 | 14 | -113KF21 | 21 | =LSSA+SENS/402.8

KL

## Klemmenplan +ST1-XD11

## Kabeltyp

## Anschluss Klemme Brücke

Funktionstext | | | Leiste +ST1-XD11 | | | | | | Seite / Spalte
| | Zielbezeichnung | | | | Zielbezeichnung Kabeltyp
Temperatur Bauplattform | WH | | +ST2-XD11.1 | 1 | 1 | | -112KF15 | 21 | | =LSSA+SENS/411.1
= | BN | | +ST2-XD11.1 | 2 | 2 | | -112KF15 | 23 | | =LSSA+SENS/411.2
= | GN | | +ST2-XD11.1 | 3 | 3 | | | | | =LSSA+SENS/411.2
= | YE | | +ST2-XD11.1 | 4 | 4 | | | | | =LSSA+SENS/411.3
= | GY | | +ST2-XD11.1 | 5 | 5 | | | | | =LSSA+SENS/411.4
= | PK | | +ST2-XD11.1 | 6 | 6 | | | | | =LSSA+SENS/411.4
= | BU | | +ST2-XD11.1 | 7 | 7 | | | | | =LSSA+SENS/411.5
= | RD | | +ST2-XD11.1 | 8 | 8 | | | | | =LSSA+SENS/411.6
= | BK | | +ST2-XD11.1 | 9 | 9 | | | | | =LSSA+SENS/411.6
= | VT | | +ST2-XD11.1 | 10 | 10 | | | | | =LSSA+SENS/411.7
= | GYPK | | +ST2-XD11.1 | 11 | 11 | | | | | =LSSA+SENS/411.8
= | RDBU | | +ST2-XD11.1 | 12 | 12 | | | | | =LSSA+SENS/411.8
= | | | | | 12/PE | | | | | =LSSA+SENS/411.8

## Kabelname

F13_001

## Kabelname

# Klemmenplan

## Anschluss

W-XD11/-XD11.1 UNITRONIC® LiYCY

W-XD11/-415BO1 PUR

W-XD11/-420BP1 UNITRONIC® LiYCY

O² Sensor Filter | | | BN | +SENS-415BO1 | 1 | 13 | -XDP24 | 8 | =LSSA+SENS/415.2
= | | | WH | +SENS-415BO1 | 3 | 14 | -XDM24 | 8 | =LSSA+SENS/415.2
Druck Sensor Druckluft | | WH | | +SENS-420BP1 | 1+ | 17 | -112KF14 | 14 | =LSSA+SENS/420.1
Sauerstoff Filter Istwert | | | BU | +SENS-415BO1 | 2 | 15 | -112KF14 | 13 | =LSSA+SENS/415.3
= | | | BK | +SENS-415BO1 | 4 | 16 | | | =LSSA+SENS/415.3
Druck Druckluft | | BN | | +SENS-420BP1 | 3- | 18 | -112KF14 | 16 | =LSSA+SENS/420.2
Druck Sensor Schutzgas | WH | | | +SENS-420BP2 | 1+ | 19 | -112KF14 | 24 | =LSSA+SENS/420.2
Druck Schutzgas | BN | | | +SENS-420BP2 | 3- | 20 | -112KF14 | 26 | =LSSA+SENS/420.3

W-XD11/-420BP2 UNITRONIC® LiYCY

KL

## Klemmenplan +ST1-XD12

## Kabeltyp

## Anschluss Klemme Brücke

Funktionstext | | | Leiste +ST1-XD12 | | | | | | Seite / Spalte
| | Zielbezeichnung | | | | Zielbezeichnung Kabeltyp
| 1 | | +ST2-XD12.1 | 1+ | 1 | | -XDP24 | 8 | | =LSSA+AKT/501.0
| 2 | | +ST2-XD12.1 | 1- | 2 | | -XDM24 | 8 | | =LSSA+AKT/501.0
Schutzgas Kammer | 3 | | +ST2-XD12.1 | 1 | 3 | | -114KF25 | 11 | | =LSSA+AKT/501.1
Schutzgas Wärmetauscher | 4 | | +ST2-XD12.1 | 2 | 4 | | -114KF25 | 21 | | =LSSA+AKT/501.2
Schutzgas Hauptventil | 5 | | +ST2-XD12.1 | 3 | 5 | | -114KF25 | 12 | | =LSSA+AKT/501.4
Vakuumventil Kammer | 6 | | +ST2-XD12.1 | 4 | 6 | | -114KF25 | 22 | | =LSSA+AKT/501.5
Vakuumventil Z-Achse | 7 | | +ST2-XD12.1 | 5 | 7 | | -114KF25 | 13 | | =LSSA+AKT/501.6
Gasführung Ventil 6 | 8 | | +ST2-XD12.1 | 6 | 8 | | -114KF25 | 23 | | =LSSA+AKT/501.8
Gasführung Ventil 7 Reserve | 9 | | +ST2-XD12.1 | 7 | 9 | | -114KF26 | 11 | | =LSSA+AKT/502.1
Gasführung Ventil 8 Reserve | 10 | | +ST2-XD12.1 | 8 | 10 | | -114KF26 | 21 | | =LSSA+AKT/502.2
Gasführung Ventil 9 Reserve | 11 | | +ST2-XD12.1 | 9 | 11 | | -114KF26 | 12 | | =LSSA+AKT/502.4
Gasführung Ventil 10 Reserve | 12 | | +ST2-XD12.1 | 10 | 12 | | -114KF26 | 22 | | =LSSA+AKT/502.5
Gasführung Ventil 11 Reserve | 13 | | +ST2-XD12.1 | 11 | 13 | | -114KF26 | 13 | | =LSSA+AKT/502.6
Gasführung Ventil 12 Reserve | 14 | | +ST2-XD12.1 | 12 | 14 | | -114KF26 | 23 | | =LSSA+AKT/502.8
Gasführung Ventil 13 Reserve | 15 | | +ST2-XD12.1 | 13 | 15 | | -114KF27 | 11 | | =LSSA+AKT/503.1
Gasführung Ventil 14 Reserve | 16 | | +ST2-XD12.1 | 14 | 16 | | -114KF27 | 21 | | =LSSA+AKT/503.2
Gasführung Ventil 15 Reserve | 17 | | +ST2-XD12.1 | 15 | 17 | | -114KF27 | 12 | | =LSSA+AKT/503.4
Gasführung Ventil 16 Reserve | 18 | | +ST2-XD12.1 | 16 | 18 | | -114KF27 | 22 | | =LSSA+AKT/503.5
Gasführung Ventil 17 Reserve | 19 | | +ST2-XD12.1 | 17 | 19 | | -114KF27 | 13 | | =LSSA+AKT/503.6
Gasführung Ventil 18 Reserve | 20 | | +ST2-XD12.1 | 18 | 20 | | -114KF27 | 23 | | =LSSA+AKT/503.8

## Kabelname

F13_001

## Kabelname

# Klemmenplan

## Anschluss

### W-XD12/-XD12.1 ÖLFLEX® CLASSIC 110

KL

## Klemmenplan +ST1-XD20

5107.a

## Kabeltyp

## Anschluss Klemme Brücke

Funktionstext | | | | Leiste +ST1-XD20 | | | | | | Seite / Spalte
| | | Zielbezeichnung | | | | Zielbezeichnung Kabeltyp
Not-Halt von Laser Ch1 | | WH | | +LAS-601A1-EXT3 | 1 | 1 | | -XDP24 | 8 | | =LSSA+LAS/601.1
= | | BN | | +LAS-601A1-EXT3 | 9 | 2 | | | -115KF51 | 16 | | =LSSA+LAS/601.1
= | | GN | | +LAS-601A1-EXT3 | 2 | 3 | | | | | | =LSSA+LAS/601.1
Not-Halt von Laser Ch2 | | YE | | +LAS-601A1-EXT3 | 10 | 4 | | | -115KF51 | 26 | | =LSSA+LAS/601.1
Safety B In | WH | | | +LAS-601A1-EXT2 | 1 | 5 | | | -120QA2A | 54 | | =LSSA+LAS/601.2
Safety A In | GN | | | +LAS-601A1-EXT2 | 2 | 6 | | | -120QA2B | 54 | | =LSSA+LAS/601.2
Safety B Out | BN | | | +LAS-601A1-EXT2 | 14 | 7 | | | -120QA1A | 54 | | =LSSA+LAS/601.3
Safety A Out | YE | | | +LAS-601A1-EXT2 | 15 | 8 | | | -120QA1B | 54 | | =LSSA+LAS/601.3
GATE_IN | | | | | | 9 | | | -XD30 | 2 | | =LSSA+LAS/601.3
GATE_OUT | | | | | | 10 | | | | | | =LSSA+LAS/601.4
EXTEN_IN | | | | | | 11 | | | -114KF28 | 22 | | =LSSA+LAS/601.4
AIMING_LASER_EN | | | | | | 12 | | | | | | =LSSA+LAS/601.4
SYSTEM_ON | | | | | | 13 | | | -114KF28 | 13 | | =LSSA+LAS/601.4
GATE_IN_5VRTN | | | | | | 14 | | | -XD30 | 10 | | =LSSA+LAS/601.4
FW_RDY | | | | | | 15 | | | | | | =LSSA+LAS/601.5
EMISS | | | | | | 16 | | | | | | =LSSA+LAS/601.5
ERR | | | | | | 17 | | | | | | =LSSA+LAS/601.5
ISO_DGND | | | | | | 18 | | | -XDM24 | 8 | | =LSSA+LAS/601.5
= | | | | | | 19 | | | | | | =LSSA+LAS/601.5
= | | | | | | 20 | | | | | | =LSSA+LAS/601.6
= | | | | | | 21 | | | | | | =LSSA+LAS/601.6
= | | | | | | 22 | | | | | | =LSSA+LAS/601.6
PROFILE_EN | | | | | | 23 | | | | | | =LSSA+LAS/601.6
RDY | | | | | | 24 | | | | | | =LSSA+LAS/601.6
WATER_FLOW | | | | | | 25 | | | | | | =LSSA+LAS/601.7
EXT_CONTR_RDY | | | | | | 26 | | | | | | =LSSA+LAS/601.7
Reserved | | | | | | 27 | | | | | | =LSSA+LAS/601.7
= | | | | | | 28 | | | | | | =LSSA+LAS/601.7
= | | | | | | 29 | | | | | | =LSSA+LAS/601.7
= | | | | | | 30 | | | | | | =LSSA+LAS/601.7
CLR_ERR | | | | | | 31 | | | | | | =LSSA+LAS/601.8
EXT_CONTROL_EN | | | | | | 32 | | | | | | =LSSA+LAS/601.8
Reserved | | | | | | 33 | | | | | | =LSSA+LAS/601.8
+VIN | | | | | | 34 | | | | | | =LSSA+LAS/601.8
ANA_INPUT | | | | | | 35 | | | -XD30 | 8 | | =LSSA+LAS/601.9

## Kabelname

F13_001

## Kabelname

# Klemmenplan

## Anschluss

W1-XD20/-510A1_EXT3 LiYY

W1-XD20/-510A1_EXT2 LiYY

KL

## Klemmenplan +ST1-XD20

5107.a

## Kabeltyp

## Anschluss Klemme Brücke

Funktionstext | | Leiste +ST1-XD20 | | | | | Seite / Spalte
| Zielbezeichnung | | | Zielbezeichnung Kabeltyp
ANA_OUTPUT2 | | | 36 | | | | | =LSSA+LAS/601.9
ANA_OUTPUT3 | | | 37 | | | | | =LSSA+LAS/601.9
ISO_AGND | | | 38 | | -XD30 | 14 | | =LSSA+LAS/601.9

## Kabelname

F13_001

## Kabelname

# Klemmenplan

## Anschluss

5107.a

KL

## Klemmenplan +ST1-XD30

## Kabeltyp

## Anschluss Klemme Brücke

Funktionstext | | | Leiste +ST1-XD30 | | | | | | Seite / Spalte
| | Zielbezeichnung | | | | Zielbezeichnung Kabeltyp
TTL Out LM | | | | | 1 | | | | | =LSSA+LAS/602.2
TTL Out LM_GATE | | | | | 2 | | -XD20 | 9 | | =LSSA+LAS/602.2
TTL In START_MARK | | | | | 3 | | | | | =LSSA+LAS/602.2
TTL Out MEB/DOUT.2 | | | | | 4 | | | | | =LSSA+LAS/602.2
TTL Out DOUT.1 | | | | | 5 | | | | | =LSSA+LAS/602.3
TTL In DIN.1 | | | | | 6 | | | | | =LSSA+LAS/602.3
+5V Laser | | | | | 7 | | | | | =LSSA+LAS/602.3
ANALOG 1 | | | | | 8 | | -XD20 | 35 | | =LSSA+LAS/602.4
TTL Out FPS | | | | | 9 | | | | | =LSSA+LAS/602.4
GND | | | | | 10 | | -XD20 | 14 | | =LSSA+LAS/602.4
| | | | | | | -602KF1 | A2
Signal von SP-ICE3 | | | | | 11 | | | | | =LSSA+LAS/602.4
TTL Out DOUT.0 | | | | | 12 | | -602KF1 | A1 | | =LSSA+LAS/602.5
TTL In DIN.0 | | | | | 13 | | -602KF2 | 11 | | =LSSA+LAS/602.5
AGND | | | | | 14 | | -XD20 | 38 | | =LSSA+LAS/602.6
ANALOG 2 | | | | | 15 | | | | | =LSSA+LAS/602.6
= | | | | | 16 | | | | | =LSSA+LAS/602.6
= | | | | | 17 | | -120QA2A | 63 | | =LSSA+LAS/602.7
= | | | | | 18 | | -120QA2B | 63 | | =LSSA+LAS/602.7
GND | 2 | | +LAS-602A2-PWR | A1 | 19 | | -XDS48 | 2 | | =LSSA+LAS/602.8
VPower | 1 | | +LAS-602A2-PWR | A3 | 20 | | -XDS48 | 1 | | =LSSA+LAS/602.9
= | | | | | 20/PE | | | | | =LSSA+LAS/602.9

## Kabelname

F13_001

## Kabelname

# Klemmenplan

## Anschluss

### W-PWR_AM-Modul ÖLFLEX® CLASSIC 110

KL

## Klemmenplan +ST1-XDM24

## Kabeltyp

## Anschluss Klemme Brücke

Funktionstext | | Leiste +ST1-XDM24 | | | | | | Seite / Spalte
| Zielbezeichnung | | | | Zielbezeichnung Kabeltyp
Potenzialklemmen 0VDC | | -111AF01 | X1:3 | 1 | | -107TB24 | Out - | | =LSSA/108.5
= | | -112KF03 | X1:26 | 2 | | | -112KF02 | X1:16 | | =LSSA/108.6
| | -112KF02 | X1:26
Potenzialklemmen 0VDC | | | | 3 | | | | | | =LSSA/108.6
= | | -301A1 | X2:10 | 4 | | | | | | =LSSA/108.6
| | -303A1 | X2:10
Potenzialklemmen 0VDC | | -XD6 | 16 | 5 | | | -415AA2 | 0V DC | | =LSSA/108.7
= | | | | 6 | | | | | | =LSSA/108.7
= | | -XD1 | 13 | 7 | | | -XD6 | 24 | | =LSSA/108.8
| | -XD10 | 2
| | -XD1 | 15
Potenzialklemmen 0VDC | | -XD20 | 18 | 8 | | | -XD12 | 2 | | =LSSA/108.8
| | -XD11 | 14
Potenzialklemmen 0VDC | | | | 9 | | | | | | =LSSA/108.8

## Kabelname

F13_001

## Kabelname

# Klemmenplan

## Anschluss

KL

## Klemmenplan +ST1-XDM48

## Kabeltyp

## Anschluss Klemme Brücke

Funktionstext | | Leiste +ST1-XDM48 | | | | | | Seite / Spalte
| Zielbezeichnung | | | | Zielbezeichnung Kabeltyp
Antrieb 3+4 | | -301A1 | X1:4 | 1 | | -110TB48.1 | Out - | | =LSSA/110.4
Trennklemme | | -303A1 | X1:4 | 2 | | | | | | =LSSA/110.4

## Kabelname

F13_001

## Kabelname

# Klemmenplan

## Anschluss

KL

## Klemmenplan +ST1-XDN

## Kabeltyp

## Anschluss Klemme Brücke

Funktionstext | | | Leiste +ST1-XDN | | | | | | Seite / Spalte
| | Zielbezeichnung | | | | Zielbezeichnung Kabeltyp
Einspeisung: 3x230/400V 50Hz N+PE Vorsicherung: max. 16A | | | -XD0 | N | N | | -XD01 | 2 | | =LSSA/105.2
-XD1 | 17
-XD1 | 10
Einspeisung: 3x230/400V 50Hz N+PE Vorsicherung: max. 16A | | | -110TB48.2 | N | N | | | -107TB24 | N | | =LSSA/105.3
| | | -110TB48.1 | N

## Kabelname

F13_001

## Kabelname

# Klemmenplan

## Anschluss

KL

## Klemmenplan +ST1-XDP24

## Kabeltyp

## Anschluss Klemme Brücke

Funktionstext | | Leiste +ST1-XDP24 | | | | | | Seite / Spalte
| Zielbezeichnung | | | | Zielbezeichnung Kabeltyp
Versorgung SPS, Panel | | -111AF01 | X1:1 | 1 | | -108FC24.1 | 2 | | =LSSA/108.1
= | | -112KF03 | X1:25 | 2 | | | -112KF02 | X1:15 | | =LSSA/108.1
| | -112KF02 | X1:25
Versorgung SPS, Panel | | | | 3 | | | | | | =LSSA/108.2
Versorgung Schrank Allgemein | | -301A1 | X2:9 | 4 | | | -108FC24.2 | 2 | | =LSSA/108.2
| | -120QA1A | 21
| | -303A1 | X2:9
| | -XD6 | 15 | 5 | | | -415AA2 | 24V DC | | =LSSA/108.3
| | | | 6 | | | -132SF1 | 13 | | =LSSA/108.3
Versorgung Externe Geräte | | -301A1 | X2:5 | 7 | | | -108FC24.3 | 2 | | =LSSA/108.4
| | -XD10 | 1
| | -303A1 | X2:5
| | -XD20 | 1 | 8 | | | -XD12 | 1 | | =LSSA/108.4
| | -XD11 | 13
| | | | 9 | | | -XD40 | 5 | | =LSSA/108.4

## Kabelname

F13_001

## Kabelname

# Klemmenplan

## Anschluss

KL

## Klemmenplan +ST1-XDP48

## Kabeltyp

## Anschluss Klemme Brücke

Funktionstext | | Leiste +ST1-XDP48 | | | | | | Seite / Spalte
| Zielbezeichnung | | | | Zielbezeichnung Kabeltyp
Antrieb 1+2 | | -301A1 | X1:5 | 1 | | -110TB48.1 | Out + | | =LSSA/110.2
Antrieb 3+4 | | -303A1 | X1:5 | 2 | | | | | | =LSSA/110.3

## Kabelname

F13_001

## Kabelname

# Klemmenplan

## Anschluss

KL

## Klemmenplan +ST1-XPE

## Kabeltyp

## Anschluss Klemme Brücke

Funktionstext | | Leiste +ST1-XPE | | | | | | Seite / Spalte
| Zielbezeichnung | | | | Zielbezeichnung Kabeltyp
Einspeisung: 3x230/400V 50Hz N+PE Vorsicherung: max. 16A | | -XD0 | PE | 1 | | -XD01 | 3 | | =LSSA/105.4
| | -107TB24 | PE
| | -107XTR24
Einspeisung: 3x230/400V 50Hz N+PE Vorsicherung: max. 16A | | -111AF01 | X1:2 | 2 | | -110TB48.1 | PE | | =LSSA/105.4
| | -110XTR48
| | -110TB48.2 | PE
Einspeisung: 3x230/400V 50Hz N+PE Vorsicherung: max. 16A | | -303A1 | X1:3 | 3 | | -301A1 | X1:3 | | =LSSA/105.4
| | -301A1 | X6B:1
| | -303A1 | X6B:1
Einspeisung: 3x230/400V 50Hz N+PE Vorsicherung: max. 16A | | | | 4 | | | | | =LSSA/105.5

## Kabelname

F13_001

## Kabelname

# Klemmenplan

## Anschluss

KL

## Klemmenplan +ST1-107XTR24

## Kabeltyp

## Anschluss Klemme Brücke

Funktionstext | | Leiste +ST1-107XTR24 | | | | | Seite / Spalte
| Zielbezeichnung | | | Zielbezeichnung Kabeltyp
Trennklemme | | -XPE | 1 | | -107TB24 | Out +' | | =LSSA/107.4
| | | | | -107TB24 | Out -'

## Kabelname

F13_001

## Kabelname

# Klemmenplan

## Anschluss

KL

## Klemmenplan +ST1-110XTR48

## Kabeltyp

## Anschluss Klemme Brücke

Funktionstext | | Leiste +ST1-110XTR48 | | | | | Seite / Spalte
| Zielbezeichnung | | | Zielbezeichnung Kabeltyp
Trennklemme | | -XPE | 2 | | -110TB48.1 | Out +' | | =LSSA/110.4
| | | | | -110TB48.1 | Out -'

## Kabelname

F13_001

## Kabelname

# Klemmenplan

## Anschluss

Funktionstext | | | | | | | | | | Leiste +ST2-XD10.1 | | | | | | Seite / Spalte
| | | | | | | | | Zielbezeichnung | | | | Zielbezeichnung Kabeltyp

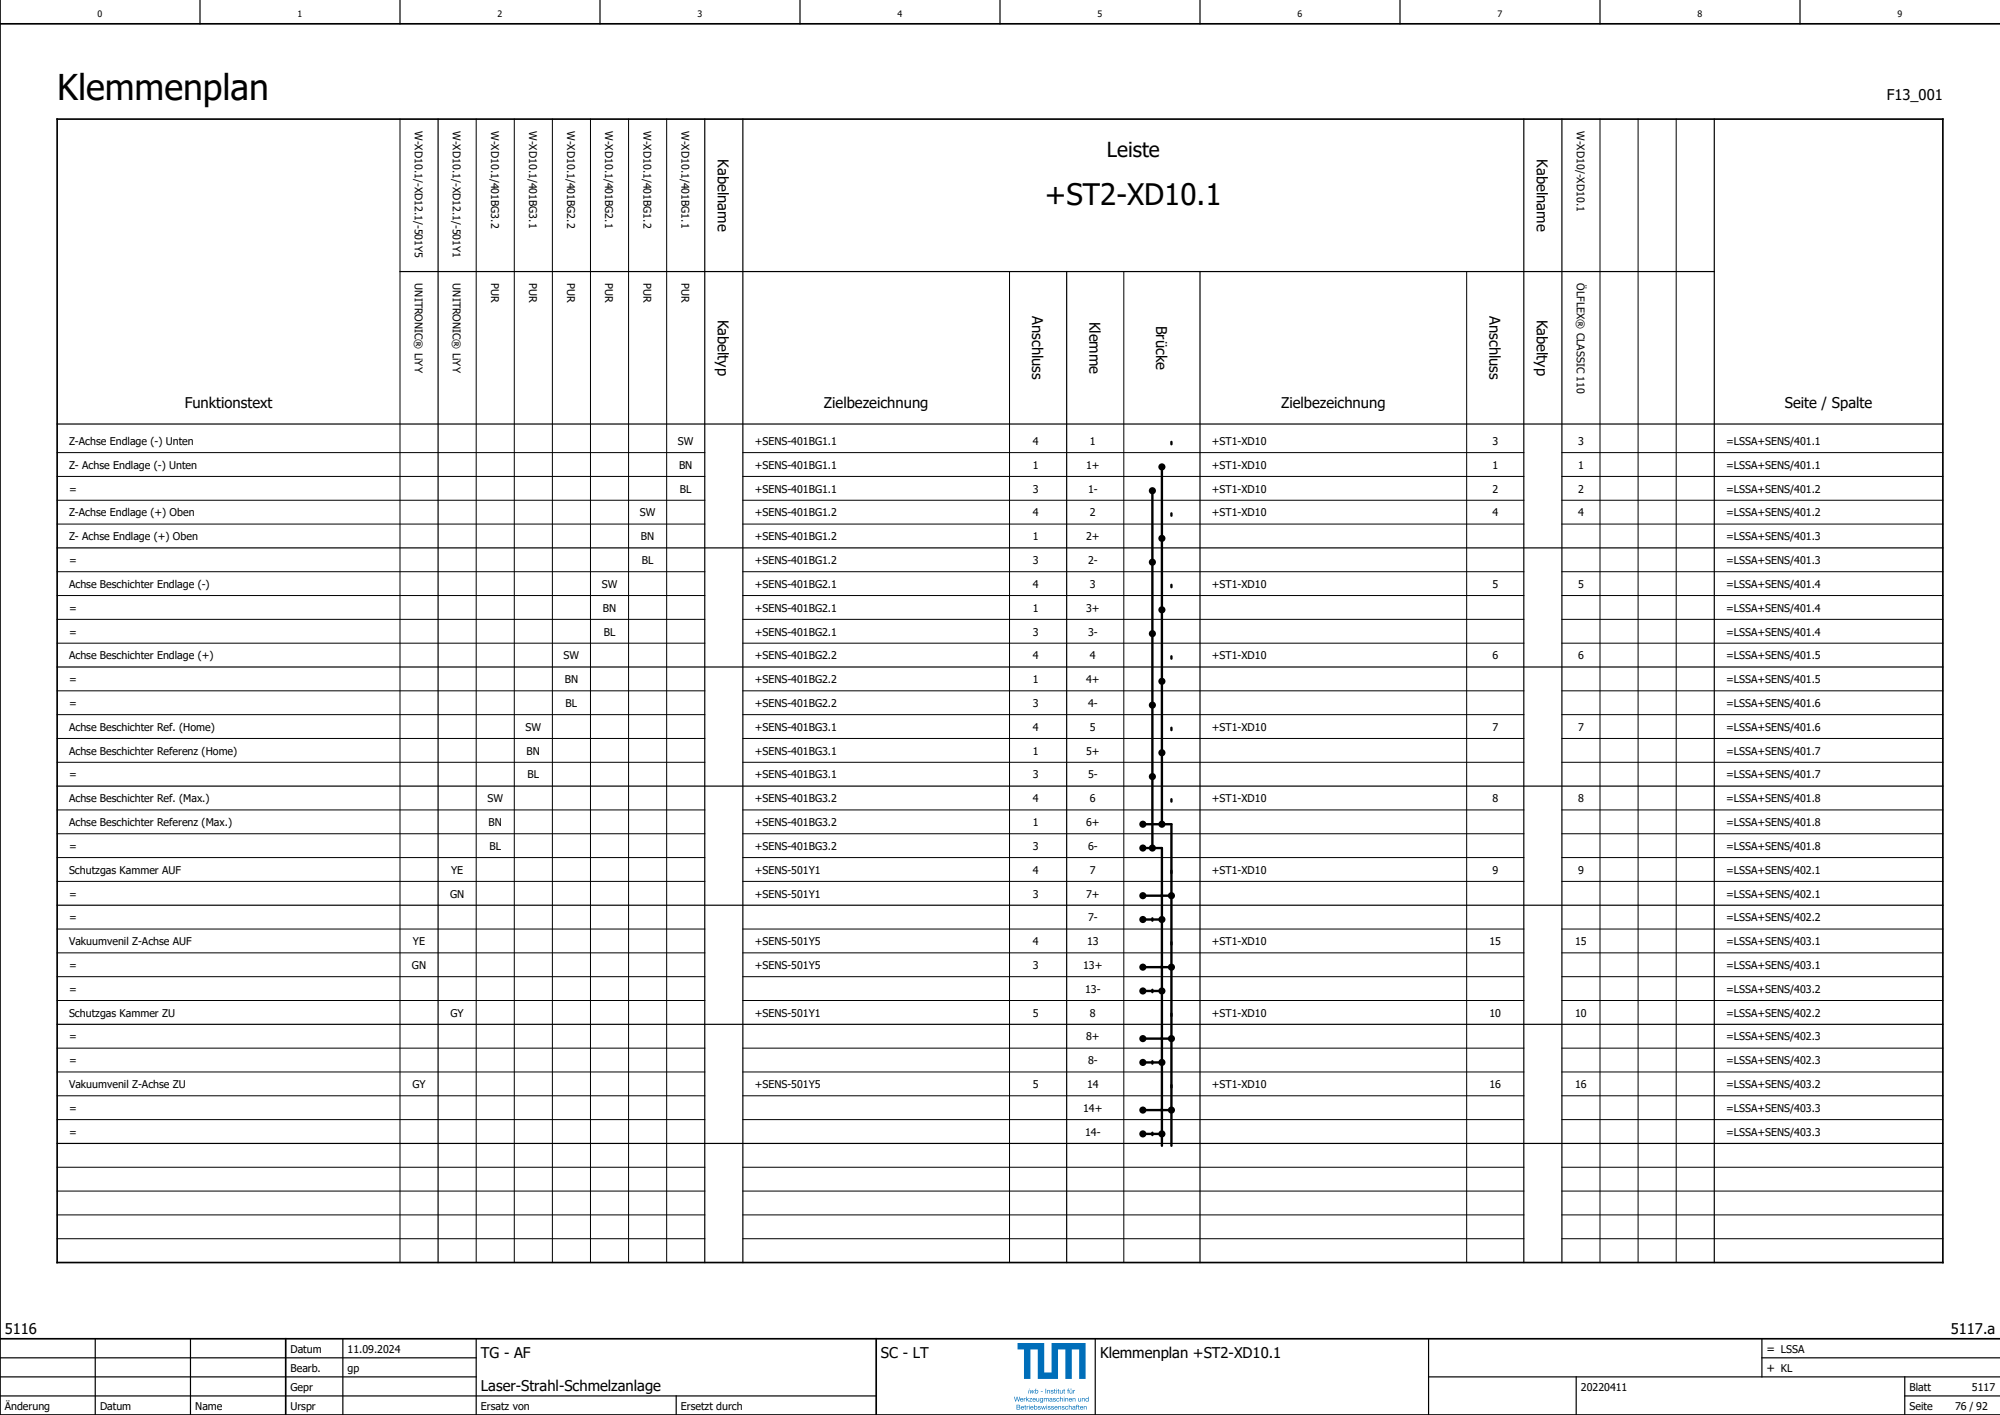
[picture p52: page 76]
Klemmenplan +ST2-XD10.1; Kabeltyp; Anschluss; Klemme; Brücke; Kabelname; Klemmenplan; W-XD10.1/401BG1.1 PUR; ÖLFLEX® CLASSIC 110; PUR; W-XD10.1/401BG2.1 PUR; W-XD10.1/401BG2.2 PUR; W-XD10.1/401BG3.1 PUR; W-XD10.1/401BG3.2 PUR

= Z- Achse Endlage (-) Unten | | | | | | | | BN | | +SENS-401BG1.1 | 1 | 14-1+ | | +ST1-XD10 | 1 | | 1 | | | =LSSA+SENS/403.3 W-XD10.1/-XD12.1/-501Y1 UNITRONIC® LiYY W-XD10.1/-XD12.1/-501Y5 UNITRONIC® LiYY =LSSA+SENS/401.1

Z-Achse Endlage (-) Unten | | | | | | | | SW | | +SENS-401BG1.1 | 4 | 1 | | +ST1-XD10 | 3 | | 3 | | | =LSSA+SENS/401.1

= | | | | | | | | BL | | +SENS-401BG1.1 | 3 | 1- | | | +ST1-XD10 | 2 | | 2 | | | =LSSA+SENS/401.2

Z-Achse Endlage (+) Oben | | | | | | | SW | | | +SENS-401BG1.2 | 4 | 2 | | | | +ST1-XD10 | 4 | | 4 | | | =LSSA+SENS/401.2

Z- Achse Endlage (+) Oben | | | | | | | BN | | | +SENS-401BG1.2 | 1 | 2+ | | | | | | | | | | =LSSA+SENS/401.3

= | | | | | | | BL | | | +SENS-401BG1.2 | 3 | 2- | | | | | | | | | | =LSSA+SENS/401.3

Achse Beschichter Endlage (-) | | | | | | SW | | | | +SENS-401BG2.1 | 4 | 3 | | | | +ST1-XD10 | 5 | | 5 | | | =LSSA+SENS/401.4

= | | | | | | BN | | | | +SENS-401BG2.1 | 1 | 3+ | | | | | | | | | | =LSSA+SENS/401.4

= | | | | | | BL | | | | +SENS-401BG2.1 | 3 | 3- | | | | | | | | | | =LSSA+SENS/401.4

Achse Beschichter Endlage (+) | | | | | SW | | | | | +SENS-401BG2.2 | 4 | 4 | | | | +ST1-XD10 | 6 | | 6 | | | =LSSA+SENS/401.5

= | | | | | BN | | | | | +SENS-401BG2.2 | 1 | 4+ | | | | | | | | | | =LSSA+SENS/401.5

= | | | | | BL | | | | | +SENS-401BG2.2 | 3 | 4- | | | | | | | | | | =LSSA+SENS/401.6

Achse Beschichter Ref. (Home) | | | | SW | | | | | | +SENS-401BG3.1 | 4 | 5 | | | | +ST1-XD10 | 7 | | 7 | | | =LSSA+SENS/401.6

Achse Beschichter Referenz (Home) | | | | BN | | | | | | +SENS-401BG3.1 | 1 | 5+ | | | | | | | | | | =LSSA+SENS/401.7

= | | | | BL | | | | | | +SENS-401BG3.1 | 3 | 5- | | | | | | | | | | =LSSA+SENS/401.7

Achse Beschichter Ref. (Max.) | | | SW | | | | | | | +SENS-401BG3.2 | 4 | 6 | | | | +ST1-XD10 | 8 | | 8 | | | =LSSA+SENS/401.8

Achse Beschichter Referenz (Max.) | | | BN | | | | | | | +SENS-401BG3.2 | 1 | 6+ | | | | | | | | | | =LSSA+SENS/401.8

= | | | BL | | | | | | | +SENS-401BG3.2 | 3 | 6- | | | | | | | | | | =LSSA+SENS/401.8

Schutzgas Kammer AUF | | YE | | | | | | | | +SENS-501Y1 | 4 | 7 | | | | +ST1-XD10 | 9 | | 9 | | | =LSSA+SENS/402.1

= | | GN | | | | | | | | +SENS-501Y1 | 3 | 7+ | | | | | | | | | | =LSSA+SENS/402.1

= | | | | | | | | | | | | 7- | | | | | | | | | | =LSSA+SENS/402.2

Vakuumvenil Z-Achse AUF | YE | | | | | | | | | +SENS-501Y5 | 4 | 13 | | | | +ST1-XD10 | 15 | | 15 | | | =LSSA+SENS/403.1

= | GN | | | | | | | | | +SENS-501Y5 | 3 | 13+ | | | | | | | | | | =LSSA+SENS/403.1

= | | | | | | | | | | | | 13- | | | | | | | | | | =LSSA+SENS/403.2

Schutzgas Kammer ZU | | GY | | | | | | | | +SENS-501Y1 | 5 | 8 | | | | +ST1-XD10 | 10 | | 10 | | | =LSSA+SENS/402.2

= | | | | | | | | | | | | 8+ | | | | | | | | | | =LSSA+SENS/402.3

= | | | | | | | | | | | | 8- | | | | | | | | | | =LSSA+SENS/402.3

Vakuumvenil Z-Achse ZU | GY | | | | | | | | | +SENS-501Y5 | 5 | 14 | | | | +ST1-XD10 | 16 | | 16 | | | =LSSA+SENS/403.2

= | | | | | | | | | | | | 14+ | | | | | | | | | | =LSSA+SENS/403.3

Funktionstext | | | | Leiste +ST2-XD10.1 | | | | Seite / Spalte
| | | Zielbezeichnung | | | | Zielbezeichnung Kabeltyp

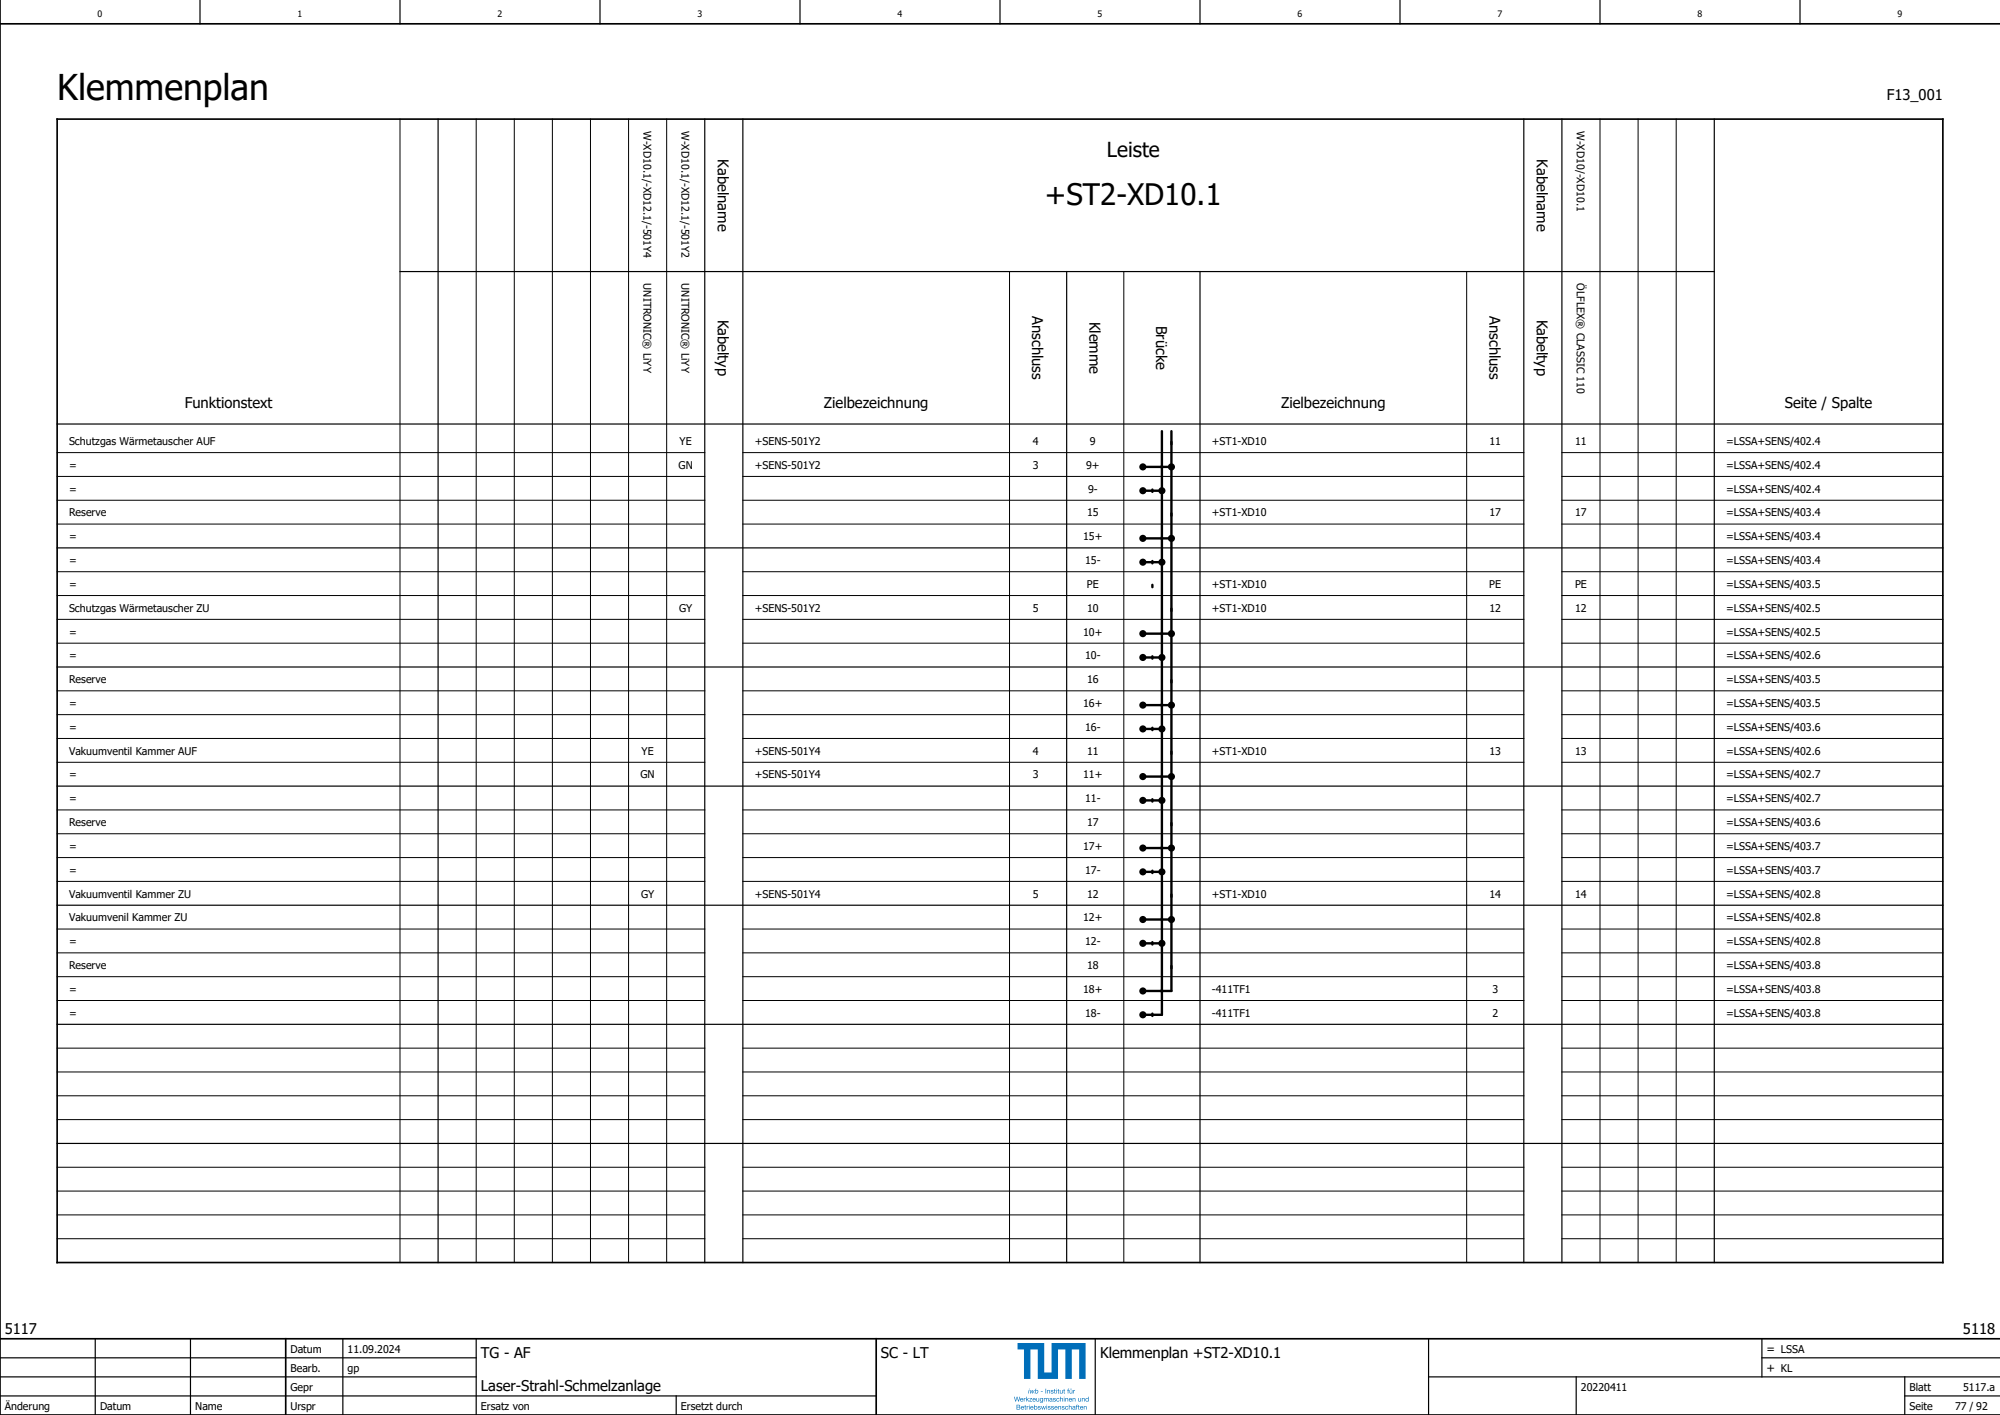
[picture p53: page 77]
Klemmenplan +ST2-XD10.1; Kabeltyp; Anschluss; Klemme; Brücke; Kabelname; Klemmenplan; Schutzgas Wärmetauscher AUF; =LSSA+SENS/402.4 W-XD10.1/-XD12.1/-501Y2 UNITRONIC® LiYY; ÖLFLEX® CLASSIC 110 W-XD10.1/-XD12.1/-501Y4; W-XD10/-XD10.1 UNITRONIC® LiYY

YE | | +SENS-501Y2 | 4 | | | +ST1-XD10 | 11 | 11

= | | GN | | +SENS-501Y2 | 3 | 9+ | | | | | =LSSA+SENS/402.4

= | | | | | | 9- | | | | | =LSSA+SENS/402.4

Reserve | | | | | | 15 | | +ST1-XD10 | 17 | 17 | =LSSA+SENS/403.4

= | | | | | | 15+ | | | | | =LSSA+SENS/403.4

= | | | | | | 15- | | | | | =LSSA+SENS/403.4

= | | | | | | PE | | +ST1-XD10 | PE | PE | =LSSA+SENS/403.5

Schutzgas Wärmetauscher ZU | | GY | | +SENS-501Y2 | 5 | 10 | | +ST1-XD10 | 12 | 12 | =LSSA+SENS/402.5

= | | | | | | 10+ | | | | | =LSSA+SENS/402.5

= | | | | | | 10- | | | | | =LSSA+SENS/402.6

Reserve | | | | | | 16 | | | | | =LSSA+SENS/403.5

= | | | | | | 16+ | | | | | =LSSA+SENS/403.5

= | | | | | | 16- | | | | | =LSSA+SENS/403.6

Vakuumventil Kammer AUF | YE | | | +SENS-501Y4 | 4 | 11 | | +ST1-XD10 | 13 | 13 | =LSSA+SENS/402.6

= | GN | | | +SENS-501Y4 | 3 | 11+ | | | | | =LSSA+SENS/402.7

= | | | | | | 11- | | | | | =LSSA+SENS/402.7

Reserve | | | | | | 17 | | | | | =LSSA+SENS/403.6

= | | | | | | 17+ | | | | | =LSSA+SENS/403.7

= | | | | | | 17- | | | | | =LSSA+SENS/403.7

Vakuumventil Kammer ZU | GY | | | +SENS-501Y4 | 5 | 12 | | +ST1-XD10 | 14 | 14 | =LSSA+SENS/402.8

Vakuumvenil Kammer ZU | | | | | | 12+ | | | | | =LSSA+SENS/402.8

= | | | | | | 12- | | | | | =LSSA+SENS/402.8

Reserve | | | | | | 18 | | | | | =LSSA+SENS/403.8

= | | | | | | 18+ | | -411TF1 | 3 | | =LSSA+SENS/403.8

= | | | | | | 18- | | -411TF1 | 2 | | =LSSA+SENS/403.8

5117.a

KL

## Klemmenplan +ST2-XD11.1

## Kabeltyp

## Anschluss Klemme Brücke

Funktionstext | | Leiste +ST2-XD11.1 | | | | | | Seite / Spalte
| Zielbezeichnung | | | | Zielbezeichnung Kabeltyp
Temperatur Bauplattform | | | | 11 | | +ST1-XD11 | 11 | | GYPK | =LSSA+SENS/411.8
= | | | | 12 | | +ST1-XD11 | 12 | | RDBU | =LSSA+SENS/411.8
= | | | | 9 | | +ST1-XD11 | 9 | | BK | =LSSA+SENS/411.6
= | | | | 10 | | +ST1-XD11 | 10 | | VT | =LSSA+SENS/411.7
= | | | | 7 | | +ST1-XD11 | 7 | | BU | =LSSA+SENS/411.5
= | | | | 8 | | +ST1-XD11 | 8 | | RD | =LSSA+SENS/411.6
= | | | | 5 | | +ST1-XD11 | 5 | | GY | =LSSA+SENS/411.4
= | | | | 6 | | +ST1-XD11 | 6 | | PK | =LSSA+SENS/411.4
= | | | | 3 | | +ST1-XD11 | 3 | | GN | =LSSA+SENS/411.2
= | | | | 4 | | +ST1-XD11 | 4 | | YE | =LSSA+SENS/411.3
= | | -411TF1 | 1 | 1 | | +ST1-XD11 | 1 | | WH | =LSSA+SENS/411.1
= | | -411TF1 | 3 | 2 | | +ST1-XD11 | 2 | | BN | =LSSA+SENS/411.2

## Kabelname

F13_001

## Kabelname

# Klemmenplan

## Anschluss

UNITRONIC® LiYCY W-XD11/-XD11.1

Funktionstext | | | | | | | Leiste +ST2-XD12.1 | | | | | | Seite / Spalte
| | | | | | Zielbezeichnung | | | | Zielbezeichnung Kabeltyp

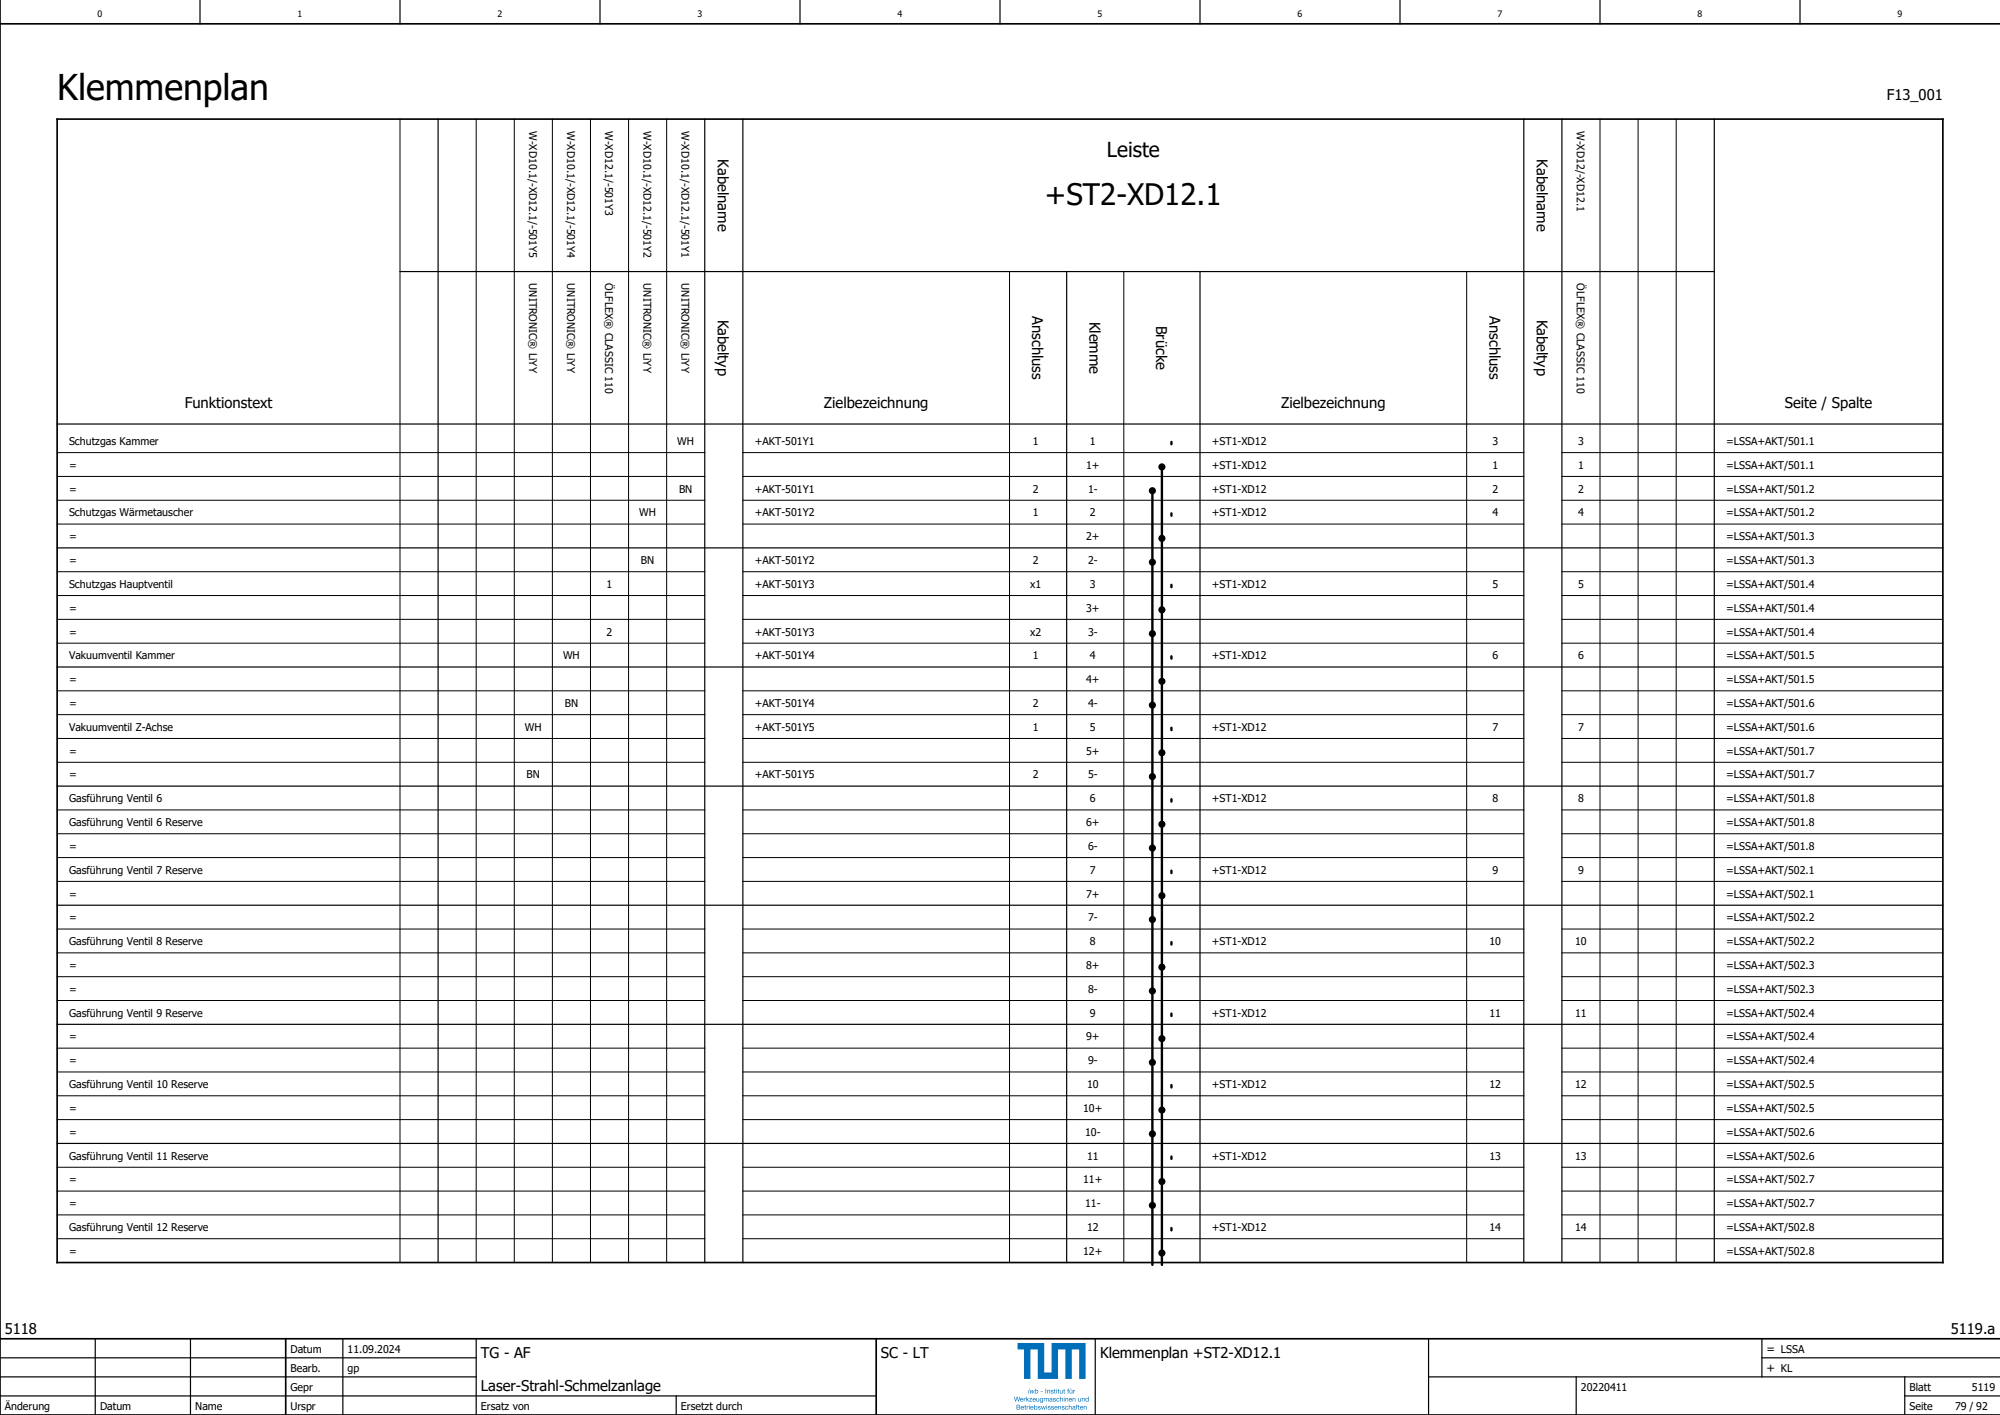
[picture p54: page 79]
Klemmenplan +ST2-XD12.1; Kabeltyp; Anschluss; Klemme; Brücke; Kabelname; Klemmenplan; W-XD10.1/-XD12.1/-501Y1 UNITRONIC® LiYY; ÖLFLEX® CLASSIC 110; UNITRONIC® LiYY; W-XD12.1/-501Y3 ÖLFLEX® CLASSIC 110; W-XD10.1/-XD12.1/-501Y4 UNITRONIC® LiYY; W-XD10.1/-XD12.1/-501Y5 UNITRONIC® LiYY

Schutzgas Kammer | | | | | WH | | +AKT-501Y1 | 1 | 1 | | +ST1-XD12 | 3 | | 3 | | | =LSSA+AKT/501.1

= | | | | | | | | | 1+ | | +ST1-XD12 | 1 | | 1 | | | =LSSA+AKT/501.1

= | | | | | BN | | +AKT-501Y1 | 2 | 1- | | | +ST1-XD12 | 2 | | 2 | | | =LSSA+AKT/501.2

Schutzgas Wärmetauscher | | | | WH | | | +AKT-501Y2 | 1 | 2 | | | | +ST1-XD12 | 4 | | 4 | | | =LSSA+AKT/501.2

= | | | | | | | | | 2+ | | | | | | | | | | =LSSA+AKT/501.3

= | | | | BN | | | +AKT-501Y2 | 2 | 2- | | | | | | | | | | =LSSA+AKT/501.3

Schutzgas Hauptventil | | | 1 | | | | +AKT-501Y3 | x1 | 3 | | | | +ST1-XD12 | 5 | | 5 | | | =LSSA+AKT/501.4

= | | | | | | | | | 3+ | | | | | | | | | | =LSSA+AKT/501.4

= | | | 2 | | | | +AKT-501Y3 | x2 | 3- | | | | | | | | | | =LSSA+AKT/501.4

Vakuumventil Kammer | | WH | | | | | +AKT-501Y4 | 1 | 4 | | | | +ST1-XD12 | 6 | | 6 | | | =LSSA+AKT/501.5

= | | | | | | | | | 4+ | | | | | | | | | | =LSSA+AKT/501.5

= | | BN | | | | | +AKT-501Y4 | 2 | 4- | | | | | | | | | | =LSSA+AKT/501.6

Vakuumventil Z-Achse | WH | | | | | | +AKT-501Y5 | 1 | 5 | | | | +ST1-XD12 | 7 | | 7 | | | =LSSA+AKT/501.6

= | | | | | | | | | 5+ | | | | | | | | | | =LSSA+AKT/501.7

= | BN | | | | | | +AKT-501Y5 | 2 | 5- | | | | | | | | | | =LSSA+AKT/501.7

Gasführung Ventil 6 | | | | | | | | | 6 | | | | +ST1-XD12 | 8 | | 8 | | | =LSSA+AKT/501.8

Gasführung Ventil 6 Reserve | | | | | | | | | 6+ | | | | | | | | | | =LSSA+AKT/501.8

= | | | | | | | | | 6- | | | | | | | | | | =LSSA+AKT/501.8

Gasführung Ventil 7 Reserve | | | | | | | | | 7 | | | | +ST1-XD12 | 9 | | 9 | | | =LSSA+AKT/502.1

= | | | | | | | | | 7+ | | | | | | | | | | =LSSA+AKT/502.1

= | | | | | | | | | 7- | | | | | | | | | | =LSSA+AKT/502.2

Gasführung Ventil 8 Reserve | | | | | | | | | 8 | | | | +ST1-XD12 | 10 | | 10 | | | =LSSA+AKT/502.2

= | | | | | | | | | 8+ | | | | | | | | | | =LSSA+AKT/502.3

= | | | | | | | | | 8- | | | | | | | | | | =LSSA+AKT/502.3

Gasführung Ventil 9 Reserve | | | | | | | | | 9 | | | | +ST1-XD12 | 11 | | 11 | | | =LSSA+AKT/502.4

= | | | | | | | | | 9+ | | | | | | | | | | =LSSA+AKT/502.4

= | | | | | | | | | 9- | | | | | | | | | | =LSSA+AKT/502.4

Gasführung Ventil 10 Reserve | | | | | | | | | 10 | | | | +ST1-XD12 | 12 | | 12 | | | =LSSA+AKT/502.5

= | | | | | | | | | 10+ | | | | | | | | | | =LSSA+AKT/502.5

= | | | | | | | | | 10- | | | | | | | | | | =LSSA+AKT/502.6

Gasführung Ventil 11 Reserve | | | | | | | | | 11 | | | | +ST1-XD12 | 13 | | 13 | | | =LSSA+AKT/502.6

= | | | | | | | | | 11+ | | | | | | | | | | =LSSA+AKT/502.7

= | | | | | | | | | 11- | | | | | | | | | | =LSSA+AKT/502.7

Gasführung Ventil 12 Reserve | | | | | | | | | 12 | | | | +ST1-XD12 | 14 | | 14 | | | =LSSA+AKT/502.8

= | | | | | | | | | 12+ | | | | | | | | | | =LSSA+AKT/502.8

KL

## Klemmenplan +ST2-XD12.1

## +STK/5400

5119.a

## Kabeltyp

## Anschluss Klemme Brücke

Funktionstext | | Leiste +ST2-XD12.1 | | | Seite / Spalte
| Zielbezeichnung | | | Zielbezeichnung Kabeltyp
Gasführung Ventil 12 Reserve | | | 12- | | | | | =LSSA+AKT/502.8
Gasführung Ventil 13 Reserve | | | 13 | | +ST1-XD12 | 15 | 15 | =LSSA+AKT/503.1
= | | | 13+ | | | | | =LSSA+AKT/503.1
= | | | 13- | | | | | =LSSA+AKT/503.2
Gasführung Ventil 14 Reserve | | | 14 | | +ST1-XD12 | 16 | 16 | =LSSA+AKT/503.2
= | | | 14+ | | | | | =LSSA+AKT/503.3
= | | | 14- | | | | | =LSSA+AKT/503.3
Gasführung Ventil 15 Reserve | | | 15 | | +ST1-XD12 | 17 | 17 | =LSSA+AKT/503.4
= | | | 15+ | | | | | =LSSA+AKT/503.4
= | | | 15- | | | | | =LSSA+AKT/503.4
Gasführung Ventil 16 Reserve | | | 16 | | +ST1-XD12 | 18 | 18 | =LSSA+AKT/503.5
= | | | 16+ | | | | | =LSSA+AKT/503.5
= | | | 16- | | | | | =LSSA+AKT/503.6
Gasführung Ventil 17 Reserve | | | 17 | | +ST1-XD12 | 19 | 19 | =LSSA+AKT/503.6
= | | | 17+ | | | | | =LSSA+AKT/503.7
= | | | 17- | | | | | =LSSA+AKT/503.7
Gasführung Ventil 18 Reserve | | | 18 | | +ST1-XD12 | 20 | 20 | =LSSA+AKT/503.8
= | | | 18+ | | | | | =LSSA+AKT/503.8
= | | | 18- | | | | | =LSSA+AKT/503.8

## Kabelname

F13_001

## Kabelname

# Klemmenplan

## Anschluss

### ÖLFLEX® CLASSIC 110 W-XD12/-XD12.1

## +KL/5119.a

STK

## Artikelstückliste : BuR.80SD100XD.C044-01 -BuR.X20AO4622

5400.a

Betriebsmittelkennzeichen | Menge | Bezeichnung | Typnummer | Lieferant | Artikelnummer
+ST1-301A1 | 1 | ACPu, 2x Step. 10A, X2X, 2x ABR | 80SD100XD.C044-01 | BuR | BuR.80SD100XD.C044-01
+ST1-303A1 | 1 | ACPu, 2x Step. 10A, X2X, 2x ABR | 80SD100XD.C044-01 | BuR | BuR.80SD100XD.C044-01
+ST1-425A1 | 0
+ST1-415AA2 | 0
+ST1-111AF01 | 1 | APC2100 E3815 1C 1.46GHz 512kB 5W 1GB | 5APC2100.BY01-000 | BuR | BuR.5APC2100.BY01-000
+ST1-111AF02 | 1 | X20 SafeLOGIC, POWERLINK, X2X Link, univ | X20SL8101 | BuR | BuR.X20SL8101
+ST1-111AF02 | 1 | X20 Klemmblock safety, 12-fach | X20TB52 | BuR | BuR.X20TB52
+ST1-111AF02 | 1 | X20 SafeKEY 2 MByte | X20MK0211 | BuR | BuR.X20MK0211
+ST1-CD30 | 1 | Abschluss- und Zwischenplatte | 2002-2292 | WAGO | WAGO.2002-2292
+ST1-CD30 | 1 | Schraubenlose Endklammer | 249-117 | WAGO | WAGO.249-117
+ST1-CD30 | 1 | Gruppenschildträger | 249-119 | WAGO | WAGO.249-119
+ST1-110FA48.1 | 1 | LEITUNGSSCHUTZSCHALTER 230/400V 10KA, 1POLIG, C, 6A, T=70MM | 5SY4106-7 | SIE | SIE.5SY4106-7
+ST1-110FA48.2 | 1 | LEITUNGSSCHUTZSCHALTER 230/400V 10KA, 1POLIG, C, 6A, T=70MM | 5SY4106-7 | SIE | SIE.5SY4106-7
+ST1-106FC1 | 1 | Leitungsschutzschalter 230/400V 10kA, 1-polig, B, 10A, T=70mm | 5SY4110-6 | | SIE.5SY4110-6
+ST1-107FC24 | 1 | LEITUNGSSCHUTZSCHALTER 230/400V 10KA, 1POLIG, C, 4A, T=70MM | 5SY4104-7 | SIE | SIE.5SY4104-7
+ST1-108FC24.1 | 1 | Sicherungsklemme mit schwenkbarem Sicherungshalter | 281-611/281-541 | | WAGO.281-611/281-541
+ST1-108FC24.1 | 1 | Abschluss- und Zwischenplatte | 281-311 | | WAGO.281-311
+ST1-108FC24.1 | 2 | Querbrücker | 281-402 | | WAGO.281-402
+ST1-108FC24.1 | 2 | Schraubenlose Endklammer | 249-117 | WAGO | WAGO.249-117
+ST1-108FC24.2 | 1 | Sicherungsklemme mit schwenkbarem Sicherungshalter | 281-611/281-541 | | WAGO.281-611/281-541
+ST1-108FC24.3 | 1 | Sicherungsklemme mit schwenkbarem Sicherungshalter | 281-611/281-541 | | WAGO.281-611/281-541
+ST1-310FC1 | 1 | LEITUNGSSCHUTZSCHALTER 230/400V 10KA, 1POLIG, B, 16A, T=70MM | 5SY4116-6 | SIE | SIE.5SY4116-6
+ST1-310FC1 | 1 | Hilfsstromschalter anbaubar 1S+1Ö für LS-Schalter 5SL, 5SY, 5SP | 5ST3010 | | SIE.5ST3010
+ST1-315FC1 | 1 | LEITUNGSSCHUTZSCHALTER 230/400V 10KA, 1POLIG, B, 16A, T=70MM | 5SY4116-6 | SIE | SIE.5SY4116-6
+ST1-315FC1 | 1 | Hilfsstromschalter anbaubar 1S+1Ö für LS-Schalter 5SL, 5SY, 5SP | 5ST3010 | | SIE.5ST3010
+ST1-131FN1 | 1 | NOT-HALT/AUS-Taste, d = 38 mm, zugentriegelt, unbeleuchtet, 2 Öffner, Aufbau | M22-PV/KC02/IY | ETN | ETN.M22-PV/KC02/IY
+ST1-131FN1 | 0
+ST1-131FN01 | 1 | NOT-HALT/AUS-Taste, d = 38 mm, zugentriegelt, unbeleuchtet, 1 Öffner, Fronteinbau | M22-PV/K01 | ETN | ETN.M22-PV/K01
+ST1-131FN01 | 0
+ST1-131FN01 | 1 | Kontaktelement 1 Öffner, Frontbefestigung, Schraubanschluss | M22-K01 | ETN | ETN.M22-K01
+ST1-131FN01 | 1 | Bezeichnungsschild für Befehlsgeräte | M22-XBK11 | | ETN.121372
+ST1-131FN2 | 1 | NOT-HALT/AUS-Taste, d = 38 mm, zugentriegelt, unbeleuchtet, 2 Öffner, Aufbau | M22-PV/KC02/IY | ETN | ETN.M22-PV/KC02/IY
+ST1-131FN2 | 0
+ST1-132FN1 | 1 | Sicherheitsschalter | PSENme 1S/1AS | | PILZ.570000
+ST1-132FN2 | 1 | Sicherheitsgerichteter Transponderschalter | PSEN cs3.1a 1 switch | | PILZ.541061
+ST1-415K1 | 1 | Koppelrelais | 49.62.9.024.0050 | | FIN.49.62.9.024.0050
+ST1-112KF01 | 1 | 20 Bus Controller POWERLINK | X20BC0083 | BuR | BuR.X20BC0083
+ST1-112KF01 | 1 | X20 Bus Controller Basis | X20BB80 | BuR | BuR.X20BB80
+ST1-112KF02 | 1 | X20 BC Einspeisung, 24V, Busversorgung | X20PS9400 | BuR | BuR.X20PS9400
+ST1-112KF02 | 1 | X20 Standard Klemmblock 12-fach | X20TB12 | BuR | BuR.X20TB12
+ST1-112KF03 | 1 | X20 Bussender | X20BT9100 | BuR | BuR.X20BT9100
+ST1-112KF03 | 1 | X20 Busmodul mit Power Bus Durchgang | X20BM11 | BuR | BuR.X20BM11
+ST1-112KF03 | 1 | X20 Standard Klemmblock 12-fach | X20TB12 | BuR | BuR.X20TB12
+ST1-112KF11 | 1 | X20 Analog 6xE, THERMOELEMENT | X20AT6402 | BuR | BuR.X20AT6402
+ST1-112KF11 | 1 | X20 Busmodul mit Power Bus Durchgang | X20BM11 | BuR | BuR.X20BM11
+ST1-112KF11 | 1 | X20 Standard Klemmblock 12-fach | X20TB12 | BuR | BuR.X20TB12
+ST1-112KF12 | 1 | X20 Analog 4xA, +/-10V/0..20 mA, 12 Bit | X20AO4622 | BuR | BuR.X20AO4622
+ST1-112KF12 | 1 | X20 Busmodul mit Power Bus Durchgang | X20BM11 | BuR | BuR.X20BM11
+ST1-112KF12 | 1 | X20 Standard Klemmblock 12-fach | X20TB12 | BuR | BuR.X20TB12
+ST1-112KF13 | 1 | X20 Analog 4xA, +/-10V/0..20 mA, 12 Bit | X20AO4622 | BuR | BuR.X20AO4622
+ST1-112KF13 | 1 | X20 Busmodul mit Power Bus Durchgang | X20BM11 | BuR | BuR.X20BM11
+ST1-112KF13 | 1 | X20 Standard Klemmblock 12-fach | X20TB12 | BuR | BuR.X20TB12
+ST1-112KF14 | 1 | X20 Analog 4xE, +/-10V/0..20 mA, 12 Bit | X20AI4622 | BuR | BuR.X20AI4622
+ST1-112KF14 | 1 | X20 Busmodul mit Power Bus Durchgang | X20BM11 | BuR | BuR.X20BM11
+ST1-112KF14 | 1 | X20 Standard Klemmblock 12-fach | X20TB12 | BuR | BuR.X20TB12
+ST1-112KF15 | 1 | X20 Analog 4xA, +/-10V/0..20 mA, 12 Bit | X20AO4622 | BuR | BuR.X20AO4622
Artikelstückliste | F01_001

STK

## Artikelstückliste : BuR.X20BM11 - BuR.X20TB52

5400.b

5400.a

Betriebsmittelkennzeichen | Menge | Bezeichnung | Typnummer | Lieferant | Artikelnummer
+ST1-112KF15 | 1 | X20 Busmodul mit Power Bus Durchgang | X20BM11 | BuR | BuR.X20BM11
+ST1-112KF15 | 1 | X20 Standard Klemmblock 12-fach | X20TB12 | BuR | BuR.X20TB12
+ST1-113KF16 | 1 | X20 Digital 6xE, 24V, Sink, 2 Leiter | X20DI6371 | BuR | BuR.X20DI6371
+ST1-113KF16 | 1 | X20 Busmodul mit Power Bus Durchgang | X20BM11 | BuR | BuR.X20BM11
+ST1-113KF16 | 1 | X20 Standard Klemmblock 12-fach | X20TB12 | BuR | BuR.X20TB12
+ST1-113KF17 | 1 | X20 Digital 6xE, 24V, Sink, 2 Leiter | X20DI6371 | BuR | BuR.X20DI6371
+ST1-113KF17 | 1 | X20 Busmodul mit Power Bus Durchgang | X20BM11 | BuR | BuR.X20BM11
+ST1-113KF17 | 1 | X20 Standard Klemmblock 12-fach | X20TB12 | BuR | BuR.X20TB12
+ST1-113KF18 | 1 | X20 Digital 6xE, 24V, Sink, 2 Leiter | X20DI6371 | BuR | BuR.X20DI6371
+ST1-113KF18 | 1 | X20 Busmodul mit Power Bus Durchgang | X20BM11 | BuR | BuR.X20BM11
+ST1-113KF18 | 1 | X20 Standard Klemmblock 12-fach | X20TB12 | BuR | BuR.X20TB12
+ST1-113KF19 | 1 | X20 Digital 6xE, 24V, Sink, 2 Leiter | X20DI6371 | BuR | BuR.X20DI6371
+ST1-113KF19 | 1 | X20 Busmodul mit Power Bus Durchgang | X20BM11 | BuR | BuR.X20BM11
+ST1-113KF19 | 1 | X20 Standard Klemmblock 12-fach | X20TB12 | BuR | BuR.X20TB12
+ST1-113KF20 | 1 | X20 Digital 6xE, 24V, Sink, 2 Leiter | X20DI6371 | BuR | BuR.X20DI6371
+ST1-113KF20 | 1 | X20 Busmodul mit Power Bus Durchgang | X20BM11 | BuR | BuR.X20BM11
+ST1-113KF20 | 1 | X20 Standard Klemmblock 12-fach | X20TB12 | BuR | BuR.X20TB12
+ST1-113KF21 | 1 | X20 Digital 6xE, 24V, Sink, 2 Leiter | X20DI6371 | BuR | BuR.X20DI6371
+ST1-113KF21 | 1 | X20 Busmodul mit Power Bus Durchgang | X20BM11 | BuR | BuR.X20BM11
+ST1-113KF21 | 1 | X20 Standard Klemmblock 12-fach | X20TB12 | BuR | BuR.X20TB12
+ST1-113KF22 | 1 | X20 Digital 6xE, 24V, Sink, 2 Leiter | X20DI6371 | BuR | BuR.X20DI6371
+ST1-113KF22 | 1 | X20 Busmodul mit Power Bus Durchgang | X20BM11 | BuR | BuR.X20BM11
+ST1-113KF22 | 1 | X20 Standard Klemmblock 12-fach | X20TB12 | BuR | BuR.X20TB12
+ST1-113KF23 | 1 | X20 Digital 6xE, 24V, Sink, 2 Leiter | X20DI6371 | BuR | BuR.X20DI6371
+ST1-113KF23 | 1 | X20 Busmodul mit Power Bus Durchgang | X20BM11 | BuR | BuR.X20BM11
+ST1-113KF23 | 1 | X20 Standard Klemmblock 12-fach | X20TB12 | BuR | BuR.X20TB12
+ST1-114KF24 | 1 | X20 Digital 6xA, 24V 0.5A, Source, 2 L. | X20DO6322 | BuR | BuR.X20DO6322
+ST1-114KF24 | 1 | X20 Busmodul mit Power Bus Durchgang | X20BM11 | BuR | BuR.X20BM11
+ST1-114KF24 | 1 | X20 Standard Klemmblock 12-fach | X20TB12 | BuR | BuR.X20TB12
+ST1-114KF25 | 1 | X20 Digital 6xA, 24V 0.5A, Source, 2 L. | X20DO6322 | BuR | BuR.X20DO6322
+ST1-114KF25 | 1 | X20 Busmodul mit Power Bus Durchgang | X20BM11 | BuR | BuR.X20BM11
+ST1-114KF25 | 1 | X20 Standard Klemmblock 12-fach | X20TB12 | BuR | BuR.X20TB12
+ST1-114KF26 | 1 | X20 Digital 6xA, 24V 0.5A, Source, 2 L. | X20DO6322 | BuR | BuR.X20DO6322
+ST1-114KF26 | 1 | X20 Busmodul mit Power Bus Durchgang | X20BM11 | BuR | BuR.X20BM11
+ST1-114KF26 | 1 | X20 Standard Klemmblock 12-fach | X20TB12 | BuR | BuR.X20TB12
+ST1-114KF27 | 1 | X20 Digital 6xA, 24V 0.5A, Source, 2 L. | X20DO6322 | BuR | BuR.X20DO6322
+ST1-114KF27 | 1 | X20 Busmodul mit Power Bus Durchgang | X20BM11 | BuR | BuR.X20BM11
+ST1-114KF27 | 1 | X20 Standard Klemmblock 12-fach | X20TB12 | BuR | BuR.X20TB12
+ST1-114KF28 | 1 | X20 Digital 6xA, 24V 0.5A, Source, 2 L. | X20DO6322 | BuR | BuR.X20DO6322
+ST1-114KF28 | 1 | X20 Busmodul mit Power Bus Durchgang | X20BM11 | BuR | BuR.X20BM11
+ST1-114KF28 | 1 | X20 Standard Klemmblock 12-fach | X20TB12 | BuR | BuR.X20TB12
+ST1-114KF29 | 1 | X20 Digital 6xA, 24V 0.5A, Source, 2 L. | X20DO6322 | BuR | BuR.X20DO6322
+ST1-114KF29 | 1 | X20 Busmodul mit Power Bus Durchgang | X20BM11 | BuR | BuR.X20BM11
+ST1-114KF29 | 1 | X20 Standard Klemmblock 12-fach | X20TB12 | BuR | BuR.X20TB12
+ST1-114KF30 | 1 | X20 Digital 6xA, 24V 0.5A, Source, 2 L. | X20DO6322 | BuR | BuR.X20DO6322
+ST1-114KF30 | 1 | X20 Busmodul mit Power Bus Durchgang | X20BM11 | BuR | BuR.X20BM11
+ST1-114KF30 | 1 | X20 Standard Klemmblock 12-fach | X20TB12 | BuR | BuR.X20TB12
+ST1-114KF31 | 1 | X20 Digital 6xA, 24V 0.5A, Source, 2 L. | X20DO6322 | BuR | BuR.X20DO6322
+ST1-114KF31 | 1 | X20 Busmodul mit Power Bus Durchgang | X20BM11 | BuR | BuR.X20BM11
+ST1-114KF31 | 1 | X20 Standard Klemmblock 12-fach | X20TB12 | BuR | BuR.X20TB12
+ST1-115KF51 | 1 | X20 Safe Digital 8xE, 24V, 4xE KAT4 | X20SI8110 | BuR | BuR.X20SI8110
+ST1-115KF51 | 1 | X20 Bus safety 12.5mm, Power Bus Durchg. | X20BM13 | BuR | BuR.X20BM13
+ST1-115KF51 | 1 | X20 Klemmblock safety, 12-fach | X20TB52 | BuR | BuR.X20TB52
+ST1-115KF52 | 1 | X20 Safe Digital 6xA, 24V, 0.1A | X20SO6300 | BuR | BuR.X20SO6300
+ST1-115KF52 | 1 | X20 Bus safety 25mm, Node Nr., Durchgang | X20BM36 | BuR | BuR.X20BM36
+ST1-115KF52 | 1 | X20 Klemmblock safety, 12-fach | X20TB52 | BuR | BuR.X20TB52
Artikelstückliste | F01_001

5400.a

STK

## Artikelstückliste : BuR.X20SC0842 -WAGO.2002-1201

5400.c

5400.b

Betriebsmittelkennzeichen | Menge | Bezeichnung | Typnummer | Lieferant | Artikelnummer
+ST1-115KF53a | 1 | X20 Safe Digital 8xE, 4xA 3A, 2xA 50mA | X20SC0842 | BuR | BuR.X20SC0842
+ST1-115KF53a | 1 | X20 Bus safety 25mm, Node Nr., Durchgang | X20BM36 | BuR | BuR.X20BM36
+ST1-115KF53a | 1 | X20 Klemmblock safety, 12-fach | X20TB52 | BuR | BuR.X20TB52
+ST1-115KF53b | 0 | X20 Safe Digital 8xE, 4xA 3A, 2xA 50mA | X20SC0842 | BuR | BuR.X20SC0842
+ST1-115KF53b | 0 | X20 Bus safety 25mm, Node Nr., Durchgang | X20BM36 | BuR | BuR.X20BM36
+ST1-115KF53b | 1 | X20 Klemmblock safety, 12-fach | X20TB52 | BuR | BuR.X20TB52
+ST1-116KF61 | 1 | X20 Zähler, 1x ABR, TTL, 250 kHz, Mon. | X20DC1976 | BuR | BuR.X20DC1976
+ST1-116KF61 | 1 | X20 Busmodul mit Power Bus Durchgang | X20BM11 | BuR | BuR.X20BM11
+ST1-116KF61 | 1 | X20 Standard Klemmblock 12-fach | X20TB12 | BuR | BuR.X20TB12
+ST1-310KF1 | 1 | Koppelrelais mit Schraubanschlüssen, 2 Wechsler 8 A, Spule 24 V DC sensitiv | 48.52.7.024.0050 | FIN | FIN.48.52.7.024.0050
+ST1-310KF2 | 1 | Koppelrelais mit Schraubanschlüssen, 2 Wechsler 8 A, Spule 24 V DC sensitiv | 48.52.7.024.0050 | FIN | FIN.48.52.7.024.0050
+ST1-602KF1 | 1 | Solid-State-Relaismodul | PLC-OPT- 5DC/ 24DC/2/ACT | PXC | PXC.2900375
+ST1-602KF2 | 1 | Solid-State-Relaismodul | PLC-OPT- 24DC/ 24DC/2 | PXC | PXC.2900364
+ST1-132PF1 | 0
+ST1-133PF1 | 1 | Signalsäule, Komplettgerät | 649.000.02 | | WER.649.000.02
+ST1-133PF1 | 0
+ST1-310Q1 | 1 | LEISTUNGSSCHALTER SCHRAUBANSCHL. 10A | 3RV2011-1JA10 | SIE | SIE.3RV2011-1JA10
+ST1-311Q1 | 1 | LEISTUNGSSCHALTER SCHRAUBANSCHL. 3,2A | 3RV2011-1DA10 | SIE | SIE.3RV2011-1DA10
+ST1-311Q1 | 1 | HILFSSCHALTER QUERLIEGEND, 1S+1OE, SCHRAUBANSCHLUSS, | 3RV2901-1E | SIE | SIE.3RV2901-1E
+ST1-120QA1A | 1 | SCHUETZ,AC3:7,5KW 1OE DC24V | 3RT2018-1BB42 | SIE | SIE.3RT2018-1BB42
+ST1-120QA1A | 1 | HILFSSCHALTERBLOCK , 4S STROMBAHNEN: 1S, 1S, 1S, 1S | 3RH2911-1FA40 | SIE | SIE.3RH2911-1FA40
+ST1-120QA1A | 1 | UEBERSPANNUNGSBEGRENZER, VARISTOR, | 3RT2916-1BB00 | SIE | SIE.3RT2916-1BB00
+ST1-120QA1B | 1 | SCHUETZ,AC3:7,5KW 1OE DC24V | 3RT2018-1BB42 | SIE | SIE.3RT2018-1BB42
+ST1-120QA1B | 1 | HILFSSCHALTERBLOCK , 4S STROMBAHNEN: 1S, 1S, 1S, 1S | 3RH2911-1FA40 | SIE | SIE.3RH2911-1FA40
+ST1-120QA1B | 1 | UEBERSPANNUNGSBEGRENZER, VARISTOR, | 3RT2916-1BB00 | SIE | SIE.3RT2916-1BB00
+ST1-120QA2A | 1 | SCHUETZ,AC3:3KW 1OE DC24V | 3RT2015-1BB42 | SIE | SIE.3RT2015-1BB42
+ST1-120QA2A | 1 | HILFSSCHALTERBLOCK , 4S STROMBAHNEN: 1S, 1S, 1S, 1S | 3RH2911-1FA40 | SIE | SIE.3RH2911-1FA40
+ST1-120QA2A | 1 | UEBERSPANNUNGSBEGRENZER, VARISTOR, | 3RT2916-1BB00 | SIE | SIE.3RT2916-1BB00
+ST1-120QA2B | 1 | SCHUETZ,AC3:3KW 1OE DC24V | 3RT2015-1BB42 | SIE | SIE.3RT2015-1BB42
+ST1-120QA2B | 1 | HILFSSCHALTERBLOCK , 4S STROMBAHNEN: 1S, 1S, 1S, 1S | 3RH2911-1FA40 | SIE | SIE.3RH2911-1FA40
+ST1-120QA2B | 1 | UEBERSPANNUNGSBEGRENZER, VARISTOR, | 3RT2916-1BB00 | SIE | SIE.3RT2916-1BB00
+ST1-311QA1 | 1 | SCHUETZ,AC3:3KW 1S DC24V | 3RT2015-1BB41 | SIE | SIE.3RT2015-1BB41
+ST1-311QA1 | 1 | UEBERSPANNUNGSBEGRENZER, VARISTOR, | 3RT2916-1BB00 | SIE | SIE.3RT2916-1BB00
+ST1-315QA1 | 1 | Elektronisches Lastrelais, 40 A | 77.45.9.024.8250 | | FIN.77.45.9.024.8250
+ST1-105QB1 | 1 | Hauptschalter, 3-polig, 25 A, HALT-Funktion, abschließbar in 0-Stellung, Einbau | P1-25/EA/SVB-SW | ETN | ETN.P1-25/EA/SVB-SW
+ST1-106SF1 | 1 | Leuchtwahltaste, 2 Stellungen, weiß, rastend | M22-WRLK-W | ETN | ETN.M22-WRLK-W
+ST1-106SF1 | 1 | Adapter für Befehlsgeräte | M22-A | | ETN.216374
+ST1-106SF1 | 1 | Kontaktelement 1 Schließer, Frontbefestigung, Schraubanschluss | M22-K10 | ETN | ETN.M22-K10
+ST1-106SF1 | 1 | Schildträger, ohne Schild, schwarz | M22S-ST-X | ETN | ETN.M22S-ST-X
+ST1-131SF02 | 0
+ST1-132SF1 | 0
+ST1-107TB24 | 1 | Stromversorgung, 1AC, Ausgang 24V 10A | QS10.241 | PULS | PULS.QS10.241
+ST1-110TB48.1 | 1 | Stromversorgung, 48V, 10A | CP20.481 | PULS | PULS.CP20.481
+ST1-110TB48.2 | 0
+ST1-XD0 | 2 | Kammbrücker | 2002-402 | WAGO | WAGO.2002-402
+ST1-XD0 | 1 | Abschluss- und Zwischenplatte | 2002-1292 | WAGO | WAGO.2002-1292
+ST1-XD0 | 2 | Schraubenlose Endklammer | 249-117 | WAGO | WAGO.249-117
+ST1-XD0 | 2 | Gruppenschildträger | 249-119 | WAGO | WAGO.249-119
+ST1-XD0 | 1 | Abschluss- und Zwischenplatte | 2002-1492 | WAGO | WAGO.2002-1492
+ST1-XD0 | 4 | 2-Leiter-Durchgangsklemme | 2002-1201 | WAGO | WAGO.2002-1201
+ST1-XD0 | 1 | 2-Leiter-Durchgangsklemme | 2002-1204 | WAGO | WAGO.2002-1204
+ST1-XD0 | 1 | 2-Leiter-Schutzleiterklemme | 2002-1207 | WAGO | WAGO.2002-1207
+ST1-XD1 | 1 | Abschluss- und Zwischenplatte | 2002-1292 | WAGO | WAGO.2002-1292
+ST1-XD1 | 1 | Schraubenlose Endklammer | 249-117 | WAGO | WAGO.249-117
+ST1-XD1 | 1 | Gruppenschildträger | 249-119 | WAGO | WAGO.249-119
+ST1-XD1 | 14 | 2-Leiter-Durchgangsklemme | 2002-1201 | WAGO | WAGO.2002-1201
Artikelstückliste | F01_001

5400.b

STK

## Artikelstückliste : WAGO.2002-1207 -WAGO.2006-1681

5400.d

5400.c

Betriebsmittelkennzeichen | Menge | Bezeichnung | Typnummer | Lieferant | Artikelnummer
+ST1-XD1 | 4 | 2-Leiter-Schutzleiterklemme | 2002-1207 | WAGO | WAGO.2002-1207
+ST1-XD01 | 1 | Abschluss- und Zwischenplatte | 2002-1292 | WAGO | WAGO.2002-1292
+ST1-XD01 | 1 | Schraubenlose Endklammer | 249-117 | WAGO | WAGO.249-117
+ST1-XD01 | 1 | Gruppenschildträger | 249-119 | WAGO | WAGO.249-119
+ST1-XD01 | 1 | Querverbinder/Brücker für Reihenklemme | 2002-403 | | WAGO.2002-403
+ST1-XD01 | 2 | 2-Leiter-Durchgangsklemme | 2002-1201 | WAGO | WAGO.2002-1201
+ST1-XD01 | 2 | 2-Leiter-Schutzleiterklemme | 2002-1207 | WAGO | WAGO.2002-1207
+ST1-XD01 | 0
+ST1-XD6 | 1 | Abschluss- und Zwischenplatte | 2002-2292 | WAGO | WAGO.2002-2292
+ST1-XD6 | 1 | Schraubenlose Endklammer | 249-117 | WAGO | WAGO.249-117
+ST1-XD6 | 1 | Gruppenschildträger | 249-119 | WAGO | WAGO.249-119
+ST1-XD6 | 12 | Doppelstockklemme | 2002-2231 | WAGO | WAGO.2002-2231
+ST1-XD6 | 5 | Doppelstockklemme | 2002-2237 | WAGO | WAGO.2002-2237
+ST1-XD6 | 8 | 2-Leiter-Durchgangsklemme | 2002-1201 | WAGO | WAGO.2002-1201
+ST1-XD10 | 1 | Abschluss- und Zwischenplatte | 2002-2292 | WAGO | WAGO.2002-2292
+ST1-XD10 | 1 | Schraubenlose Endklammer | 249-117 | WAGO | WAGO.249-117
+ST1-XD10 | 1 | Gruppenschildträger | 249-119 | WAGO | WAGO.249-119
+ST1-XD10 | 10 | Doppelstockklemme | 2002-2231 | WAGO | WAGO.2002-2231
+ST1-XD11 | 1 | Abschluss- und Zwischenplatte | 2002-2292 | WAGO | WAGO.2002-2292
+ST1-XD11 | 1 | Schraubenlose Endklammer | 249-117 | WAGO | WAGO.249-117
+ST1-XD11 | 1 | Gruppenschildträger | 249-119 | WAGO | WAGO.249-119
+ST1-XD11 | 9 | Doppelstockklemme | 2002-2231 | WAGO | WAGO.2002-2231
+ST1-XD11 | 1 | Doppelstockklemme | 2002-2237 | WAGO | WAGO.2002-2237
+ST1-XD12 | 1 | Abschluss- und Zwischenplatte | 2002-2292 | WAGO | WAGO.2002-2292
+ST1-XD12 | 1 | Schraubenlose Endklammer | 249-117 | WAGO | WAGO.249-117
+ST1-XD12 | 1 | Gruppenschildträger | 249-119 | WAGO | WAGO.249-119
+ST1-XD12 | 10 | Doppelstockklemme | 2002-2231 | WAGO | WAGO.2002-2231
+ST1-XD20 | 1 | Abschluss- und Zwischenplatte | 2002-2292 | WAGO | WAGO.2002-2292
+ST1-XD20 | 1 | Schraubenlose Endklammer | 249-117 | WAGO | WAGO.249-117
+ST1-XD20 | 1 | Gruppenschildträger | 249-119 | WAGO | WAGO.249-119
+ST1-XD20 | 19 | Doppelstockklemme | 2002-2231 | WAGO | WAGO.2002-2231
+ST1-XD30 | 10 | Doppelstockklemme | 2002-2231 | WAGO | WAGO.2002-2231
+ST1-XD30 | 1 | Doppelstockklemme | 2002-2237 | WAGO | WAGO.2002-2237
+ST1-XD40 | 0
+ST1-106XD230 | 1 | Steckdose für Schaltschrank, gelb, mit LED | 07.98.00 | | FIN.07.98.00
+ST1-XDM24 | 1 | Abschluss- und Zwischenplatte | 2002-1492 | WAGO | WAGO.2002-1492
+ST1-XDM24 | 1 | Querverbinder/Brücker für Reihenklemme | 2002-409 | | WAGO.2002-409
+ST1-XDM24 | 1 | Schraubenlose Endklammer | 249-117 | WAGO | WAGO.249-117
+ST1-XDM24 | 1 | Gruppenschildträger | 249-119 | WAGO | WAGO.249-119
+ST1-XDM24 | 9 | 4-Leiter-Durchgangsklemme | 2002-1401 | WAGO | WAGO.2002-1401
+ST1-XDM48 | 1 | Abschluss- und Zwischenplatte für Reihenklemme | 2004-1292 | | WAGO.2004-1292
+ST1-XDM48 | 1 | Querverbinder/Brücker für Reihenklemme | 2004-403 | | WAGO.2004-403
+ST1-XDM48 | 1 | Schraubenlose Endklammer | 249-117 | WAGO | WAGO.249-117
+ST1-XDM48 | 1 | Gruppenschildträger | 249-119 | WAGO | WAGO.249-119
+ST1-XDM48 | 2 | 2-Leiter-Durchgangsklemme | 2004-1201 | WAGO | WAGO.2004-1201
+ST1-XDN | 2 | 4-Leiter-Durchgangsklemme | 2002-1404 | WAGO | WAGO.2002-1404
+ST1-XDP24 | 1 | Abschluss- und Zwischenplatte | 2002-1492 | WAGO | WAGO.2002-1492
+ST1-XDP24 | 1 | Schraubenlose Endklammer | 249-117 | WAGO | WAGO.249-117
+ST1-XDP24 | 1 | Gruppenschildträger | 249-119 | WAGO | WAGO.249-119
+ST1-XDP24 | 1 | Querverbinder/Brücker für Reihenklemme | 2002-403 | | WAGO.2002-403
+ST1-XDP24 | 9 | 4-Leiter-Durchgangsklemme | 2002-1401 | WAGO | WAGO.2002-1401
+ST1-XDP48 | 1 | Abschluss- und Zwischenplatte für Reihenklemme | 2006-1692 | | WAGO.2006-1692
+ST1-XDP48 | 1 | Querverbinder/Brücker für Reihenklemme | 2006-403 | | WAGO.2006-403
+ST1-XDP48 | 1 | Schraubenlose Endklammer | 249-117 | WAGO | WAGO.249-117
+ST1-XDP48 | 1 | Gruppenschildträger | 249-119 | WAGO | WAGO.249-119
+ST1-XDP48 | 2 | 2-Leiter-Sicherungsklemme für Kfz-Sicherungen | 2006-1681 | WAGO | WAGO.2006-1681
Artikelstückliste | F01_001

5400.c

STK

## Artikelstückliste : WAGO.2006-1692 -WAGO.2002-3292

5400.e

5400.d

Betriebsmittelkennzeichen | Menge | Bezeichnung | Typnummer | Lieferant | Artikelnummer
+ST1-XDS48 | 1 | Abschluss- und Zwischenplatte für Reihenklemme | 2006-1692 | | WAGO.2006-1692
+ST1-XDS48 | 1 | Schraubenlose Endklammer | 249-117 | WAGO | WAGO.249-117
+ST1-XDS48 | 1 | Gruppenschildträger | 249-119 | WAGO | WAGO.249-119
+ST1-XDS48 | 1 | 2-Leiter-Sicherungsklemme für Kfz-Sicherungen | 2006-1681 | WAGO | WAGO.2006-1681
+ST1-XDS48 | 1 | 2-Leiter-Durchgangsklemme | 2004-1201 | WAGO | WAGO.2004-1201
+ST1-XPE | 1 | Abschluss- und Zwischenplatte | 2002-1292 | WAGO | WAGO.2002-1292
+ST1-XPE | 1 | Querverbinder/Brücker für Reihenklemme | 2002-404 | WAGO | WAGO.2002-404
+ST1-XPE | 1 | Schraubenlose Endklammer | 249-117 | WAGO | WAGO.249-117
+ST1-XPE | 1 | Gruppenschildträger | 249-119 | WAGO | WAGO.249-119
+ST1-XPE | 4 | 4-Leiter-Schutzleiterklemme | 2002-1407 | WAGO | WAGO.2002-1407
+ST1-107XTR24 | 1 | Erdleiter-Trennklemme | 2006-1671/1000-848 | WAGO | WAGO.2006-1671/1000-848
+ST1-107XTR24 | 1 | Abschluss- und Zwischenplatte für Reihenklemme | 2006-1692 | | WAGO.2006-1692
+ST1-107XTR24 | 1 | Schraubenlose Endklammer | 249-117 | WAGO | WAGO.249-117
+ST1-110XTR48 | 1 | Erdleiter-Trennklemme | 2006-1671/1000-849 | | WAGO.2006-1671/1000-849
+ST1-110XTR48 | 1 | Abschluss- und Zwischenplatte für Reihenklemme | 2006-1692 | | WAGO.2006-1692
+ST1-110XTR48 | 1 | Schraubenlose Endklammer | 249-117 | WAGO | WAGO.249-117
+ST2 | 1 | Montageplatte | KX.1569800 | | RIT.1569800
+ST2 | 1 | Kleingehäuse KX | KX.1509000 | | RIT.1509000
+ST2 | 3 | SKINTOP ST-M 20x1,5 RAL 7001 SGY | SKINTOP® ST-M | | LAPP.53111020
+ST2 | 3 | SKINTOP GMP-GL-M 20x1,5 RAL 7001 SGY | SKINTOP® GMP-GL-M | | LAPP.53119020
+ST2 | 17 | SKINTOP ST-M 25x1,5 RAL 7001 SGY | SKINTOP® ST-M | | LAPP.53111030
+ST2 | 17 | SKINTOP GMP-GL-M 25x1,5 RAL 7001 SGY | SKINTOP® GMP-GL-M | | LAPP.53119030
+ST2 | 17 | SKINTOP DIX-M 25450 | SKINTOP® DIX-M | | LAPP.53325450
+ST2-411TF1 | 0
+ST2-XD10.1 | 18 | Dreistockklemme | 2002-3231 | WAGO | WAGO.2002-3231
+ST2-XD11.1 | 6 | Doppelstockklemme | 2002-2231 | WAGO | WAGO.2002-2231
+ST2-XD12.1 | 18 | Dreistockklemme | 2002-3231 | WAGO | WAGO.2002-3231
+ANL-310A1 | 0
+ANL-315E1 | 0
+ANL-301MA1 | 1 | 2 Phasen Hybrid Schrittmotor, 5 A parallel, Bremse 2 Nm, 3,5 Nm Halte, 2,5 Nm Stillstand | 80MPF5.500D114-01 | BuR | BuR.80MPF5.500D114-01
+ANL-301MA1 | 0
+ANL-302MA2 | 1 | 2 Phasen Hybrid Schrittmotor, 6 A parallel, 3A seriell, 1,8 Nm Halte, 1,25 Nm Stillstand | 80MPD3.300S000-01 | BuR | BuR.80MPD3.300S000-01
+ANL-302MA2 | 0
+ANL-303MA1 | 1 | 2 Phasen Hybrid Schrittmotor, 5 A parallel, Bremse 2 Nm, 3,5 Nm Halte, 2,5 Nm Stillstand | 80MPF5.500D114-01 | BuR | BuR.80MPF5.500D114-01
+ANL-303MA1 | 0
+ANL-304MA2 | 1 | 2 Phasen Hybrid Schrittmotor, 6 A parallel, 3A seriell, 1,8 Nm Halte, 1,25 Nm Stillstand | 80MPD3.300S000-01 | BuR | BuR.80MPD3.300S000-01
+ANL-304MA2 | 0
+ANL-310MA1 | 0
+ANL-310MA2 | 0
+ANL-311MA1 | 0
+ANL-301aAA1 | 1 | | | | K+C Glasmaßstab Typ-S5
+SENS-401BG1.1 | 1 | Sensor induktiv | BES 516-356-S4-C | | BAL.BES01H6
+SENS-401BG1.2 | 1 | Sensor induktiv | BES 516-356-S4-C | | BAL.BES01H6
+SENS-401BG2.1 | 1 | D-M9*, elektronischer Schalter, Direktmontage, eingegossenes Kabel | D-M9NL | | SMC.D-M9NL
+SENS-401BG2.2 | 1 | D-M9*, elektronischer Schalter, Direktmontage, eingegossenes Kabel | D-M9NL | | SMC.D-M9NL
+SENS-401BG3.1 | 1 | D-M9*, elektronischer Schalter, Direktmontage, eingegossenes Kabel | D-M9NL | | SMC.D-M9NL
+SENS-401BG3.2 | 1 | D-M9*, elektronischer Schalter, Direktmontage, eingegossenes Kabel | D-M9NL | | SMC.D-M9NL
+SENS-415BO1 | 0
+SENS-410BT1 | 0
+SENS-410BT2 | 0
+SENS-410BT3 | 0
+SENS-410BT4 | 0
+SENS-410BT5 | 0
+SENS-410BT6 | 0
+SENS-411BT1 | 0
+SENS-XD10.1 | 1 | Abschluss- und Zwischenplatte für Reihenklemme | 2002-3292 | WAGO | WAGO.2002-3292
Artikelstückliste | F01_001

5400.d

STK

## Artikelstückliste : WAGO.249-117 -

5400.e

Betriebsmittelkennzeichen | Menge | Bezeichnung | Typnummer | Lieferant | Artikelnummer
+SENS-XD10.1 | 1 | Schraubenlose Endklammer | 249-117 | WAGO | WAGO.249-117
+SENS-XD10.1 | 1 | Gruppenschildträger | 249-119 | WAGO | WAGO.249-119
+SENS-XD10.1 | 4 | Querverbinder/Brücker für Reihenklemme | 2002-407 | | WAGO.2002-407
+SENS-XD11.1 | 1 | Abschluss- und Zwischenplatte | 2002-2292 | WAGO | WAGO.2002-2292
+SENS-XD11.1 | 1 | Schraubenlose Endklammer | 249-117 | WAGO | WAGO.249-117
+SENS-XD11.1 | 1 | Gruppenschildträger | 249-119 | WAGO | WAGO.249-119
+SENS-501Y1 | 0
+SENS-501Y2 | 0
+SENS-501Y4 | 0
+SENS-501Y5 | 0
+AKT-Cd12.1 | 1 | Abschluss- und Zwischenplatte für Reihenklemme | 2002-3292 | WAGO | WAGO.2002-3292
+AKT-Cd12.1 | 1 | Schraubenlose Endklammer | 249-117 | WAGO | WAGO.249-117
+AKT-Cd12.1 | 1 | Gruppenschildträger | 249-119 | WAGO | WAGO.249-119
+AKT-Cd12.1 | 4 | Querverbinder/Brücker für Reihenklemme | 2002-409 | | WAGO.2002-409
+AKT-501Y1 | 0
+AKT-501Y2 | 0
+AKT-501Y3 | 0
+AKT-501Y4 | 0
+AKT-501Y5 | 0
+LAS-601A1 | 0
+LAS-601A1-A1-X12 | 0
+LAS-602A1 | 0
+LAS-602A2 | 0
+SCH1-X100 | 0
Artikelstückliste | F01_001

5400.e

STK

## Artikelsummenstückliste : BuR.80SD100XD.C044-01 - ETN.M22-PV/K01

5500.a

Bestellnummer | Menge | Beschreibung Bezeichnung | Typnummer Artikelnummer | Hersteller Lieferant | Einzelpreis | Gesamtpreis | Pos.
80SD100XD.C044-01 | 2 Stück | ACPu, 2x Step. 10A, X2X, 2x ABR | 80SD100XD.C044-01 BuR.80SD100XD.C044-01 | BuR BuR | 0,00
| 0
| 1 Stück | APC2100 E3815 1C 1.46GHz 512kB 5W 1GB | 5APC2100.BY01-000 BuR.5APC2100.BY01-000 | BuR BuR | 0,00
| 1 Stück | X20 SafeLOGIC, POWERLINK, X2X Link, univ | X20SL8101 BuR.X20SL8101 | BuR BuR | 0,00
| 5 Stück | X20 Klemmblock safety, 12-fach | X20TB52 BuR.X20TB52 | BuR BuR | 0,00
| 1 Stück | X20 SafeKEY 2 MByte | X20MK0211 BuR.X20MK0211 | BuR BuR | 0,00
| 7 Stück | Abschluss- und Zwischenplatte | 2002-2292 WAGO.2002-2292 | WAGO WAGO | 0,00
| 23 Stück | Schraubenlose Endklammer | 249-117 WAGO.249-117 | WAGO WAGO | 0,00
| 19 Stück | Gruppenschildträger | 249-119 WAGO.249-119 | WAGO WAGO | 0,00
| 2 Stück | LEITUNGSSCHUTZSCHALTER 230/400V 10KA, 1POLIG, C, 6A, T=70MM | 5SY4106-7 SIE.5SY4106-7 | SIE SIE | 0,00
| 1 Stück | Leitungsschutzschalter 230/400V 10kA, 1-polig, B, 10A, T=70mm | 5SY4110-6 SIE.5SY4110-6 | SIE | 0,00
| 1 | LEITUNGSSCHUTZSCHALTER 230/400V 10KA, 1POLIG, C, 4A, T=70MM | 5SY4104-7 SIE.5SY4104-7 | SIE SIE | 0,00
| 3 Stück | Sicherungsklemme mit schwenkbarem Sicherungshalter | 281-611/281-541 WAGO.281-611/281-541 | WAGO | 0,00
| 1 Stück | Abschluss- und Zwischenplatte | 281-311 WAGO.281-311 | WAGO | 0,00
| 2 Stück | Querbrücker | 281-402 WAGO.281-402 | WAGO | 0,00
| 2 | LEITUNGSSCHUTZSCHALTER 230/400V 10KA, 1POLIG, B, 16A, T=70MM | 5SY4116-6 SIE.5SY4116-6 | SIE SIE | 0,00
| 2 Stück | Hilfsstromschalter anbaubar 1S+1Ö für LS-Schalter 5SL, 5SY, 5SP | 5ST3010 SIE.5ST3010 | SIE | 0,00
| 2 Stück | NOT-HALT/AUS-Taste, d = 38 mm, zugentriegelt, unbeleuchtet, 2 Öffner, Aufbau | M22-PV/KC02/IY ETN.M22-PV/KC02/IY | ETN ETN | 0,00
| 1 Stück | NOT-HALT/AUS-Taste, d = 38 mm, zugentriegelt, unbeleuchtet, 1 Öffner, Fronteinbau | M22-PV/K01 ETN.M22-PV/K01 | ETN ETN | 0,00
Artikelsummenstückliste | F02_001

0,00

0,00

5APC2100.BY01-000 | 0,00
X20SL8101 | 0,00
X20TB52 | 0,00
X20MK0211 | 0,00
2002-2292 | 0,00
249-117 | 0,00
249-119 | 0,00
5SY4106-7 | 0,00
5SY4110-6 | 0,00
5SY4104-7 | 0,00
281-611/281-541 | 0,00
281-311 | 0,00
281-402 | 0,00
5SY4116-6 | 0,00
5ST3010 | 0,00
216524 | 0,00
216515 | 0,00

STK

## Artikelsummenstückliste : ETN.M22-K01 -BuR.X20SO6300

5500.b

5500.a

Bestellnummer | Menge | Beschreibung Bezeichnung | Typnummer Artikelnummer | Hersteller Lieferant | Einzelpreis | Gesamtpreis | Pos.
| 1 Stück | Kontaktelement 1 Öffner, Frontbefestigung, Schraubanschluss | M22-K01 ETN.M22-K01 | ETN ETN | 0,00
| 1 Stück | Bezeichnungsschild für Befehlsgeräte | M22-XBK11 ETN.121372 | ETN | 0,00
| 1 Stück | Sicherheitsschalter | PSENme 1S/1AS PILZ.570000 | PILZ | 0,00
| 1 Stück | Sicherheitsgerichteter Transponderschalter | PSEN cs3.1a 1 switch PILZ.541061 | PILZ | 0,00
| 1 Stück | Koppelrelais | 49.62.9.024.0050 FIN.49.62.9.024.0050 | FIN | 0,00
| 1 Stück | 20 Bus Controller POWERLINK | X20BC0083 BuR.X20BC0083 | BuR BuR | 0,00
| 1 Stück | X20 Bus Controller Basis | X20BB80 BuR.X20BB80 | BuR BuR | 0,00
| 1 Stück | X20 BC Einspeisung, 24V, Busversorgung | X20PS9400 BuR.X20PS9400 | BuR BuR | 0,00
| 24 Stück | X20 Standard Klemmblock 12-fach | X20TB12 BuR.X20TB12 | BuR BuR | 0,00
| 1 Stück | X20 Bussender | X20BT9100 BuR.X20BT9100 | BuR BuR | 0,00
| 23 Stück | X20 Busmodul mit Power Bus Durchgang | X20BM11 BuR.X20BM11 | BuR BuR | 0,00
| 1 Stück | X20 Analog 6xE, THERMOELEMENT | X20AT6402 BuR.X20AT6402 | BuR BuR | 0,00
| 3 Stück | X20 Analog 4xA, +/-10V/0..20 mA, 12 Bit | X20AO4622 BuR.X20AO4622 | BuR BuR | 0,00
| 1 Stück | X20 Analog 4xE, +/-10V/0..20 mA, 12 Bit | X20AI4622 BuR.X20AI4622 | BuR BuR | 0,00
| 8 Stück | X20 Digital 6xE, 24V, Sink, 2 Leiter | X20DI6371 BuR.X20DI6371 | BuR BuR | 0,00
| 8 Stück | X20 Digital 6xA, 24V 0.5A, Source, 2 L. | X20DO6322 BuR.X20DO6322 | BuR BuR | 0,00
| 1 Stück | X20 Safe Digital 8xE, 24V, 4xE KAT4 | X20SI8110 BuR.X20SI8110 | BuR BuR | 0,00
| 1 Stück | X20 Bus safety 12.5mm, Power Bus Durchg. | X20BM13 BuR.X20BM13 | BuR BuR | 0,00
| 1 Stück | X20 Safe Digital 6xA, 24V, 0.1A | X20SO6300 BuR.X20SO6300 | BuR BuR | 0,00
Artikelsummenstückliste | F02_001
216378 | 0,00
121372 | 0,00
570000 | 0,00
541061 | 0,00
49.62.9.024.0050 | 0,00
X20BC0083 | 0,00
X20BB80 | 0,00
X20PS9400 | 0,00
X20TB12 | 0,00
X20BT9100 | 0,00
X20BM11 | 0,00
X20AT6402 | 0,00
X20AO4622 | 0,00
X20AI4622 | 0,00
X20DI6371 | 0,00
X20DO6322 | 0,00
X20SI8110 | 0,00
X20BM13 | 0,00
X20SO6300 | 0,00

5500.a

STK

## Artikelsummenstückliste : BuR.X20BM36 -ETN.216374

5500.c

5500.b

Bestellnummer | Menge | Beschreibung Bezeichnung | Typnummer Artikelnummer | Hersteller Lieferant | Einzelpreis | Gesamtpreis | Pos.
| 2 Stück | X20 Bus safety 25mm, Node Nr., Durchgang | X20BM36 BuR.X20BM36 | BuR BuR | 0,00
| 1 Stück | X20 Safe Digital 8xE, 4xA 3A, 2xA 50mA | X20SC0842 BuR.X20SC0842 | BuR BuR | 0,00
| 1 Stück | X20 Zähler, 1x ABR, TTL, 250 kHz, Mon. | X20DC1976 BuR.X20DC1976 | BuR BuR | 0,00
| 2 st. | Koppelrelais mit Schraubanschlüssen, 2 Wechsler 8 A, Spule 24 V DC sensitiv | 48.52.7.024.0050 FIN.48.52.7.024.0050 | FIN FIN | 0,00
| 1 Stück | Solid-State-Relaismodul | PLC-OPT- 5DC/ 24DC/2/ACT PXC.2900375 | PXC PXC | 0,00
| 1 Stück | Solid-State-Relaismodul | PLC-OPT- 24DC/ 24DC/2 PXC.2900364 | PXC PXC | 0,00
| 1 Stück | Signalsäule, Komplettgerät | 649.000.02 WER.649.000.02 | WER | 0,00
3RV2011-1JA10 | 1 | LEISTUNGSSCHALTER SCHRAUBANSCHL. 10A | 3RV2011-1JA10 SIE.3RV2011-1JA10 | SIE SIE | 0,00
3RV2011-1DA10 | 1 | LEISTUNGSSCHALTER SCHRAUBANSCHL. 3,2A | 3RV2011-1DA10 SIE.3RV2011-1DA10 | SIE SIE | 0,00
3RV29011E | 1 | HILFSSCHALTER QUERLIEGEND, 1S+1OE, SCHRAUBANSCHLUSS, | 3RV2901-1E SIE.3RV2901-1E | SIE SIE | 0,00
3RT2018-1BB42 | 2 | SCHUETZ,AC3:7,5KW 1OE DC24V | 3RT2018-1BB42 SIE.3RT2018-1BB42 | SIE SIE | 0,00
| 4 | HILFSSCHALTERBLOCK , 4S STROMBAHNEN: 1S, 1S, 1S, 1S | 3RH2911-1FA40 SIE.3RH2911-1FA40 | SIE SIE | 0,00
| 5 | UEBERSPANNUNGSBEGRENZER, VARISTOR, | 3RT2916-1BB00 SIE.3RT2916-1BB00 | SIE SIE | 0,00
| 2 | SCHUETZ,AC3:3KW 1OE DC24V | 3RT2015-1BB42 SIE.3RT2015-1BB42 | SIE SIE | 0,00
| 1 | SCHUETZ,AC3:3KW 1S DC24V | 3RT2015-1BB41 SIE.3RT2015-1BB41 | SIE SIE | 0,00
77.45.9.024.8250 | 1 Stück | Elektronisches Lastrelais, 40 A | 77.45.9.024.8250 FIN.77.45.9.024.8250 | FIN | 0,00
| 1 Stück | Hauptschalter, 3-polig, 25 A, HALT-Funktion, abschließbar in 0-Stellung, Einbau | P1-25/EA/SVB-SW ETN.P1-25/EA/SVB-SW | ETN ETN | 0,00
| 1 Stück | Leuchtwahltaste, 2 Stellungen, weiß, rastend | M22-WRLK-W ETN.M22-WRLK-W | ETN ETN | 0,00
| 1 Stück | Adapter für Befehlsgeräte | M22-A ETN.216374 | ETN | 0,00
Artikelsummenstückliste | F02_001
X20BM36 | 0,00
X20SC0842 | 0,00
X20DC1976 | 0,00
48.52.7.024.0050 | 0,00
2900375 | 0,00
2900364 | 0,00
649.000.02 | 0,00

0,00

0,00

0,00

0,00

3RH29111FA40 | 0,00
3RT29161BB00 | 0,00
3RT2015-1BB42 | 0,00
3RT2015-1BB41 | 0,00

0,00

048365 | 0,00
216823 | 0,00
216374 | 0,00

5500.b

STK

## Artikelsummenstückliste : ETN.M22-K10 -WAGO.2004-1201

5500.d

5500.c

Bestellnummer | Menge | Beschreibung Bezeichnung | Typnummer Artikelnummer | Hersteller Lieferant | Einzelpreis | Gesamtpreis | Pos.
| 1 Stück | Kontaktelement 1 Schließer, Frontbefestigung, Schraubanschluss | M22-K10 ETN.M22-K10 | ETN ETN | 0,00
| 1 Stück | Schildträger, ohne Schild, schwarz | M22S-ST-X ETN.M22S-ST-X | ETN ETN | 0,00
| 1 Stück | Stromversorgung, 1AC, Ausgang 24V 10A | QS10.241 PULS.QS10.241 | PULS PULS | 0,00
| 1 Stück | Stromversorgung, 48V, 10A | CP20.481 PULS.CP20.481 | PULS PULS | 0,00
2002-402 | 2 Stück | Kammbrücker | 2002-402 WAGO.2002-402 | WAGO WAGO | 0,00
| 4 Stück | Abschluss- und Zwischenplatte | 2002-1292 WAGO.2002-1292 | WAGO WAGO | 0,00
| 3 Stück | Abschluss- und Zwischenplatte | 2002-1492 WAGO.2002-1492 | WAGO WAGO | 0,00
| 28 Stück | 2-Leiter-Durchgangsklemme | 2002-1201 WAGO.2002-1201 | WAGO WAGO | 0,00
| 1 Stück | 2-Leiter-Durchgangsklemme | 2002-1204 WAGO.2002-1204 | WAGO WAGO | 0,00
| 7 Stück | 2-Leiter-Schutzleiterklemme | 2002-1207 WAGO.2002-1207 | WAGO WAGO | 0,00
| 2 Stück | Querverbinder/Brücker für Reihenklemme | 2002-403 WAGO.2002-403 | WAGO | 0,00
| 76 Stück | Doppelstockklemme | 2002-2231 WAGO.2002-2231 | WAGO WAGO | 0,00
| 7 Stück | Doppelstockklemme | 2002-2237 WAGO.2002-2237 | WAGO WAGO | 0,00
| 1 Stück | Steckdose für Schaltschrank, gelb, mit LED | 07.98.00 FIN.07.98.00 | FIN | 0,00
| 5 Stück | Querverbinder/Brücker für Reihenklemme | 2002-409 WAGO.2002-409 | WAGO | 0,00
| 18 Stück | 4-Leiter-Durchgangsklemme | 2002-1401 WAGO.2002-1401 | WAGO WAGO | 0,00
| 1 Stück | Abschluss- und Zwischenplatte für Reihenklemme | 2004-1292 WAGO.2004-1292 | WAGO | 0,00
| 1 Stück | Querverbinder/Brücker für Reihenklemme | 2004-403 WAGO.2004-403 | WAGO | 0,00
| 3 Stück | 2-Leiter-Durchgangsklemme | 2004-1201 WAGO.2004-1201 | WAGO WAGO | 0,00
Artikelsummenstückliste | F02_001
216376 | 0,00
216392 | 0,00
QS10.241 | 0,00
CP20.481 | 0,00

0,00

2002-1292 | 0,00
2002-1492 | 0,00
2002-1201 | 0,00
2002-1204 | 0,00
2002-1207 | 0,00
2002-403 | 0,00
2002-2231 | 0,00
2002-2237 | 0,00
07.98.00 | 0,00
2002-409 | 0,00
2002-1401 | 0,00
2004-1292 | 0,00
2004-403 | 0,00
2004-1201 | 0,00

5500.c

STK

## Artikelsummenstückliste : WAGO.2002-1404 -K+C Glasmaßstab Typ-S5

5500.e

5500.d

Bestellnummer | Menge | Beschreibung Bezeichnung | Typnummer Artikelnummer | Hersteller Lieferant | Einzelpreis | Gesamtpreis | Pos.
| 2 Stück | 4-Leiter-Durchgangsklemme | 2002-1404 WAGO.2002-1404 | WAGO WAGO | 0,00
2006-1692 | 4 Stück | Abschluss- und Zwischenplatte für Reihenklemme | 2006-1692 WAGO.2006-1692 | WAGO | 0,00
| 1 Stück | Querverbinder/Brücker für Reihenklemme | 2006-403 WAGO.2006-403 | WAGO | 0,00
| 3 Stück | 2-Leiter-Sicherungsklemme für Kfz-Sicherungen | 2006-1681 WAGO.2006-1681 | WAGO WAGO | 0,00
2002-404 | 1 Stück | Querverbinder/Brücker für Reihenklemme | 2002-404 WAGO.2002-404 | WAGO WAGO | 0,00
| 4 Stück | 4-Leiter-Schutzleiterklemme | 2002-1407 WAGO.2002-1407 | WAGO WAGO | 0,00
| 1 Stück | Erdleiter-Trennklemme | 2006-1671/1000-848 WAGO.2006-1671/1000-848 | WAGO WAGO | 0,00
| 1 Stück | Erdleiter-Trennklemme | 2006-1671/1000-849 WAGO.2006-1671/1000-849 | WAGO | 0,00
1569800 | 1 Stück | Montageplatte | KX.1569800 RIT.1569800 | RIT | 0,00
1509000 | 1 Stück | Kleingehäuse KX | KX.1509000 RIT.1509000 | RIT | 0,00
| 3 Stück | SKINTOP ST-M 20x1,5 RAL 7001 SGY | SKINTOP® ST-M LAPP.53111020 | LAPP | 0,00
| 3 Stück | SKINTOP GMP-GL-M 20x1,5 RAL 7001 SGY | SKINTOP® GMP-GL-M LAPP.53119020 | LAPP | 0,00
| 17 Stück | SKINTOP ST-M 25x1,5 RAL 7001 SGY | SKINTOP® ST-M LAPP.53111030 | LAPP | 0,00
| 17 Stück | SKINTOP GMP-GL-M 25x1,5 RAL 7001 SGY | SKINTOP® GMP-GL-M LAPP.53119030 | LAPP | 0,00
| 17 Stück | SKINTOP DIX-M 25450 | SKINTOP® DIX-M LAPP.53325450 | LAPP | 0,00
| 36 Stück | Dreistockklemme | 2002-3231 WAGO.2002-3231 | WAGO WAGO | 0,00
80MPF5.500D114-01 | 2 | 2 Phasen Hybrid Schrittmotor, 5 A parallel, Bremse 2 Nm, 3,5 Nm Halte, 2,5 Nm Stillstand | 80MPF5.500D114-01 BuR.80MPF5.500D114-01 | BuR | 0,00
80MPD3.300S000-01 | 2 | 2 Phasen Hybrid Schrittmotor, 6 A parallel, 3A seriell, 1,8 Nm Halte, 1,25 Nm | 80MPD3.300S000-01 Stillstand BuR.80MPD3.300S000-01 | BuR | 0,00
| 1 | | K+C Glasmaßstab Typ-S5
Artikelsummenstückliste | F02_001
2002-1404 | 0,00

0,00

2006-403 | 0,00
2006-1681 | 0,00

0,00

2002-1407 | 0,00
2006-1671/1000-848 | 0,00
2006-1671/1000-849 | 0,00

0,00

0,00

53111020 | 0,00
53119020 | 0,00
53111030 | 0,00
53119030 | 0,00
53325450 | 0,00
2002-3231 | 0,00

0,00

0,00

0,00

5500.d

STK

## Artikelsummenstückliste : BAL.BES01H6 -WAGO.2002-407

5500.e

Bestellnummer | Menge | Beschreibung Bezeichnung | Typnummer Artikelnummer | Hersteller Lieferant | Einzelpreis | Gesamtpreis | Pos.
| 2 Stück | Sensor induktiv | BES 516-356-S4-C BAL.BES01H6 | BAL | 0,00
| 4 Stück | D-M9*, elektronischer Schalter, Direktmontage, eingegossenes Kabel | D-M9NL SMC.D-M9NL | SMC | 0,00
| 2 Stück | Abschluss- und Zwischenplatte für Reihenklemme | 2002-3292 WAGO.2002-3292 | WAGO WAGO | 0,00
| 4 Stück | Querverbinder/Brücker für Reihenklemme | 2002-407 WAGO.2002-407 | WAGO | 0,00
Artikelsummenstückliste | F02_001
BES01H6 | 0,00
D-M9NL | 0,00
2002-3292 | 0,00
2002-407 | 0,00
