DavidWenzler/reAM250/AMCF/Plugins/Resources/thumbnail_default.png

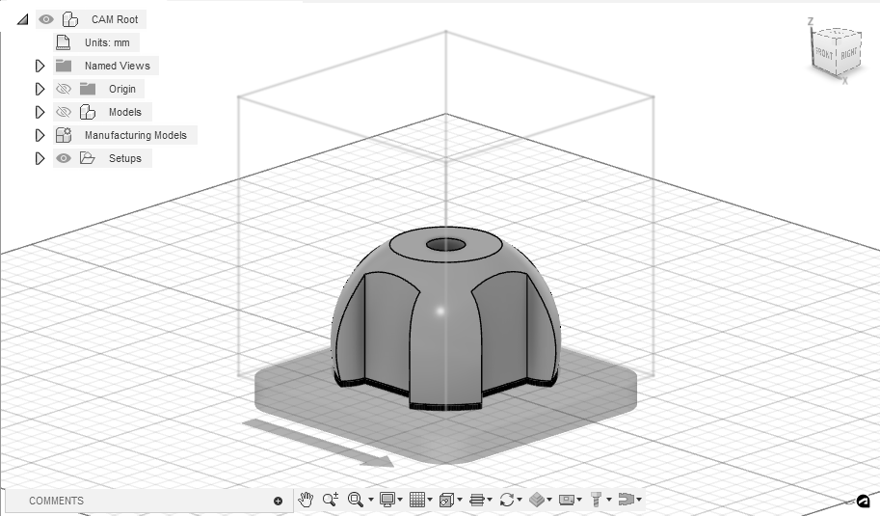
AMCF/Plugins/Resources/thumbnail_default.png
