DavidWenzler/reAM250/PLC/Physical/Hardware.jpg

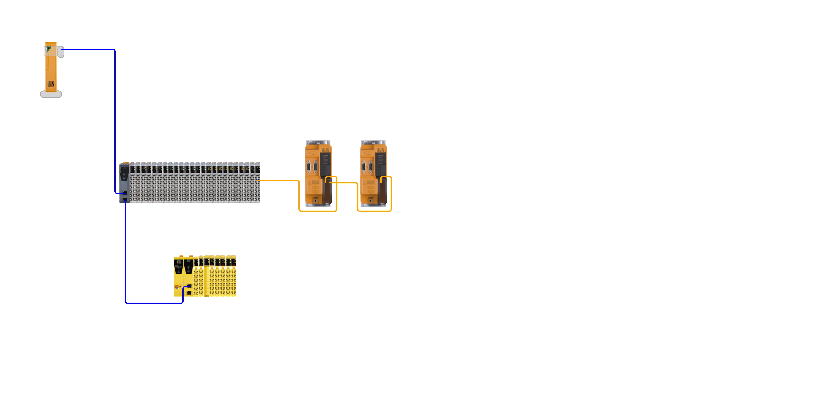
PLC/Physical/Hardware.jpg
