DavidWenzler/reAM250/(list of files, drawings)

Other design files:
PLC/Physical/Config1/111AF01/mappSafety/reAMsafe/C/PLC/R/CPU/ICI00004.DIP
PLC/Physical/Config1/111AF01/mappSafety/reAMsafe/C/PLC/R/CPU/ICI00005.DIP
PLC/Physical/Config1/111AF01/mappSafety/reAMsafe/C/PLC/R/CPU/ICI00006.DIP
PLC/Physical/Config1/111AF01/mappSafety/reAMsafe/C/PLC/R/CPU/ICI00008.DIP
PLC/Physical/Config1/111AF01/mappSafety/reAMsafe/C/PLC/R/CPU/ICI00016.DIP
PLC/Physical/Config1/111AF01/mappSafety/reAMsafe/C/PLC/R/CPU/ICI00017.DIP
PLC/Physical/Config1/111AF01/mappSafety/reAMsafe/C/PLC/R/CPU/ICI00018.DIP
PLC/Physical/Config1/111AF01/mappSafety/reAMsafe/C/PLC/R/CPU/ICI00020.DIP
PLC/Physical/Config1/111AF01/mappSafety/reAMsafe/C/PLC/R/CPU/ICI00021.DIP
PLC/Physical/Config1/111AF01/mappSafety/reAMsafe/C/PLC/R/CPU/ICI00022.DIP
PLC/Physical/Config1/111AF01/mappSafety/reAMsafe/C/PLC/R/CPU/ICI00027.DIP
PLC/Physical/Config1/111AF01/mappSafety/reAMsafe/C/PLC/R/CPU/ICI00028.DIP
PLC/Physical/Config1/111AF01/mappSafety/reAMsafe/C/PLC/R/CPU/ICI00029.DIP
PLC/Physical/Config1/111AF01/mappSafety/reAMsafe/C/PLC/R/CPU/ICI00031.DIP
PLC/Physical/Config1/111AF01/mappSafety/reAMsafe/C/PLC/R/CPU/ICI00039.DIP
PLC/Physical/Config1/111AF01/mappSafety/reAMsafe/C/PLC/R/CPU/ICI00040.DIP
PLC/Physical/Config1/111AF01/mappSafety/reAMsafe/C/PLC/R/CPU/ICI00041.DIP
PLC/Physical/Config1/111AF01/mappSafety/reAMsafe/C/PLC/R/CPU/ICI00043.DIP
PLC/Physical/Config1/111AF01/mappSafety/reAMsafe/C/PLC/R/CPU/ICI00044.DIP
PLC/Physical/Config1/111AF01/mappSafety/reAMsafe/C/PLC/R/CPU/ICI00045.DIP
PLC/Physical/Config1/111AF01/mappSafety/reAMsafe/C/PLC/R/CPU/ICI00078.DIP
PLC/Physical/Config1/111AF01/mappSafety/reAMsafe/C/PLC/R/CPU/ICI00079.DIP
PLC/Physical/Config1/111AF01/mappSafety/reAMsafe/C/PLC/R/CPU/ICI00081.DIP
