DavidWenzler/reAM250/AMCF/Plugins/Main/mcplugin_main.cpp

/*++

Copyright (C) 2020 Autodesk Inc.

All rights reserved.

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
THIS SOFTWARE IS PROVIDED BY THE COPYRIGHT HOLDERS AND CONTRIBUTORS "AS IS" AND
ANY EXPRESS OR IMPLIED WARRANTIES, INCLUDING, BUT NOT LIMITED TO, THE IMPLIED
WARRANTIES OF MERCHANTABILITY AND FITNESS FOR A PARTICULAR PURPOSE ARE
DISCLAIMED. IN NO EVENT SHALL AUTODESK INC. BE LIABLE FOR ANY
DIRECT, INDIRECT, INCIDENTAL, SPECIAL, EXEMPLARY, OR CONSEQUENTIAL DAMAGES
(INCLUDING, BUT NOT LIMITED TO, PROCUREMENT OF SUBSTITUTE GOODS OR SERVICES;
LOSS OF USE, DATA, OR PROFITS; OR BUSINESS INTERRUPTION) HOWEVER CAUSED AND
ON ANY THEORY OF LIABILITY, WHETHER IN CONTRACT, STRICT LIABILITY, OR TORT
(INCLUDING NEGLIGENCE OR OTHERWISE) ARISING IN ANY WAY OUT OF THE USE OF THIS
SOFTWARE, EVEN IF ADVISED OF THE POSSIBILITY OF SUCH DAMAGE.

*/

#include "libmcplugin_impl.hpp"

#include <sstream>
#include <iomanip>

#define MIN_LAYERHEIGHTINMM 0.001


#define MIN_PLATFORMAREAINMMSQUARED 1.0
#define MAX_PLATFORMAREAINMMSQUARED 1.0e12

#define MIN_POWDERRESERVOIRVOLUMEINMMCUBE 1.0
#define MAX_POWDERRESERVOIRVOLUMEINMMCUBE 1.0e12

#define MIN_POWDERRESERVOIROVERDOSEFACTOR 1.0
#define MAX_POWDERRESERVOIROVERDOSEFACTOR 100.0

#define MIN_AXIS_ID 1
#define MAX_AXIS_ID 4
#define ABSOLUTE_FLAG 1
#define RELATIVE_FLAG 2
#define MIN_TARGET -1000000
#define MAX_TARGET 1000000
#define MIN_SPEED -1000000
#define MAX_SPEED 1000000
#define MIN_ACCELERATION -1000000
#define MAX_ACCELERATION 1000000

#define CONTROLLER_INIT 1
#define CONTROLLER_UPDATE 0
#define CONTROLLER_ID_HEATER 1
#define CONTROLLER_ID_SHIELDINGGAS 2

#define AXISID_BUILDPLATFORM 1
#define AXISID_POWDERRESERVOIR 2
#define AXISID_RECOATERPOWDERBELT 3
#define AXISID_RECOATELINEAR 4

/*************************************************************************************************************************
  Driver import definition
**************************************************************************************************************************/
__NODRIVERIMPORT

/*************************************************************************************************************************
  State definitions
**************************************************************************************************************************/
__BEGINSTATEDEFINITIONS

__DECLARESTATE(init)
{
	pStateEnvironment->LogMessage("Initializing...");

	pStateEnvironment->SetIntegerParameter("jobinfo", "layercount", 0);
	pStateEnvironment->SetIntegerParameter("jobinfo", "currentlayer", 0);
	pStateEnvironment->SetDoubleParameter("jobinfo", "totalheight", 0.0);
	pStateEnvironment->SetDoubleParameter("jobinfo", "currentheight", 0.0);
	pStateEnvironment->SetBoolParameter("jobinfo", "printinprogress", false);

	pStateEnvironment->SetStringParameter("ui", "currentlayerdisplay", "---");
	pStateEnvironment->SetStringParameter("ui", "currentheightdisplay", "---");

	// initialize state machines of the PLC
	
	// Get Timeouts
	uint32_t nHeaterInitTimeout = pStateEnvironment->GetIntegerParameter("timeouts", "heaterinittimeout");
	uint32_t nOxygenInitTimeout = pStateEnvironment->GetIntegerParameter("timeouts", "oxygeninittimeout");
	uint32_t nVacuumInitTimeout = pStateEnvironment->GetIntegerParameter("timeouts", "vacuuminittimeout");
	uint32_t nAtmosphereInitTimeout = pStateEnvironment->GetIntegerParameter("timeouts", "atmosphereinittimeout");
	uint32_t nAxesInitTimeout = pStateEnvironment->GetIntegerParameter("timeouts", "axesinittimeout");
	uint32_t nInitialPlatformMovementTimeOut = pStateEnvironment->GetIntegerParameter("timeouts", "initialplatformmovementtimeout");
	uint32_t nGeneralCommandTimeout = pStateEnvironment->GetIntegerParameter("timeouts", "generalplctimeout");
	

	// initialize heater controller
	pStateEnvironment->LogMessage("Initializing build plate heater controller..");
	//retrieve PID parameters, tuner parameters, PWM parameters and the temperature setpoint from the parameter group
	//retrieve PID parameters from the parameter group
	auto dDerivativetimeHeater = pStateEnvironment->GetDoubleParameter("heatercontroller", "derivativetime");
	auto dIntegrationtimeHeater = pStateEnvironment->GetDoubleParameter("heatercontroller", "integrationtime");
	auto dGainHeater = pStateEnvironment->GetDoubleParameter("heatercontroller", "gain");
	auto dFiltertimeHeater = pStateEnvironment->GetDoubleParameter("heatercontroller", "filtertime");
	auto nMaxoutHeater = pStateEnvironment->GetIntegerParameter("heatercontroller", "maxout");
	auto nMinoutHeater = pStateEnvironment->GetIntegerParameter("heatercontroller", "minout");
	//retrieve PWM parameters from the parameter group
	auto nDutycycleHeater = pStateEnvironment->GetIntegerParameter("heatercontroller", "dutycycle");
	auto dPeriodTimeHeater = pStateEnvironment->GetDoubleParameter("heatercontroller", "periodTime");
	auto nMaxFrequencyHeater = pStateEnvironment->GetIntegerParameter("heatercontroller", "maxFrequency");
	auto bModeHeater = pStateEnvironment->GetBoolParameter("heatercontroller", "mode");
	//retrieve tuning parameters from the parameter group
	auto nStepheightHeater = pStateEnvironment->GetIntegerParameter("heatercontroller", "stepheight");
	auto nMaxactvalueHeater = pStateEnvironment->GetIntegerParameter("heatercontroller", "maxactvalue");
	auto nMinactvalueHeater = pStateEnvironment->GetIntegerParameter("heatercontroller", "minactvalue");
	auto dSystemsettlingtimeHeater = pStateEnvironment->GetDoubleParameter("heatercontroller", "systemsettlingtime");
	auto dMaxtuningtimeHeater = pStateEnvironment->GetDoubleParameter("heatercontroller", "maxtuningtime");
	//retrieve the temperature setpoint from the parameter group
	auto nSetpointHeater = pStateEnvironment->GetIntegerParameter("heatercontroller", "setpoint");

	// send signal to plc state machine to update the heater control tuner parameters
	auto pSignalInitTunerHeater = pStateEnvironment->PrepareSignal("plc", "signal_updatecontrollertuner");
	pSignalInitTunerHeater->SetBool("isinit", CONTROLLER_INIT);
	pSignalInitTunerHeater->SetInteger("controller_ID", CONTROLLER_ID_HEATER);
	pSignalInitTunerHeater->SetInteger("stepheight", nStepheightHeater);
	pSignalInitTunerHeater->SetInteger("maxactvalue", nMaxactvalueHeater);
	pSignalInitTunerHeater->SetInteger("minactvalue", nMinactvalueHeater);
	pSignalInitTunerHeater->SetDouble("systemsettlingtime", dSystemsettlingtimeHeater);
	pSignalInitTunerHeater->SetDouble("maxtuningtime", dMaxtuningtimeHeater);
	pSignalInitTunerHeater->Trigger();

	// send signal to plc state machine to update the heater control PWM parameters
	auto pSignalInitPWMHeater = pStateEnvironment->PrepareSignal("plc", "signal_updatecontrollerPWM");
	pSignalInitPWMHeater->SetBool("isinit", CONTROLLER_INIT);
	pSignalInitPWMHeater->SetInteger("controller_ID", CONTROLLER_ID_HEATER);
	pSignalInitPWMHeater->SetInteger("dutycycle", nDutycycleHeater);
	pSignalInitPWMHeater->SetDouble("periodTime", dPeriodTimeHeater);
	pSignalInitPWMHeater->SetInteger("maxFrequency", nMaxFrequencyHeater);
	pSignalInitPWMHeater->SetBool("mode", bModeHeater);
	pSignalInitPWMHeater->Trigger();

	// send signal to plc state machine to update the heater control PID parameters
	auto pSignalInitPIDHeater = pStateEnvironment->PrepareSignal("plc", "signal_updatecontrollerPID");
	pSignalInitPIDHeater->SetBool("isinit", CONTROLLER_INIT);
	pSignalInitPIDHeater->SetInteger("controller_ID", CONTROLLER_ID_HEATER);
	pSignalInitPIDHeater->SetDouble("derivativetime", dDerivativetimeHeater);
	pSignalInitPIDHeater->SetDouble("integrationtime", dIntegrationtimeHeater);
	pSignalInitPIDHeater->SetDouble("gain", dGainHeater);
	pSignalInitPIDHeater->SetDouble("filtertime", dFiltertimeHeater);
	pSignalInitPIDHeater->SetInteger("maxout", nMaxoutHeater);
	pSignalInitPIDHeater->SetInteger("minout", nMinoutHeater);
	pSignalInitPIDHeater->Trigger();

	// send signal to plc state machine to update the heater control temperature setpoint
	auto pSignalInitSetpointHeater = pStateEnvironment->PrepareSignal("plc", "signal_updatecontrollersetpoint");
	pSignalInitSetpointHeater->SetBool("isinit", CONTROLLER_INIT);
	pSignalInitSetpointHeater->SetInteger("controller_ID", CONTROLLER_ID_HEATER);
	pSignalInitSetpointHeater->SetInteger("setpoint", nSetpointHeater);
	pSignalInitSetpointHeater->Trigger();

	if (pSignalInitTunerHeater->WaitForHandling(nHeaterInitTimeout) && pSignalInitPWMHeater->WaitForHandling(nHeaterInitTimeout) && pSignalInitPIDHeater->WaitForHandling(nHeaterInitTimeout) && pSignalInitSetpointHeater->WaitForHandling(nHeaterInitTimeout)) {
		bool bTunerReadyHeater = pSignalInitTunerHeater->GetBoolResult("success");
		bool bPWMReadyHeater = pSignalInitPWMHeater->GetBoolResult("success");
		bool bPIDReadyHeater = pSignalInitPIDHeater->GetBoolResult("success");
		bool bSetpointReadyHeater = pSignalInitSetpointHeater->GetBoolResult("success");

		bool bHeaterControllerIsReady = bTunerReadyHeater && bPWMReadyHeater && bPIDReadyHeater && bSetpointReadyHeater;

		pStateEnvironment->SetBoolParameter("processinitialization", "heatercontroller_ready", bHeaterControllerIsReady);
		
		std::vector<std::string> readyControllersHeater;
		std::vector<std::string> notReadyControllersHeater;
		if (bTunerReadyHeater)
			readyControllersHeater.push_back("HeaterControllerTuner");
		else
			notReadyControllersHeater.push_back("HeaterControllerTuner");
		if (bPWMReadyHeater)
			readyControllersHeater.push_back("HeaterControllerPWM");
		else
			notReadyControllersHeater.push_back("HeaterControllerPWM");
		if (bPIDReadyHeater)
			readyControllersHeater.push_back("HeaterControllerPID");
		else
			notReadyControllersHeater.push_back("HeaterControllerPID");
		if (bSetpointReadyHeater)
			readyControllersHeater.push_back("HeaterControllerSetpoint");
		else
			notReadyControllersHeater.push_back("HeaterControllerSetpoint");

		if (readyControllersHeater.size() > 0) {
			std::string sReadyControllersHeaterString;
			for (auto controllerString : readyControllersHeater) {
				if (!sReadyControllersHeaterString.empty())
					sReadyControllersHeaterString += ", ";
				sReadyControllersHeaterString += controllerString;
			}
			pStateEnvironment->LogMessage("Initializing of " + sReadyControllersHeaterString + " successfull");
		}
		if(notReadyControllersHeater.size() > 0) {
			std::string sNotReadyControllersHeaterString;
			for (auto controllerString : notReadyControllersHeater) {
				if (!sNotReadyControllersHeaterString.empty())
					sNotReadyControllersHeaterString += ", ";
				sNotReadyControllersHeaterString += controllerString;
			}
			pStateEnvironment->LogMessage("Initializing of " + sNotReadyControllersHeaterString + " failed");
		}
	}
	else {
		// No response from PLC!
		pStateEnvironment->LogMessage("No response from PLC");
		pStateEnvironment->SetBoolParameter("processinitialization", "heatercontroller_ready", false);
		pStateEnvironment->SetStringParameter("processinitialization", "initerror", "COULDNOTINITIALIZEHEATERCONTROLLER");
		pStateEnvironment->SetNextState("initerror");
		return;
	}

	// inizialize oxygen controller
	pStateEnvironment->LogMessage("Initializing oxygen controller..");
	//retrieve PID parameters, tuner parameters, PWM parameters and the oxygen setpoint from the parameter group
	//retrieve PID parameters from the parameter group
	auto dDerivativetimeOxygen = pStateEnvironment->GetDoubleParameter("oxygencontroller", "derivativetime");
	auto dIntegrationtimeOxygen = pStateEnvironment->GetDoubleParameter("oxygencontroller", "integrationtime");
	auto dGainOxygen = pStateEnvironment->GetDoubleParameter("oxygencontroller", "gain");
	auto dFiltertimeOxygen = pStateEnvironment->GetDoubleParameter("oxygencontroller", "filtertime");
	auto nMaxoutOxygen = pStateEnvironment->GetIntegerParameter("oxygencontroller", "maxout");
	auto nMinoutOxygen = pStateEnvironment->GetIntegerParameter("oxygencontroller", "minout");
	//retrieve PWM parameters from the parameter group
	auto nDutycycleOxygen = pStateEnvironment->GetIntegerParameter("oxygencontroller", "dutycycle");
	auto dPeriodTimeOxygen = pStateEnvironment->GetDoubleParameter("oxygencontroller", "periodTime");
	auto nMaxFrequencyOxygen = pStateEnvironment->GetIntegerParameter("oxygencontroller", "maxFrequency");
	auto bModeOxygen = pStateEnvironment->GetBoolParameter("oxygencontroller", "mode");
	//retrieve tuning parameters from the parameter group
	auto nStepheightOxygen = pStateEnvironment->GetIntegerParameter("oxygencontroller", "stepheight");
	auto nMaxactvalueOxygen = pStateEnvironment->GetIntegerParameter("oxygencontroller", "maxactvalue");
	auto nMinactvalueOxygen = pStateEnvironment->GetIntegerParameter("oxygencontroller", "minactvalue");
	auto dSystemsettlingtimeOxygen = pStateEnvironment->GetDoubleParameter("oxygencontroller", "systemsettlingtime");
	auto dMaxtuningtimeOxygen = pStateEnvironment->GetDoubleParameter("oxygencontroller", "maxtuningtime");
	//retrieve the oxygen setpoint from the parameter group
	auto nSetpointOxygen = pStateEnvironment->GetIntegerParameter("oxygencontroller", "setpoint");

	// send signal to plc state machine to update the oxygen control tuner parameters
	auto pSignalInitTunerOxygen = pStateEnvironment->PrepareSignal("plc", "signal_updatecontrollertuner");
	pSignalInitTunerOxygen->SetBool("isinit", CONTROLLER_INIT);
	pSignalInitTunerOxygen->SetInteger("controller_ID", CONTROLLER_ID_SHIELDINGGAS);
	pSignalInitTunerOxygen->SetInteger("stepheight", nStepheightOxygen);
	pSignalInitTunerOxygen->SetInteger("maxactvalue", nMaxactvalueOxygen);
	pSignalInitTunerOxygen->SetInteger("minactvalue", nMinactvalueOxygen);
	pSignalInitTunerOxygen->SetDouble("systemsettlingtime", dSystemsettlingtimeOxygen);
	pSignalInitTunerOxygen->SetDouble("maxtuningtime", dMaxtuningtimeOxygen);
	pSignalInitTunerOxygen->Trigger();

	// send signal to plc state machine to update the oxygen control PWM parameters
	auto pSignalInitPWMOxygen = pStateEnvironment->PrepareSignal("plc", "signal_updatecontrollerPWM");
	pSignalInitPWMOxygen->SetBool("isinit", CONTROLLER_INIT);
	pSignalInitPWMOxygen->SetInteger("controller_ID", CONTROLLER_ID_SHIELDINGGAS);
	pSignalInitPWMOxygen->SetInteger("dutycycle", nDutycycleOxygen);
	pSignalInitPWMOxygen->SetDouble("periodTime", dPeriodTimeOxygen);
	pSignalInitPWMOxygen->SetInteger("maxFrequency", nMaxFrequencyOxygen);
	pSignalInitPWMOxygen->SetBool("mode", bModeOxygen);
	pSignalInitPWMOxygen->Trigger();

	// send signal to plc state machine to update the oxygen control PID parameters
	auto pSignalInitPIDOxygen = pStateEnvironment->PrepareSignal("plc", "signal_updatecontrollerPID");
	pSignalInitPIDOxygen->SetBool("isinit", CONTROLLER_INIT);
	pSignalInitPIDOxygen->SetInteger("controller_ID", CONTROLLER_ID_SHIELDINGGAS);
	pSignalInitPIDOxygen->SetDouble("derivativetime", dDerivativetimeOxygen);
	pSignalInitPIDOxygen->SetDouble("integrationtime", dIntegrationtimeOxygen);
	pSignalInitPIDOxygen->SetDouble("gain", dGainOxygen);
	pSignalInitPIDOxygen->SetDouble("filtertime", dFiltertimeOxygen);
	pSignalInitPIDOxygen->SetInteger("maxout", nMaxoutOxygen);
	pSignalInitPIDOxygen->SetInteger("minout", nMinoutOxygen);
	pSignalInitPIDOxygen->Trigger();

	// send signal to plc state machine to update the shielding gas control oxygen content setpoint
	auto pSignalInitSetpointOxygen = pStateEnvironment->PrepareSignal("plc", "signal_updatecontrollersetpoint");
	pSignalInitSetpointOxygen->SetBool("isinit", CONTROLLER_INIT);
	pSignalInitSetpointOxygen->SetInteger("controller_ID", CONTROLLER_ID_SHIELDINGGAS);
	pSignalInitSetpointOxygen->SetInteger("setpoint", nSetpointOxygen);
	pSignalInitSetpointOxygen->Trigger();

	if (pSignalInitTunerOxygen->WaitForHandling(nOxygenInitTimeout) && pSignalInitPWMOxygen->WaitForHandling(nOxygenInitTimeout) && pSignalInitPIDOxygen->WaitForHandling(nOxygenInitTimeout) && pSignalInitSetpointOxygen->WaitForHandling(nOxygenInitTimeout)) {
		bool bTunerReadyOxygen = pSignalInitTunerOxygen->GetBoolResult("success");
		bool bPWMReadyOxygen = pSignalInitPWMOxygen->GetBoolResult("success");
		bool bPIDReadyOxygen = pSignalInitPIDOxygen->GetBoolResult("success");
		bool bSetpointReadyOxygen = pSignalInitSetpointOxygen->GetBoolResult("success");

		bool bOxygenControllerIsReady = bTunerReadyOxygen && bPWMReadyOxygen && bPIDReadyOxygen && bSetpointReadyOxygen;

		pStateEnvironment->SetBoolParameter("processinitialization", "oxygencontroller_ready", bOxygenControllerIsReady);

		std::vector<std::string> readyControllersOxygen;
		std::vector<std::string> notReadyControllersOxygen;
		if (bTunerReadyOxygen)
			readyControllersOxygen.push_back("OxygenControllerTuner");
		else
			notReadyControllersOxygen.push_back("OxygenControllerTuner");
		if (bPWMReadyOxygen)
			readyControllersOxygen.push_back("OxygenControllerPWM");
		else
			notReadyControllersOxygen.push_back("OxygenControllerPWM");
		if (bPIDReadyOxygen)
			readyControllersOxygen.push_back("OxygenControllerPID");
		else
			notReadyControllersOxygen.push_back("OxygenControllerPID");
		if (bSetpointReadyOxygen)
			readyControllersOxygen.push_back("OxygenControllerSetpoint");
		else
			notReadyControllersOxygen.push_back("OxygenControllerSetpoint");

		if (readyControllersOxygen.size() > 0) {
			std::string sReadyControllersOxygenString;
			for (auto controllerString : readyControllersOxygen) {
				if (!sReadyControllersOxygenString.empty())
					sReadyControllersOxygenString += ", ";
				sReadyControllersOxygenString += controllerString;
			}
			pStateEnvironment->LogMessage("Initializing of " + sReadyControllersOxygenString + " successfull");
		}
		if (notReadyControllersOxygen.size() > 0) {
			std::string sNotReadyControllersOxygenString;
			for (auto controllerString : notReadyControllersOxygen) {
				if (!sNotReadyControllersOxygenString.empty())
					sNotReadyControllersOxygenString += ", ";
				sNotReadyControllersOxygenString += controllerString;
			}
			pStateEnvironment->LogMessage("Initializing of " + sNotReadyControllersOxygenString + " failed");
		}
	}
	else {
		// No response from PLC!
		pStateEnvironment->LogMessage("No response from PLC");
		pStateEnvironment->SetBoolParameter("processinitialization", "oxygencontroller_ready", false);
		pStateEnvironment->SetStringParameter("processinitialization", "initerror", "COULDNOTINITIALIZEOXYGENCONTROLLER");
		pStateEnvironment->SetNextState("initerror");
		return;
	}

	// initialize vacuum controller
	pStateEnvironment->LogMessage("Initializing vacuum controller..");
	// retrieve pressure threshold from the parameter group
	auto npressure_threshold_vacuum_off_in_mbar = pStateEnvironment->GetIntegerParameter("jobinfo", "pressure_threshold_vacuum_off_in_mbar");

	auto pSignalInitVacuumControl = pStateEnvironment->PrepareSignal("plc", "signal_vacuumcontrol_init");
	pSignalInitVacuumControl->SetInteger("pressure_threshold_vacuum_off_in_mbar", npressure_threshold_vacuum_off_in_mbar);
	pSignalInitVacuumControl->Trigger();

	if (pSignalInitVacuumControl->WaitForHandling(nVacuumInitTimeout)) {
		bool bVacuumControllerIsReady = pSignalInitVacuumControl->GetBoolResult("success");

		pStateEnvironment->SetBoolParameter("processinitialization", "vacuumcontroller_ready", bVacuumControllerIsReady);
		if (bVacuumControllerIsReady)
			pStateEnvironment->LogMessage("Vacuum controller initialized");
		else
			pStateEnvironment->LogMessage("Could not initialize vacuum controller");
	}
	else {
		// No response from PLC!
		pStateEnvironment->LogMessage("No response from PLC");
		pStateEnvironment->SetBoolParameter("processinitialization", "vacuumcontroller_ready", false);
		pStateEnvironment->SetStringParameter("processinitialization", "initerror", "COULDNOTINITIALIZEVACUUMCONTROLLER");
		pStateEnvironment->SetNextState("initerror");
		return;
	}
		
	// initialize atmosphere controller
	// retrieve pressure threshold from the parameter group
	auto no2_threshold_circulation_on_in_ppm = pStateEnvironment->GetIntegerParameter("hardwareinformation", "o2_threshold_circulation_on_in_ppm");
	auto no2_threshold_circulation_off_in_ppm = pStateEnvironment->GetIntegerParameter("hardwareinformation", "o2_threshold_circulation_off_in_ppm");

	auto pSignalInitAtmosphereControl = pStateEnvironment->PrepareSignal("plc", "signal_atmospherecontrol_init");
	pSignalInitAtmosphereControl->SetInteger("o2_threshold_circulation_on_in_ppm", no2_threshold_circulation_on_in_ppm);
	pSignalInitAtmosphereControl->SetInteger("o2_threshold_circulation_off_in_ppm", no2_threshold_circulation_off_in_ppm);
	pSignalInitAtmosphereControl->Trigger();

	if (pSignalInitAtmosphereControl->WaitForHandling(nAtmosphereInitTimeout)) {
		bool bAtmosphereControllerIsReady = pSignalInitAtmosphereControl->GetBoolResult("success");

		pStateEnvironment->SetBoolParameter("processinitialization", "atmospherecontroller_ready", bAtmosphereControllerIsReady);
		if (bAtmosphereControllerIsReady)
			pStateEnvironment->LogMessage("Atmosphere controller initialized");
		else
			pStateEnvironment->LogMessage("Could not initialize atmosphere controller");
	}
	else {
		// No response from PLC!
		pStateEnvironment->LogMessage("No response from PLC");
		pStateEnvironment->SetBoolParameter("processinitialization", "atmospherecontroller_ready", false);
		pStateEnvironment->SetStringParameter("processinitialization", "initerror", "COULDNOTINITIALIZEATMOSPHERECONTROLLER");
		pStateEnvironment->SetNextState("initerror");
		return;
	}
	// initialize stepper motors
	auto pSignalInitAxes= pStateEnvironment->PrepareSignal("plc", "signal_initaxes");
	pSignalInitAxes->Trigger();

	if (pSignalInitAxes->WaitForHandling(nAxesInitTimeout)) 
	{
		pStateEnvironment->LogMessage("Initializing of all axes successfull");

		//Get the target position, the velocity and the acceleration of the build platform
		double dTargetPlatformInMM = pStateEnvironment->GetDoubleParameter("jobinfo", "platformaxis_initial_absolute_position");
		double dSpeedPlatformInMMPerSecond = pStateEnvironment->GetDoubleParameter("jobinfo", "platformaxis_speed");
		double dAccelerationPlatformInMMPerSecondSquared = pStateEnvironment->GetDoubleParameter("jobinfo", "platformaxis_acceleration");
		//Prepare the signal to move the build platform into the working plane
		auto pMovementPlatformSignal = pStateEnvironment->PrepareSignal("plc", "signal_singleaxismovement");
		pMovementPlatformSignal->SetInteger("axis_ID", AXISID_BUILDPLATFORM); //axis_ID build platform
		pMovementPlatformSignal->SetInteger("absoluterelative", ABSOLUTE_FLAG); //absolute movement
		pMovementPlatformSignal->SetDouble("target", dTargetPlatformInMM);
		pMovementPlatformSignal->SetDouble("speed", dSpeedPlatformInMMPerSecond);
		pMovementPlatformSignal->SetDouble("acceleration", dAccelerationPlatformInMMPerSecondSquared);
		//Send the build platform movement signal to the plc state machine
		pMovementPlatformSignal->Trigger();
		pStateEnvironment->LogMessage("Wait for initial platform movement ...");
		if (pMovementPlatformSignal->WaitForHandling(nInitialPlatformMovementTimeOut))
		{
			if (pMovementPlatformSignal->GetBoolResult("success"))
			{
				pStateEnvironment->LogMessage("Initial platform movement finished");
			}
			else
			{
				pStateEnvironment->LogMessage("Initial platform movement was not successful");
				pStateEnvironment->SetStringParameter("processinitialization", "initerror", "COULDNOTINITIALLYMOVEBUILDPLATFORM");
				pStateEnvironment->SetNextState("initerror");
				
				// leave the current waitformovement state to avoid a dead end in the plc state machine 
				auto pLeaveStateForIdleSignal = pStateEnvironment->PrepareSignal("plc", "signal_leavestateforidle");
				pLeaveStateForIdleSignal->Trigger();
				return;
			}
		}
		else
		{
			// no response from PLC!
			pStateEnvironment->LogMessage("Initial platform movement timeout");
			pStateEnvironment->SetStringParameter("processinitialization", "initerror", "COULDNOTINITIALLYMOVEBUILDPLATFORMDUETOTIMEOUT");
			pStateEnvironment->SetNextState("initerror");
			return;

			// leave the current waitformovement state to avoid a dead end in the plc state machine 
			auto pLeaveStateForIdleSignal = pStateEnvironment->PrepareSignal("plc", "signal_leavestateforidle");
			pLeaveStateForIdleSignal->Trigger();
		}
	}
	else {

		bool bIsInitPlatformAxis = pSignalInitAxes->GetBoolResult("platformaxis_initialized");
		bool bIsInitReservoirAxis = pSignalInitAxes->GetBoolResult("powderreservoiraxis_initialized");
		bool bIsInitRecoaterAxisPowder = pSignalInitAxes->GetBoolResult("recoateraxis_powder_initialized");
		bool bIsInitRecoaterAxisLinear = pSignalInitAxes->GetBoolResult("recoateraxis_linear_initialized");

		pStateEnvironment->SetBoolParameter("processinitialization", "recoateraxis_linear_ready", bIsInitRecoaterAxisLinear);
		pStateEnvironment->SetBoolParameter("processinitialization", "recoateraxis_powder_ready", bIsInitRecoaterAxisPowder);
		pStateEnvironment->SetBoolParameter("processinitialization", "powderreservoiraxis_ready", bIsInitReservoirAxis);
		pStateEnvironment->SetBoolParameter("processinitialization", "platformaxis_ready", bIsInitPlatformAxis);


		std::vector<std::string> readyAxes;
		std::vector<std::string> notReadyAxes;
		if (bIsInitPlatformAxis)
			readyAxes.push_back("Platform");
		else
			notReadyAxes.push_back("Platform");
		if (bIsInitReservoirAxis)
			readyAxes.push_back("PowderReservoir");
		else
			notReadyAxes.push_back("PowderReservoir");
		if (bIsInitRecoaterAxisPowder)
			readyAxes.push_back("PowderRecoaterAxis");
		else
			notReadyAxes.push_back("PowderRecoaterAxis");
		if (bIsInitRecoaterAxisLinear)
			readyAxes.push_back("LinearRecoaterAxis");
		else
			notReadyAxes.push_back("LinearRecoaterAxis");

		if (readyAxes.size() > 0) {
			std::string sReadyAxesString;
			for (auto axisString : readyAxes) {
				if (!sReadyAxesString.empty())
					sReadyAxesString += ", ";
				sReadyAxesString += axisString;
			}
			pStateEnvironment->LogMessage("Initializing of " + sReadyAxesString + " successfull");
		}
		if (notReadyAxes.size() > 0) {
			std::string sNotReadyAxesString;
			for (auto axisString : notReadyAxes) {
				if (!sNotReadyAxesString.empty())
					sNotReadyAxesString += ", ";
				sNotReadyAxesString += axisString;
			}
			pStateEnvironment->LogMessage("Initializing of " + sNotReadyAxesString + " failed");
		}

		// Send signal to the plc state machine to leave the waitforreferencing state
		auto pLeaveWaitforreferencingSignal = pStateEnvironment->PrepareSignal("plc", "signal_leavewaitforreferencing");
		pLeaveWaitforreferencingSignal->Trigger();
		if (pLeaveWaitforreferencingSignal->WaitForHandling(nGeneralCommandTimeout))
		{
			pStateEnvironment->LogMessage("The state waitforreferencing in the plc state machine was left for the state idle");
		}
		else
		{
			// no response from PLC!
			pStateEnvironment->LogMessage("Leave waitforreferencing in the plc state machine timeout");
			pStateEnvironment->SetStringParameter("processinitialization", "initerror", "COULDNOTLEAVEWAITFORREFERENCINGDUETOTIMEOUT");
			pStateEnvironment->SetNextState("initerror");
			return;
		}
	}

	pStateEnvironment->SetNextState("idle");
}


__DECLARESTATE(idle) 
{

	PSignalHandler pSignalHandler;
	if (pStateEnvironment->WaitForSignal("signal_startbuild", 0, pSignalHandler)) {

		std::string sJobUUID = pSignalHandler->GetString("jobuuid");
		pStateEnvironment->LogMessage("Starting job " + sJobUUID);
		pSignalHandler->SignalHandled();

		pStateEnvironment->SetUUIDParameter("jobinfo", "jobuuid", sJobUUID);

		pStateEnvironment->SetBoolParameter("ui", "build_canbecanceled", true);
		pStateEnvironment->SetBoolParameter("ui", "build_canbepausedorresumed", true);

		pStateEnvironment->SetNextState("startprocess");

	}
	else if (pStateEnvironment->WaitForSignal("signal_manualmovementcontrol_enter", 0, pSignalHandler)) {

		pSignalHandler->SignalHandled();

		pStateEnvironment->SetNextState("manualmovementcontrol");

	}

	else if (pStateEnvironment->WaitForSignal("signal_manualatmospherecontrol_enter", 0, pSignalHandler)) {

		pSignalHandler->SignalHandled();

		pStateEnvironment->SetNextState("manualatmospherecontrol");

	}

	else if (pStateEnvironment->WaitForSignal("signal_manualheatercontrol_enter", 0, pSignalHandler)) {

		pSignalHandler->SignalHandled();

		pStateEnvironment->SetNextState("manualheatercontrol");

	}

	else if (pStateEnvironment->WaitForSignal("signal_manualcameracontrol_enter", 0, pSignalHandler)) {

		pSignalHandler->SignalHandled();

		pStateEnvironment->SetNextState("manualcameracontrol");

	}

	else if (pStateEnvironment->WaitForSignal("signal_changelayer", 0, pSignalHandler)) {
		auto nLayer = pSignalHandler->GetInteger("layer");
		pStateEnvironment->SetIntegerParameter("jobinfo", "startlayer", nLayer);
		pStateEnvironment->LogMessage("Changed build job start layer " + std::to_string(nLayer));
		pSignalHandler->SignalHandled();
		pStateEnvironment->SetNextState("idle");

	}
	else {

		pStateEnvironment->SetNextState("idle");

	}

}

__DECLARESTATE(startprocess)
{
	PSignalHandler pSignalHandler;

	// check if CancelBuild button or PauseBuild button was clicked
	if (pStateEnvironment->WaitForSignal("signal_cancelbuild", 0, pSignalHandler)) {
		pStateEnvironment->SetBoolParameter("ui", "build_canbecanceled", false);
		pStateEnvironment->SetBoolParameter("ui", "build_canbepausedorresumed", false);
		pStateEnvironment->SetNextState("cancelprocess");
		pSignalHandler->SignalHandled();
		return;
	}
	if (pStateEnvironment->WaitForSignal("signal_pausebuild", 0, pSignalHandler)) {
		pStateEnvironment->SetBoolParameter("ui", "build_canbecanceled", false);
		pStateEnvironment->SetBoolParameter("ui", "build_canbepausedorresumed", false);
		pStateEnvironment->SetNextState("pauseprocess");
		pSignalHandler->SignalHandled();
		pStateEnvironment->LogMessage("Press the 'Pause Build' Button to resume the process at beginlayer or press the 'Cancel Build' Button to cancel the process!");
		return;
	}

	// Reset error state
	pStateEnvironment->SetStringParameter("processinitialization", "initerror", "NOERROR");

	// Reset all process variables to default values
	pStateEnvironment->SetBoolParameter("processinitialization", "emergencycircuitclosed", false);
	pStateEnvironment->SetBoolParameter("processinitialization", "sufficientpowderisavailable", false);
	pStateEnvironment->SetBoolParameter("processinitialization", "recoateraxis_linear_ready", false);
	pStateEnvironment->SetBoolParameter("processinitialization", "recoateraxis_powder_ready", false);
	pStateEnvironment->SetBoolParameter("processinitialization", "powderreservoiraxis_ready", false);
	pStateEnvironment->SetBoolParameter("processinitialization", "platformaxis_ready", false);

	// Reset current job information
	pStateEnvironment->SetIntegerParameter("jobinfo", "layercount", 0);
	pStateEnvironment->SetIntegerParameter("jobinfo", "currentlayer", 0);

	// Get UUID Information
	std::string sJobUUID = pStateEnvironment->GetUUIDParameter("jobinfo", "jobuuid");
	pStateEnvironment->LogMessage("Loading job " + sJobUUID);

	auto pBuildJob = pStateEnvironment->GetBuildJob(sJobUUID);	

	auto layerCount = pBuildJob->GetLayerCount();
	pStateEnvironment->LogMessage("Job has " + std::to_string(layerCount) + " layers...");


	// TODO: Check if all metadata parameters are present!

	// Get Timeouts
	uint32_t nEmergencyCircuitTimeout = pStateEnvironment->GetIntegerParameter("timeouts", "emergencycircuittimeout");
	uint32_t nPowderAvailabilityTimeout = pStateEnvironment->GetIntegerParameter("timeouts", "powderavailabilitytimeout");
	uint32_t nMotorEnabledCheckTimeout = pStateEnvironment->GetIntegerParameter("timeouts", "motorenabledchecktimeout");
	uint32_t nLockDoorTimeout = pStateEnvironment->GetIntegerParameter("timeouts", "lockdoortimeout");
	uint32_t nControllerSetpointUpdateTimeout = pStateEnvironment->GetIntegerParameter("timeouts", "controllersetpointupdatetimeout");
	uint32_t nInitializeFlirTimeout = pStateEnvironment->GetIntegerParameter("timeouts", "flirinitializationtimeout");

	// Check if Emergency Circuit is closed
	pStateEnvironment->LogMessage("Checking if emergency circuit is closed..");
	auto pEmergencyCircuitSignal = pStateEnvironment->PrepareSignal("plc", "signal_checkemergencycircuit");
	pEmergencyCircuitSignal->Trigger();

	if (pEmergencyCircuitSignal->WaitForHandling (nEmergencyCircuitTimeout)) {
		bool bEmergencyCircuitIsClosed = pEmergencyCircuitSignal->GetBoolResult("circuitisclosed");		
		pStateEnvironment->SetBoolParameter("processinitialization", "emergencycircuitclosed", bEmergencyCircuitIsClosed);
		if (!bEmergencyCircuitIsClosed) {
			// Invalid response from PLC!
			pStateEnvironment->SetStringParameter("processinitialization", "initerror", "ERGENCYCIRCUITNOTCLOSED");
			pStateEnvironment->SetNextState("initerror");
			return;
		}
	}
	else {
		// No response from PLC!
		pStateEnvironment->SetStringParameter("processinitialization", "initerror", "COULDNOTREADEMERGENCYCIRCUITSTATE");
		pStateEnvironment->SetNextState("initerror");
		return;
	}

	// Send signal to PLC to lock the process chamber door
	pStateEnvironment->LogMessage("Locking process chamber door..");
	auto pLockDoorSignal = pStateEnvironment->PrepareSignal("plc", "signal_lockdoor");
	pLockDoorSignal->SetBool("lockdoor", true);
	pLockDoorSignal->Trigger();

	if (pLockDoorSignal->WaitForHandling(nLockDoorTimeout)) {
		bool bDoorIsLocked = pLockDoorSignal->GetBoolResult("doorlockstate");
		pStateEnvironment->SetBoolParameter("processinitialization", "chamberdoorislocked", bDoorIsLocked);
		if (!bDoorIsLocked) {
			// Invalid response from PLC!
			pStateEnvironment->SetStringParameter("processinitialization", "initerror", "DOORNOTLOCKED");
			pStateEnvironment->SetNextState("initerror");
			return;
		}
	}
	else {
		// No response from PLC!
		pStateEnvironment->SetStringParameter("processinitialization", "initerror", "COULDNOTLOCKDOOR");
		pStateEnvironment->SetNextState("initerror");
		return;
	}

	
	// Check if enough powder is available
	pStateEnvironment->LogMessage("Checking if enough powder is available..");
	auto pPowderAvailabilitySignal = pStateEnvironment->PrepareSignal("plc", "signal_checkpowderavailability");
	pPowderAvailabilitySignal->Trigger();

	if (pPowderAvailabilitySignal->WaitForHandling(nPowderAvailabilityTimeout)) {
		double dPowderAvailability = pPowderAvailabilitySignal->GetDoubleResult("filllevel");
		if ((dPowderAvailability < 0.0) || (dPowderAvailability > 1.0)) {
			// Invalid response from PLC!
			pStateEnvironment->SetStringParameter("processinitialization", "initerror", "POWDERAVAILABILITYSENSORFAILED");
			pStateEnvironment->SetNextState("initerror");
			return;
		}

		// Calculate needed powder reservoir
		double dPlatformAreaInMMSquared = pStateEnvironment->GetDoubleParameter ("hardwareinformation", "platformarea");
		double dMaxPowderReservoirAreaInMMSquared = pStateEnvironment->GetDoubleParameter("hardwareinformation", "powderreservoirarea");
		double dMaxPowderReservoirHeightInMM = pStateEnvironment->GetDoubleParameter("hardwareinformation", "powderreservoirheight");
		double dMaxPowderReservoirVolumeInMMCubed = dMaxPowderReservoirAreaInMMSquared * dMaxPowderReservoirHeightInMM;
		pStateEnvironment->SetDoubleParameter("jobinfo", "currentreservoirpowdercapacity", dMaxPowderReservoirVolumeInMMCubed);

		// Overdosing factor is a job parameter. MUST be larger than 1.0
		double dOverdosingFactor = pStateEnvironment->GetDoubleParameter ("jobinfo", "overdosefactor");

		if ((dPlatformAreaInMMSquared < MIN_PLATFORMAREAINMMSQUARED) || (dPlatformAreaInMMSquared > MAX_PLATFORMAREAINMMSQUARED))
			throw std::runtime_error("invalid platform area!");

		if ((dMaxPowderReservoirVolumeInMMCubed < MIN_POWDERRESERVOIRVOLUMEINMMCUBE) || (dMaxPowderReservoirVolumeInMMCubed > MAX_POWDERRESERVOIRVOLUMEINMMCUBE))
			throw std::runtime_error("invalid reservoir volume!");

		if ((dOverdosingFactor < MIN_POWDERRESERVOIROVERDOSEFACTOR) || (dOverdosingFactor > MAX_POWDERRESERVOIROVERDOSEFACTOR))
			throw std::runtime_error("invalid overdose factor!");

		pStateEnvironment->SetIntegerParameter("jobinfo", "layercount", layerCount);
		pStateEnvironment->SetIntegerParameter("jobinfo", "currentlayer", 0);

		double dBuildHeightInMM = pBuildJob->GetBuildHeightInMM();
		double dNeededPowderVolumeInMMCubed = dBuildHeightInMM * dPlatformAreaInMMSquared;
		double dPowderMinimumPowderAvailability = dNeededPowderVolumeInMMCubed * dOverdosingFactor / dMaxPowderReservoirVolumeInMMCubed;

		bool bSufficientPowderIsAvailable = (dPowderAvailability > dPowderMinimumPowderAvailability);
		pStateEnvironment->SetBoolParameter("processinitialization", "sufficientpowderisavailable", bSufficientPowderIsAvailable);


	}
	else {
		// No response from PLC!
		pStateEnvironment->SetBoolParameter("processinitialization", "sufficientpowderisavailable", false);
		pStateEnvironment->SetStringParameter("processinitialization", "initerror", "COULDNOTREADPOWDERAVAILABILITYSTATE");
		pStateEnvironment->SetNextState("initerror");
		return;
	}
	

	// Check if axes are enabled and homed
	pStateEnvironment->LogMessage("Check if axes are enabled and homed...");
	auto pAxisStateCheckSignal = pStateEnvironment->PrepareSignal("plc", "signal_checkaxisstate");
	pAxisStateCheckSignal->Trigger();

	if (pAxisStateCheckSignal->WaitForHandling(nMotorEnabledCheckTimeout)) {
		bool bRecoaterAxisLinearReady = pAxisStateCheckSignal->GetBoolResult ("recoateraxis_linear_ready");
		bool bRecoaterAxisPowderReady = pAxisStateCheckSignal->GetBoolResult ("recoateraxis_powder_ready");
		bool bPowderReservoirAxisReady = pAxisStateCheckSignal->GetBoolResult ("powderreservoiraxis_ready");
		bool bPlatformAxisReady = pAxisStateCheckSignal->GetBoolResult ("platformaxis_ready");

		pStateEnvironment->SetBoolParameter("processinitialization", "recoateraxis_linear_ready", bRecoaterAxisLinearReady);
		pStateEnvironment->SetBoolParameter("processinitialization", "recoateraxis_powder_ready", bRecoaterAxisPowderReady);
		pStateEnvironment->SetBoolParameter("processinitialization", "powderreservoiraxis_ready", bPowderReservoirAxisReady);
		pStateEnvironment->SetBoolParameter("processinitialization", "platformaxis_ready", bPlatformAxisReady);

		if (!bRecoaterAxisLinearReady || !bRecoaterAxisPowderReady || !bPowderReservoirAxisReady || !bPlatformAxisReady) {
			// Invalid response from PLC!
			pStateEnvironment->SetStringParameter("processinitialization", "initerror", "AXISNOTREADY");
			pStateEnvironment->SetNextState("initerror");
			return;
		}
	}
	else {
		// No response from PLC!
		pStateEnvironment->SetStringParameter("processinitialization", "initerror", "COULDNOTCHECKAXESSTATUS");
		pStateEnvironment->SetNextState("initerror");
		return;
	}


	// Update the controller setpoints of the oxygen and the heater control

	pStateEnvironment->LogMessage("Update the heater control temperature setpoint ...");
	// Get the heater control temperature setpoint from the jobinfo parameter group
	int nSetpointHeater = pStateEnvironment->GetIntegerParameter("jobinfo" ,"heatercontroller_temperature_setpoint_in_degree_celsius");
	// Set the heater control temperature setpoint in the heatercontoller parameter group 
	pStateEnvironment->SetIntegerParameter("heatercontroller", "setpoint", nSetpointHeater);
	// send signal to plc state machine to update the heater control temperature setpoint
	auto pSignalUpdateSetpointHeater = pStateEnvironment->PrepareSignal("plc", "signal_updatecontrollersetpoint");
	pSignalUpdateSetpointHeater->SetBool("isinit", CONTROLLER_UPDATE);
	pSignalUpdateSetpointHeater->SetInteger("controller_ID", CONTROLLER_ID_HEATER);
	pSignalUpdateSetpointHeater->SetInteger("setpoint", nSetpointHeater);
	pSignalUpdateSetpointHeater->Trigger();
	if (pSignalUpdateSetpointHeater->WaitForHandling(nControllerSetpointUpdateTimeout))
	{
		if (pSignalUpdateSetpointHeater->GetBoolResult("success"))
		{
			pStateEnvironment->LogMessage("Update of the heater control temperature setpoint successful");
		}
		else
		{
			pStateEnvironment->SetStringParameter("processinitialization", "initerror", "COULDNOTUPDATEHEATERCONTROLSETPOINT");
			pStateEnvironment->LogMessage("Update of the heater control temperature setpoint was not successful");
			pStateEnvironment->SetNextState("initerror");
			return;
		}
	}
	else
	{
		// No response from PLC!
		pStateEnvironment->SetStringParameter("processinitialization", "initerror", "COULDNOTUPDATEHEATERCONTROLSETPOINTDUETOTIMEOUT");
		pStateEnvironment->LogMessage("Update of the heater control temperature setpoint timeout");
		pStateEnvironment->SetNextState("initerror");
		return;
	}

	pStateEnvironment->LogMessage("Update the shielding gas control oxygen content setpoint ...");
	// Get the shielding gas control oxygen content setpoint from the jobinfo
	int nSetpointOxygen = pStateEnvironment->GetIntegerParameter("jobinfo", "oxygencontroller_oxygen_setpoint_in_ppm");
	// Set the shielding gas control oxygen content setpoint in the oxygencontoller parameter group 
	pStateEnvironment->SetIntegerParameter("oxygencontroller", "setpoint", nSetpointOxygen);
	// send signal to plc state machine to update the shielding gas control oxygen content setpoint
	auto pSignalUpdateSetpointOxygen = pStateEnvironment->PrepareSignal("plc", "signal_updatecontrollersetpoint");
	pSignalUpdateSetpointOxygen->SetBool("isinit", CONTROLLER_UPDATE);
	pSignalUpdateSetpointOxygen->SetInteger("controller_ID", CONTROLLER_ID_SHIELDINGGAS);
	pSignalUpdateSetpointOxygen->SetInteger("setpoint", nSetpointOxygen);
	pSignalUpdateSetpointOxygen->Trigger();
	if (pSignalUpdateSetpointOxygen->WaitForHandling(nControllerSetpointUpdateTimeout))
	{
		if (pSignalUpdateSetpointOxygen->GetBoolResult("success"))
		{
			pStateEnvironment->LogMessage("Update of the shielding gas control oxygen content setpoint successful");
		}
		else
		{
			pStateEnvironment->SetStringParameter("processinitialization", "initerror", "COULDNOTUPDATEOXYGENCONTROLSETPOINT");
			pStateEnvironment->LogMessage("Update of the shielding gas control oxygen content setpoint was not successful");
			pStateEnvironment->SetNextState("initerror");
			return;
		}
	}
	else
	{
		// No response from PLC!
		pStateEnvironment->SetStringParameter("processinitialization", "initerror", "COULDNOTUPDATEOXYGENCONTROLSETPOINTDUETOTIMEOUT");
		pStateEnvironment->LogMessage("Update of the shielding gas control oxygen content setpoint timeout");
		pStateEnvironment->SetNextState("initerror");
		return;
	}

	// Check if the thermal camera should be used from the jobinfo
	bool bThermalCameraIsActive = pStateEnvironment->GetBoolParameter("jobinfo", "thermal_camera_active_flag");
	if (bThermalCameraIsActive)
	{
		pStateEnvironment->LogMessage("Initializing the FLIR camera ...");
		// Get the timeouts and waiting time from the jobinfo
		int nWaitingTime = pStateEnvironment->GetIntegerParameter("jobinfo", "thermal_camera_waiting_time_interval_in_ms");
		int nArmingTime = pStateEnvironment->GetIntegerParameter("jobinfo", "thermal_camera_arming_time_in_ms");
		int nRecordingTime = pStateEnvironment->GetIntegerParameter("jobinfo", "thermal_camera_recording_time_in_ms");
		int nSavingTime = pStateEnvironment->GetIntegerParameter("jobinfo", "thermal_camera_saving_time_in_ms");
		std::string sFilename = pStateEnvironment->GetStringParameter("jobinfo", "thermal_camera_footage_filename");
		int nFilterChangeTime = pStateEnvironment->GetIntegerParameter("jobinfo", "thermal_camera_filter_change_time_in_ms");
		int nWidth = pStateEnvironment->GetIntegerParameter("jobinfo", "thermal_camera_width_in_pixel");
		int nHeight = pStateEnvironment->GetIntegerParameter("jobinfo", "thermal_camera_height_in_pixel");
		int nOffsetX = pStateEnvironment->GetIntegerParameter("jobinfo", "thermal_camera_offset_x_in_pixel");
		int nOffsetY = pStateEnvironment->GetIntegerParameter("jobinfo", "thermal_camera_offset_y_in_pixel");
		int nNumberOfFrames = pStateEnvironment->GetIntegerParameter("jobinfo", "thermal_camera_frames");
		int nNumberOfPretriggerFrames = pStateEnvironment->GetIntegerParameter("jobinfo", "thermal_camera_pretrigger_frames");
		std::string sCorrectionName = pStateEnvironment->GetStringParameter("jobinfo", "thermal_camera_correction_name");
		std::string sCalibrationTag = pStateEnvironment->GetStringParameter("jobinfo", "thermal_camera_calibration_tag");
		int nIntermediateFilterIndex = pStateEnvironment->GetIntegerParameter("jobinfo", "thermal_camera_intermediate_filter_index");
		int nDesiredFilterIndex = pStateEnvironment->GetIntegerParameter("jobinfo", "thermal_camera_desired_filter_index");

		// send signal to scanner state machine to initialize the FLIR camera
		auto pSignalInitializeFlir = pStateEnvironment->PrepareSignal("scanner", "signal_init_flir");
		pSignalInitializeFlir->SetInteger("waiting_time_interval_in_ms", nWaitingTime);
		pSignalInitializeFlir->SetInteger("arming_time_in_ms", nArmingTime);
		pSignalInitializeFlir->SetInteger("recording_time_in_ms", nRecordingTime);
		pSignalInitializeFlir->SetInteger("saving_time_in_ms", nSavingTime);
		pSignalInitializeFlir->SetString("footage_filename", sFilename);
		pSignalInitializeFlir->SetInteger("filter_change_time_in_ms", nFilterChangeTime);
		pSignalInitializeFlir->SetInteger("width_in_pixel", nWidth);
		pSignalInitializeFlir->SetInteger("height_in_pixel", nHeight);
		pSignalInitializeFlir->SetInteger("offset_x_in_pixel", nOffsetX);
		pSignalInitializeFlir->SetInteger("offset_y_in_pixel", nOffsetY);
		pSignalInitializeFlir->SetInteger("frames", nNumberOfFrames);
		pSignalInitializeFlir->SetInteger("pretrigger_frames", nNumberOfPretriggerFrames);
		pSignalInitializeFlir->SetString("correction_name", sCorrectionName);
		pSignalInitializeFlir->SetString("calibration_tag", sCalibrationTag);
		pSignalInitializeFlir->SetInteger("intermediate_filter_index", nIntermediateFilterIndex);
		pSignalInitializeFlir->SetInteger("desired_filter_index", nDesiredFilterIndex);
		pSignalInitializeFlir->Trigger();
		if (pSignalInitializeFlir->WaitForHandling(nInitializeFlirTimeout))
		{
			if (pSignalInitializeFlir->GetBoolResult("success"))
			{
				pStateEnvironment->LogMessage("Initializing the FLIR camera was successfull");
			}
			else
			{
				pStateEnvironment->SetStringParameter("processinitialization", "initerror", "COULDNOTINITIALIZEFLIR");
				pStateEnvironment->LogMessage("Initializing the FLIR camera was not successful");
				pStateEnvironment->SetNextState("initerror");
				return;
			}
		}
		else
		{
			// No response from PLC!
			pStateEnvironment->SetStringParameter("processinitialization", "initerror", "COULDNOTINITIALIZEFLIRDUETOTIMEOUT");
			pStateEnvironment->LogMessage("Initialize the FLIR camera timeout");
			pStateEnvironment->SetNextState("initerror");
			return;
		}
	}

	pStateEnvironment->SetNextState("processpreparation");
}

__DECLARESTATE(processpreparation)
{
	PSignalHandler pSignalHandler;

	// check if CancelBuild button or PauseBuild button was clicked
	if (pStateEnvironment->WaitForSignal("signal_cancelbuild", 0, pSignalHandler)) {
		pStateEnvironment->SetBoolParameter("ui", "build_canbecanceled", false);
		pStateEnvironment->SetBoolParameter("ui", "build_canbepausedorresumed", false);
		pStateEnvironment->SetNextState("cancelprocess");
		pSignalHandler->SignalHandled();
		return;
	}
	if (pStateEnvironment->WaitForSignal("signal_pausebuild", 0, pSignalHandler)) {
		pStateEnvironment->SetBoolParameter("ui", "build_canbecanceled", false);
		pStateEnvironment->SetBoolParameter("ui", "build_canbepausedorresumed", false);
		pStateEnvironment->SetNextState("pauseprocess");
		pSignalHandler->SignalHandled();
		pStateEnvironment->LogMessage("Press the 'Pause Build' Button to resume the process at beginlayer or press the 'Cancel Build' Button to cancel the process!");
		return;
	}

	// Get Timeouts
	uint32_t nPowderDosingTimeOut = pStateEnvironment->GetIntegerParameter("timeouts", "powderdosingtimeout");
	uint32_t nInitialRecoaterMovementTimeOut = pStateEnvironment->GetIntegerParameter("timeouts", "initialrecoatermovementtimeout");

	pStateEnvironment->SetStringParameter("ui", "currentlayerdisplay", "initializing");
	pStateEnvironment->SetStringParameter("ui", "currentheightdisplay", "initializing");

	// initialize job information variables
	auto sJobUUID = pStateEnvironment->GetUUIDParameter("jobinfo", "jobuuid");
	auto pBuildJob = pStateEnvironment->GetBuildJob(sJobUUID);

	auto sJobName = pBuildJob->GetName();
	double dTotalHeight = pBuildJob->GetBuildHeightInMM();
	auto nLayerCount = pBuildJob->GetLayerCount();
	auto nStartLayer = pStateEnvironment->GetIntegerParameter("jobinfo", "startlayer");

	if (nStartLayer > nLayerCount) {
		pStateEnvironment->LogMessage("Invalid start layer! Start layer " + std::to_string(nStartLayer) + " > Max layer index = " + std::to_string(nLayerCount));
		pStateEnvironment->SetStringParameter("processinitialization", "initerror", "INVALIDSTARTLAYER");
		pStateEnvironment->SetNextState("initerror");
		return;
	}

	pStateEnvironment->LogMessage("Job Name: " + sJobName);
	pStateEnvironment->LogMessage("Layer Count: " + std::to_string(nLayerCount));

	pStateEnvironment->SetStringParameter("jobinfo", "jobname", sJobName);
	pStateEnvironment->SetIntegerParameter("jobinfo", "currentlayer", nStartLayer);
	pStateEnvironment->SetIntegerParameter("jobinfo", "layercount", nLayerCount);
	pStateEnvironment->SetDoubleParameter("jobinfo", "currentheight", 0.0);
	pStateEnvironment->SetDoubleParameter("jobinfo", "totalheight", dTotalHeight);
	pStateEnvironment->SetDoubleParameter("jobinfo", "currentthickness", 0.0);

	//Get the target position, the velocity and the acceleration of the recoater linear axis
	double dTargetRecoaterInMM = pStateEnvironment->GetDoubleParameter("hardwareinformation", "recoater_refill_position");
	double dSpeedRecoaterInMMPerSecond = pStateEnvironment->GetDoubleParameter("jobinfo", "recoater_linear_speed_travel");
	double dAccelerationRecoaterInMMPerSecondSquared = pStateEnvironment->GetDoubleParameter("jobinfo", "recoater_axes_linear_acceleration_travel");
	
	//Initial powder dosing 
	auto nInitialPowderDosingUnits = pStateEnvironment->GetIntegerParameter("jobinfo", "initpowderdosingunits");
	
	int nPowderreservoirNotchCount = pStateEnvironment->GetIntegerParameter("hardwareinformation", "powderreservoir_dosing_notch_count");
	double dSpeedInDegreesPerSecond = pStateEnvironment->GetDoubleParameter("jobinfo", "powderreservoir_speed");
	double dAccelerationInDegreesPerSecondSquared = pStateEnvironment->GetDoubleParameter("jobinfo", "powderreservoir_acceleration");
	double dTargetInDegrees = nInitialPowderDosingUnits * 360.0/(double)nPowderreservoirNotchCount;
	
	//Prepare the signal to move the recoater into the refilling position
	auto pMovementRecoaterSignal = pStateEnvironment->PrepareSignal("plc", "signal_singleaxismovement");
	pMovementRecoaterSignal->SetInteger("axis_ID", AXISID_RECOATELINEAR); //axis_ID linear recoater axis
	pMovementRecoaterSignal->SetInteger("absoluterelative", ABSOLUTE_FLAG); //absolute movement
	pMovementRecoaterSignal->SetDouble("target", dTargetRecoaterInMM);
	pMovementRecoaterSignal->SetDouble("speed", dSpeedRecoaterInMMPerSecond);
	pMovementRecoaterSignal->SetDouble("acceleration", dAccelerationRecoaterInMMPerSecondSquared);
	//Send the recoater movement to the plc state machine
	pMovementRecoaterSignal->Trigger();
	pStateEnvironment->LogMessage("Wait for recoater movement to the refilling position ...");
	if (pMovementRecoaterSignal->WaitForHandling(nInitialRecoaterMovementTimeOut))
	{
		if (pMovementRecoaterSignal->GetBoolResult("success"))
		{
			//Prepare the powder dosing signal
			auto pMovementReservoirSignal = pStateEnvironment->PrepareSignal("plc", "signal_singleaxismovement");
			pMovementReservoirSignal->SetInteger("axis_ID", AXISID_POWDERRESERVOIR); //axis_ID powder reservoir
			pMovementReservoirSignal->SetInteger("absoluterelative", RELATIVE_FLAG); //relative movement
			pMovementReservoirSignal->SetDouble("target", dTargetInDegrees);
			pMovementReservoirSignal->SetDouble("speed", dSpeedInDegreesPerSecond);
			pMovementReservoirSignal->SetDouble("acceleration", dAccelerationInDegreesPerSecondSquared);
			//Send the powder dosing signal to the plc state machine
			pMovementReservoirSignal->Trigger();
			pStateEnvironment->LogMessage("Filling recoater with " + std::to_string(nInitialPowderDosingUnits) + " dosing units powder");
			pStateEnvironment->LogMessage("Wait for powder dosing ...");
			if (pMovementReservoirSignal->WaitForHandling(nInitialRecoaterMovementTimeOut))
			{
				if (pMovementReservoirSignal->GetBoolResult("success"))
				{
					double dPowderVolumePerNotchInCubicMM = pStateEnvironment->GetDoubleParameter("hardwareinformation", "powderreservoir_notch_volume_in_cubic_mm");
					double dOldReservoirPowderVolumeInMMCubed = pStateEnvironment->GetDoubleParameter("jobinfo", "currentreservoirpowdercapacity");
					double dRecoaterFillingVolumeInMMCubed = dPowderVolumePerNotchInCubicMM * nInitialPowderDosingUnits;
					pStateEnvironment->SetDoubleParameter("jobinfo", "currentrecoaterpowdercapacity", dRecoaterFillingVolumeInMMCubed);
					pStateEnvironment->SetDoubleParameter("jobinfo", "currentreservoirpowdercapacity", (dOldReservoirPowderVolumeInMMCubed - dRecoaterFillingVolumeInMMCubed));

					pStateEnvironment->LogMessage("Powder dosing finished");
					pStateEnvironment->LogMessage("Current recoater powder capacity: " + std::to_string(dRecoaterFillingVolumeInMMCubed) + " cubic mm");
					pStateEnvironment->LogMessage("Current reservoir powder capacity: " + std::to_string((dOldReservoirPowderVolumeInMMCubed - dRecoaterFillingVolumeInMMCubed)) + " cubic mm");

					// Set next state if the linear recoater axis and the reservoir axis were moved successfully
					pStateEnvironment->SetNextState("waitforheater");
				}
				else
				{
					pStateEnvironment->LogMessage("Powder dosing was not successful");
					pStateEnvironment->SetStringParameter("processinitialization", "initerror", "COULDNOTINITIALLYDOSEPOWDER");
					pStateEnvironment->SetNextState("initerror");

					// leave the current waitformovement state to avoid a dead end in the plc state machine 
					auto pLeaveStateForIdleSignal = pStateEnvironment->PrepareSignal("plc", "signal_leavestateforidle");
					pLeaveStateForIdleSignal->Trigger();
				}
			}
			else 
			{
				// no response from PLC!
				pStateEnvironment->LogMessage("Powder dosing timeout");
				pStateEnvironment->SetStringParameter("processinitialization", "initerror", "COULDNOTINITIALLYDOSEPOWDERDUETOTIMEOUT");
				pStateEnvironment->SetNextState("initerror");

				// leave the current waitformovement state to avoid a dead end in the plc state machine 
				auto pLeaveStateForIdleSignal = pStateEnvironment->PrepareSignal("plc", "signal_leavestateforidle");
				pLeaveStateForIdleSignal->Trigger();
			}
		}
		else
		{
			pStateEnvironment->LogMessage("Initial recoater movement was not successful");
			pStateEnvironment->SetStringParameter("processinitialization", "initerror", "COULDNOTINITIALLYMOVERECOATER");
			pStateEnvironment->SetNextState("initerror");

			// leave the current waitformovement state to avoid a dead end in the plc state machine 
			auto pLeaveStateForIdleSignal = pStateEnvironment->PrepareSignal("plc", "signal_leavestateforidle");
			pLeaveStateForIdleSignal->Trigger();
		}
	}
	else
	{
		// no response from PLC!
		pStateEnvironment->LogMessage("Initial recoater movement timeout");
		pStateEnvironment->SetStringParameter("processinitialization", "initerror", "COULDNOTINITIALLYMOVERECOATERDUETOTIMEOUT");
		pStateEnvironment->SetNextState("initerror");

		// leave the current waitformovement state to avoid a dead end in the plc state machine 
		auto pLeaveStateForIdleSignal = pStateEnvironment->PrepareSignal("plc", "signal_leavestateforidle");
		pLeaveStateForIdleSignal->Trigger();
	}
}

__DECLARESTATE(waitforheater)
{
	// Get Timeouts
	uint32_t nHeaterTimeout = pStateEnvironment->GetIntegerParameter("timeouts", "heatercontroltimeout");
	uint32_t nToggleValvesTimeout = pStateEnvironment->GetIntegerParameter("timeouts", "togglevalvestimeout");

	//Check if the vacuum system should be used 
	bool bVacuumIsEnabled = pStateEnvironment->GetIntegerParameter("jobinfo", "vacuum_enabled_flag");

	auto pEnableControllerSignal = pStateEnvironment->PrepareSignal("plc", "signal_enablecontroller");
	pEnableControllerSignal->SetInteger("controller_ID", CONTROLLER_ID_HEATER);
	pEnableControllerSignal->Trigger();

	if (pEnableControllerSignal->WaitForHandling(nHeaterTimeout)) 
	{
		if (pEnableControllerSignal->GetBoolResult("success"))
		{
			auto pSignalSwitchValves = pStateEnvironment->PrepareSignal("plc", "signal_switchvalves");
			if (bVacuumIsEnabled)
			{
				// Open vacuum valves
				pSignalSwitchValves->SetBool("toggle_upper_gas_flow_circuit_valve", false);
				pSignalSwitchValves->SetBool("toggle_lower_gas_flow_circuit_valve", false);
				pSignalSwitchValves->SetBool("toggle_shielding_gas_valve", false);
				pSignalSwitchValves->SetBool("toggle_chamber_vacuum_valve", true);
				pSignalSwitchValves->SetBool("toggle_zAxis_vacuum_valve", true);
				pSignalSwitchValves->Trigger();
				if (pSignalSwitchValves->WaitForHandling(nToggleValvesTimeout))
				{
					if (pSignalSwitchValves->GetBoolResult("success"))
					{
						pStateEnvironment->SetNextState("waitforvacuum");
					}
					else
					{
						pStateEnvironment->SetStringParameter("processinitialization", "initerror", "COULDNOTTOGGLEVALVES");
						pStateEnvironment->LogMessage("Switch valves was not successful");
						pStateEnvironment->SetNextState("initerror");
					}
				}
				else
				{
					pStateEnvironment->SetStringParameter("processinitialization", "initerror", "COULDNOTTOGGLEVALVESDUETOTIMEOUT");
					pStateEnvironment->LogMessage("Switch valves timeout");
					pStateEnvironment->SetNextState("initerror");
				}
			}
			else
			{
				// Open circulation valves
				auto pSignalSwitchValves = pStateEnvironment->PrepareSignal("plc", "signal_switchvalves");
				pSignalSwitchValves->SetBool("toggle_upper_gas_flow_circuit_valve", true);
				pSignalSwitchValves->SetBool("toggle_lower_gas_flow_circuit_valve", true);
				pSignalSwitchValves->SetBool("toggle_shielding_gas_valve", false);
				pSignalSwitchValves->SetBool("toggle_chamber_vacuum_valve", false);
				pSignalSwitchValves->SetBool("toggle_zAxis_vacuum_valve", false);
				pSignalSwitchValves->Trigger();
				if (pSignalSwitchValves->WaitForHandling(nToggleValvesTimeout))
				{
					if (pSignalSwitchValves->GetBoolResult("success"))
					{
						pStateEnvironment->SetNextState("waitforatmospherewithoutpump");
					}
					else
					{
						pStateEnvironment->SetStringParameter("processinitialization", "initerror", "COULDNOTTOGGLEVALVES");
						pStateEnvironment->LogMessage("Switch valves was not successful");
						pStateEnvironment->SetNextState("initerror");
					}
				}
				else
				{
					pStateEnvironment->SetStringParameter("processinitialization", "initerror", "COULDNOTTOGGLEVALVESDUETOTIMEOUT");
					pStateEnvironment->LogMessage("Switch valves timeout");
					pStateEnvironment->SetNextState("initerror");
				}
			}
		}
		else
		{
			pStateEnvironment->SetStringParameter("processinitialization", "initerror", "COULDNOTREACHBUILDPLATETEMPERATURE");
			pStateEnvironment->LogMessage("Reaching the build plate temperature was not successful");
			pStateEnvironment->SetNextState("initerror");
		}
	}
	else
	{
		pStateEnvironment->SetStringParameter("processinitialization", "initerror", "COULDNOTREACHBUILDPLATETEMPERATUREDUETOTIMEOUT");
		pStateEnvironment->LogMessage("Build plate temperature timeout");
		pStateEnvironment->SetNextState("initerror");
	}
}

__DECLARESTATE(waitforvacuum)
{
	// Get Timeouts
	uint32_t nToggleValvesTimeout = pStateEnvironment->GetIntegerParameter("timeouts", "togglevalvestimeout");
	uint32_t nVacuumTimeout = pStateEnvironment->GetIntegerParameter("timeouts", "vacuumtimeout");
	uint32_t nGeneralCommandTimeout = pStateEnvironment->GetIntegerParameter("timeouts", "generalplctimeout");
	
	// get vacuum pressure parameter
	int nPressureThresholdVacuumOffInMbar = pStateEnvironment->GetIntegerParameter("jobinfo", "pressure_threshold_vacuum_off_in_mbar");
	 
	// turn on the vaccuum pump and wait until the pressure is reached --> plc signal returns true
	pStateEnvironment->LogMessage("Starting the vacuum pump ...");
	auto pStartVacuumPumpSignal = pStateEnvironment->PrepareSignal("plc", "signal_vacuumcontrol_start_vacuum_pump");
	pStartVacuumPumpSignal->SetInteger("pressure_threshold_vacuum_off_in_mbar", nPressureThresholdVacuumOffInMbar);
	pStartVacuumPumpSignal->Trigger();

	if (pStartVacuumPumpSignal->WaitForHandling(nVacuumTimeout)) 
	{	
		if (pStartVacuumPumpSignal->GetBoolResult("success"))
		{
			auto pTurnOffVacuumPumpSignal = pStateEnvironment->PrepareSignal("plc", "signal_vacuumcontrol_turn_off_vacuum_pump");
			pTurnOffVacuumPumpSignal->Trigger();
			if (pTurnOffVacuumPumpSignal->WaitForHandling(nGeneralCommandTimeout))
			{
				if (pTurnOffVacuumPumpSignal->GetBoolResult("success"))
				{
					// Close vacuum valves and open circulation valves
					auto pSignalSwitchValves = pStateEnvironment->PrepareSignal("plc", "signal_switchvalves");
					pSignalSwitchValves->SetBool("toggle_upper_gas_flow_circuit_valve", true);
					pSignalSwitchValves->SetBool("toggle_lower_gas_flow_circuit_valve", true);
					pSignalSwitchValves->SetBool("toggle_shielding_gas_valve", false);
					pSignalSwitchValves->SetBool("toggle_chamber_vacuum_valve", false);
					pSignalSwitchValves->SetBool("toggle_zAxis_vacuum_valve", false);
					pSignalSwitchValves->Trigger();
					if (pSignalSwitchValves->WaitForHandling(nToggleValvesTimeout)) 
					{
						if (pSignalSwitchValves->GetBoolResult("success"))
						{
							pStateEnvironment->SetNextState("waitforatmospherewithoutpump");
						}
						else
						{
							pStateEnvironment->SetStringParameter("processinitialization", "initerror", "COULDNOTTOGGLEVALVES");
							pStateEnvironment->LogMessage("Switch valves was not successful");
							pStateEnvironment->SetNextState("initerror");
						}
					}
					else
					{
						pStateEnvironment->SetStringParameter("processinitialization", "initerror", "COULDNOTTOGGLEVALVESDUETOTIMEOUT");
						pStateEnvironment->LogMessage("Switch valves timeout");
						pStateEnvironment->SetNextState("initerror");
					}
				}
				else
				{
					pStateEnvironment->SetStringParameter("processinitialization", "initerror", "COULDNOTTURNOFFVACUUMPUMP");
					pStateEnvironment->LogMessage("Turning off the vacuum pump was not successful");
					pStateEnvironment->SetNextState("initerror");
				}
			}
			else
			{
				pStateEnvironment->SetStringParameter("processinitialization", "initerror", "COULDNOTTURNOFFVACUUMPUMPDUETOTIMEOUT");
				pStateEnvironment->LogMessage("Turn off vacuum pump timeout");
				pStateEnvironment->SetNextState("initerror");
			}
		}
		else
		{
			pStateEnvironment->SetStringParameter("processinitialization", "initerror", "COULDNOTESTABLISHVACUUM");
			pStateEnvironment->LogMessage("Establishing vacuum was not successful");
			pStateEnvironment->SetNextState("initerror");
		}
	}
	else
	{
		pStateEnvironment->SetStringParameter("processinitialization", "initerror", "COULDNOTESTABLISHVACUUMDUETOTIMEOUT");
		pStateEnvironment->LogMessage("Establishing vacuum timeout");
		pStateEnvironment->SetNextState("initerror");
	}
}

__DECLARESTATE(waitforatmospherewithoutpump)
{
	// Get Timeouts
	uint32_t nAtmosphereWithoutPumpTimeout = pStateEnvironment->GetIntegerParameter("timeouts", "atmospherewithoutpumptimeout");
	
	// Get oxygen threshold tolerance to switch on the circulation pump
	int nThresholdTolerancePPM = pStateEnvironment->GetIntegerParameter("hardwareinformation", "o2_threshold_tolerance_ppm");

	auto pEnableControllerSignal = pStateEnvironment->PrepareSignal("plc", "signal_enablecontroller");
	pEnableControllerSignal->SetInteger("controller_ID", CONTROLLER_ID_SHIELDINGGAS);
	pEnableControllerSignal->SetInteger("atmosphere_controller_threshold_tolerance_ppm", nThresholdTolerancePPM);
	pEnableControllerSignal->Trigger();
	
	if (pEnableControllerSignal->WaitForHandling(nAtmosphereWithoutPumpTimeout)) {
		if (pEnableControllerSignal->GetBoolResult("success"))
		{
			pStateEnvironment->SetNextState("waitforatmospherewithpump");
		}
		else
		{
			pStateEnvironment->SetStringParameter("processinitialization", "initerror", "COULDNOTESTABLISHATMOSPHERE");
			pStateEnvironment->LogMessage("Establishing process atmosphere was not successful");
			pStateEnvironment->SetNextState("initerror");
		}
	}
	else
	{
		pStateEnvironment->SetStringParameter("processinitialization", "initerror", "COULDNOTESTABLISHATMOSPHEREDUETOTIMEOUT");
		pStateEnvironment->LogMessage("Establishing process atmosphere timeout");
		pStateEnvironment->SetNextState("initerror");
	}
}

__DECLARESTATE(waitforatmospherewithpump)
{
	// Get Timeouts
	uint32_t nAtmosphereWithPumpTimeout = pStateEnvironment->GetIntegerParameter("timeouts", "atmospherewithpumptimeout");
	
	// Check if the circulation pump was already started and not yet stopped
	bool bCirculationPumpStartedFlag = pStateEnvironment->GetBoolParameter("jobinfo", "circulation_pump_started_flag");

	// Get gasflow setpoint
	int nSetpointInPercent = pStateEnvironment->GetIntegerParameter("jobinfo", "circulation_pump_setpoint_in_percent");

	auto pStartGasFlowSignal = pStateEnvironment->PrepareSignal("plc", "signal_atmospherecontrol_start_gas_flow");
	pStartGasFlowSignal->SetInteger("setpoint_in_percent", nSetpointInPercent);
	pStartGasFlowSignal->SetBool("circulation_pump_started_flag", bCirculationPumpStartedFlag);
	pStartGasFlowSignal->SetBool("is_process_flag", true);
	pStartGasFlowSignal->Trigger();

	if (pStartGasFlowSignal->WaitForHandling(nAtmosphereWithPumpTimeout)) {
		if (pStartGasFlowSignal->GetBoolResult("success"))
		{
			// Set the circulation pump started flag
			pStateEnvironment->SetBoolParameter("jobinfo", "circulation_pump_started_flag", true);

			pStateEnvironment->SetNextState("beginlayer");
		}
		else
		{
			pStateEnvironment->SetStringParameter("processinitialization", "initerror", "COULDNOTESTABLISHATMOSPHERE");
			pStateEnvironment->LogMessage("Establishing process atmosphere was not successful");
			pStateEnvironment->SetNextState("initerror");
		}
	}
	else
	{
		pStateEnvironment->SetStringParameter("processinitialization", "initerror", "COULDNOTESTABLISHATMOSPHEREDUETOTIMEOUT");
		pStateEnvironment->LogMessage("Establishing process atmosphere timeout");
		pStateEnvironment->SetNextState("initerror");
	}
}

__DECLARESTATE(beginlayer)
{
	auto layerIndex = pStateEnvironment->GetIntegerParameter("jobinfo", "currentlayer");
	pStateEnvironment->LogMessage("Starting layer " + std::to_string(layerIndex));

	auto sJobUUID = pStateEnvironment->GetStringParameter("jobinfo", "jobuuid");
	auto nLayerCount = pStateEnvironment->GetIntegerParameter("jobinfo", "layercount");
	auto dTotalHeight = pStateEnvironment->GetDoubleParameter("jobinfo", "totalheight");
	
	auto pBuildJob = pStateEnvironment->GetBuildJob(sJobUUID);	
	auto dCurrentHeight = pBuildJob->GetZValueInMM(layerIndex);
	

	std::stringstream sLayerDisplay, sHeightDisplay;
	sLayerDisplay << layerIndex << " / " << (nLayerCount-1);
	sHeightDisplay << std::setprecision(4) << dCurrentHeight << " mm" << " / " << std::setprecision(4) << dTotalHeight << " mm";

	pStateEnvironment->SetDoubleParameter("jobinfo", "currentheight", dCurrentHeight);
	pStateEnvironment->SetStringParameter("ui", "currentlayerdisplay", sLayerDisplay.str());
	pStateEnvironment->SetStringParameter("ui", "currentheightdisplay", sHeightDisplay.str());


	pStateEnvironment->SetNextState("exposelayer");
}

__DECLARESTATE(exposelayer)
{

	//Get timeouts
	uint32_t nExposureTimeOut = pStateEnvironment->GetIntegerParameter("timeouts", "exposuretimeout");
	uint32_t nPowderDosingTimeOut = pStateEnvironment->GetIntegerParameter("timeouts", "powderdosingtimeout");
	uint32_t nGeneralCommandTimeout = pStateEnvironment->GetIntegerParameter("timeouts", "generalplctimeout");

	// Get the tolerances from the parameter groups
	int nHeaterTolerance = pStateEnvironment->GetIntegerParameter("jobinfo", "heatercontroller_tolerance_degree_celsius");
	int nAtmosphereTolerance = pStateEnvironment->GetIntegerParameter("hardwareinformation", "o2_threshold_tolerance_ppm");
	int nGasFlowTolerance = pStateEnvironment->GetIntegerParameter("jobinfo", "oxygencontroller_tolerance_ppm");

	// Check if an atmosphere error, gasflow error or heater error has occured
	auto pCheckHeaterSignal = pStateEnvironment->PrepareSignal("plc", "signal_check_heater");
	pCheckHeaterSignal->SetInteger("heater_controller_tolerance_degree_celsius", nHeaterTolerance);
	pCheckHeaterSignal->Trigger();
	if (pCheckHeaterSignal->WaitForHandling(nGeneralCommandTimeout)) 
	{
		if (pCheckHeaterSignal->GetBoolResult("heater_controller_enabled_setpoint_reached"))
		{
			auto pCheckAtmosphereSignal = pStateEnvironment->PrepareSignal("plc", "signal_check_atmosphere");
			pCheckAtmosphereSignal->SetInteger("atmosphere_controller_threshold_tolerance_ppm", nAtmosphereTolerance);
			pCheckAtmosphereSignal->Trigger();
			if (pCheckAtmosphereSignal->WaitForHandling(nGeneralCommandTimeout)) {
				if (pCheckAtmosphereSignal->GetBoolResult("atmosphere_controller_enabled_threshold_reached"))
				{
					auto pCheckGasFlowSignal = pStateEnvironment->PrepareSignal("plc", "signal_check_gas_flow");
					pCheckGasFlowSignal->SetInteger("atmosphere_controller_setpoint_tolerance_ppm", nGasFlowTolerance);
					pCheckGasFlowSignal->Trigger();
					if (pCheckGasFlowSignal->WaitForHandling(nGeneralCommandTimeout)) {
						if (pCheckGasFlowSignal->GetBoolResult("circulation_pump_started_setpoint_reached"))
						{
							pStateEnvironment->LogMessage("No heater error, atmosphere error or gas flow error");
						}
						else
						{
							pStateEnvironment->LogMessage("The gas flow is not working properly");
							pStateEnvironment->SetNextState("gasflowerror");
							return;
						}
					}
					else
					{
						pStateEnvironment->LogMessage("Check atmosphere timeout");
						pStateEnvironment->SetNextState("waitforshutdown");
						return;
					}
				}
				else
				{
					pStateEnvironment->LogMessage("The shielding gas controller is not working properly");
					pStateEnvironment->SetNextState("atmosphereerror");
					return;
				}
			}
			else
			{
				pStateEnvironment->LogMessage("Check atmosphere timeout");
				pStateEnvironment->SetNextState("waitforshutdown");
				return;
			}
		}
		else
		{
			pStateEnvironment->LogMessage("The build platform heater controller is not working properly");
			pStateEnvironment->SetNextState("heatererror");
			return;
		}
	}
	else
	{
		pStateEnvironment->LogMessage("Check heater timeout");
		pStateEnvironment->SetNextState("waitforshutdown");
		return;
	}

	// In this state, the layer is exposed and simulatneosly the recoater is filled with powder if necessary

	// get parameters for the exposure command
	auto sJobUUID = pStateEnvironment->GetStringParameter("jobinfo", "jobuuid");
	auto nCurrentLayer = pStateEnvironment->GetIntegerParameter("jobinfo", "currentlayer");
	auto nLayerCount = pStateEnvironment->GetIntegerParameter("jobinfo", "layercount");
	

	// get parameters for the powder refill command
	auto pBuildJob = pStateEnvironment->GetBuildJob(sJobUUID);
	auto dCurrentLayerZ = pBuildJob->GetZValueInMM(nCurrentLayer);
	auto dTotalHeight = pStateEnvironment->GetDoubleParameter("jobinfo", "totalheight");
	auto dOldRecoaterFillingVolumeInMMCubed = pStateEnvironment->GetDoubleParameter("jobinfo", "currentrecoaterpowdercapacity");
	auto dRecoaterRefillPositionInMM = pStateEnvironment->GetDoubleParameter("hardwareinformation", "recoater_refill_position");
	auto dRecoatingStartPositionInMM = pStateEnvironment->GetDoubleParameter("hardwareinformation", "recoating_start_position");
	auto dPowderVolumePerNotchInCubicMM = pStateEnvironment->GetDoubleParameter("hardwareinformation", "powderreservoir_notch_volume_in_cubic_mm");
	auto dOldReservoirPowderVolumeInMMCubed = pStateEnvironment->GetDoubleParameter("jobinfo", "currentreservoirpowdercapacity");
	auto dOverDoseFactor = pStateEnvironment->GetDoubleParameter("jobinfo", "overdosefactor");
	auto nPowderreservoirNotchCount = pStateEnvironment->GetIntegerParameter("hardwareinformation", "powderreservoir_dosing_notch_count");
	auto dReservoirSpeedInDegreesPerSecond = pStateEnvironment->GetDoubleParameter("jobinfo", "powderreservoir_speed");
	auto dReservoirAccelerationInDegreesPerSecondSquared = pStateEnvironment->GetDoubleParameter("jobinfo", "powderreservoir_acceleration");
	double dRecoaterPowderBeltWidthInMM = pStateEnvironment->GetDoubleParameter("hardwareinformation", "recoater_powderbelt_width");
	double dRecoaterLevelingBladeHeightInMM = pStateEnvironment->GetDoubleParameter("hardwareinformation", "recoater_powderbelt_levelingblade_height");

	//TODO: Debugging of layer indexing, currently only building until (nLayerCount-1)
	double dLayerHeightInMM = 0;

	//Initialize the powder dosing signal
	auto pMovementReservoirSignal = pStateEnvironment->PrepareSignal("plc", "signal_singleaxismovement");
	bool bPowderDosingTriggered = false;

	// check if this is the final layer
	if (nCurrentLayer < (nLayerCount - 1)) {

		// check the layerheight of the next layer
		auto dNextLayerZ = pBuildJob->GetZValueInMM(nCurrentLayer + 1);
		dLayerHeightInMM = dNextLayerZ - dCurrentLayerZ;

		if (dLayerHeightInMM < MIN_LAYERHEIGHTINMM)
			throw std::runtime_error("invalid layer height in layer " + std::to_string(nCurrentLayer) + ": " + std::to_string(dLayerHeightInMM) + "mm");
		// calculate powder needed for the next recoating
		double dNeededPowderVolumeInMMCubed = (dRecoatingStartPositionInMM - dRecoaterRefillPositionInMM) * dOverDoseFactor * dRecoaterPowderBeltWidthInMM * dRecoaterLevelingBladeHeightInMM;

		// check the current powder availability in the reservoir of the recoater
		if (dOldRecoaterFillingVolumeInMMCubed <= dNeededPowderVolumeInMMCubed)
		{
			// refill the recoater by the needed ammount
			auto nDosingUnits = (int32_t)round(((dNeededPowderVolumeInMMCubed - dOldRecoaterFillingVolumeInMMCubed) / dPowderVolumePerNotchInCubicMM) + 0.5);
			auto dRecoaterFillingVolumeInMMCubed = nDosingUnits * dPowderVolumePerNotchInCubicMM;

			pStateEnvironment->LogMessage("Refilling recoater with powder ...");
			double dTargetInDegrees = nDosingUnits * 360.0 / nPowderreservoirNotchCount;

			//Prepare the powder dosing signal
			pMovementReservoirSignal->SetInteger("axis_ID", AXISID_POWDERRESERVOIR); //axis_ID powder reservoir
			pMovementReservoirSignal->SetInteger("absoluterelative", RELATIVE_FLAG); //relative movement
			pMovementReservoirSignal->SetDouble("target", dTargetInDegrees);
			pMovementReservoirSignal->SetDouble("speed", dReservoirSpeedInDegreesPerSecond);
			pMovementReservoirSignal->SetDouble("acceleration", dReservoirAccelerationInDegreesPerSecondSquared);
			pMovementReservoirSignal->Trigger();
			bPowderDosingTriggered = true;

			// update powder reservoir volume 
			pStateEnvironment->SetDoubleParameter("jobinfo", "currentreservoirpowdercapacity", (dOldReservoirPowderVolumeInMMCubed - dRecoaterFillingVolumeInMMCubed));
			pStateEnvironment->SetDoubleParameter("jobinfo", "currentrecoaterpowdercapacity", (dOldRecoaterFillingVolumeInMMCubed + dRecoaterFillingVolumeInMMCubed));

		}
	}
	
	pStateEnvironment->LogMessage("Exposing layer ..." + std::to_string(nLayerCount));

	// prepare exopse layer command
	auto pExposureSignal = pStateEnvironment->PrepareSignal("scanner", "signal_exposure");
	pExposureSignal->SetString("jobuuid", sJobUUID);
	pExposureSignal->SetInteger("layerindex", nCurrentLayer);
	pExposureSignal->Trigger();

	if (pExposureSignal->WaitForHandling((uint32_t)nExposureTimeOut)) {
		pStateEnvironment->LogMessage("Layer successfully exposed...");

	}
	else {
		pStateEnvironment->LogMessage("Layer exposure failed...");
		pStateEnvironment->SetNextState("fatalerror");
		return;
	}
	//check if a powder dosing was triggered
	if (bPowderDosingTriggered)
	{
		//check if powderdosing was done
		if (pMovementReservoirSignal->WaitForHandling((uint32_t)nPowderDosingTimeOut)) {
				
			if (pMovementReservoirSignal->GetBoolResult("success"))
			{
				pStateEnvironment->LogMessage("Powder dosing finished");
			}
			else {
				pStateEnvironment->LogMessage("Powder dosing failed");
				pStateEnvironment->SetNextState("fatalerror");
			}
				
		}
		else {
			pStateEnvironment->LogMessage("Refilling recoater failed, powder dosing timeout");
			pStateEnvironment->SetNextState("fatalerror");
			return;
		}

		

	}

	pStateEnvironment->SetNextState("recoatlayer");
}

__DECLARESTATE(recoatlayer)
{
	auto nRecoatLayerTimeOut = pStateEnvironment->GetDoubleParameter("timeouts", "recoatingtimeout");
	
	// move recoater linear to the recoat start position
	// drive build plate to desired layer height
	// recoat the layer


	std::string sJobUUID = pStateEnvironment->GetStringParameter("jobinfo", "jobuuid");
	auto layerIndex = pStateEnvironment->GetIntegerParameter("jobinfo", "currentlayer");
	auto layerCount = pStateEnvironment->GetIntegerParameter("jobinfo", "layercount");

	bool bFinished = (layerIndex >= layerCount-1);

	if (bFinished) {
		pStateEnvironment->SetNextState("finishlayer");
		return;
	}
	else {
		pStateEnvironment->LogMessage("Start recoating ...");
		auto pBuildJob = pStateEnvironment->GetBuildJob(sJobUUID);
		auto dCurrentLayerZ = pBuildJob->GetZValueInMM(layerIndex);
		auto dNextLayerZ = pBuildJob->GetZValueInMM(layerIndex + 1);

		double dLayerHeightInMM = dNextLayerZ - dCurrentLayerZ;
		if (dLayerHeightInMM < MIN_LAYERHEIGHTINMM)
			throw std::runtime_error("invalid layer height in layer " + std::to_string(layerIndex) + ": " + std::to_string(dLayerHeightInMM) + "mm");

		//Retrieve parameters of signal from jobinfo and hardware info
		double dPlatformAxisClearanceInMM = pStateEnvironment->GetDoubleParameter("jobinfo", "platformaxis_clearance");
		double dPlatformAxisSpeedInMMPerSecond = pStateEnvironment->GetDoubleParameter("jobinfo", "platformaxis_speed");
		double dPlatformAxisAccelerationInMMPerSecondSqaured = pStateEnvironment->GetDoubleParameter("jobinfo", "platformaxis_acceleration");
		double dRecoaterLinearAxisSpeedTravelInMMPerSecond = pStateEnvironment->GetDoubleParameter("jobinfo", "recoater_linear_speed_travel");
		double dRecoaterLinearAxesAccelerationTravelInMMPerSecondSqaured = pStateEnvironment->GetDoubleParameter("jobinfo", "recoater_axes_linear_acceleration_travel");
		double dRecoaterLinearAxisSpeedRecoatingInMMPerSecond = pStateEnvironment->GetDoubleParameter("jobinfo", "recoater_linear_speed_recoating");
		double dRecoaterLinearAxesAccelerationRecoatingInMMPerSecondSqaured = pStateEnvironment->GetDoubleParameter("jobinfo", "recoater_axes_linear_acceleration_recoating");
		double dRecoaterDosingFactor = pStateEnvironment->GetDoubleParameter("jobinfo", "overdosefactor");
		double dRecoaterRefillPositionInMM = pStateEnvironment->GetDoubleParameter("hardwareinformation", "recoater_refill_position");
		double dRecoatingStartPositionInMM = pStateEnvironment->GetDoubleParameter("hardwareinformation", "recoating_start_position");
		double dRecoatingEndPositionInMM = pStateEnvironment->GetDoubleParameter("hardwareinformation", "recoating_end_position");
		double dOldRecoaterPowderVolumeInMMCubed = pStateEnvironment->GetDoubleParameter("jobinfo", "currentrecoaterpowdercapacity");
		double dRecoaterPowderBeltWidthInMM = pStateEnvironment->GetDoubleParameter("hardwareinformation", "recoater_powderbelt_width");
		double dRecoaterLevelingBladeHeightInMM = pStateEnvironment->GetDoubleParameter("hardwareinformation", "recoater_powderbelt_levelingblade_height");
		bool bIsDualAxisRecoating = pStateEnvironment->GetBoolParameter("jobinfo", "is_dual_axis_recoating");

		//Check if layer 0 or layer 1 was exposed: Then the buildplatform is not lowered during recoating
		if (layerIndex == 0 || layerIndex == 1)
		{
			dLayerHeightInMM = 0;
		}

		pStateEnvironment->LogMessage("Trigger recoating signal ...");
		//Prepare the recoat layer signal
		auto pRecoatLayer = pStateEnvironment->PrepareSignal("plc", "signal_recoatlayer");
		pRecoatLayer->SetDouble("platformaxis_clearance", dPlatformAxisClearanceInMM);
		pRecoatLayer->SetDouble("platformaxis_speed", dPlatformAxisSpeedInMMPerSecond);
		pRecoatLayer->SetDouble("platformaxis_acceleration", dPlatformAxisAccelerationInMMPerSecondSqaured);
		pRecoatLayer->SetDouble("layer_height", dLayerHeightInMM);
		pRecoatLayer->SetDouble("recoater_linear_speed_travel", dRecoaterLinearAxisSpeedTravelInMMPerSecond);
		pRecoatLayer->SetDouble("recoater_axes_linear_acceleration_travel", dRecoaterLinearAxesAccelerationTravelInMMPerSecondSqaured);
		pRecoatLayer->SetDouble("recoater_linear_speed_recoating", dRecoaterLinearAxisSpeedRecoatingInMMPerSecond);
		pRecoatLayer->SetDouble("recoater_axes_linear_acceleration_recoating", dRecoaterLinearAxesAccelerationRecoatingInMMPerSecondSqaured);
		pRecoatLayer->SetDouble("recoater_axes_dosing_factor", dRecoaterDosingFactor);
		pRecoatLayer->SetDouble("recoater_refill_position", dRecoaterRefillPositionInMM);
		pRecoatLayer->SetDouble("recoating_start_position", dRecoatingStartPositionInMM);
		pRecoatLayer->SetDouble("recoating_end_position", dRecoatingEndPositionInMM);
		pRecoatLayer->SetBool("is_dual_axis_recoating", bIsDualAxisRecoating);
		//Send the recoat layer signal to the plc state machine
		pRecoatLayer->Trigger();
		pStateEnvironment->LogMessage("Wait for recoating ...");
		if (pRecoatLayer->WaitForHandling(nRecoatLayerTimeOut)) 
		{
			if (pRecoatLayer->GetBoolResult("success"))
			{
				pStateEnvironment->LogMessage("Recoating finished");
				pStateEnvironment->SetNextState("finishlayer");

				double dLayerPowderVolumeInMMCubed = (dRecoatingStartPositionInMM - dRecoaterRefillPositionInMM) * dRecoaterDosingFactor * dRecoaterPowderBeltWidthInMM * dRecoaterLevelingBladeHeightInMM;
				double dRecoaterFillingVolumeInMMCubed = dOldRecoaterPowderVolumeInMMCubed - dLayerPowderVolumeInMMCubed;
				pStateEnvironment->SetDoubleParameter("jobinfo", "currentrecoaterpowdercapacity", dRecoaterFillingVolumeInMMCubed);

				pStateEnvironment->LogMessage("Current recoater powder capacity: " + std::to_string(dRecoaterFillingVolumeInMMCubed) + " cubic mm");
			}
			else {
				pStateEnvironment->LogMessage("Error occured during recoating");
				pStateEnvironment->SetNextState("recoatingerror");
			}
		}
		else {
			// no response from PLC!
			pStateEnvironment->LogMessage("Timeout: Error occured during recoating");
			pStateEnvironment->SetNextState("recoatingerror");
		}
	}
}


__DECLARESTATE(finishlayer)
{
	PSignalHandler pSignalHandler;
	auto layerIndex = pStateEnvironment->GetIntegerParameter("jobinfo", "currentlayer");
	auto layerCount = pStateEnvironment->GetIntegerParameter("jobinfo", "layercount");

	pStateEnvironment->LogMessage("Finished layer " + std::to_string(layerIndex));
	layerIndex = layerIndex + 1;
	pStateEnvironment->SetIntegerParameter ("jobinfo", "currentlayer", layerIndex);

	pStateEnvironment->LogMessage("Moving to layer " + std::to_string(layerIndex));

	bool bFinished = (layerIndex >= layerCount);
	
	if (bFinished) {
		pStateEnvironment->SetNextState("finishprocess");
	}
	else if (pStateEnvironment->WaitForSignal("signal_cancelbuild", 0 , pSignalHandler)) { // check if CancelBuild button or PauseBuild button was clicked
		pStateEnvironment->SetBoolParameter("ui", "build_canbecanceled", false);
		pStateEnvironment->SetBoolParameter("ui", "build_canbepausedorresumed", false);
		pStateEnvironment->SetNextState("cancelprocess");
		pSignalHandler->SignalHandled();
	}
	else if (pStateEnvironment->WaitForSignal("signal_pausebuild", 0, pSignalHandler)) { // check if CancelBuild button or PauseBuild button was clicked
		pStateEnvironment->SetBoolParameter("ui", "build_canbecanceled", false);
		pStateEnvironment->SetBoolParameter("ui", "build_canbepausedorresumed", false);
		pStateEnvironment->SetNextState("pauseprocess");
		pSignalHandler->SignalHandled();
		pStateEnvironment->LogMessage("Press the 'Pause Build' Button to resume the process at beginlayer or press the 'Cancel Build' Button to cancel the process!");
	}
	else {
		pStateEnvironment->SetNextState("beginlayer");
	}
}

__DECLARESTATE(finishprocess)
{
	pStateEnvironment->SetNextState("waitforshutdown");
}

__DECLARESTATE(pauseprocess)
{
	PSignalHandler pSignalHandler;
	pStateEnvironment->SetBoolParameter("ui", "build_canbecanceled", true);
	pStateEnvironment->SetBoolParameter("ui", "build_canbepausedorresumed", true);

	// check if CancelBuild button or PauseBuild button was clicked
	if (pStateEnvironment->WaitForSignal("signal_pausebuild", 0, pSignalHandler)) {
		pStateEnvironment->SetNextState("beginlayer");
		pSignalHandler->SignalHandled();
		pStateEnvironment->LogMessage("Resuming the process at 'beginlayer' ...");
	}
	else if (pStateEnvironment->WaitForSignal("signal_cancelbuild", 0, pSignalHandler)) {
		pStateEnvironment->SetBoolParameter("ui", "build_canbecanceled", false);
		pStateEnvironment->SetBoolParameter("ui", "build_canbepausedorresumed", false);
		pStateEnvironment->SetNextState("cancelprocess");
		pSignalHandler->SignalHandled();
		pStateEnvironment->LogMessage("Aborting the process ...");
	}
	else if (pStateEnvironment->WaitForSignal("signal_manualmovementcontrol_enter", 0, pSignalHandler)) {
		pSignalHandler->SignalHandled();
		pStateEnvironment->SetBoolParameter("ui", "build_canbecanceled", false);
		pStateEnvironment->SetBoolParameter("ui", "build_canbepausedorresumed", false);
		pStateEnvironment->SetBoolParameter("ui", "manualcontrol_canbeleftforidle", false);
		pStateEnvironment->SetBoolParameter("ui", "build_canbecanceledfrommanualcontrol", true);
		pStateEnvironment->SetBoolParameter("ui", "build_canberesumedfrommanualcontrol", true);
		pStateEnvironment->SetNextState("manualmovementcontrol");
		pStateEnvironment->LogMessage("Entering the manual movement control ...");
	}
	else if (pStateEnvironment->WaitForSignal("signal_manualatmospherecontrol_enter", 0, pSignalHandler)) {
		pSignalHandler->SignalHandled();
		pStateEnvironment->SetBoolParameter("ui", "build_canbecanceled", false);
		pStateEnvironment->SetBoolParameter("ui", "build_canbepausedorresumed", false);
		pStateEnvironment->SetBoolParameter("ui", "manualcontrol_canbeleftforidle", false);
		pStateEnvironment->SetBoolParameter("ui", "build_canbecanceledfrommanualcontrol", true);
		pStateEnvironment->SetBoolParameter("ui", "build_canberesumedfrommanualcontrol", true);
		pStateEnvironment->SetNextState("manualatmospherecontrol");
		pStateEnvironment->LogMessage("Entering the manual atmosphere control ...");
	}
	else if (pStateEnvironment->WaitForSignal("signal_manualheatercontrol_enter", 0, pSignalHandler)) {
		pSignalHandler->SignalHandled();
		pStateEnvironment->SetBoolParameter("ui", "build_canbecanceled", false);
		pStateEnvironment->SetBoolParameter("ui", "build_canbepausedorresumed", false);
		pStateEnvironment->SetBoolParameter("ui", "manualcontrol_canbeleftforidle", false);
		pStateEnvironment->SetBoolParameter("ui", "build_canbecanceledfrommanualcontrol", true);
		pStateEnvironment->SetBoolParameter("ui", "build_canberesumedfrommanualcontrol", true);
		pStateEnvironment->SetNextState("manualheatercontrol");
		pStateEnvironment->LogMessage("Entering the manual heater control ...");
	}
	else {
		pStateEnvironment->SetNextState("pauseprocess");
	}
}

__DECLARESTATE(cancelprocess)
{
	pStateEnvironment->SetNextState("waitforshutdown");
}

__DECLARESTATE(waitforshutdown)
{
	pStateEnvironment->SetNextState("waitforshutdown");

	// reset shutdown parameters
	pStateEnvironment->SetStringParameter("processshutdown", "shutdownerror", "NOERROR");
	pStateEnvironment->SetBoolParameter("processshutdown", "doorunlocked", false);
	pStateEnvironment->SetBoolParameter("processshutdown", "vacuumpumpturnedoff", false);
	pStateEnvironment->SetBoolParameter("processshutdown", "heaterturnedoff", false);
	pStateEnvironment->SetBoolParameter("processshutdown", "shieldinggasturnedoff", false);
	pStateEnvironment->SetBoolParameter("processshutdown", "circulationpumpturnedoff", false);
	pStateEnvironment->SetBoolParameter("processshutdown", "valvesshut", false);

	// get timeouts
	uint32_t nLockDoorTimeout = pStateEnvironment->GetIntegerParameter("timeouts", "lockdoortimeout");
	uint32_t nGeneralShutDownTimeout = pStateEnvironment->GetIntegerParameter("timeouts", "generalshutdowntimeout");
	uint32_t nToggleValvesTimeout = pStateEnvironment->GetIntegerParameter("timeouts", "togglevalvestimeout");

	// disable cancel build button 
	pStateEnvironment->SetBoolParameter("ui", "build_canbecanceled", false);
	pStateEnvironment->SetBoolParameter("ui", "build_canbepausedorresumed", false);
	
	// unlock door
	pStateEnvironment->LogMessage("Unlocking chamber door..");
	auto pLockDoorSignal = pStateEnvironment->PrepareSignal("plc", "signal_lockdoor");
	pLockDoorSignal->SetBool("lockdoor", false);
	pLockDoorSignal->Trigger();
	if (pLockDoorSignal->WaitForHandling(nLockDoorTimeout)) {
		bool bDoorIsLocked = pLockDoorSignal->GetBoolResult("doorlockstate");
		if (bDoorIsLocked) {
			// Invalid response from PLC!
			pStateEnvironment->SetStringParameter("processshutdown", "shutdownerror", "COULDNOTUNLOCKDOOR");
		}
		else
		{
			pStateEnvironment->SetBoolParameter("processshutdown", "doorunlocked", true);
		}
	}
	else {
		// No response from PLC!
		pStateEnvironment->SetStringParameter("processshutdown", "shutdownerror", "COULDNOTUNLOCKDOOR");
	}
	
	// turn off vacuum pump
	pStateEnvironment->LogMessage("Turning off vacuum pump..");
	auto pTurnOffVacuumPumpSignal = pStateEnvironment->PrepareSignal("plc", "signal_vacuumcontrol_turn_off_vacuum_pump");
	pTurnOffVacuumPumpSignal->Trigger();
	if (pTurnOffVacuumPumpSignal->WaitForHandling(nGeneralShutDownTimeout)) {
		if (pTurnOffVacuumPumpSignal->GetBoolResult("success")) 
		{
			pStateEnvironment->SetBoolParameter("processshutdown", "vacuumpumpturnedoff", true);
		}
		else
		{
			// Invalid response from PLC!
			pStateEnvironment->SetStringParameter("processshutdown", "shutdownerror", "COULDNOTTURNOFFVACUUMPUMP");
		}
	}
	else {
		// No response from PLC!
		pStateEnvironment->SetStringParameter("processshutdown", "shutdownerror", "COULDNOTTURNOFFVACUUMPUMP");
	}

	// disable heater controller
	pStateEnvironment->LogMessage("Disabling heater controller..");
	auto pDisableHeaterControllerSignal = pStateEnvironment->PrepareSignal("plc", "signal_disablecontroller");
	pDisableHeaterControllerSignal->SetInteger("controller_ID", CONTROLLER_ID_HEATER);
	pDisableHeaterControllerSignal->Trigger();
	if (pDisableHeaterControllerSignal->WaitForHandling(nGeneralShutDownTimeout)) {
		if (pDisableHeaterControllerSignal->GetBoolResult("success"))
		{
			pStateEnvironment->SetBoolParameter("processshutdown", "heaterturnedoff", true);
		}
		else
		{
			// Invalid response from PLC!
			pStateEnvironment->SetStringParameter("processshutdown", "shutdownerror", "COULDNOTTURNOFFHEATER");
		}
	}
	else {
		// No response from PLC!
		pStateEnvironment->SetStringParameter("processshutdown", "shutdownerror", "COULDNOTTURNOFFHEATER");
	}

	// disable shielding gas controller
	pStateEnvironment->LogMessage("Disabling oxygen controller..");
	auto pDisableOxygenControllerSignal = pStateEnvironment->PrepareSignal("plc", "signal_disablecontroller");
	pDisableOxygenControllerSignal->SetInteger("controller_ID", CONTROLLER_ID_SHIELDINGGAS);
	pDisableOxygenControllerSignal->Trigger();
	if (pDisableOxygenControllerSignal->WaitForHandling(nGeneralShutDownTimeout)) {
		if (pDisableOxygenControllerSignal->GetBoolResult("success"))
		{
			pStateEnvironment->SetBoolParameter("processshutdown", "shieldinggasturnedoff", true);
		}
		else
		{
			// Invalid response from PLC!
			pStateEnvironment->SetStringParameter("processshutdown", "shutdownerror", "COULDNOTTURNOFFSHIELDINGGAS");
		}
	}
	else {
		// No response from PLC!
		pStateEnvironment->SetStringParameter("processshutdown", "shutdownerror", "COULDNOTTURNOFFSHIELDINGGAS");
	}

	// turn off circulation pump
	pStateEnvironment->LogMessage("Turning off vacuum pump..");
	auto pTurnOffCirculationPumpSignal = pStateEnvironment->PrepareSignal("plc", "signal_atmospherecontrol_turn_off_gas_flow");
	pTurnOffCirculationPumpSignal->Trigger();
	if (pTurnOffCirculationPumpSignal->WaitForHandling(nGeneralShutDownTimeout)) {
		if (pTurnOffCirculationPumpSignal->GetBoolResult("success"))
		{
			pStateEnvironment->SetBoolParameter("processshutdown", "circulationpumpturnedoff", true);

			// Reset the circulation pump started flag
			pStateEnvironment->SetBoolParameter("jobinfo", "circulation_pump_started_flag", false);
		}
		else
		{
			// Invalid response from PLC!
			pStateEnvironment->SetStringParameter("processshutdown", "shutdownerror", "COULDNOTTURNOFFCIRCULATIONPUMP");
		}
	}
	else {
		// No response from PLC!
		pStateEnvironment->SetStringParameter("processshutdown", "shutdownerror", "COULDNOTTURNOFFCIRCULATIONPUMP");
	}

	// shut valves
	pStateEnvironment->LogMessage("Shuting valves..");
	auto pSignalSwitchValves = pStateEnvironment->PrepareSignal("plc", "signal_switchvalves");
	pSignalSwitchValves->SetBool("toggle_upper_gas_flow_circuit_valve", false);
	pSignalSwitchValves->SetBool("toggle_lower_gas_flow_circuit_valve", false);
	pSignalSwitchValves->SetBool("toggle_shielding_gas_valve", false);
	pSignalSwitchValves->SetBool("toggle_chamber_vacuum_valve", false);
	pSignalSwitchValves->SetBool("toggle_zAxis_vacuum_valve", false);
	pSignalSwitchValves->Trigger();
	if (pSignalSwitchValves->WaitForHandling(nToggleValvesTimeout)) {
		if (pSignalSwitchValves->GetBoolResult("success"))
		{
			pStateEnvironment->SetBoolParameter("processshutdown", "valvesshut", true);
		}
		else
		{
			// Invalid response from PLC!
			pStateEnvironment->SetStringParameter("processshutdown", "shutdownerror", "COULDNOTTURNOFFCIRCULATIONPUMP");
		}
	}
	else {
		// No response from PLC!
		pStateEnvironment->SetStringParameter("processshutdown", "shutdownerror", "COULDNOTTURNOFFCIRCULATIONPUMP");
	}

	// shutdown flags
	bool bDoorUnlocked = pStateEnvironment->GetBoolParameter("processshutdown", "doorunlocked");
	bool bVacuumPumpTurnedOff = pStateEnvironment->GetBoolParameter("processshutdown", "vacuumpumpturnedoff");
	bool bHeaterTurnedOff = pStateEnvironment->GetBoolParameter("processshutdown", "heaterturnedoff");
	bool bShieldingGasTurnedOff = pStateEnvironment->GetBoolParameter("processshutdown", "shieldinggasturnedoff");
	bool bCirculationPumpTurnedOff = pStateEnvironment->GetBoolParameter("processshutdown", "circulationpumpturnedoff");
	bool bValvesShut = pStateEnvironment->GetBoolParameter("processshutdown", "valvesshut");

	if (bDoorUnlocked && bVacuumPumpTurnedOff && bHeaterTurnedOff && bShieldingGasTurnedOff && bCirculationPumpTurnedOff && bValvesShut)
	{
		// enable the manual control cancel button and disable the build process related buttons
		pStateEnvironment->SetBoolParameter("ui", "manualcontrol_canbeleftforidle", true);
		pStateEnvironment->SetBoolParameter("ui", "build_canbecanceledfrommanualcontrol", false);
		pStateEnvironment->SetBoolParameter("ui", "build_canberesumedfrommanualcontrol", false);

		pStateEnvironment->SetNextState("idle");
	}
}

__DECLARESTATE(initerror)
{
	pStateEnvironment->LogMessage("Error during initialization!");
	pStateEnvironment->SetNextState("waitforshutdown");

}

__DECLARESTATE(powdererror)
{

}

__DECLARESTATE(heatererror)
{
	// Get Timeouts
	uint32_t nHeaterTimeout = pStateEnvironment->GetIntegerParameter("timeouts", "heatercontroltimeout");
	uint32_t nPauseTimeout = pStateEnvironment->GetIntegerParameter("timeouts", "waitforpauseprocesstimeout");
	uint32_t nLeavingStateTimeout = pStateEnvironment->GetIntegerParameter("timeouts", "leavingstatetimeout");

	auto pEnableControllerSignal = pStateEnvironment->PrepareSignal("plc", "signal_enablecontroller");
	pEnableControllerSignal->SetInteger("controller_ID", CONTROLLER_ID_HEATER);
	pEnableControllerSignal->Trigger();
	
	int nCounterStep = (int) (nPauseTimeout/10000);
	int iMax = (int) (nPauseTimeout / nCounterStep);
	PSignalHandler pSignalHandler;
	for (int i = 0; i++; iMax)
	{
		if (pStateEnvironment->WaitForSignal("signal_cancelbuild", 0, pSignalHandler)) { // check if CancelBuild button or PauseBuild button was clicked
			pStateEnvironment->SetBoolParameter("ui", "build_canbecanceled", false);
			pStateEnvironment->SetBoolParameter("ui", "build_canbepausedorresumed", false);
			pStateEnvironment->SetNextState("cancelprocess");
			pSignalHandler->SignalHandled();
			break;
		}
		else if (pStateEnvironment->WaitForSignal("signal_pausebuild", 0, pSignalHandler)) { // check if CancelBuild button or PauseBuild button was clicked
			pStateEnvironment->SetBoolParameter("ui", "build_canbecanceled", false);
			pStateEnvironment->SetBoolParameter("ui", "build_canbepausedorresumed", false);
			pSignalHandler->SignalHandled();
			auto pLeaveStateForIdleSignal = pStateEnvironment->PrepareSignal("plc", "signal_leavestateforidle");
			pLeaveStateForIdleSignal->Trigger();
			if (pLeaveStateForIdleSignal->WaitForHandling(nLeavingStateTimeout))
			{
				if (pLeaveStateForIdleSignal->GetBoolResult("success"))
				{
					pStateEnvironment->SetNextState("pauseprocess");
					pStateEnvironment->LogMessage("Press the 'Pause Build' Button to resume the process at beginlayer or press the 'Cancel Build' Button to cancel the process!");
				}
				else
				{
					pStateEnvironment->LogMessage("Leaving the current state of the plc state machine for the state idle is not currently not possible");
					pStateEnvironment->SetNextState("waitforshutdown");
				}
			}
			else
			{
				pStateEnvironment->LogMessage("Timeout: Leaving the current state of the plc state machine for the state idle is not currently not possible");
				pStateEnvironment->SetNextState("waitforshutdown");
			}
			break;
		}
		pStateEnvironment->Sleep(nCounterStep);
	}

	if (pEnableControllerSignal->WaitForHandling(nHeaterTimeout))
	{
		if (pEnableControllerSignal->GetBoolResult("success"))
		{
			pStateEnvironment->SetNextState("beginlayer");
			pStateEnvironment->LogMessage("Reestablishing the build plate temperature was successful");
		}
		else
		{
			pStateEnvironment->LogMessage("Reaching the build plate temperature was not successful");
			pStateEnvironment->SetNextState("waitforshutdown");
		}
	}
	else
	{
		pStateEnvironment->LogMessage("Build plate temperature timeout");
		pStateEnvironment->SetNextState("waitforshutdown");
	}
}

__DECLARESTATE(atmosphereerror)
{
	// Get Timeouts
	uint32_t nAtmosphereWithoutPumpTimeout = pStateEnvironment->GetIntegerParameter("timeouts", "atmospherewithoutpumptimeout");
	uint32_t nPauseTimeout = pStateEnvironment->GetIntegerParameter("timeouts", "waitforpauseprocesstimeout");
	uint32_t nLeavingStateTimeout = pStateEnvironment->GetIntegerParameter("timeouts", "leavingstatetimeout");

	// Get oxygen threshold tolerance to switch on the circulation pump
	int nThresholdTolerancePPM = pStateEnvironment->GetIntegerParameter("hardwareinformation", "o2_threshold_tolerance_ppm");

	auto pEnableControllerSignal = pStateEnvironment->PrepareSignal("plc", "signal_enablecontroller");
	pEnableControllerSignal->SetInteger("controller_ID", CONTROLLER_ID_SHIELDINGGAS);
	pEnableControllerSignal->SetInteger("atmosphere_controller_threshold_tolerance_ppm", nThresholdTolerancePPM);
	pEnableControllerSignal->Trigger();

	int nCounterStep = (int)(nPauseTimeout / 10000);
	int iMax = (int)(nPauseTimeout / nCounterStep);
	PSignalHandler pSignalHandler;
	for (int i = 0; i++; iMax)
	{
		if (pStateEnvironment->WaitForSignal("signal_cancelbuild", 0, pSignalHandler)) { // check if CancelBuild button or PauseBuild button was clicked
			pStateEnvironment->SetBoolParameter("ui", "build_canbecanceled", false);
			pStateEnvironment->SetBoolParameter("ui", "build_canbepausedorresumed", false);
			pStateEnvironment->SetNextState("cancelprocess");
			pSignalHandler->SignalHandled();
			break;
		}
		else if (pStateEnvironment->WaitForSignal("signal_pausebuild", 0, pSignalHandler)) { // check if CancelBuild button or PauseBuild button was clicked
			pStateEnvironment->SetBoolParameter("ui", "build_canbecanceled", false);
			pStateEnvironment->SetBoolParameter("ui", "build_canbepausedorresumed", false);
			pSignalHandler->SignalHandled();
			auto pLeaveStateForIdleSignal = pStateEnvironment->PrepareSignal("plc", "signal_leavestateforidle");
			pLeaveStateForIdleSignal->Trigger();
			if (pLeaveStateForIdleSignal->WaitForHandling(nLeavingStateTimeout))
			{
				if (pLeaveStateForIdleSignal->GetBoolResult("success"))
				{
					pStateEnvironment->SetNextState("pauseprocess");
					pStateEnvironment->LogMessage("Press the 'Pause Build' Button to resume the process at beginlayer or press the 'Cancel Build' Button to cancel the process!");
				}
				else
				{
					pStateEnvironment->LogMessage("Leaving the current state of the plc state machine for the state idle is not currently not possible");
					pStateEnvironment->SetNextState("waitforshutdown");
				}
			}
			else
			{
				pStateEnvironment->LogMessage("Timeout: Leaving the current state of the plc state machine for the state idle is not currently not possible");
				pStateEnvironment->SetNextState("waitforshutdown");
			}
			break;
		}
		pStateEnvironment->Sleep(nCounterStep);
	}

	if (pEnableControllerSignal->WaitForHandling(nAtmosphereWithoutPumpTimeout)) {
		if (pEnableControllerSignal->GetBoolResult("success"))
		{
			pStateEnvironment->SetNextState("beginlayer");
			pStateEnvironment->LogMessage("Reestablishing the atmosphere without pump was successful");
		}
		else
		{
			pStateEnvironment->LogMessage("Recreating process atmosphere was not successful");
			pStateEnvironment->SetNextState("waitforshutdown");
		}
	}
	else
	{
		pStateEnvironment->LogMessage("Recreating process atmosphere timeout");
		pStateEnvironment->SetNextState("waitforshutdown");
	}
}

__DECLARESTATE(vacuumerror)
{

}


__DECLARESTATE(gasflowerror)
{
	// Get Timeouts
	uint32_t nAtmosphereWithPumpTimeout = pStateEnvironment->GetIntegerParameter("timeouts", "atmospherewithpumptimeout");
	uint32_t nPauseTimeout = pStateEnvironment->GetIntegerParameter("timeouts", "waitforpauseprocesstimeout");
	uint32_t nLeavingStateTimeout = pStateEnvironment->GetIntegerParameter("timeouts", "leavingstatetimeout");

	// Check if the circulation pump was already started and not yet stopped
	bool bCirculationPumpStartedFlag = pStateEnvironment->GetBoolParameter("jobinfo", "circulation_pump_started_flag");

	// Get gasflow setpoint
	int nSetpointInPercent = pStateEnvironment->GetIntegerParameter("jobinfo", "circulation_pump_setpoint_in_percent");

	auto pStartGasFlowSignal = pStateEnvironment->PrepareSignal("plc", "signal_atmospherecontrol_start_gas_flow");
	pStartGasFlowSignal->SetInteger("setpoint_in_percent", nSetpointInPercent);
	pStartGasFlowSignal->SetBool("circulation_pump_started_flag", bCirculationPumpStartedFlag);
	pStartGasFlowSignal->SetBool("is_process_flag", true);
	pStartGasFlowSignal->Trigger();

	int nCounterStep = (int)(nPauseTimeout / 10000);
	int iMax = (int)(nPauseTimeout / nCounterStep);
	PSignalHandler pSignalHandler;
	for (int i = 0; i++; iMax)
	{
		if (pStateEnvironment->WaitForSignal("signal_cancelbuild", 0, pSignalHandler)) { // check if CancelBuild button or PauseBuild button was clicked
			pStateEnvironment->SetBoolParameter("ui", "build_canbecanceled", false);
			pStateEnvironment->SetBoolParameter("ui", "build_canbepausedorresumed", false);
			pStateEnvironment->SetNextState("cancelprocess");
			pSignalHandler->SignalHandled();
			break;
		}
		else if (pStateEnvironment->WaitForSignal("signal_pausebuild", 0, pSignalHandler)) { // check if CancelBuild button or PauseBuild button was clicked
			pStateEnvironment->SetBoolParameter("ui", "build_canbecanceled", false);
			pStateEnvironment->SetBoolParameter("ui", "build_canbepausedorresumed", false);
			pSignalHandler->SignalHandled();
			auto pLeaveStateForIdleSignal = pStateEnvironment->PrepareSignal("plc", "signal_leavestateforidle");
			pLeaveStateForIdleSignal->Trigger();
			if (pLeaveStateForIdleSignal->WaitForHandling(nLeavingStateTimeout))
			{
				if (pLeaveStateForIdleSignal->GetBoolResult("success"))
				{
					pStateEnvironment->SetNextState("pauseprocess");
					pStateEnvironment->LogMessage("Press the 'Pause Build' Button to resume the process at beginlayer or press the 'Cancel Build' Button to cancel the process!");
				}
				else
				{
					pStateEnvironment->LogMessage("Leaving the current state of the plc state machine for the state idle is not currently not possible");
					pStateEnvironment->SetNextState("waitforshutdown");
				}
			}
			else
			{
				pStateEnvironment->LogMessage("Timeout: Leaving the current state of the plc state machine for the state idle is not currently not possible");
				pStateEnvironment->SetNextState("waitforshutdown");
			}
			break;
		}
		pStateEnvironment->Sleep(nCounterStep);
	}

	if (pStartGasFlowSignal->WaitForHandling(nAtmosphereWithPumpTimeout)) {
		if (pStartGasFlowSignal->GetBoolResult("success"))
		{
			// Set the circulation pump started flag
			pStateEnvironment->SetBoolParameter("jobinfo", "circulation_pump_started_flag", true);

			pStateEnvironment->SetNextState("beginlayer");
			pStateEnvironment->LogMessage("Reestablishing the atmosphere with pump was successful");
		}
		else
		{
			pStateEnvironment->LogMessage("Recreating process atmosphere was not successful");
			pStateEnvironment->SetNextState("waitforshutdown");
		}
	}
	else
	{
		pStateEnvironment->LogMessage("Recreating process atmosphere timeout");
		pStateEnvironment->SetNextState("waitforshutdown");
	}
}

__DECLARESTATE(recoatingerror)
{
	// Get Timeouts
	uint32_t nLeavingStateTimeout = pStateEnvironment->GetIntegerParameter("timeouts", "leavingstatetimeout");

	pStateEnvironment->SetBoolParameter("ui", "build_canbecanceled", false);
	pStateEnvironment->SetBoolParameter("ui", "build_canbepausedorresumed", false);
	auto pLeaveStateForIdleSignal = pStateEnvironment->PrepareSignal("plc", "signal_leavestateforidle");
	pLeaveStateForIdleSignal->Trigger();

	if (pLeaveStateForIdleSignal->WaitForHandling(nLeavingStateTimeout))
	{
		if (pLeaveStateForIdleSignal->GetBoolResult("success"))
		{
			pStateEnvironment->SetNextState("pauseprocess");
			pStateEnvironment->LogMessage("Press the 'Pause Build' Button to resume the process at beginlayer or press the 'Cancel Build' Button to cancel the process!");
		}
		else
		{
			pStateEnvironment->LogMessage("Leaving the current state of the plc state machine for the state idle is not currently not possible");
			pStateEnvironment->SetNextState("waitforshutdown");
		}
	}
	else
	{
		pStateEnvironment->LogMessage("Timeout: Leaving the current state of the plc state machine for the state idle is not currently not possible");
		pStateEnvironment->SetNextState("waitforshutdown");
	}
}

__DECLARESTATE(manualmovementcontrol)
{

	LibMCEnv::PSignalHandler pSignalHandler;

	if (pStateEnvironment->WaitForSignal("signal_manualmovementcontrol_enter", 0, pSignalHandler)) {

		pSignalHandler->SignalHandled();

		pStateEnvironment->SetNextState("manualmovementcontrol");

	}
	else if (pStateEnvironment->WaitForSignal("signal_manualmovementcontrol_leave", 0, pSignalHandler)) {
		pStateEnvironment->SetNextState("idle");
		pSignalHandler->SignalHandled();
	}

	else if (pStateEnvironment->WaitForSignal("signal_manualmovementcontrol_leave_for_waitforshutdown", 0, pSignalHandler)) {
		pStateEnvironment->SetNextState("waitforshutdown");
		pSignalHandler->SignalHandled();
	}

	else if (pStateEnvironment->WaitForSignal("signal_manualmovementcontrol_leave_for_pauseprocess", 0, pSignalHandler)) {
		pStateEnvironment->SetNextState("pauseprocess");
		pSignalHandler->SignalHandled();
	}
	
	else if (pStateEnvironment->WaitForSignal("signal_referenceaxis", 0, pSignalHandler)) {
		pStateEnvironment->SetNextState("manualreferencing");

		pStateEnvironment->StoreSignal("manualreference_signal", pSignalHandler);
	}

	else if (pStateEnvironment->WaitForSignal("signal_singleaxismovement", 0, pSignalHandler)) {
		pStateEnvironment->SetNextState("manualmovement");

		pStateEnvironment->StoreSignal("manualmovement_signal", pSignalHandler);
	}

	else if (pStateEnvironment->WaitForSignal("signal_manualmovementcontrol_recoat_layer", 0, pSignalHandler)) {
		pStateEnvironment->SetNextState("manualrecoating");

		pStateEnvironment->StoreSignal("signal_manualmovementcontrol_recoat_layer", pSignalHandler);
	}

	else if (pStateEnvironment->WaitForSignal("signal_manual_powder_dosing", 0, pSignalHandler)) {
		pStateEnvironment->SetNextState("manualpowderdosing");

		pStateEnvironment->StoreSignal("signal_manual_powder_dosing", pSignalHandler);
	}
	else if (pStateEnvironment->WaitForSignal("signal_singleaxismovement_change_layer", 0, pSignalHandler)) {
		pStateEnvironment->SetNextState("manualchangelayer");

		pStateEnvironment->StoreSignal("signal_singleaxismovement_change_layer", pSignalHandler);
	}
	else {
		pStateEnvironment->SetNextState("manualmovementcontrol");
	}
	
}

__DECLARESTATE(manualreferencing)
{
	auto pManualReferenceSignalHandler = pStateEnvironment->RetrieveSignal("manualreference_signal");

	bool bDoReferenceRecoaterAxisLinear = pManualReferenceSignalHandler->GetBool("reference_recoateraxis_linear");
	bool bDoReferenceRecoaterAxisPowder = pManualReferenceSignalHandler->GetBool("reference_recoateraxis_powder");
	bool bDoReferencePlatform = pManualReferenceSignalHandler->GetBool("reference_platform");
	bool bDoReferencePowderReservoir = pManualReferenceSignalHandler->GetBool("reference_powderreservoir");

	std::vector<std::string> axesToMove; 
	if (bDoReferenceRecoaterAxisLinear)
		axesToMove.push_back("LinearRecoaterAxis");
	if (bDoReferenceRecoaterAxisPowder)
		axesToMove.push_back("PowderRecoaterAxis");
	if (bDoReferencePlatform)
		axesToMove.push_back("Platform");
	if (bDoReferencePowderReservoir)
		axesToMove.push_back("PowderReservoir");

	if (axesToMove.size() > 0) {
		std::string sAxesString;
		for (auto axisString : axesToMove) {
			if (!sAxesString.empty())
				sAxesString += ", ";
			sAxesString += axisString;
		}
 
		auto nReferenceTimeout = 30000;

		pStateEnvironment->LogMessage("Manually Referencing " + sAxesString + "...");

		auto pReferenceSignal = pStateEnvironment->PrepareSignal("plc", "signal_reference");
		pReferenceSignal->SetBool("reference_recoateraxis_linear", bDoReferenceRecoaterAxisLinear);
		pReferenceSignal->SetBool("reference_recoateraxis_powder", bDoReferenceRecoaterAxisPowder);
		pReferenceSignal->SetBool("reference_platform", bDoReferencePlatform);
		pReferenceSignal->SetBool("reference_powderreservoir", bDoReferencePowderReservoir);
		pReferenceSignal->Trigger();

		if (pReferenceSignal->WaitForHandling(nReferenceTimeout)) {

			if (pReferenceSignal->GetBoolResult("success")) {
				pManualReferenceSignalHandler->SetBoolResult("success", true);
				pManualReferenceSignalHandler->SetIntegerResult("errorcode", 0);
				
				pStateEnvironment->LogMessage("Referencing finished!");

			}
			else {
				pManualReferenceSignalHandler->SetBoolResult("success", false);
				pManualReferenceSignalHandler->SetIntegerResult("errorcode", 1);
				pStateEnvironment->LogMessage("Referencing error.");

			}
			
		}
		else {
			pManualReferenceSignalHandler->SetBoolResult("success", false);
			pManualReferenceSignalHandler->SetIntegerResult("errorcode", 2);
			pStateEnvironment->LogMessage("Referencing timeout!");
		}
		
		

	}
	else {
		pStateEnvironment->LogMessage("No axis to reference!");

	}

	pManualReferenceSignalHandler->SignalHandled();

	pStateEnvironment->SetNextState("manualmovementcontrol");
}

__DECLARESTATE(manualmovement)
{

	auto pSignalHandler = pStateEnvironment->RetrieveSignal("manualmovement_signal");

	try {
			auto nAxisID = pSignalHandler->GetInteger("axis_ID");
			auto nAbsoluteRelative = pSignalHandler->GetInteger("absoluterelative");
			auto dTarget = pSignalHandler->GetDouble("target");
			auto dSpeed = pSignalHandler->GetDouble("speed");
			auto dAcceleration = pSignalHandler->GetDouble("acceleration");

			if ((nAxisID < MIN_AXIS_ID) || (nAxisID > MAX_AXIS_ID))
				throw std::runtime_error("invalid axis ID: " + std::to_string(nAxisID));
			if ((nAbsoluteRelative < ABSOLUTE_FLAG) || (nAbsoluteRelative > RELATIVE_FLAG))
				throw std::runtime_error("invalid movement type flag: " + std::to_string(nAbsoluteRelative));
			if ((dTarget < MIN_TARGET) || (dTarget > MAX_TARGET))
				throw std::runtime_error("invalid movement target: " + std::to_string(dTarget));
			if ((dSpeed < MIN_SPEED) || (dSpeed > MAX_SPEED))
				throw std::runtime_error("invalid movement speed: " + std::to_string(dSpeed));
			if ((dAcceleration < MIN_ACCELERATION) || (dAcceleration > MAX_ACCELERATION))
				throw std::runtime_error("invalid movement acceleration: " + std::to_string(dAcceleration));

			auto nReferenceTimeout = 30000;

			pStateEnvironment->LogMessage("Single axis movement");

			auto pMovementSignal = pStateEnvironment->PrepareSignal("plc", "signal_singleaxismovement");
			pMovementSignal->SetInteger("axis_ID", nAxisID);
			pMovementSignal->SetInteger("absoluterelative", nAbsoluteRelative);
			pMovementSignal->SetDouble("target",dTarget);
			pMovementSignal->SetDouble("speed", dSpeed);
			pMovementSignal->SetDouble("acceleration", dAcceleration);
			pMovementSignal->Trigger();

			if (pMovementSignal->WaitForHandling(nReferenceTimeout)) {

				if (pMovementSignal->GetBoolResult("success")) {

					pSignalHandler->SetBoolResult("success", true);
					pSignalHandler->SetIntegerResult("errorcode", 0);

					pStateEnvironment->LogMessage("Movement finished!");

				}
				else {

					pSignalHandler->SetBoolResult("success", false);
					pSignalHandler->SetIntegerResult("errorcode", 1);

					pStateEnvironment->LogMessage("Movement error.");

					// leave the current waitformovement state to avoid a dead end in the plc state machine 
					auto pLeaveStateForIdleSignal = pStateEnvironment->PrepareSignal("plc", "signal_leavestateforidle");
					pLeaveStateForIdleSignal->Trigger();
				}

			}
			else {

				pSignalHandler->SetBoolResult("success", false);
				pSignalHandler->SetIntegerResult("errorcode", 2);

				pStateEnvironment->LogMessage("Movement timeout!");

				// leave the current waitformovement state to avoid a dead end in the plc state machine 
				auto pLeaveStateForIdleSignal = pStateEnvironment->PrepareSignal("plc", "signal_leavestateforidle");
				pLeaveStateForIdleSignal->Trigger();
			}
			pSignalHandler->SignalHandled();
			pStateEnvironment->SetNextState("manualmovementcontrol");
		}
	catch (std::exception & E) {
		// TODO: Error Codes!
		pStateEnvironment->LogMessage("Error: " + std::string (E.what ()));
		pSignalHandler->SetBoolResult("success", false);
		pSignalHandler->SetIntegerResult("errorcode", 0);
		pSignalHandler->SignalHandled();
		pStateEnvironment->SetNextState("manualmovementcontrol");
	}
}

__DECLARESTATE(manualrecoating)
{
	auto pSignalHandler = pStateEnvironment->RetrieveSignal("signal_manualmovementcontrol_recoat_layer");

	auto nRecoatLayerTimeOut = pStateEnvironment->GetDoubleParameter("timeouts", "recoatingtimeout");
	pStateEnvironment->LogMessage("Start manual recoating ...");

	// retrieve dosing factor of the manual recoating command
	double dRecoaterDosingFactor = pSignalHandler->GetDouble("dosing_factor_manual");

	//Retrieve parameters of signal from jobinfo and hardware info
	double dPlatformAxisClearanceInMM = pStateEnvironment->GetDoubleParameter("jobinfo", "platformaxis_clearance");
	double dPlatformAxisSpeedInMMPerSecond = pStateEnvironment->GetDoubleParameter("jobinfo", "platformaxis_speed");
	double dPlatformAxisAccelerationInMMPerSecondSqaured = pStateEnvironment->GetDoubleParameter("jobinfo", "platformaxis_acceleration");
	double dLayerHeightInMM = 0;
	double dRecoaterLinearAxisSpeedTravelInMMPerSecond = pStateEnvironment->GetDoubleParameter("jobinfo", "recoater_linear_speed_travel");
	double dRecoaterLinearAxesAccelerationTravelInMMPerSecondSqaured = pStateEnvironment->GetDoubleParameter("jobinfo", "recoater_axes_linear_acceleration_travel");
	double dRecoaterLinearAxisSpeedRecoatingInMMPerSecond = pStateEnvironment->GetDoubleParameter("jobinfo", "recoater_linear_speed_recoating");
	double dRecoaterLinearAxesAccelerationRecoatingInMMPerSecondSqaured = pStateEnvironment->GetDoubleParameter("jobinfo", "recoater_axes_linear_acceleration_recoating");
	bool bIsDualAxisRecoating = pStateEnvironment->GetBoolParameter("jobinfo", "is_dual_axis_recoating");
	
	double dRecoaterRefillPositionInMM = pStateEnvironment->GetDoubleParameter("hardwareinformation", "recoater_refill_position");
	double dRecoatingStartPositionInMM = pStateEnvironment->GetDoubleParameter("hardwareinformation", "recoating_start_position");
	double dRecoatingEndPositionInMM = pStateEnvironment->GetDoubleParameter("hardwareinformation", "recoating_end_position");

	pStateEnvironment->LogMessage("Trigger recoating signal ...");
	//Prepare the recoat layer signal
	auto pRecoatLayer = pStateEnvironment->PrepareSignal("plc", "signal_recoatlayer");
	pRecoatLayer->SetDouble("platformaxis_clearance", dPlatformAxisClearanceInMM);
	pRecoatLayer->SetDouble("platformaxis_speed", dPlatformAxisSpeedInMMPerSecond);
	pRecoatLayer->SetDouble("platformaxis_acceleration", dPlatformAxisAccelerationInMMPerSecondSqaured);
	pRecoatLayer->SetDouble("layer_height", dLayerHeightInMM);
	pRecoatLayer->SetDouble("recoater_linear_speed_travel", dRecoaterLinearAxisSpeedTravelInMMPerSecond);
	pRecoatLayer->SetDouble("recoater_axes_linear_acceleration_travel", dRecoaterLinearAxesAccelerationTravelInMMPerSecondSqaured);
	pRecoatLayer->SetDouble("recoater_linear_speed_recoating", dRecoaterLinearAxisSpeedRecoatingInMMPerSecond);
	pRecoatLayer->SetDouble("recoater_axes_linear_acceleration_recoating", dRecoaterLinearAxesAccelerationRecoatingInMMPerSecondSqaured);
	pRecoatLayer->SetDouble("recoater_axes_dosing_factor", dRecoaterDosingFactor);
	pRecoatLayer->SetDouble("recoater_refill_position", dRecoaterRefillPositionInMM);
	pRecoatLayer->SetDouble("recoating_start_position", dRecoatingStartPositionInMM);
	pRecoatLayer->SetDouble("recoating_end_position", dRecoatingEndPositionInMM);
	pRecoatLayer->SetBool("is_dual_axis_recoating", bIsDualAxisRecoating);
	//Send the recoat layer signal to the plc state machine
	pRecoatLayer->Trigger();
	pStateEnvironment->LogMessage("Wait for recoating ...");
	if (pRecoatLayer->WaitForHandling(nRecoatLayerTimeOut)) {
		pSignalHandler->SetBoolResult("success", true);
		pStateEnvironment->LogMessage("Recoating finished");
		pStateEnvironment->SetNextState("manualmovementcontrol");
	}
	else {
		// no response from PLC!
		pSignalHandler->SetBoolResult("success", false);
		pStateEnvironment->LogMessage("Recoating timeout");
		pStateEnvironment->SetNextState("manualmovementcontrol");
	}
	
	pSignalHandler->SignalHandled();

}
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
