DavidWenzler/reAM250/PLC/Logical/Main/Framework/Journal.cpp

/*++

Copyright (C) 2024 Institute for Machine Tools and Industrial Management
TUM School of Engineering and Design
Technical University of Munich

All rights reserved.

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
THIS SOFTWARE IS PROVIDED BY THE COPYRIGHT HOLDERS AND CONTRIBUTORS "AS IS" AND
ANY EXPRESS OR IMPLIED WARRANTIES, INCLUDING, BUT NOT LIMITED TO, THE IMPLIED
WARRANTIES OF MERCHANTABILITY AND FITNESS FOR A PARTICULAR PURPOSE ARE
DISCLAIMED. IN NO EVENT SHALL TECHNICAL UNIVERSITY OF MUNICH BE LIABLE FOR ANY
DIRECT, INDIRECT, INCIDENTAL, SPECIAL, EXEMPLARY, OR CONSEQUENTIAL DAMAGES
(INCLUDING, BUT NOT LIMITED TO, PROCUREMENT OF SUBSTITUTE GOODS OR SERVICES;
LOSS OF USE, DATA, OR PROFITS; OR BUSINESS INTERRUPTION) HOWEVER CAUSED AND
ON ANY THEORY OF LIABILITY, WHETHER IN CONTRACT, STRICT LIABILITY, OR TORT
(INCLUDING NEGLIGENCE OR OTHERWISE) ARISING IN ANY WAY OUT OF THE USE OF THIS
SOFTWARE, EVEN IF ADVISED OF THE POSSIBILITY OF SUCH DAMAGE.

*/

#include "Journal.hpp"
#include "Utils.hpp"
#include "TcpPacketHandler.hpp"
#include <sstream>

#define JOURNAL_MINGROUPID 1
#define JOURNAL_MAXGROUPID 32767



#define JOURNAL_TCPSTREAMENTRYSIGNATURE_UINT8 0x10000000
#define JOURNAL_TCPSTREAMENTRYSIGNATURE_INT8 0x20000000
#define JOURNAL_TCPSTREAMENTRYSIGNATURE_UINT16 0x30000000
#define JOURNAL_TCPSTREAMENTRYSIGNATURE_INT16 0x40000000
#define JOURNAL_TCPSTREAMENTRYSIGNATURE_UINT32 0x50000000
#define JOURNAL_TCPSTREAMENTRYSIGNATURE_INT32 0x60000000
#define JOURNAL_TCPSTREAMENTRYSIGNATURE_UINT64 0x70000000
#define JOURNAL_TCPSTREAMENTRYSIGNATURE_INT64 0x80000000
#define JOURNAL_TCPSTREAMENTRYSIGNATURE_DOUBLE 0x90000000
#define JOURNAL_TCPSTREAMENTRYSIGNATURE_BOOL_TRUE 0xA0000000
#define JOURNAL_TCPSTREAMENTRYSIGNATURE_BOOL_FALSE 0xB0000000

#define JOURNAL_TCPSTREAMENTRYSIGNATURE_GROUPLISTSIZE 0xC0000000
#define JOURNAL_TCPSTREAMENTRYSIGNATURE_ENTRYLISTSIZE 0xD0000000
#define JOURNAL_TCPSTREAMENTRYSIGNATURE_GROUPID 0xE0000000

namespace BuRCPP {

	
	class CTcpPacketHandler_CurrentJournalStatus : public CTcpPacketHandler_Direct {
		private:
		CJournal* m_pJournal;
			
		public: 
			
		CTcpPacketHandler_CurrentJournalStatus (CJournal * pJournal)
			: CTcpPacketHandler_Direct (), m_pJournal (pJournal)
		{
			if (pJournal == nullptr)
				throw CException (eErrorCode::INVALIDPARAM, "invalid journal parameter");		
		}
			
		virtual ~CTcpPacketHandler_CurrentJournalStatus ()
		{
		}
				
			
		virtual uint32_t getCommandID () override
		{
			return COMMAND_DEFAULT_CURRENTJOURNALSTATUS;
		}
					
		void handlePacket (TcpIncomingPayload * pPayload, CTcpPacketResponse * pResponse) override
		{
			m_pJournal->writeStatusToTCPResponse (pResponse);	
	
		}

	};
	

class CTcpPacketHandler_CurrentJournalSchema : public CTcpPacketHandler_Direct {
	private:
	CJournal* m_pJournal;
			
	public: 
				
		CTcpPacketHandler_CurrentJournalSchema (CJournal * pJournal)
			: CTcpPacketHandler_Direct (), m_pJournal (pJournal)
		{
			if (pJournal == nullptr)
				throw CException (eErrorCode::INVALIDPARAM, "invalid journal parameter");		
		}
				
		virtual ~CTcpPacketHandler_CurrentJournalSchema ()
		{
		}
					
				
		virtual uint32_t getCommandID () override
		{
			return COMMAND_DEFAULT_CURRENTJOURNALSCHEMA;
		}
						
		void handlePacket (TcpIncomingPayload * pPayload, CTcpPacketResponse * pResponse) override
		{
			m_pJournal->writeSchemaToTCPResponse (pResponse);			
		}

	};

class CTcpPacketHandler_RetrieveJournalHistory : public CTcpPacketHandler_Direct {
	private:
	CJournal* m_pJournal;
			
	public: 
				
		CTcpPacketHandler_RetrieveJournalHistory (CJournal * pJournal)
			: CTcpPacketHandler_Direct (), m_pJournal (pJournal)
		{
			if (pJournal == nullptr)
				throw CException (eErrorCode::INVALIDPARAM, "invalid journal parameter");		
		}
				
		virtual ~CTcpPacketHandler_RetrieveJournalHistory ()
		{
		}
					
				
		virtual uint32_t getCommandID () override
		{
			return COMMAND_DEFAULT_RETRIEVEJOURNALHISTORY;
		}
						
		void handlePacket (TcpIncomingPayload * pPayload, CTcpPacketResponse * pResponse) override
		{
			m_pJournal->retrieveJournalHistory (pResponse);			
		}

	};


class CTcpPacketHandler_RetrieveJournalVariable : public CTcpPacketHandler_Direct {
	private:
	CJournal* m_pJournal;
			
	public: 
				
	CTcpPacketHandler_RetrieveJournalVariable (CJournal * pJournal)
		: CTcpPacketHandler_Direct (), m_pJournal (pJournal)
	{
		if (pJournal == nullptr)
			throw CException (eErrorCode::INVALIDPARAM, "invalid journal parameter");		
	}
				
	virtual ~CTcpPacketHandler_RetrieveJournalVariable ()
	{
	}
	
				
	virtual uint32_t getCommandID () override
	{
	return COMMAND_DEFAULT_RETRIEVEJOURNALVARIABLE;
}
						
		void handlePacket (TcpIncomingPayload * pPayload, CTcpPacketResponse * pResponse) override
		{
			uint32_t nGroupID = readUint32FromPayload (pPayload, 0);
			uint32_t nEntryID = readUint32FromPayload (pPayload, 4);

			m_pJournal->writeVariableToTCPResponse (pResponse, nGroupID, nEntryID);			
		}

	};



CJournalData::CJournalData (std::shared_ptr<CSystemInfo> pSystemInfo)
  : m_nRingBufferHead (0), m_nRingBufferTail (0), m_nRingBufferSize (0), m_nJournalOverFlowCounter (0), m_pSystemInfo (pSystemInfo)
{
	if (pSystemInfo.get () == nullptr)
		throw CException (eErrorCode::INVALIDPARAM, "invalid system info parameter");


}

CJournalData::CJournalData (uint32_t nCurrentValueSize, uint32_t nRingBufferSize, std::shared_ptr<CSystemInfo> pSystemInfo)
  :  m_nRingBufferHead (0), 
	m_nRingBufferTail (0), 
	m_nRingBufferSize (nRingBufferSize), 
	m_nJournalOverFlowCounter (0), 
	m_pSystemInfo (pSystemInfo)

{
	if (nCurrentValueSize == 0)
		throw CException (eErrorCode::INVALIDPARAM, "invalid current buffer size");
	if (nRingBufferSize == 0)
		throw CException (eErrorCode::INVALIDPARAM, "invalid journal ring buffer size");
	if (pSystemInfo.get () == nullptr)
		throw CException (eErrorCode::INVALIDPARAM, "invalid system info parameter");

	m_CurrentValueBuffer.resize (nCurrentValueSize);
	for (auto & it : m_CurrentValueBuffer)
		it = 0;

	m_JournalRingBuffer.resize (m_nRingBufferSize);

	clearRingBuffer ();
}
			
CJournalData::~CJournalData ()
{
}

		
void CJournalData::readData (uint32_t nAddress, uint8_t * pTarget, uint32_t nSize) const
{
	if (nAddress >  JOURNAL_MAXSIZE)
		throw CException (eErrorCode::INVALIDJOURNALADDRESS, "invalid journal address");
	if (nSize > JOURNAL_MAXSIZE)
		throw CException (eErrorCode::INVALIDJOURNALENTRYSIZE, "invalid journal entry size");
	
	
	if (nAddress + nSize > m_CurrentValueBuffer.size ())
		throw CException (eErrorCode::JOURNALDATABUFFEROVERRUN, "journal data buffer overrun");
	if (pTarget == nullptr)
		throw CException (eErrorCode::INVALIDPARAM, "invalid memory target");
	
	for (uint32_t nIndex = 0; nIndex < nSize; nIndex++)
		pTarget[nIndex] = m_CurrentValueBuffer.at (nAddress + nIndex);
	
}

void CJournalData::writeData (uint32_t nAddress, uint32_t nGroupID, uint32_t nEntryID, uint8_t * pSource, uint32_t nSize)
{
	if (nAddress >  JOURNAL_MAXSIZE)
		throw CException (eErrorCode::INVALIDJOURNALADDRESS, "invalid journal address");
	if (nSize > JOURNAL_MAXENTRYSIZE)
		throw CException (eErrorCode::INVALIDJOURNALENTRYSIZE, "invalid journal entry size");
	
	size_t nBufferSize = m_CurrentValueBuffer.size ();
	if (nAddress + nSize > nBufferSize)
		throw CException (eErrorCode::JOURNALDATABUFFEROVERRUN, "journal data buffer overrun");
	if (pSource == nullptr)
		throw CException (eErrorCode::INVALIDPARAM, "invalid memory target");

	bool bHasChange = false;
	for (uint32_t nIndex = 0; nIndex < nSize; nIndex++) {
		uint8_t* pTargetByte = &m_CurrentValueBuffer.at (nAddress + nIndex);
		uint8_t nSource = pSource[nIndex];

		if (*pTargetByte != nSource) {
			*pTargetByte = nSource;
			bHasChange = true;
		}
	}

	if (bHasChange) {

		if (!ringBufferIsFull ()) {
			sJournalEntry * pJournalEntry = pushRingBufferEntry ();
			pJournalEntry->m_nTimeStampInMicroseconds = m_pSystemInfo->getSystemTimeInMicroseconds ();
			pJournalEntry->m_nGroupID = (uint16_t) nGroupID;
			pJournalEntry->m_nEntryID = (uint16_t) nEntryID;

			for (uint32_t nIndex = 0; nIndex < nSize; nIndex++) {
				pJournalEntry->m_nBuffer[nIndex] = pSource[nIndex];
			}

			for (uint32_t nIndex = nSize; nIndex < JOURNAL_MAXENTRYSIZE; nIndex++)
				pJournalEntry->m_nBuffer[nIndex] = 0;
		} else {
			m_nJournalOverFlowCounter++;
		}
	}
}

void CJournalData::clearRingBuffer ()
{
	m_nRingBufferHead = 0;
	m_nRingBufferTail = m_nRingBufferSize - 1;
	m_nJournalOverFlowCounter = 0;
}
		
bool CJournalData::ringBufferIsFull ()
{
	return (m_nRingBufferHead == m_nRingBufferTail);
}

bool CJournalData::ringBufferIsEmpty ()
{
	uint32_t nNextTail = (m_nRingBufferTail + 1) % m_nRingBufferSize;
	return (m_nRingBufferHead == nNextTail);
}

uint32_t CJournalData::getBufferEntryCount ()
{	
	if (m_nRingBufferHead == m_nRingBufferTail)
		return m_nRingBufferSize;
	
	uint32_t nNextTail = (m_nRingBufferTail + 1);
	if (m_nRingBufferHead > m_nRingBufferTail) {
		return m_nRingBufferHead - nNextTail;		
	} else {
		return (m_nRingBufferHead + m_nRingBufferSize) - nNextTail;		
	}
	
}

uint32_t CJournalData::getOverFlowCounter ()
{	
	return m_nJournalOverFlowCounter;
}



sJournalEntry * CJournalData::popRingBufferEntry ()
{
	if (ringBufferIsEmpty ())
		throw CException (eErrorCode::JOURNALRINGBUFFERISEMPTY, "journal ring buffer is empty."); 

	uint32_t nCurrentTail = m_nRingBufferTail;
	uint32_t nNextTail = (m_nRingBufferTail + 1) % m_nRingBufferSize;

	m_nRingBufferTail = nNextTail;

	return &m_JournalRingBuffer.at (nNextTail);
}

sJournalEntry * CJournalData::pushRingBufferEntry ()
{
	if (ringBufferIsFull ())
		throw CException (eErrorCode::JOURNALRINGBUFFERISFULL, "journal ring buffer is full."); 

	uint32_t nCurrentHead = m_nRingBufferHead;
	uint32_t nNextHead = (m_nRingBufferHead + 1) % m_nRingBufferSize;

	m_nRingBufferHead = nNextHead;

	return &m_JournalRingBuffer.at (nCurrentHead);

}

	CJournalEntryDefinition::CJournalEntryDefinition (uint32_t nGroupID, uint32_t nEntryID, const std::string & sName)
		: m_nGroupID (nGroupID), m_nEntryID (nEntryID), m_sName (sName), m_nAddress (0)
	{
		if (sName.empty ())
			throw CException (eErrorCode::EMPTYJOURNALENTRYNAME, "empty journal entry name");
		if (sName.size () > JOURNAL_MAXNAMELENGTH)
			throw CException (eErrorCode::INVALIDJOURNALENTRYNAME, "journal entry name too long");
		for (auto ch : sName) {
			if (! (((ch >= 'A') && (ch <= 'Z')) ||((ch >= 'a') && (ch <= 'z')) || ((ch >= '0') && (ch <= '9')) || (ch == '_')))
				throw CException (eErrorCode::INVALIDJOURNALENTRYNAME, "invalid characters in journal entry name");
		}
		
		if ((nEntryID < JOURNAL_MINENTRYID) || (nEntryID > JOURNAL_MAXENTRYID))
			throw CException (eErrorCode::INVALIDJOURNALENTRYID, "invalid entry ID.");		
	}
	
	CJournalEntryDefinition::~CJournalEntryDefinition ()
	{
	}
		
	uint32_t CJournalEntryDefinition::getEntryID ()
	{
		return m_nEntryID;
	}

	uint32_t CJournalEntryDefinition::getGroupID ()
	{
		return m_nGroupID;
	}
	
	std::string CJournalEntryDefinition::getName ()
	{
		return m_sName;
	}
	
	size_t CJournalEntryDefinition::getAddress ()
	{
		return m_nAddress;
	}
	
	void CJournalEntryDefinition::setAddress (size_t nAddress)
	{
		m_nAddress = nAddress;
	}
	
	CJournalEntryIntegerDefinition::CJournalEntryIntegerDefinition (uint32_t nGroupID, uint32_t nEntryID, const std::string & sName, int64_t nMinimum, int64_t nMaximum)
		: CJournalEntryDefinition (nGroupID, nEntryID, sName), m_nMinimum (nMinimum), m_nMaximum (nMaximum)
	{
		if (nMinimum > nMaximum)
			throw CException (eErrorCode::INVALIDPARAM, "invalid journal group entry range: " + sName);
		
		m_DataSize = 8;
	
		
	}
	
	CJournalEntryIntegerDefinition::~CJournalEntryIntegerDefinition ()
	{
	}
		
	int64_t CJournalEntryIntegerDefinition::getMinimum ()
	{
		return m_nMinimum;
	}
	
	int64_t CJournalEntryIntegerDefinition::getMaximum ()
	{
		return m_nMaximum;
	}
	
	size_t CJournalEntryIntegerDefinition::getDataSize ()
	{
		return m_DataSize;
	}

	void CJournalEntryIntegerDefinition::buildSchemaJSON (std::stringstream & jsonStream)
	{
		jsonStream << "{"; 
		jsonStream << " \"type\": \"integer\", ";		
		jsonStream << " \"name\": \"" << getName () << "\", ";
		jsonStream << " \"id\": " << getEntryID () << ", ";		
		jsonStream << " \"size\": " << getDataSize () << ", ";		
		jsonStream << " \"minimum\": " << getMinimum () << ", ";		
		jsonStream << " \"maximum\": " << getMaximum () << " ";		
		jsonStream << "}";
	}

	
	int64_t CJournalEntryIntegerDefinition::readValue (const CJournalData & JournalData)
	{
		int64_t nReturnValue = 0;
		JournalData.readData (getAddress (), (uint8_t*) &nReturnValue, m_DataSize);
	
		return nReturnValue;
	}
	
	void CJournalEntryIntegerDefinition::writeValue (CJournalData & JournalData, int64_t nValue)
	{
		JournalData.writeData (getAddress (), getGroupID (), getEntryID (), (uint8_t*) &nValue, m_DataSize);
	}

	void CJournalEntryIntegerDefinition::writeStatusToTCPResponse (CTcpPacketResponse * pResponse, const CJournalData & JournalData)
	{
		pResponse->addUint32 (getEntryID () | JOURNAL_TCPSTREAMENTRYSIGNATURE_INT32);
		pResponse->addInt32 (readValue (JournalData));
	}

			
	CJournalEntryDoubleDefinition::CJournalEntryDoubleDefinition (uint32_t nGroupID, uint32_t nEntryID, const std::string & sName, double dMinimum, double dMaximum, uint32_t nQuantizationSteps)
		: CJournalEntryDefinition (nGroupID, nEntryID, sName), m_dMinimum (dMinimum), m_dMaximum (dMaximum), m_nQuantizationSteps (nQuantizationSteps)
	{
	}
	
	CJournalEntryDoubleDefinition::~CJournalEntryDoubleDefinition ()
	{
	}
		
	double CJournalEntryDoubleDefinition::getMinimum ()
	{
		return m_dMinimum;
	}
	
	double CJournalEntryDoubleDefinition::getMaximum ()
	{
		return m_dMaximum;
	}
	
	size_t CJournalEntryDoubleDefinition::getDataSize ()
	{
		return 8;
	}

	void CJournalEntryDoubleDefinition::buildSchemaJSON (std::stringstream & jsonStream)
	{
		jsonStream << "{"; 
		jsonStream << " \"type\": \"double\", ";		
		jsonStream << " \"name\": \"" << getName () << "\", ";
		jsonStream << " \"id\": " << getEntryID () << ", ";		
		jsonStream << " \"size\": " << getDataSize () << ", ";		
		jsonStream << " \"minimum\": " << getMinimum () << ", ";		
		jsonStream << " \"maximum\": " << getMaximum () << ", ";		
		jsonStream << " \"quantization\": " << m_nQuantizationSteps << " ";		
		jsonStream << "}";
	}
	
	double CJournalEntryDoubleDefinition::readValue (const CJournalData & JournalData)
	{
		double dReturnValue = 0.0;
		JournalData.readData (getAddress (), (uint8_t*) &dReturnValue, 8);
	
		return dReturnValue;
	}
		
	void CJournalEntryDoubleDefinition::writeValue (CJournalData & JournalData, double dValue)
	{
		JournalData.writeData (getAddress (), getGroupID (), getEntryID(), (uint8_t*) &dValue, 8);	
	}
		

	void CJournalEntryDoubleDefinition::writeStatusToTCPResponse (CTcpPacketResponse * pResponse, const CJournalData & JournalData)
	{
		pResponse->addUint32 (getEntryID () | JOURNAL_TCPSTREAMENTRYSIGNATURE_DOUBLE);
		pResponse->addDouble (readValue (JournalData));
	}
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
