DavidWenzler/reAM250/(commit log)

2024-12-06 Initial commit of the bill of materials
2025-03-19 Updated the bill of materials (v2_0_0_0)
2025-03-21 Commit of version 1.1.0
    [CROSSREF.CSV, GlobalCrossReferences.csv, ICI00004.DIP, ICI00005.DIP, ICI00006.DIP, ICI00008.DIP, ICI00016.DIP, ICI00017.DIP]
